mattyv06/thesis/paper/appendixb.tex

\chapter{Example Schematic}\label{appendixb}
%\begin{sidewaysfigure}[ht!]
%  \centering
%  \includegraphics[width=\textheight]{figs/schematic.png}
%  \caption{Large schematic on landscape page}
%  \label{fig:sche}
%\end{sidewaysfigure}
