mattyv06/thesis/figs/phoenix/concept/bat_sa_inh_pins.pdf

BATTERY
GND | A1 | GND | PWR | B1 | BAT_UNSF
GND | A2 | GND | PWR | B2 | BAT_UNSF
BAT_INHIBIT | A3 | INHIBIT | TMON | B3 | BAT_TMON
GND | A4 | GND | UNREG | B4 | SYS_UNREG
BAT_SDA | A5 | SDA | SCL | B5 | BAT_SDA

INHIBITS
PWR_UNSF | A1 | PWR | PWR | B1 | PWR_SAFE
PWR_UNSF | A2 | PWR | PWR | B2 | PWR_SAFE
FSWA_C | A3 | MON | MON | B3 | FSWB_C
BATT_SAFE | A4 | PWR | PWR | B4 | BATT_UNSF
BATT_SAFE | A5 | PWR | PWR | B5 | BATT_UNSF

SOLAR ARRAYS[1..3]
GND | A1 | GND | PWRA | B1 | SA_INA
GND | A2 | GND | PWRA | B2 | SA_INA
GND | A3 | GND | CSSA | B3 | CSSA_IN
GND | A4 | GND | DEP | B4 | DEP_UNREG
GND | A5 | GND | CSSB | B5 | CSSB_IN
GND | A6 | GND | PWRB | B6 | SA_INB
GND | A7 | GND | PWRB | B7 | SA_INB
