mattyv06/thesis/paper/main.pdf

AN EVOLUTION OF CUBESAT SUBSYSTEM DESIGN METHODS FOR...

by

Matthew Philip Voll

A thesis submitted in partial fulfillment of the requirements for the degree

of

Master of Science

in

Electrical Engineering

MONTANA STATE UNIVERSITY
Bozeman, Montana

April, 2017

c COPYRIGHT

by

Matthew Philip Voll

2017

All Rights Reserved

ii

ACKNOWLEDGEMENTS

I would like acknowledge . . . . Acknowledgments must be double spaced

and is limited to one page.

iii

TABLE OF CONTENTS

Subsection With a Very Very Very Very

4. DESIGN METHOD EXAMPLE: ELECTRICAL POWER SUB-
5. DESIGN STUDY - ELECTRICAL GROUND SUPPORT EQUIP-

iv

TABLE OF CONTENTS - CONTINUED

APPENDIX A: Example Code | 17
APPENDIX B: Example Schematic | 19

v

LIST OF FIGURES

Figure | Page
3.1 | This block diagram represents the components of the FISCE load circuit and their functions | 5
3.2 | The assembled FISCE load circuit on the backside of the solar panel substrate | 6
4.1 | A simplified representation of the design method used in this chapter.....8
4.2 | Basic configuration of a direct energy transfer (DET) power subsystem, with primary current paths shown by arrows | 8
4.3 | Components of the Phoenix EPS and the connections that form the PDN of the spacecraft | 9
4.4 | New connector pinouts | 9
4.5 | New connector pinouts | 10
4.6 | New connector pinouts | 10
4.7 | New connector pinouts | 10

vi

ABSTRACT

The abstract must be single spaced and no more than 350 words, indent first line five spaces. The abstract must contain the following elements: (1) statement of the problem, (2) procedure or methods, (3) results, and (4) conclusions. Mathematical formulas, abbreviations, diagrams, and other illustrative materials should not be included. It should be written to be understood by a person who does not have expertise in the field.

1

INTRODUCTION

Welcome to the Montana State University electronic Thesis/Dissertation (ETD)

LATEX template. In this chapter various sections, subsections, and subsubsections are

created and filled with random text). In Ch. ?? methods to write equations and how

to include figures and tables are explored. Conclusions are drawn in Ch. 7.

Section

Lorem ipsum dolor sit amet, consectetuer adipiscing elit. Ut purus elit,

vestibulum ut, placerat ac, adipiscing vitae, felis. Curabitur dictum gravida mauris.

Nam arcu libero, nonummy eget, consectetuer id, vulputate a, magna. Donec vehicula

augue eu neque. Pellentesque habitant morbi tristique senectus et netus et malesuada

fames ac turpis egestas. Mauris ut leo. Cras viverra metus rhoncus sem. Nulla et

lectus vestibulum urna fringilla ultrices. Phasellus eu tellus sit amet tortor gravida

placerat. Integer sapien est, iaculis in, pretium quis, viverra ac, nunc. Praesent eget

sem vel leo ultrices bibendum. Aenean faucibus. Morbi dolor nulla, malesuada eu,

pulvinar at, mollis ac, nulla. Curabitur auctor semper nulla. Donec varius orci eget

risus. Duis nibh mi, congue eu, accumsan eleifend, sagittis quis, diam. Duis eget orci

sit amet orci dignissim rutrum.

Subsection

Nam dui ligula, fringilla a, euismod sodales, sollicitudin vel, wisi. Morbi auctor

lorem non justo. Nam lacus libero, pretium at, lobortis vitae, ultricies et, tellus.

Donec aliquet, tortor sed accumsan bibendum, erat ligula aliquet magna, vitae

ornare odio metus a mi. Morbi ac orci et nisl hendrerit mollis. Suspendisse ut

2

massa. Cras nec ante. Pellentesque a nulla. Cum sociis natoque penatibus et

magnis dis parturient montes, nascetur ridiculus mus. Aliquam tincidunt urna. Nulla

ullamcorper vestibulum turpis. Pellentesque cursus luctus mauris.

Subsubsection Nulla malesuada porttitor diam. Donec felis erat, congue non,

volutpat at, tincidunt tristique, libero. Vivamus viverra fermentum felis. Donec

nonummy pellentesque ante. Phasellus adipiscing semper elit. Proin fermentum

massa ac quam. Sed diam turpis, molestie vitae, placerat a, molestie nec, leo.

Maecenas lacinia. Nam ipsum ligula, eleifend at, accumsan nec, suscipit a, ipsum.

Morbi blandit ligula feugiat magna. Nunc eleifend consequat lorem. Sed lacinia nulla

vitae enim. Pellentesque tincidunt purus vel magna. Integer non enim. Praesent

euismod nunc eu purus. Donec bibendum quam in tellus. Nullam cursus pulvinar

lectus. Donec et mi. Nam vulputate metus eu enim. Vestibulum pellentesque felis eu

massa.

Subsection With a Very Very Very Very
Very Very Very Very Very Very Long Title

For long subsection titles use the command \longsubsection{#1}{#2}, where

#1 is the first line of the long title, and #2 is the second line of the long title. You

can also pass an optional argument to this command that puts a shorter title in the

table of contents as shown by the subsection below.

Another Subsection With a Very Very Very
Very Very Very Very Very Very Long Title

The are not similar commands for sections and subsubsections as these are not

specified in the MSU style guide.

3

BACKGROUND

CubeSats are a growing industry and are becoming increasingly more capable

and affordable space mission options. Off-the-shelf components can be used to develop

complex missions....

4

DESIGN STUDY - SOLAR CELL EXPERIMENT

This subsystem design was part of the FIREBIRD-II mission, and was an

electronic load used to measure the performance of a spacecraft’s solar cells on orbit.

By working with an industry partner, the SSEL was able to utilize cutting edge solar

cell technology in exchange for providing the customer with low-cost flight heritage

and useful environmental data. This chapter will focus on the design method used

to fulfill the requirements as defined by the collaboration between the SSEL team

and the customer. After discussing the subsystem requirements, the concept design

can take shape, followed by the analyses and calculations performed to verify circuit

functionality.

At this time, the SSEL relied on the Mentor Graphics PADS Suite for electrical

computer aided design (ECAD), and integrated SPICE simulation was not a feature

that was readily available. Therefore, simulations of the critical circuits and

subcircuits was performed using LTSpice developed by Linear Technology. Then,

a full schematic was captured in PADS for creating the PCB layout files and bill-of-

materials needed for fabrication and assembly of the subsystem.

Requirements and Conceptual Design

Circuit Simulations and Calculations

PCB Layout and Mechanical Design

Calibration and Results

5

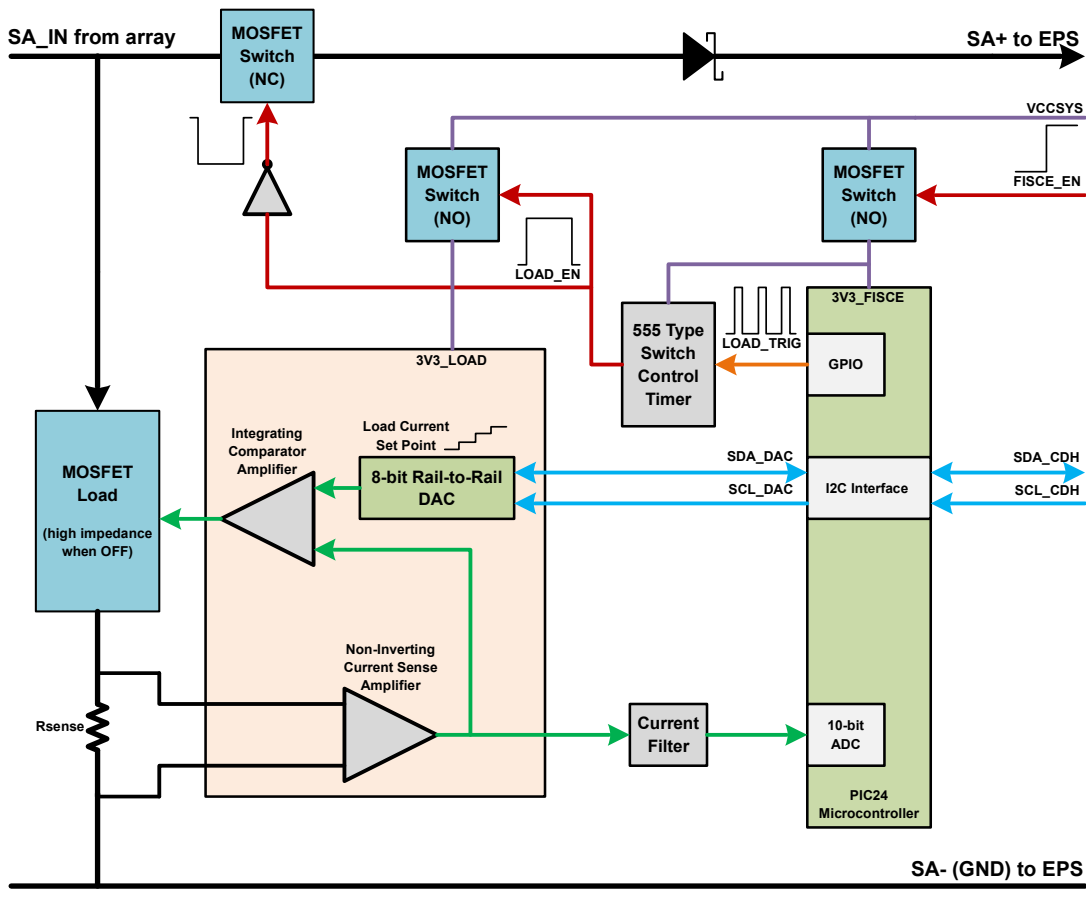
[picture p2: figure]
MOSFET Load; (high impedance when OFF); SA- (GND) to EPS; SA+ to EPS; FISCE_EN; VCCSYS; 10-bit ADC; I2C Interface; GPIO; Rsense; Current; Filter; 555 Type Switch Control Timer; MOSFET Switch (NO); SA_IN from array; MOSFET Switch (NC); 8-bit Rail-to-Rail DAC; LOAD_EN; LOAD_TRIG; 3V3_FISCE; 3V3_LOAD; Non-Inverting Current Sense Amplifier; Integrating Comparator Amplifier; SCL_CDH; SDA_CDH; SCL_DAC; SDA_DAC; PIC24 Microcontroller; Load Current Set Point

Figure 3.1: This block diagram represents the components of the FISCE load circuit and their functions.

6


Figure 3.2: The assembled FISCE load circuit on the backside of the solar panel substrate.

7

DESIGN METHOD EXAMPLE: ELECTRICAL POWER SUBSYSTEM

This subsystem was designed to facilitate expanded capabilities of the IT-SPINS

mission. Building on successes of the electrical power subsystem (EPS) used for the

FIREBIRD-II mission, the design of an updated version of the Phoenix EPS began

in the Spring of 2016. The original design came out of necessity, and began a trend of

using SSEL developed subsystems for CubeSat missions rather than purchasing and

integrating off-the-shelf solutions.

This chapter provides an investigation of how IT-SPINS mission requirements

made a significant overhaul of the Phoenix EPS mandatory. Then, a conceptual

design that incorporates those requirements is presented. With a block diagram

in place, several circuit simulations and calculations were performed to verify that

components of the design would operate as intended once built. The method used

in this example effectively used a hierarchical schematic structure to reuse several

“blocks” and make the schematic less cluttered. However, simulations were not well

integrated into the design flow and were difficult to track as the design matured; if a

simulation was modified or updated the corresponding schematic changes had to be

done manually. Similarly, support documents such as connector pin reference tables

were in a constant state of flux as the design progressed.

Figure 4.1 is an overview of the processes involved in designing the Phoenix EPS.

Ideally, these steps would be linked in only a linear progression, i.e. each step would

need to be completed and approved before moving onto the next. The arrows show

that during the simulation and schematic entry phases there was a need to revise the

subsystems requirements and conceptual design material. Also, there was essentially

only one formal approval step, made when the PCB was fully laid out and ready for

fabrication.

8

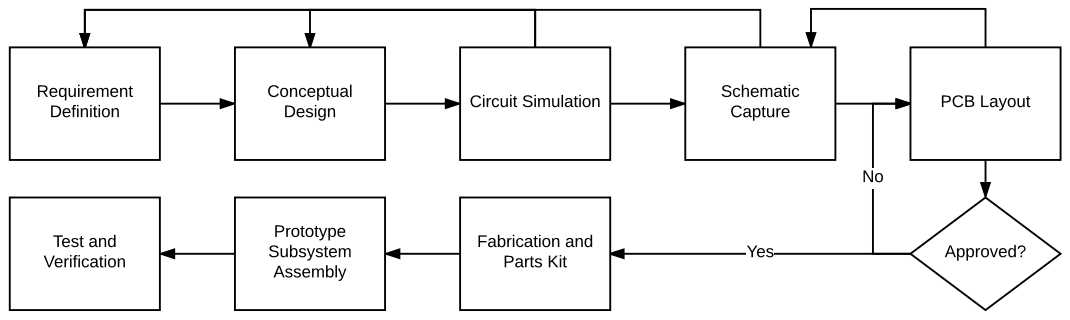
[picture p3: figure]
Requirement Definition; Schematic Capture Circuit Simulation Conceptual; Design; PCB Layout; Prototype Subsystem; Assembly; Test and; Verification; Yes; Approved?; Fabrication and Parts Kit

Figure 4.1: A simplified representation of the design method used in this chapter.

Requirements and Conceptual Design

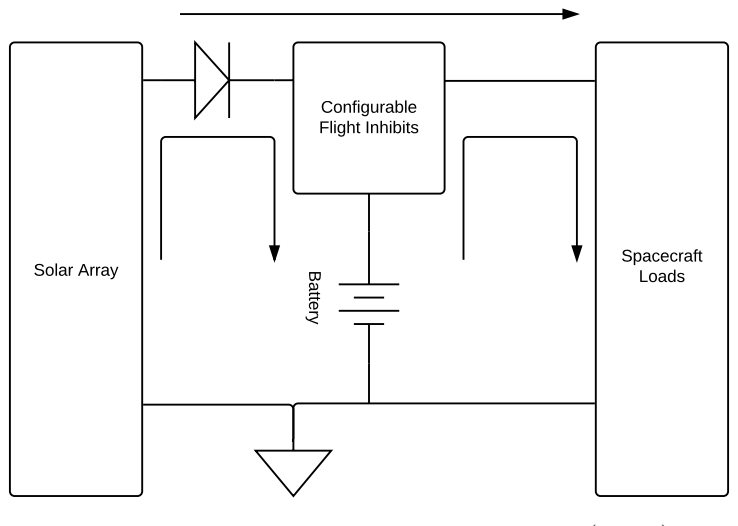
[picture p4: figure]
Solar Array; Battery Configurable Flight Inhibits; Spacecraft Loads

Figure 4.2: Basic configuration of a direct energy transfer (DET) power subsystem, with primary current paths shown by arrows.

Each resistor shown indicates a critical current sense location that is used to

monitor the subsystem’s status and performance. The inhibit switches shown indicate

the locations at which the power path is broken for “safing” the satellite during test

and launch; the physcial switches are not located on the

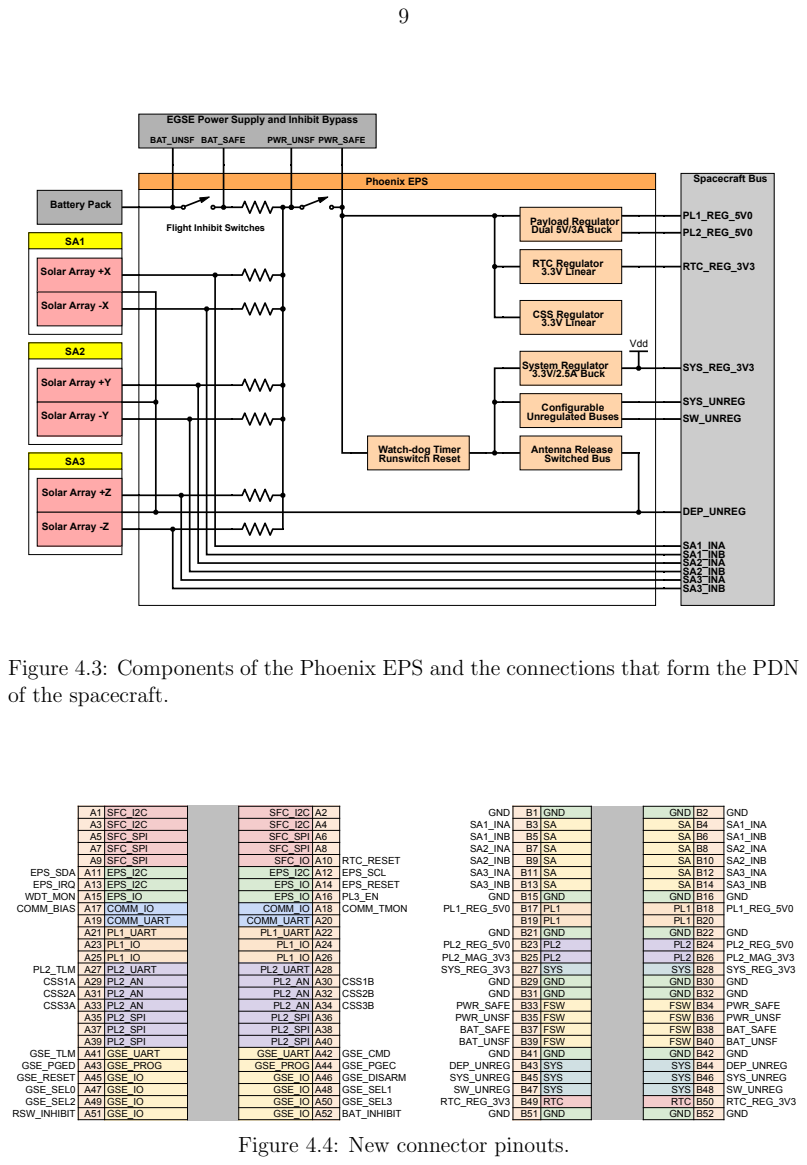
[picture p5: page 16]
Battery Pack; Dual 5V/3A Buck; Payload Regulator; RTC Regulator 3.3V Linear; CSS Regulator 3.3V Linear; 3.3V/2.5A Buck; System Regulator; Phoenix EPS; Unregulated Buses; Configurable; Antenna Release Switched Bus; Vdd; SYS_REG_3V3; SYS_UNREG; SW_UNREG; PL2_REG_5V0; PL1_REG_5V0; Spacecraft Bus; RTC_REG_3V3; SA1_INA SA1_INB SA2_INA SA2_INB SA3_INA SA3_INB; DEP_UNREG; BAT_UNSF BAT_SAFE; PWR_UNSF PWR_SAFE; Solar Array +X; Solar Array -X; Solar Array +Y; Solar Array -Y; Solar Array +Z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

EGSE Power Supply and Inhibit Bypass

Flight Inhibit Switches

Watchdog Timer
Runswitch Reset

Figure 4.3: Components of the Phoenix EPS and the connections that form the PDN
of the spacecraft.

Figure 4.4: New connector pinouts.

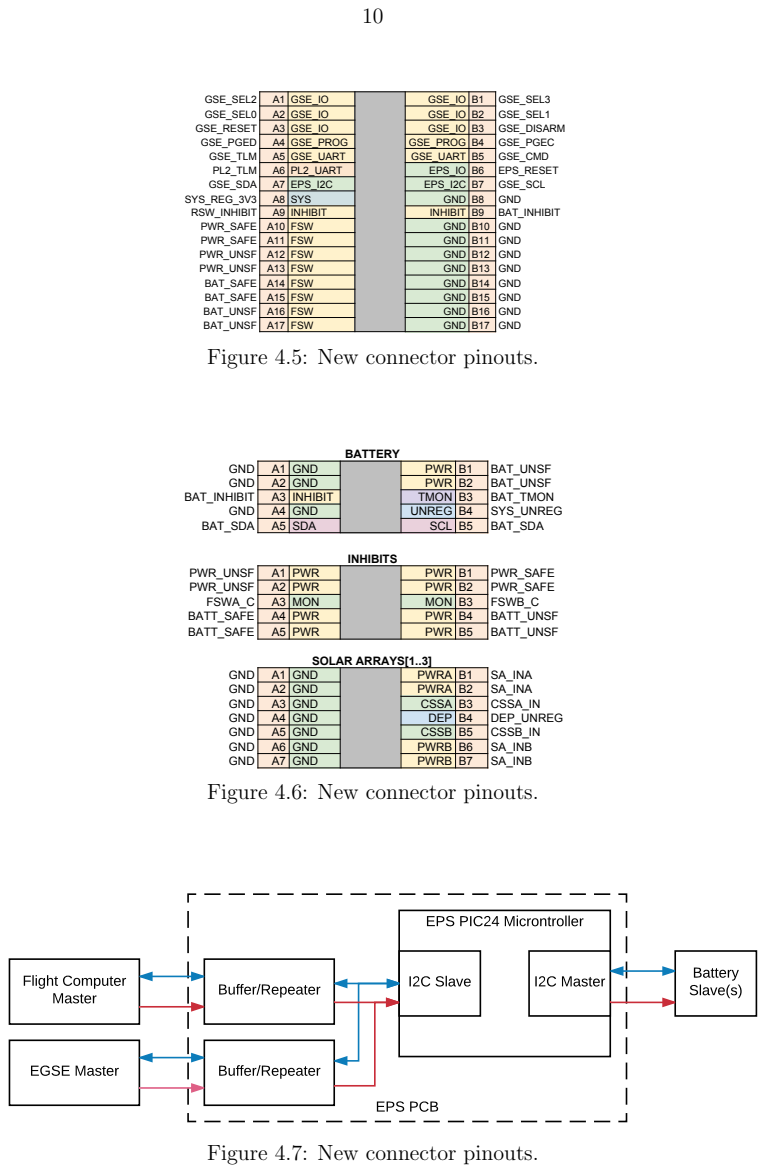
[picture p6: page 17]
GSE_SEL2; GSE_IO; GSE_SEL3; GSE_SEL0; GSE_SEL1; GSE_RESET; GSE_DISARM; GSE_PGED; GSE_PROG; GSE_PGEC; GSE_TLM; GSE_UART; GSE_CMD; PL2_TLM; PL2_UART; EPS_IO; EPS_RESET; GSE_SDA; EPS_I2C; GSE_SCL; SYS_REG_3V3; SYS; GND; RSW_INHIBIT; INHIBIT; BAT_INHIBIT; PWR_SAFE; FSW; PWR_UNSF; BAT_SAFE; BAT_UNSF; BATTERY; PWR; TMON; BAT_TMON; UNREG; SYS_UNREG; BAT_SDA; SDA; SCL; INHIBITS; FSWA_C; MON; FSWB_C; BATT_SAFE; BATT_UNSF; SOLAR ARRAYS[1..3]; PWRA; SA_INA; CSSA; CSSA_IN; DEP; DEP_UNREG; CSSB; CSSB_IN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

Figure 4.5: New connector pinouts.

Figure 4.6: New connector pinouts.

Flight Computer Master

Figure 4.7: New connector pinouts.

11

Circuit Simulations and Calculations

PCB Layout and Mechanical Design

Lessons Learned and Future Work

In this case, there were several times when the requirements, conceptual design,

schematic, and PCB layout were all being updated and altered in parallel. As the

IT-SPINS mission and the operation of its subsystems became more fully defined,

the critically important EPS design had to be altered to maintain compatibility. In

hindsight, these changes made the design method seem somewhat chaotic when

12

DESIGN STUDY - ELECTRICAL GROUND SUPPORT EQUIPMENT

This is the VOID EGSE design example.

Requirements and Conceptual Design

Circuit Simulations and Calculations

PCB Layout and Mechanical Design

Lessons Learned and Future Work

13

FUTURE METHODS

Investigating the possible methods for future use.

14

CONCLUSION

LATEX produces documents that look great, automatically handles references and

citations, and easily incorporates figures and tables. This is not a guide to LATEX but

rather an introduction to the MSU style. If you want more information about LATEX

many introductory guides can be found online.

15

REFERENCES CITED

16

APPENDICES

17

APPENDIX A

EXAMPLE CODE

18

% MATLAB code t o say ‘ h e l l o world ’

disp ( ‘ H ell o world ’ )

19

APPENDIX B

EXAMPLE SCHEMATIC
