mattyv06/thesis/template/main.pdf

THIS IS THE TITLE OF YOUR THESIS OR DISSERTATION

WHICH MAY SPAN MULTIPLE LINES

by

Chris Jordan Doe

A dissertation submitted in partial fulfillment of the requirements for the degree

of

Doctor of Philosophy

in

Engineering

MONTANA STATE UNIVERSITY
Bozeman, Montana

August, 2015

c COPYRIGHT

by

Chris Jordan Doe

2015

All Rights Reserved

ii

DEDICATION

I dedicate this to all MSU students who use LATEX. Dedication is optional and may be no longer than one page, single spaced, and should precede the acknowledgments page.

iii

ACKNOWLEDGEMENTS

I would like acknowledge . . . . Acknowledgments must be double spaced

and is limited to one page. Suspendisse vitae elit. Aliquam arcu neque, ornare

in, ullamcorper quis, commodo eu, libero. Fusce sagittis erat at erat tristique

mollis. Maecenas sapien libero, molestie et, lobortis in, sodales eget, dui. Morbi

ultrices rutrum lorem. Nam elementum ullamcorper leo. Morbi dui. Aliquam

sagittis. Nunc placerat. Pellentesque tristique sodales est. Maecenas imperdiet

lacinia velit. Cras non urna. Morbi eros pede, suscipit ac, varius vel, egestas

non, eros. Praesent malesuada, diam id pretium elementum, eros sem dictum

tortor, vel consectetuer odio sem sed wisi.

Funding Acknowledgment

This work was kindly supported by . . . . Nam dui ligula, fringilla a,

euismod sodales, sollicitudin vel, wisi. Morbi auctor lorem non justo. Nam

lacus libero, pretium at, lobortis vitae, ultricies et, tellus. Donec aliquet, tortor

sed accumsan bibendum, erat ligula aliquet magna, vitae ornare odio metus a

mi. Morbi ac orci et nisl hendrerit mollis. Suspendisse ut massa. Cras nec ante.

Pellentesque a nulla. Cum sociis natoque penatibus et magnis dis parturient

montes, nascetur ridiculus mus. Aliquam tincidunt urna. Nulla ullamcorper

vestibulum turpis. Pellentesque cursus luctus mauris.

iv

TABLE OF CONTENTS

Subsection With a Very Very Very Very

v

TABLE OF CONTENTS - CONTINUED

APPENDICES | 18
APPENDIX A: Example Code | 19
APPENDIX B: Example Schematic | 21

vi

LIST OF TABLES

Table | Page
3.1 | Area of ice sheet | 13

vii

LIST OF FIGURES

Figure | Page
3.1 | This is a figure of some data | 11
3.2 | Montana Hall on Montana State University’s campus | 12
3.3 | Figure created using the tikz package | 12
B.1 | Large schematic on landscape page | 22

viii

ABSTRACT

The abstract must be single spaced and no more than 350 words, indent first line five spaces. The abstract must contain the following elements: (1) statement of the problem, (2) procedure or methods, (3) results, and (4) conclusions. Mathematical formulas, abbreviations, diagrams, and other illustrative materials should not be included. It should be written to be understood by a person who does not have expertise in the field.

1

INTRODUCTION

Welcome to the Montana State University electronic Thesis/Dissertation (ETD)

LATEX template. In this chapter various sections, subsections, and subsubsections are

created and filled with random text). In Ch. 3 methods to write equations and how

to include figures and tables are explored. Conclusions are drawn in Ch. 4.

Section

Lorem ipsum dolor sit amet, consectetuer adipiscing elit. Ut purus elit,

vestibulum ut, placerat ac, adipiscing vitae, felis. Curabitur dictum gravida mauris.

Nam arcu libero, nonummy eget, consectetuer id, vulputate a, magna. Donec vehicula

augue eu neque. Pellentesque habitant morbi tristique senectus et netus et malesuada

fames ac turpis egestas. Mauris ut leo. Cras viverra metus rhoncus sem. Nulla et

lectus vestibulum urna fringilla ultrices. Phasellus eu tellus sit amet tortor gravida

placerat. Integer sapien est, iaculis in, pretium quis, viverra ac, nunc. Praesent eget

sem vel leo ultrices bibendum. Aenean faucibus. Morbi dolor nulla, malesuada eu,

pulvinar at, mollis ac, nulla. Curabitur auctor semper nulla. Donec varius orci eget

risus. Duis nibh mi, congue eu, accumsan eleifend, sagittis quis, diam. Duis eget orci

sit amet orci dignissim rutrum.

Subsection

Nam dui ligula, fringilla a, euismod sodales, sollicitudin vel, wisi. Morbi auctor

lorem non justo. Nam lacus libero, pretium at, lobortis vitae, ultricies et, tellus.

Donec aliquet, tortor sed accumsan bibendum, erat ligula aliquet magna, vitae

ornare odio metus a mi. Morbi ac orci et nisl hendrerit mollis. Suspendisse ut

2

massa. Cras nec ante. Pellentesque a nulla. Cum sociis natoque penatibus et

magnis dis parturient montes, nascetur ridiculus mus. Aliquam tincidunt urna. Nulla

ullamcorper vestibulum turpis. Pellentesque cursus luctus mauris.

Subsubsection Nulla malesuada porttitor diam. Donec felis erat, congue non,

volutpat at, tincidunt tristique, libero. Vivamus viverra fermentum felis. Donec

nonummy pellentesque ante. Phasellus adipiscing semper elit. Proin fermentum

massa ac quam. Sed diam turpis, molestie vitae, placerat a, molestie nec, leo.

Maecenas lacinia. Nam ipsum ligula, eleifend at, accumsan nec, suscipit a, ipsum.

Morbi blandit ligula feugiat magna. Nunc eleifend consequat lorem. Sed lacinia nulla

vitae enim. Pellentesque tincidunt purus vel magna. Integer non enim. Praesent

euismod nunc eu purus. Donec bibendum quam in tellus. Nullam cursus pulvinar

lectus. Donec et mi. Nam vulputate metus eu enim. Vestibulum pellentesque felis eu

massa.

Subsection With a Very Very Very Very
Very Very Very Very Very Very Long Title

For long subsection titles use the command \longsubsection{#1}{#2}, where

#1 is the first line of the long title, and #2 is the second line of the long title. You

can also pass an optional argument to this command that puts a shorter title in the

table of contents as shown by the subsection below.

Another Subsection With a Very Very Very
Very Very Very Very Very Very Long Title

The are not similar commands for sections and subsubsections as these are not

specified in the MSU style guide.

3

INTRODUCTION

Section

Lorem ipsum dolor sit amet, consectetuer adipiscing elit. Ut purus elit,

vestibulum ut, placerat ac, adipiscing vitae, felis. Curabitur dictum gravida mauris.

Nam arcu libero, nonummy eget, consectetuer id, vulputate a, magna. Donec vehicula

augue eu neque. Pellentesque habitant morbi tristique senectus et netus et malesuada

fames ac turpis egestas. Mauris ut leo. Cras viverra metus rhoncus sem. Nulla et

lectus vestibulum urna fringilla ultrices. Phasellus eu tellus sit amet tortor gravida

placerat. Integer sapien est, iaculis in, pretium quis, viverra ac, nunc. Praesent eget

sem vel leo ultrices bibendum. Aenean faucibus. Morbi dolor nulla, malesuada eu,

pulvinar at, mollis ac, nulla. Curabitur auctor semper nulla. Donec varius orci eget

risus. Duis nibh mi, congue eu, accumsan eleifend, sagittis quis, diam. Duis eget orci

sit amet orci dignissim rutrum.

Subsection

Nam dui ligula, fringilla a, euismod sodales, sollicitudin vel, wisi. Morbi auctor

lorem non justo. Nam lacus libero, pretium at, lobortis vitae, ultricies et, tellus.

Donec aliquet, tortor sed accumsan bibendum, erat ligula aliquet magna, vitae

ornare odio metus a mi. Morbi ac orci et nisl hendrerit mollis. Suspendisse ut

massa. Cras nec ante. Pellentesque a nulla. Cum sociis natoque penatibus et

magnis dis parturient montes, nascetur ridiculus mus. Aliquam tincidunt urna. Nulla

ullamcorper vestibulum turpis. Pellentesque cursus luctus mauris.

Subsubsection Nulla malesuada porttitor diam. Donec felis erat, congue non,

volutpat at, tincidunt tristique, libero. Vivamus viverra fermentum felis. Donec

4

nonummy pellentesque ante. Phasellus adipiscing semper elit. Proin fermentum

massa ac quam. Sed diam turpis, molestie vitae, placerat a, molestie nec, leo.

Maecenas lacinia. Nam ipsum ligula, eleifend at, accumsan nec, suscipit a, ipsum.

Morbi blandit ligula feugiat magna. Nunc eleifend consequat lorem. Sed lacinia nulla

vitae enim. Pellentesque tincidunt purus vel magna. Integer non enim. Praesent

euismod nunc eu purus. Donec bibendum quam in tellus. Nullam cursus pulvinar

lectus. Donec et mi. Nam vulputate metus eu enim. Vestibulum pellentesque felis eu

massa.

Section

Lorem ipsum dolor sit amet, consectetuer adipiscing elit. Ut purus elit,

vestibulum ut, placerat ac, adipiscing vitae, felis. Curabitur dictum gravida mauris.

Nam arcu libero, nonummy eget, consectetuer id, vulputate a, magna. Donec vehicula

augue eu neque. Pellentesque habitant morbi tristique senectus et netus et malesuada

fames ac turpis egestas. Mauris ut leo. Cras viverra metus rhoncus sem. Nulla et

lectus vestibulum urna fringilla ultrices. Phasellus eu tellus sit amet tortor gravida

placerat. Integer sapien est, iaculis in, pretium quis, viverra ac, nunc. Praesent eget

sem vel leo ultrices bibendum. Aenean faucibus. Morbi dolor nulla, malesuada eu,

pulvinar at, mollis ac, nulla. Curabitur auctor semper nulla. Donec varius orci eget

risus. Duis nibh mi, congue eu, accumsan eleifend, sagittis quis, diam. Duis eget orci

sit amet orci dignissim rutrum.

Subsection

Nam dui ligula, fringilla a, euismod sodales, sollicitudin vel, wisi. Morbi auctor

lorem non justo. Nam lacus libero, pretium at, lobortis vitae, ultricies et, tellus.

Donec aliquet, tortor sed accumsan bibendum, erat ligula aliquet magna, vitae

5

ornare odio metus a mi. Morbi ac orci et nisl hendrerit mollis. Suspendisse ut

massa. Cras nec ante. Pellentesque a nulla. Cum sociis natoque penatibus et

magnis dis parturient montes, nascetur ridiculus mus. Aliquam tincidunt urna. Nulla

ullamcorper vestibulum turpis. Pellentesque cursus luctus mauris.

Subsubsection Nulla malesuada porttitor diam. Donec felis erat, congue non,

volutpat at, tincidunt tristique, libero. Vivamus viverra fermentum felis. Donec

nonummy pellentesque ante. Phasellus adipiscing semper elit. Proin fermentum

massa ac quam. Sed diam turpis, molestie vitae, placerat a, molestie nec, leo.

Maecenas lacinia. Nam ipsum ligula, eleifend at, accumsan nec, suscipit a, ipsum.

Morbi blandit ligula feugiat magna. Nunc eleifend consequat lorem. Sed lacinia nulla

vitae enim. Pellentesque tincidunt purus vel magna. Integer non enim. Praesent

euismod nunc eu purus. Donec bibendum quam in tellus. Nullam cursus pulvinar

lectus. Donec et mi. Nam vulputate metus eu enim. Vestibulum pellentesque felis eu

massa.

Section

Lorem ipsum dolor sit amet, consectetuer adipiscing elit. Ut purus elit,

vestibulum ut, placerat ac, adipiscing vitae, felis. Curabitur dictum gravida mauris.

Nam arcu libero, nonummy eget, consectetuer id, vulputate a, magna. Donec vehicula

augue eu neque. Pellentesque habitant morbi tristique senectus et netus et malesuada

fames ac turpis egestas. Mauris ut leo. Cras viverra metus rhoncus sem. Nulla et

lectus vestibulum urna fringilla ultrices. Phasellus eu tellus sit amet tortor gravida

placerat. Integer sapien est, iaculis in, pretium quis, viverra ac, nunc. Praesent eget

sem vel leo ultrices bibendum. Aenean faucibus. Morbi dolor nulla, malesuada eu,

pulvinar at, mollis ac, nulla. Curabitur auctor semper nulla. Donec varius orci eget

6

risus. Duis nibh mi, congue eu, accumsan eleifend, sagittis quis, diam. Duis eget orci

sit amet orci dignissim rutrum.

Subsection

Nam dui ligula, fringilla a, euismod sodales, sollicitudin vel, wisi. Morbi auctor

lorem non justo. Nam lacus libero, pretium at, lobortis vitae, ultricies et, tellus.

Donec aliquet, tortor sed accumsan bibendum, erat ligula aliquet magna, vitae

ornare odio metus a mi. Morbi ac orci et nisl hendrerit mollis. Suspendisse ut

massa. Cras nec ante. Pellentesque a nulla. Cum sociis natoque penatibus et

magnis dis parturient montes, nascetur ridiculus mus. Aliquam tincidunt urna. Nulla

ullamcorper vestibulum turpis. Pellentesque cursus luctus mauris.

Subsubsection Nulla malesuada porttitor diam. Donec felis erat, congue non,

volutpat at, tincidunt tristique, libero. Vivamus viverra fermentum felis. Donec

nonummy pellentesque ante. Phasellus adipiscing semper elit. Proin fermentum

massa ac quam. Sed diam turpis, molestie vitae, placerat a, molestie nec, leo.

Maecenas lacinia. Nam ipsum ligula, eleifend at, accumsan nec, suscipit a, ipsum.

Morbi blandit ligula feugiat magna. Nunc eleifend consequat lorem. Sed lacinia nulla

vitae enim. Pellentesque tincidunt purus vel magna. Integer non enim. Praesent

euismod nunc eu purus. Donec bibendum quam in tellus. Nullam cursus pulvinar

lectus. Donec et mi. Nam vulputate metus eu enim. Vestibulum pellentesque felis eu

massa.

Section

Lorem ipsum dolor sit amet, consectetuer adipiscing elit. Ut purus elit,

vestibulum ut, placerat ac, adipiscing vitae, felis. Curabitur dictum gravida mauris.

7

Nam arcu libero, nonummy eget, consectetuer id, vulputate a, magna. Donec vehicula

augue eu neque. Pellentesque habitant morbi tristique senectus et netus et malesuada

fames ac turpis egestas. Mauris ut leo. Cras viverra metus rhoncus sem. Nulla et

lectus vestibulum urna fringilla ultrices. Phasellus eu tellus sit amet tortor gravida

placerat. Integer sapien est, iaculis in, pretium quis, viverra ac, nunc. Praesent eget

sem vel leo ultrices bibendum. Aenean faucibus. Morbi dolor nulla, malesuada eu,

pulvinar at, mollis ac, nulla. Curabitur auctor semper nulla. Donec varius orci eget

risus. Duis nibh mi, congue eu, accumsan eleifend, sagittis quis, diam. Duis eget orci

sit amet orci dignissim rutrum.

Subsection

Nam dui ligula, fringilla a, euismod sodales, sollicitudin vel, wisi. Morbi auctor

lorem non justo. Nam lacus libero, pretium at, lobortis vitae, ultricies et, tellus.

Donec aliquet, tortor sed accumsan bibendum, erat ligula aliquet magna, vitae

ornare odio metus a mi. Morbi ac orci et nisl hendrerit mollis. Suspendisse ut

massa. Cras nec ante. Pellentesque a nulla. Cum sociis natoque penatibus et

magnis dis parturient montes, nascetur ridiculus mus. Aliquam tincidunt urna. Nulla

ullamcorper vestibulum turpis. Pellentesque cursus luctus mauris.

Subsubsection Nulla malesuada porttitor diam. Donec felis erat, congue non,

volutpat at, tincidunt tristique, libero. Vivamus viverra fermentum felis. Donec

nonummy pellentesque ante. Phasellus adipiscing semper elit. Proin fermentum

massa ac quam. Sed diam turpis, molestie vitae, placerat a, molestie nec, leo.

Maecenas lacinia. Nam ipsum ligula, eleifend at, accumsan nec, suscipit a, ipsum.

Morbi blandit ligula feugiat magna. Nunc eleifend consequat lorem. Sed lacinia nulla

vitae enim. Pellentesque tincidunt purus vel magna. Integer non enim. Praesent

euismod nunc eu purus. Donec bibendum quam in tellus. Nullam cursus pulvinar

8

lectus. Donec et mi. Nam vulputate metus eu enim. Vestibulum pellentesque felis eu

massa.

Section

Lorem ipsum dolor sit amet, consectetuer adipiscing elit. Ut purus elit,

vestibulum ut, placerat ac, adipiscing vitae, felis. Curabitur dictum gravida mauris.

Nam arcu libero, nonummy eget, consectetuer id, vulputate a, magna. Donec vehicula

augue eu neque. Pellentesque habitant morbi tristique senectus et netus et malesuada

fames ac turpis egestas. Mauris ut leo. Cras viverra metus rhoncus sem. Nulla et

lectus vestibulum urna fringilla ultrices. Phasellus eu tellus sit amet tortor gravida

placerat. Integer sapien est, iaculis in, pretium quis, viverra ac, nunc. Praesent eget

sem vel leo ultrices bibendum. Aenean faucibus. Morbi dolor nulla, malesuada eu,

pulvinar at, mollis ac, nulla. Curabitur auctor semper nulla. Donec varius orci eget

risus. Duis nibh mi, congue eu, accumsan eleifend, sagittis quis, diam. Duis eget orci

sit amet orci dignissim rutrum.

Subsection

Nam dui ligula, fringilla a, euismod sodales, sollicitudin vel, wisi. Morbi auctor

lorem non justo. Nam lacus libero, pretium at, lobortis vitae, ultricies et, tellus.

Donec aliquet, tortor sed accumsan bibendum, erat ligula aliquet magna, vitae

ornare odio metus a mi. Morbi ac orci et nisl hendrerit mollis. Suspendisse ut

massa. Cras nec ante. Pellentesque a nulla. Cum sociis natoque penatibus et

magnis dis parturient montes, nascetur ridiculus mus. Aliquam tincidunt urna. Nulla

ullamcorper vestibulum turpis. Pellentesque cursus luctus mauris.

9

Subsubsection Nulla malesuada porttitor diam. Donec felis erat, congue non,

volutpat at, tincidunt tristique, libero. Vivamus viverra fermentum felis. Donec

nonummy pellentesque ante. Phasellus adipiscing semper elit. Proin fermentum

massa ac quam. Sed diam turpis, molestie vitae, placerat a, molestie nec, leo.

Maecenas lacinia. Nam ipsum ligula, eleifend at, accumsan nec, suscipit a, ipsum.

Morbi blandit ligula feugiat magna. Nunc eleifend consequat lorem. Sed lacinia nulla

vitae enim. Pellentesque tincidunt purus vel magna. Integer non enim. Praesent

euismod nunc eu purus. Donec bibendum quam in tellus. Nullam cursus pulvinar

lectus. Donec et mi. Nam vulputate metus eu enim. Vestibulum pellentesque felis eu

massa.

10

THEORY

Equations

Here is an example of an equation

a

2 + b

2 = c

2
, | (3.1)

which states the square of the hypotenuse c of a triangle is equal to the sum of the

square of the other two sides (a and b).

A collection of similar equations can be written using the \align environment,

e.g.,

sin(θ) = 1 csc(θ)
(3.2)

cos(θ) = 1 sec(θ)
(3.3)

tan(θ) = 1 cot(θ)
(3.4)

Cases can be added using

x =

y, if t = 1;

z, otherwise.

(3.5)

Symbols

Symbols, like greek letters, can be used in equations, e.g., θ, γ, and ζ. When

variables are referenced in the text they should be written in mathmode and enclosed

in dollar signs. For example, a and a, which are written in math and text modes,

respectively.

11

Figures

Figures can easily be added to your latex document. Graphs and figures

should be designed to be printed in black and white and clearly display information.

Considering using vectorized graphics that will remain sharp even if viewed zoomed

(try zooming on Fig 3.1). The text in your figure should be legible and preferably

the same size as the text in the rest of your document.

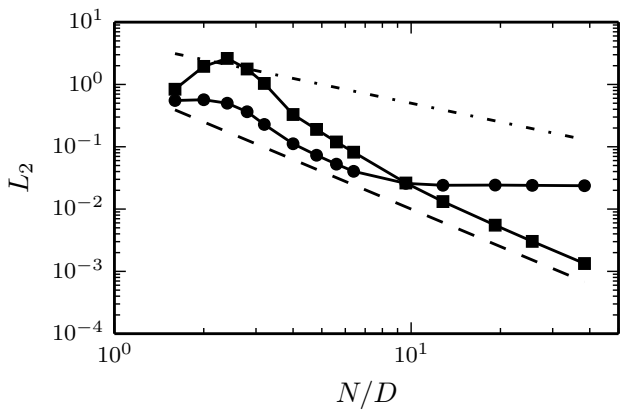
[picture p7: figure]

Figure 3.1: This is a figure of some data.

In LATEX figures may float and move around to a location that is optimized

using mathematics. The htbp in the definition of the figure environment means

here,top,bottom,page and is the order of preference for where the figure goes.

Figure 3.2 shows you can also put pictures into LATEX documents. The size of

the figure is controlled by adjusting width. If you find your figures are often floating

to a page of their own consider changing their size and/or adding more text.

Figure 3.3 shows that you can create figures directly within your LATEX document

using, for example, the tikz package.

12

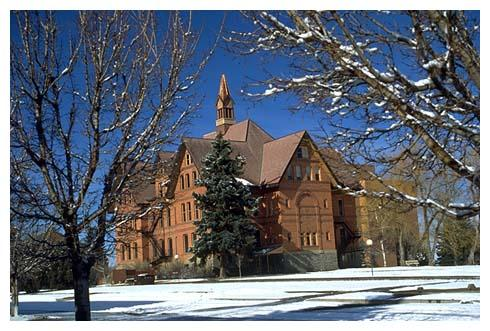
[picture p8: figure]

Figure 3.2: Montana Hall on Montana State University’s campus.

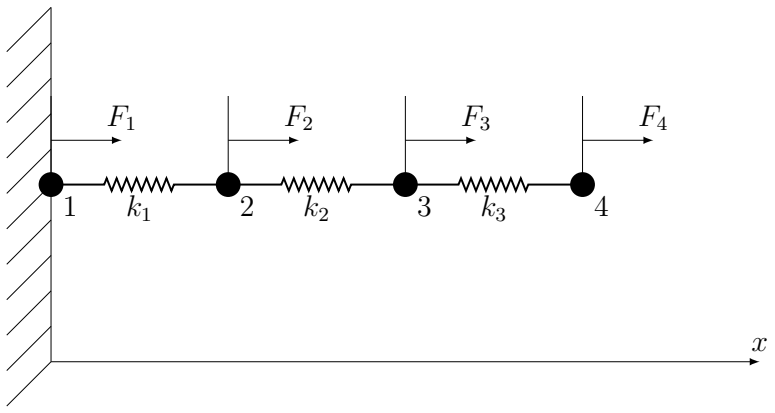
[picture p9: figure]

Figure 3.3: Figure created using the tikz package.

13

Tables

Tables can be created directly in your LATEX document. Table 3.1 shows how a

short caption can be used in the table of contents and a long caption in the figure. In

the table of contents “Area of ice sheet” is listed above the table “Area of ice sheet in

millions of square miles with time.” is listed. This is done by adding an optional argu-

ment to the \caption command, i.e., \caption[Short Caption]{Long Caption}.

Table 3.1: Area of ice sheet in millions of square miles with time.

Year | 1985 1990 1995 2000 2005 2010 2015
Area | 16.2 | 15.5 | 15.2 | 15.5 | 14.6 | 15.4 | 14.5

References and Citations

Referencing other parts of the document

Equations, figures, tables, sections, and chapters can be references using the

\ref{label} command. For example, \ref{fig:plot} references Fig. 3.1.

You can also use the \vref command to also get the page number. For example,

\vref{fig:plot} references Fig. 3.1 on page 11.

The label used in the \ref command can be anything you want to use. It is

helpful to use a convention. For example, all figures could have a label that starts

with fig: and all table labels could start with tab:.

Citing others work

Citing others work is an important aspect of all scientific writing. All citations

should be placed in the .bib file(s) listed in your main.tex document. Cite others

14

work using the \cite command, e.g., [4]. Multiple citations should be done within

one cite command, e.g., [1–3].

15

CONCLUSION

LATEX produces documents that look great, automatically handles references and

citations, and easily incorporates figures and tables. This is not a guide to LATEX but

rather an introduction to the MSU style. If you want more information about LATEX

many introductory guides can be found online.

16

REFERENCES CITED

17

[1] O. Desjardins, J. McCaslin, M. Owkes, and P. Brady. Direct numerical and large-eddy simulation of primary atomization in complex geometries. Atomization and Sprays, 23(11):1001–1048, 2013.
[2] M. Owkes and O. Desjardins. A discontinuous Galerkin conservative level set scheme for interface capturing in multiphase flows. Journal of Computational Physics, 249(15):275–302, Sept. 2013.
[3] M. Owkes and O. Desjardins. A computational framework for conservative, three-dimensional, unsplit, geometric transport with application to the volume-of-fluid (VOF) method. Journal of Computational Physics, 270(1):587–612, Aug. 2014.
[4] M. Owkes and O. Desjardins. A mesh-decoupled height function method for computing interface curvature. Journal of Computational Physics, 281:285–300, Jan. 2015.

18

APPENDICES

19

APPENDIX A

EXAMPLE CODE

20

% MATLAB code t o say ‘ h e l l o world ’

disp ( ‘ H ell o world ’ )

21

APPENDIX B

EXAMPLE SCHEMATIC

22

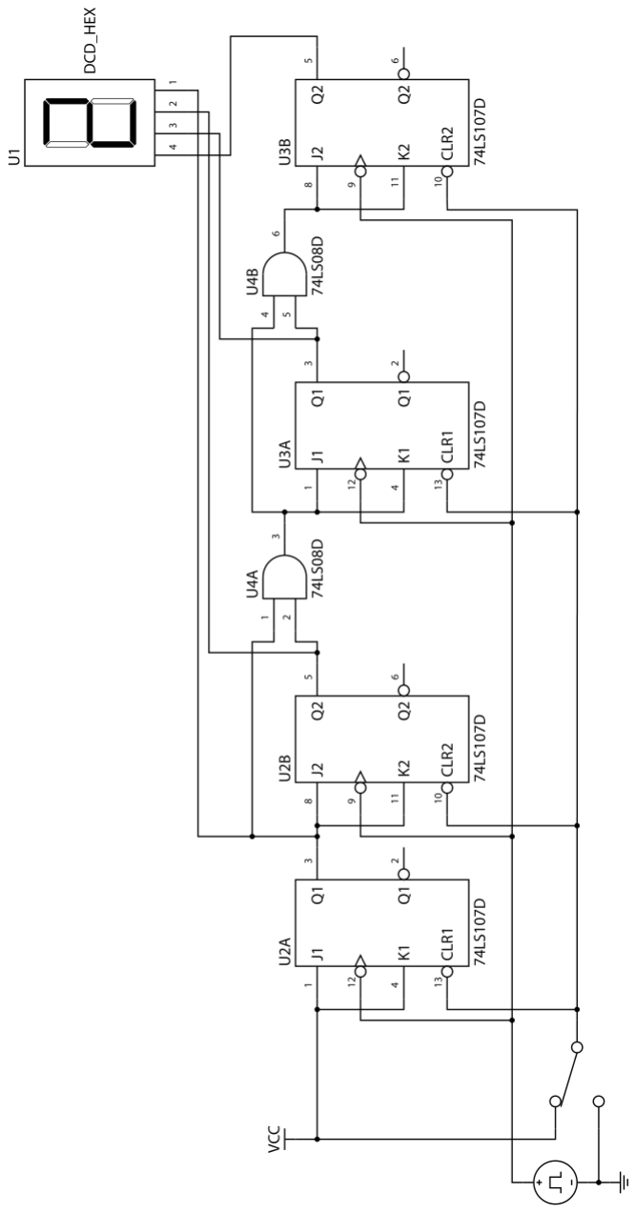
[picture p10: figure]

Figure B.1: Large schematic on landscape page
