mattyv06/thesis/figs/fisce/manufacturing/fisce_parts_order_03252014.xlsx

Sheet: Order03-25-2014
Digikey# | QTY
AD590KF-ND | 4
399-1092-1-ND | 28
399-7376-1-ND | 8
399-5504-1-ND | 8
399-7879-1-ND | 4
399-7883-1-ND | 4
399-7883-1-ND | 8
SSA24-E3/61TGICT-ND | 4
LTC6240HVIS5#TRMPBFCT-ND | 4
LTC6242IGN#PBF-ND | 2
568-10984-1-ND | 4
FMB2222ACT-ND | 8
FMB2227ACT-ND | 4
FDS6875CT-ND | 4
SI4425DDY-T1-GE3CT-ND | 4
541-0.0GCT-ND | 10
541-10.0KHCT-ND | 40
541-249KHCT-ND | 10
541-10.0KHCT-ND | 10
541-7.15KHCT-ND | 10
WSLC-.10CT-ND | 2
296-17199-1-ND | 2
LMC555CMM/NOPBCT-ND | 4

Sheet: Worksheet
Item | Ref | Description | Manufacturer | Part# | Digikey# | Price | QTY | x4 Boards | InStock? | Order
1 | U35 | Temperature Sensor | Analog Devices | AD590KF | AD590KF-ND | $20.27 | 1 | 4 |  | 4
2 | C203-204 C302 C305 C309-311 | CAP CER 10000PF 50V 5% X7R 0603 | Kemet | C0603C103J5RACTU | 399-1092-1-ND | $0.10 | 7 | 28 |  | 28
3 | C205 C307-308 C312-314 C401-405 C408 | CAP CER 0.1UF 50V 5% X7R 0603 | Kemet | C0603C104J5RACTU | 399-7844-1-ND | $0.40 | 12 | 48 | 100 | 0
4 | C206 C301 | CAP CER 1UF 25V 10% X7R 0603 | Kemet | C0603C105K3RACTU | 399-7376-1-ND | $0.36 | 2 | 8 |  | 8
5 | C406-407 | CAP CER 10UF 6.3V 20% X5R 0603 | Kemet | C0603C106M9PACTU | 399-5504-1-ND | $0.38 | 2 | 8 |  | 8
6 | C306 | CAP CER 2200PF 50V 5% X7R 0603 | Kemet | C0603C222J5RACTU | 399-7879-1-ND | $0.10 | 1 | 4 |  | 4
7 | C201 | CAP CER 0.022UF 50V 5% X7R 0603 | Kemet | C0603C223J5RACTU | 399-7883-1-ND | $0.28 | 1 | 4 |  | 4
8 | C202 C303 | CAP CER 0.022UF 50V 5% X7R 0603 | Kemet | C0603C223J5RACTU | 399-7883-1-ND | $0.28 | 2 | 8 |  | 8
9 | D21 | DIODE SCHOTTKY 40V 2A DO214AC | Vishay Semiconductor | SSA24-E3/61T | SSA24-E3/61TGICT-ND | $0.50 | 1 | 4 |  | 4
10 | H12 | CONN HEADER 3POS 1.25MM R/A SMD | Hirose | DF13A-3P-1.25H(50) | H3381-ND | $0.78 | 1 | 4 | 4 | 0
11 | H11 | CONN HEADER 7POS 1.25MM R/A SMD | Hirose | DF13A-7P-1.25H(50) | H3385-ND | $1.22 | 1 | 4 | 4 | 0
12 | H13 | CONN FPC/FFC 6POS 1MM R/A SMD | FCI | SFW6R-2STE1LF | 609-1890-1-ND | $0.91 | 1 | 4 | 4 | 0
13 | U32 | IC OPAMP GP 18MHZ RRO TSOT23-5 | Linear Technology | LTC6240HVIS5#TRMPBF | LTC6240HVIS5#TRMPBFCT-ND | $3.57 | 1 | 4 |  | 4
14 | U31 | IC OPAMP GP 18MHZ RRO 16SSOP | Linear Technology | LTC6242IGN#PBF | LTC6242IGN#PBF-ND | $5.03 | 1 | 4 | 4 | 2
15 | U40 | PIC24 Microcontroller | Microchip | PIC24FJ256GB210-I/PT | PIC24FJ256GB210-I/PT-ND | $8.48 | 1 | 4 | 4 | 0
16 | M31 | MOSFET N-CH 60V LFPAK | NXP Semiconductors | BUK9Y6R0-60E,115 | 568-10984-1-ND | $1.66 | 1 | 4 |  | 4
17 | Q21-22 | TRANS DUAL NPN 40V 500MA 6SSOT | Fairchild Semiconductor | FMB2222A | FMB2222ACT-ND | $0.49 | 2 | 8 |  | 8
18 | Q23 | TRANS NPN/PNP 30V 500MA 6SSOT | Fairchild Semiconductor | FMB2227A | FMB2227ACT-ND | $0.53 | 1 | 4 |  | 4
19 | M21 | MOSFET P-CH DUAL 20V 6A 8SOIC | Fairchild Semiconductor | FDS6875 | FDS6875CT-ND | $1.21 | 1 | 4 |  | 4
20 | M22 | MOSFET P-CH D-S 30V 8-SOIC | Vishay Siliconix | SI4425DDY-T1-GE3 | SI4425DDY-T1-GE3CT-ND | $0.95 | 1 | 4 |  | 4
21 | R307 | RES 100 OHM 1/10W 1% 0603 SMD | Vishay Dale | CRCW0603100RFKEA | 541-100HCT-ND | $0.81 | 1 | 4 | 30 | 0
22 | R304 | RES 470 OHM 1/10W 1% 0603 SMD | Vishay Dale | CRCW0603470RFKEA | 541-470HCT-ND | $0.81 | 1 | 4 | 20 | 0
23 | J31-33 R408 | RES 0.0 OHM 1/10W JUMP 0603 SMD | Vishay Dale | CRCW06030000Z0EA | 541-0.0GCT-ND | $0.81 | 4 | 16 | 10 | 10
24 | R1-2 R201 R204-205 R208-209 R218 R302 | RES 100K OHM 1/10W 1% 0603 SMD | Vishay Dale | CRCW0603100KFKEA | 541-100KHCT-ND | $0.81 | 9 | 36 | 40 | 0
25 | R202-203 R206-207 R211-212 R217 R219-220 R303 R305 R313-314 R318 R320 R403 | RES 10.0K OHM 1/10W 1% 0603 SMD | Vishay Dale | CRCW060310K0FKEA | 541-10.0KHCT-ND | $0.81 | 16 | 64 | 30 | 40
26 | R407 | RES 10.0 OHM 1/10W 1% 0603 SMD | Vishay Dale | CRCW060310R0FKEA | 541-10.0HCT-ND | $0.81 | 1 | 4 | 10 | 0
27 | R213 | RES 150K OHM 1/10W 1% 0603 SMD | Vishay Dale | CRCW0603150KFKEA | 541-150KHCT-ND | $0.81 | 1 | 4 | 10 | 0
28 | R308 R310 | RES 1.00K OHM 1/10W 1% 0603 SMD | Vishay Dale | CRCW06031K00FKEA | 541-1.00KHCT-ND | $0.81 | 2 | 8 | 30 | 0
29 | R306 | RES 1.00M OHM 1/10W 1% 0603 SMD | Vishay Dale | CRCW06031M00FKEA | 541-1.00MHCT-ND | $0.81 | 1 | 4 | 10 | 0
30 | R301 | RES 215K OHM 1/10W 1% 0603 SMD | Vishay Dale | CRCW0603215KFKEA | 541-215KHCT-ND | $0.81 | 1 | 4 | 10 | 0
31 | R210 R216 | RES 249K OHM 1/10W 1% 0603 SMD | Vishay Dale | CRCW0603249KFKEA | 541-249KHCT-ND | $0.81 | 2 | 8 |  | 10
32 | R214 | RES 10.0K OHM 1/10W 1% 0603 SMD | Vishay Dale | CRCW060310K0FKEA | 541-10.0KHCT-ND | $0.81 | 1 | 4 |  | 10
33 | R401-402 R405-406 | Resistor thick film | Vishay Dale | CRCW06034K70FKEA | 541-4.70KHCT-ND | $0.81 | 4 | 16 | 20 | 0
34 | R311 | RES 64.9K OHM 1/10W 1% 0603 SMD | Vishay Dale | CRCW060364K9FKEA | 541-64.9KHCT-ND | $0.81 | 1 | 4 | 10 | 0
35 | R319 | RES 7.15K OHM 1/10W 1% 0603 SMD | Vishay Dale | CRCW06037K15FKEA | 541-7.15KHCT-ND | $0.81 | 1 | 4 |  | 10
36 | R309 | RES .10 OHM 1/4W 1% 1206 SMD | Vishay Dale | WSL1206R1000FEA | WSLC-.10CT-ND | $1.35 | 1 | 4 | 4 | 2
37 | U33 | 8 BIT 12C SINGLE CHANNEL D/A CON | Texas Instruments | DAC5571IDBVT | 296-17199-1-ND | $3.01 | 1 | 4 | 4 | 2
38 | U22 | IC OSC MONO TIMING 3MHZ 8VSSOP | Texas Instruments | LMC555CMM/NOPB | LMC555CMM/NOPBCT-ND | $1.24 | 1 | 4 |  | 4
