mattyv06/thesis/figs/phoenix/manufacturing/phoenix_assembly_part_list.xlsx

PartType | RefDes | PartDecal | Pins | Layer | Orient. | X | Y | SMD | Load | Comments
CAP_C_0603_220N_25V | C1 | CAP_C_0603 | 2 | Top | 180 | 184 | 3241 | Yes | Yes
CAP_C_0603_100N_50V | C2 | CAP_C_0603 | 2 | Top | 0 | 321 | 390 | Yes | Yes
CAP_C_0603_100N_50V | C3 | CAP_C_0603 | 2 | Top | 0 | 681 | 390 | Yes | Yes
CAP_C_0805_10U_25V | C4 | CAP_C_0805 | 2 | Top | 270 | 759 | 1360 | Yes | Yes
CAP_C_0603_100N_50V | C5 | CAP_C_0603 | 2 | Top | 180 | 665 | 1540 | Yes | Yes
CAP_C_0603_100N_50V | C6 | CAP_C_0603 | 2 | Top | 180 | 665 | 2425 | Yes | Yes
CAP_C_0603_100N_50V | C7 | CAP_C_0603 | 2 | Top | 270 | 832 | 2594 | Yes | Yes
CAP_C_0603_100N_50V | C8 | CAP_C_0603 | 2 | Top | 270 | 832 | 2756 | Yes | Yes
CAP_C_0603_10U_6V3 | C9 | CAP_C_0603 | 2 | Top | 270 | 832 | 2864 | Yes | Yes
CAP_C_0603_2200P_50V | C12 | CAP_C_0603 | 2 | Top | 90 | 886 | 1479 | Yes | Yes
CAP_C_0603_22P_50V | C13 | CAP_C_0603 | 2 | Top | 270 | 940 | 1695 | Yes | Yes
CAP_C_0603_22P_50V | C14 | CAP_C_0603 | 2 | Top | 270 | 940 | 1803 | Yes | Yes
CAP_C_0603_2200P_50V | C15 | CAP_C_0603 | 2 | Top | 90 | 886 | 2019 | Yes | Yes
CAP_C_0603_220P_50V | C16 | CAP_C_0603 | 2 | Top | 180 | 967 | 1506 | Yes | Yes
CAP_C_0603_10N_50V | C17 | CAP_C_0603 | 2 | Top | 90 | 886 | 1587 | Yes | Yes
CAP_C_0603_10N_50V | C18 | CAP_C_0603 | 2 | Top | 270 | 886 | 1911 | Yes | Yes
CAP_C_0603_220P_50V | C19 | CAP_C_0603 | 2 | Top | 0 | 967 | 1992 | Yes | Yes
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
CAP_C_0603_10N_50V | C75 | CAP_C_0603 | 2 | Top | 0 | 2690 | 2478 | Yes | Yes
CAP_C_0603_10U_6V3 | C76 | CAP_C_0603 | 2 | Top | 180 | 2746 | 1963 | Yes | Yes
CAP_C_0603_10U_6V3 | C77 | CAP_C_0603 | 2 | Top | 90 | 2795 | 2615 | Yes | Yes
CAP_C_0603_100N_50V | C78 | CAP_C_0603 | 2 | Top | 270 | 2735 | 2896 | Yes | Yes
CAP_C_0603_10N_50V | C79 | CAP_C_0603 | 2 | Top | 180 | 2690 | 2424 | Yes | Yes
CAP_C_0603_100N_50V | C80 | CAP_C_0603 | 2 | Top | 270 | 3082 | 2626 | Yes | Yes
CAP_C_0603_100N_50V | C81 | CAP_C_0603 | 2 | Top | 90 | 3043 | 3106 | Yes | Yes
DIODE_DUAL_SCHOTTKY_BAT54 | D1 | SC70-3 | 3 | Top | 0 | 1431 | 1730 | Yes | Yes
DIODE_BAS521 | D2 | SOD523 | 2 | Top | 90 | 2673 | 1010 | Yes | Yes
DIODE_TVS_ESD5Z_12V | D3 | SOD523 | 2 | Top | 90 | 2664 | 1918 | Yes | Yes
DIODE_TVS_ESD5Z_12V | D4 | SOD523 | 2 | Top | 90 | 2775 | 1510 | Yes | Yes
DIODE_TVS_ESD5Z_12V | D5 | SOD523 | 2 | Top | 90 | 2775 | 1599 | Yes | Yes
DIODE_TVS_ESD5Z_12V | D6 | SOD523 | 2 | Top | 90 | 2775 | 1740 | Yes | Yes
DIODE_TVS_ESD5Z_12V | D7 | SOD523 | 2 | Top | 270 | 2775 | 1872 | Yes | Yes
DIODE_TVS_ESD5Z_3V3 | D8 | SOD523 | 2 | Top | 180 | 2777 | 2015 | Yes | Yes
DIODE_DUAL_TVS_ESD7C_3V3 | D9 | SOT723FL | 3 | Top | 180 | 2765 | 2070 | Yes | Yes
DIODE_DUAL_TVS_ESD7C_3V3 | D10 | SOT723FL | 3 | Top | 180 | 2765 | 2132 | Yes | Yes
DIODE_DUAL_TVS_ESD7C_3V3 | D11 | SOT723FL | 3 | Top | 180 | 2765 | 2250 | Yes | Yes
DIODE_DUAL_TVS_ESD7C_3V3 | D12 | SOT723FL | 3 | Top | 180 | 2765 | 2312 | Yes | Yes
DIODE_DUAL_TVS_ESD7C_3V3 | D13 | SOT723FL | 3 | Top | 90 | 2912 | 2468 | Yes | Yes
DIODE_DUAL_TVS_ESD7C_3V3 | D14 | SOT723FL | 3 | Top | 90 | 2974 | 2468 | Yes | Yes
DIODE_SCHOTTKY_BAT54 | D15 | SOD523 | 2 | Top | 270 | 1963 | 2365 | Yes | Yes
IND_EMIFIL_30 | FB1 | RES_0603 | 2 | Top | 0 | 1606 | 2573 | Yes | Yes
IND_EMIFIL_30 | FB2 | RES_0603 | 2 | Top | 0 | 1606 | 2627 | Yes | Yes
HEADER_ESQ_104SV | H1 | HEADER_ESQ_104SV | 104 | Top | 180 | 550 | 3275 | No | Yes | Through-hole. Not from Digi-Key, unique packaging
HEADER_PCIE_36SH | H2 | HEADER_PCIE_36_EM_BG | 36 | Top | 90 | 3115 | 1888 | Yes | Yes | Top/Bottom SMT. Not from Digi-Key, unique packaging
HEADER_M80_10PH | J1 | HEADER_M80_10PH | 12 | Top | 270 | 3350 | 830 | No | Yes | Through-hole, right-angle
HEADER_DF13_10PH | J1A | HEADER_DF13_10PH | 12 | Top | 90 | 660 | 2556 | Yes | Yes
HEADER_DF13_10PH | J1B | HEADER_DF13_10PH | 12 | Bottom | 270 | 660 | 2999 | Yes | Yes | Bottom mounted
HEADER_DF13_10PH | J2A | HEADER_DF13_10PH | 12 | Top | 90 | 660 | 1663 | Yes | Yes
HEADER_DF13_10PH | J2B | HEADER_DF13_10PH | 12 | Bottom | 270 | 660 | 2106 | Yes | Yes | Bottom mounted
HEADER_DF13_10PH | J3A | HEADER_DF13_10PH | 12 | Top | 90 | 660 | 770 | Yes | Yes
HEADER_DF13_10PH | J3B | HEADER_DF13_10PH | 12 | Bottom | 270 | 660 | 1213 | Yes | Yes | Bottom mounted
HEADER_M80_10PH | J5 | HEADER_M80_10PH | 12 | Top | 90 | 875 | 830 | No | Yes | Through-hole, right-angle
IND_HCC_2200N | L1 | IND_HCC | 2 | Top | 270 | 1982 | 1500 | Yes | Yes
IND_HCC_2200N | L2 | IND_HCC | 2 | Top | 90 | 1982 | 1915 | Yes | Yes
IND_HCC_3300N | L3 | IND_HCC | 2 | Top | 90 | 1982 | 2655 | Yes | Yes
MOSFET_NMOS_DUAL_BUK9K8R7 | M1 | LFPAK56D | 10 | Top | 0 | 2295 | 1490 | Yes | Yes
MOSFET_NMOS_DUAL_BUK9K8R7 | M2 | LFPAK56D | 10 | Top | 0 | 2295 | 2010 | Yes | Yes
SSEL_CUBESAT_MOUNT | MT1 | SSEL_CUBESAT_MOUNT | 4 | Top | 0 | 0 | 0 | No | No | Mounting holes, no part to install
MOSFET_PMOS_SI4427 | Q1 | SOIC8 | 8 | Top | 90 | 1632 | 1095 | Yes | Yes
BJT_NPN_MMBT2222A | Q2 | SOT723FL | 3 | Top | 90 | 2222 | 2942 | Yes | Yes
MOSFET_PMOS_SI4427 | Q3 | SOIC8 | 8 | Top | 0 | 2323 | 3082 | Yes | Yes
BJT_NPN_MMBT2222A | Q4 | SOT723FL | 3 | Top | 0 | 2707 | 2721 | Yes | Yes
RES_CRCW_0603_10K0 | R1 | RES_0603 | 2 | Top | 270 | 397 | 3188 | Yes | Yes
RES_CRCW_0603_10K0 | R2 | RES_0603 | 2 | Top | 90 | 397 | 3296 | Yes | Yes
RES_CRCW_0603_10K0 | R3 | RES_0603 | 2 | Top | 270 | 451 | 3188 | Yes | Yes
RES_CRCW_0603_10K0 | R4 | RES_0603 | 2 | Top | 90 | 451 | 3296 | Yes | Yes
RES_CRCW_0603_2R00 | R5 | RES_0603 | 2 | Top | 270 | 673 | 3136 | Yes | Yes
RES_CRCW_0603_100K | R6 | RES_0603 | 2 | Top | 270 | 886 | 1695 | Yes | Yes
RES_CRCW_0603_100K | R7 | RES_0603 | 2 | Top | 270 | 886 | 1803 | Yes | Yes
RES_CRCW_0603_100K | R8 | RES_0603 | 2 | Top | 90 | 2762 | 3145 | Yes | Yes
RES_CRCW_0603_100K | R9 | RES_0603 | 2 | Top | 90 | 2004 | 3045 | Yes | Yes
RES_CRCW_0603_1K00 | R10 | RES_0603 | 2 | Top | 0 | 805 | 2513 | Yes | Yes
RES_CRCW_0603_10K0 | R11 | RES_0603 | 2 | Top | 90 | 778 | 2594 | Yes | Yes
RES_CRCW_0603_10K0 | R12 | RES_0603 | 2 | Top | 90 | 778 | 2756 | Yes | Yes
RES_CRCW_0603_20K0 | R13 | RES_0603 | 2 | Top | 270 | 2816 | 3145 | Yes | Yes
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
RC_QUAD_47_10P | RC1 | RC_QUAD_0612 | 10 | Top | 180 | 2645 | 2101 | Yes | Yes
RC_QUAD_47_10P | RC2 | RC_QUAD_0612 | 10 | Top | 180 | 2645 | 2281 | Yes | Yes
RC_QUAD_47_10P | RC3 | RC_QUAD_0612 | 10 | Top | 90 | 2943 | 2586 | Yes | Yes
RES_WSLP_1206_50M | RS1 | RES_WSL_1206 | 2 | Top | 90 | 338 | 547 | Yes | Yes
RES_WSLP_1206_50M | RS2 | RES_WSL_1206 | 2 | Top | 90 | 339 | 1442 | Yes | Yes
RES_WSLP_1206_50M | RS3 | RES_WSL_1206 | 2 | Top | 90 | 338 | 2332 | Yes | Yes
RES_WSLP_1206_50M | RS4 | RES_WSL_1206 | 2 | Top | 270 | 426 | 547 | Yes | Yes
RES_WSLP_1206_50M | RS5 | RES_WSL_1206 | 2 | Top | 270 | 427 | 1442 | Yes | Yes
RES_WSLP_1206_50M | RS6 | RES_WSL_1206 | 2 | Top | 270 | 426 | 2332 | Yes | Yes
RES_WSLP_1206_50M | RS7 | RES_WSL_1206 | 2 | Top | 90 | 725 | 545 | Yes | Yes
RES_WSLP_1206_50M | RS8 | RES_WSL_1206 | 2 | Top | 0 | 2385 | 2760 | Yes | Yes
RES_WSLP_1206_50M | RS9 | RES_WSL_1206 | 2 | Top | 0 | 2556 | 3135 | Yes | Yes
SSEL_TESTPOINT | TP1 | SSEL_TESTPOINT | 1 | Top | 0 | 800 | 3700 | No | Yes | Not from Digi-Key, install standard .100" headers
SSEL_TESTPOINT | TP2 | SSEL_TESTPOINT | 1 | Top | 0 | 900 | 3700 | No | Yes | Not from Digi-Key, install standard .100" headers
SSEL_TESTPOINT | TP3 | SSEL_TESTPOINT | 1 | Top | 0 | 1000 | 3700 | No | Yes | Not from Digi-Key, install standard .100" headers
SSEL_TESTPOINT | TP4 | SSEL_TESTPOINT | 1 | Top | 0 | 1100 | 3700 | No | Yes | Not from Digi-Key, install standard .100" headers
SSEL_TESTPOINT | TP5 | SSEL_TESTPOINT | 1 | Top | 0 | 1200 | 3700 | No | Yes | Not from Digi-Key, install standard .100" headers
SSEL_TESTPOINT | TP6 | SSEL_TESTPOINT | 1 | Top | 0 | 1300 | 3700 | No | Yes | Not from Digi-Key, install standard .100" headers
SSEL_TESTPOINT | TP7 | SSEL_TESTPOINT | 1 | Top | 0 | 2300 | 3700 | No | Yes | Not from Digi-Key, install standard .100" headers
SSEL_TESTPOINT | TP8 | SSEL_TESTPOINT | 1 | Top | 0 | 2400 | 3700 | No | Yes | Not from Digi-Key, install standard .100" headers
ANALOG_MAX44285H | U1 | VSSOP8 | 8 | Top | 270 | 200 | 485 | Yes | Yes
I2C_BUFFER_TCA9517 | U2 | VSSOP8 | 8 | Top | 180 | 250 | 3335 | Yes | Yes
ANALOG_MAX44285H | U3 | VSSOP8 | 8 | Top | 270 | 560 | 485 | Yes | Yes
ANALOG_MAX44285H | U4 | VSSOP8 | 8 | Top | 0 | 600 | 1440 | Yes | Yes
ANALOG_MAX44285H | U5 | VSSOP8 | 8 | Top | 0 | 600 | 2330 | Yes | Yes
REG_BUCK_DUAL_LTC3850 | U6 | SSOP28 | 28 | Top | 0 | 1164 | 1735 | Yes | Yes
MCU_PIC24FJ256GB210 | U7 | TQFP100 | 100 | Top | 90 | 1155 | 2850 | Yes | Yes
ANALOG_MCP9700T | U8 | SC70-5 | 5 | Top | 180 | 1248 | 2154 | Yes | Yes
ANALOG_MAX44285H | U9 | VSSOP8 | 8 | Top | 0 | 1465 | 2080 | Yes | Yes
I2C_BUFFER_TCA9517 | U10 | VSSOP8 | 8 | Top | 0 | 1655 | 415 | Yes | Yes
ANALOG_MCP9700T | U11 | SC70-5 | 5 | Top | 90 | 2348 | 2633 | Yes | Yes
LOGIC_TIMER_TLC555QD | U12 | SOIC8 | 8 | Top | 90 | 1950 | 955 | Yes | Yes
REG_BUCK_LTC3646 | U13 | MSOP16E | 17 | Top | 180 | 2180 | 2365 | Yes | Yes
LOGIC_TIMER_CD4060BPWR | U14 | TSSOP16 | 16 | Top | 90 | 2235 | 945 | Yes | Yes
LOGIC_GATE_CD4572UBPWR | U15 | TSSOP16 | 16 | Top | 90 | 2489 | 945 | Yes | Yes
ANALOG_MAX44285H | U16 | VSSOP8 | 8 | Top | 0 | 2588 | 2896 | Yes | Yes
REG_LDO_LT3060_3V3 | U17 | SOT23-8 | 8 | Top | 270 | 2690 | 2585 | Yes | Yes
LOGIC_DEMUX_74HC154PW | U18 | TSSOP24 | 24 | Top | 180 | 3165 | 2840 | Yes | Yes
I2C_EEPROM_24AA025T | U19 | SOT23-6 | 6 | Top | 180 | 3150 | 3105 | Yes | No | Still selecting appropriate IC, do not install
