mattyv06/thesis/figs/fisce/manufacturing/gerber/readme.txt

Space Science & Engineering Lab - Matt Voll
Part No.: FB-E-4008-D rev 1.0

Board Size: 3.268" x 6.132"
Board Origin: Center of left mounting hole
Silkscreen: Yellow, top and bottom
Soldermask: Black, matte, top and bottom
Plated through-holes: Yes
Partial vias: Yes
Filled vias: Yes
Surface Mount: Yes
Finish: HASL

Layers: 6 (see fab drawing)
Controlled Impedance: No
Controlled Dielectric: No
Controlled Stackup: No 
Finished Material: 1oz Cu (all layers)

Board Files:

1)	Board Drawing			fbe4008d_board_drawing.pdf
2)	Drill Drawing			fdb4008d_drill_drawing.pdf
3)	Component Layer			l1.pho
4)	Ground 1			l2.pho
5)	Power 				l3.pho
6)	Signal				l4.pho
7)	Ground 2			l5.pho
8)	Component/Routing Layer		l6.pho
9)	Soldermask Top			smt.pho
10)	Soldermask Bottom		smb.pho
11)	Pastemask Bottom		pmb.pho
12)	Silkscreen Top			sst.pho
13)	Silkscreen Bottom		ssb.pho
14)	Board Outline			board.pho
15)	NC Drill Through		drl_through.drl
16)	Drill List Through		drl_through.lst
17)	NC Drill L2/L6			drl_l2l6.drl
18)	Drill List L2/L6		drl_l2l6.lst
19)	NC Drill L3/L6			drl_l3l6.drl
20)	Drill List L3/L6		drl_l3l6.lst
