mattyv06/thesis/figs/egse/manufacturing/egse_bottom.png

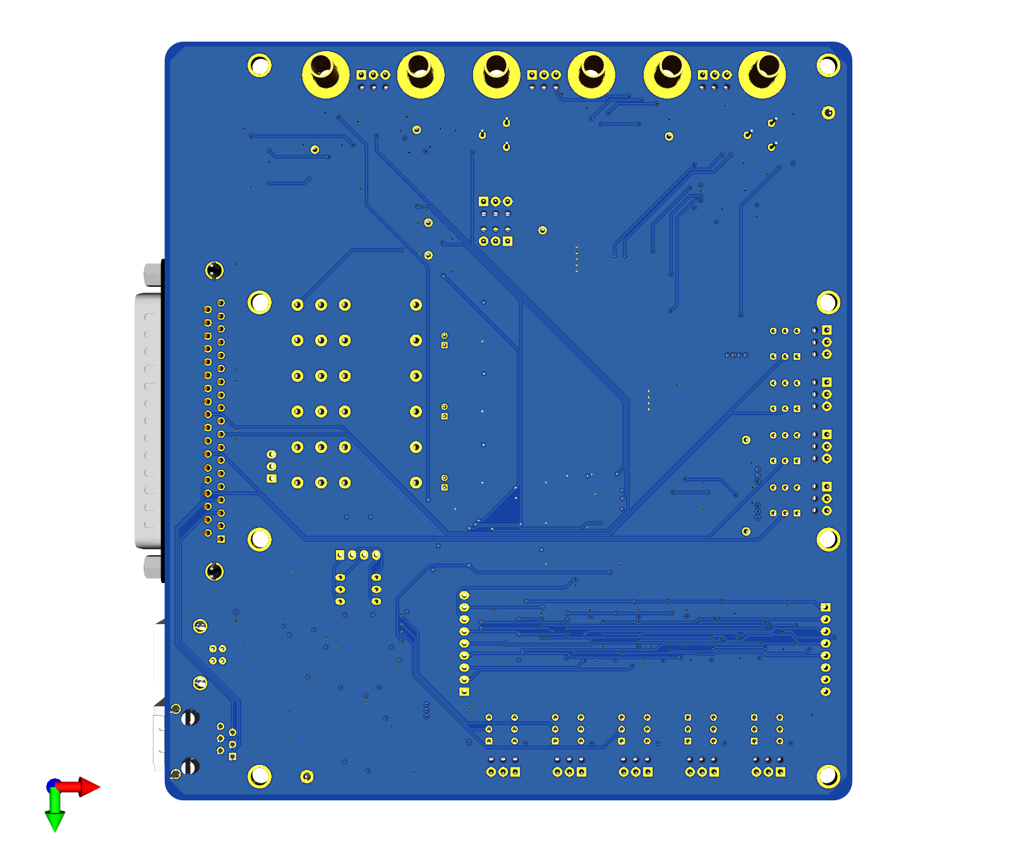
figs/egse/manufacturing/egse_bottom.png
