mattyv06/thesis/figs/egse/manufacturing/egse_top.png

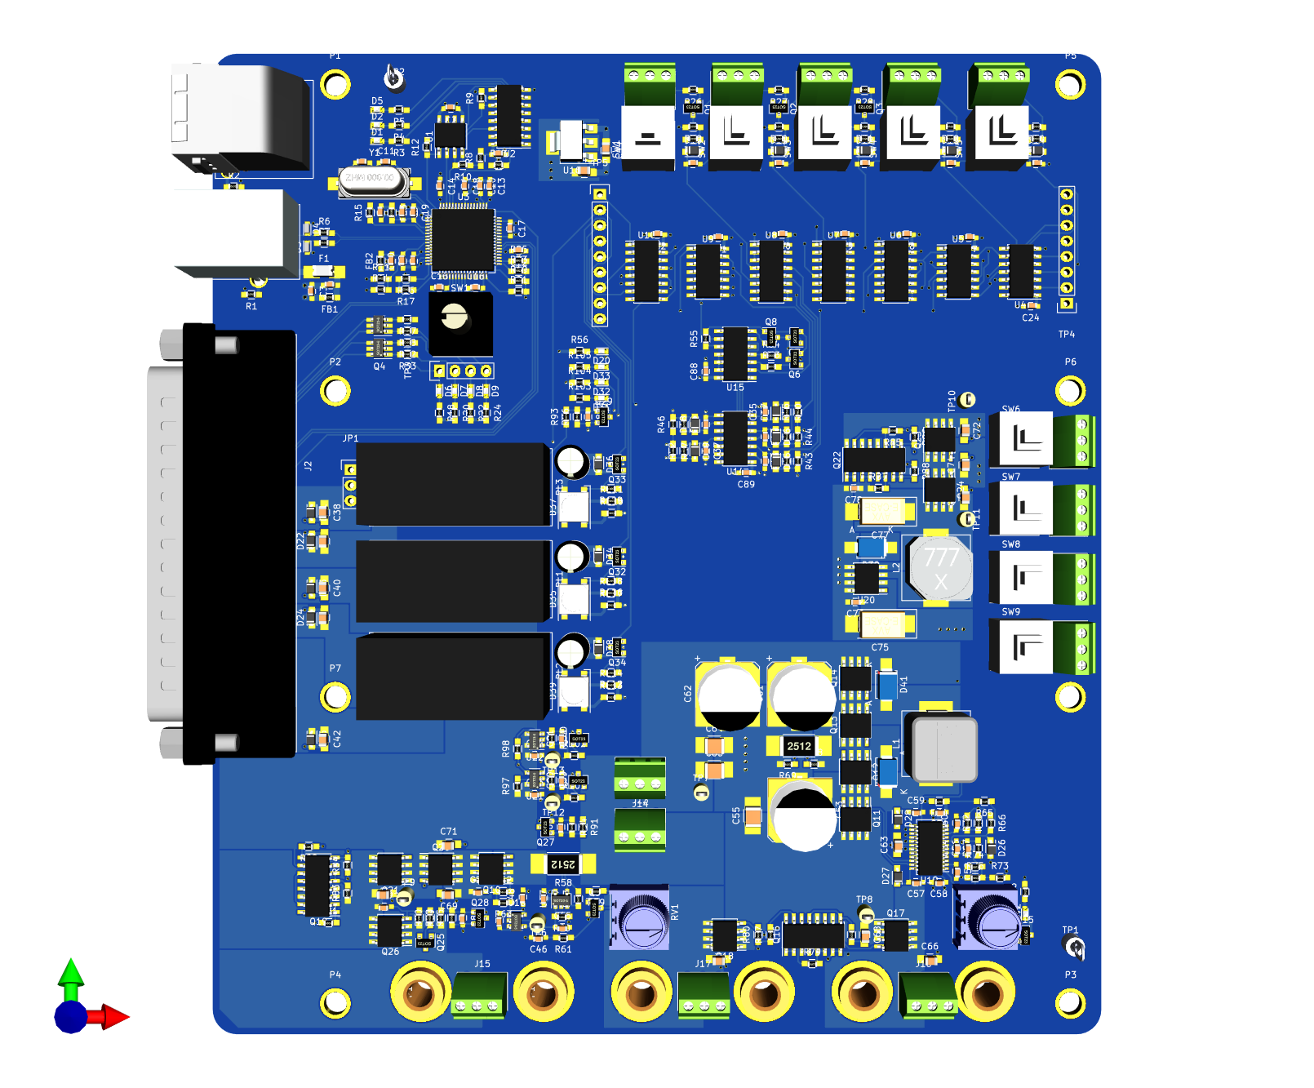
figs/egse/manufacturing/egse_top.png
