mattyv06/thesis/figs/fisce/manufacturing/fisce_bottom.png

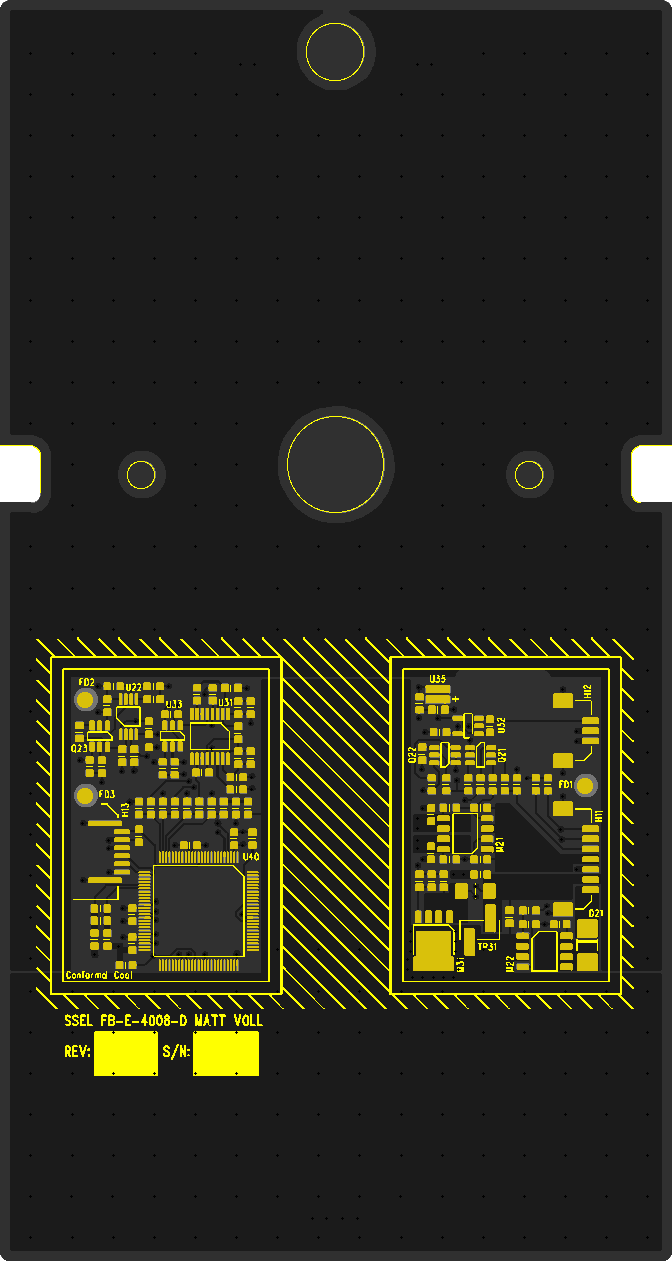
figs/fisce/manufacturing/fisce_bottom.png
