mattyv06/thesis/figs/fisce/manufacturing/fisce_top.png

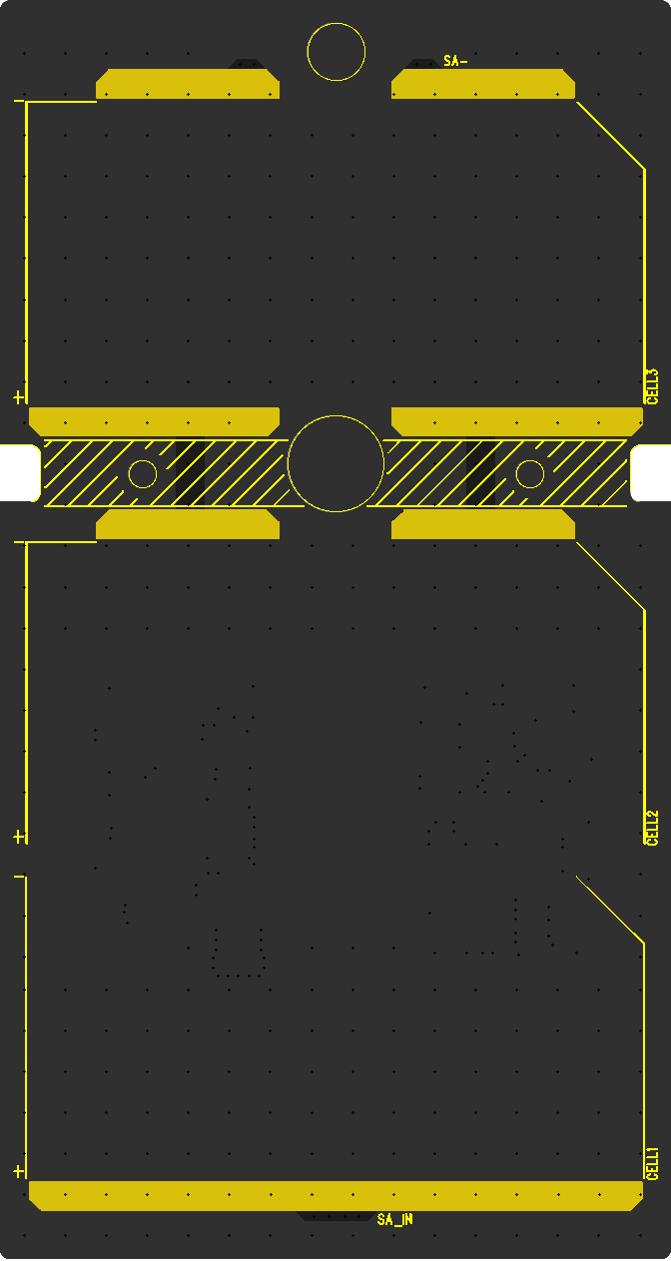
figs/fisce/manufacturing/fisce_top.png
