mattyv06/thesis/figs/phoenix/manufacturing/phoenix_bottom.png

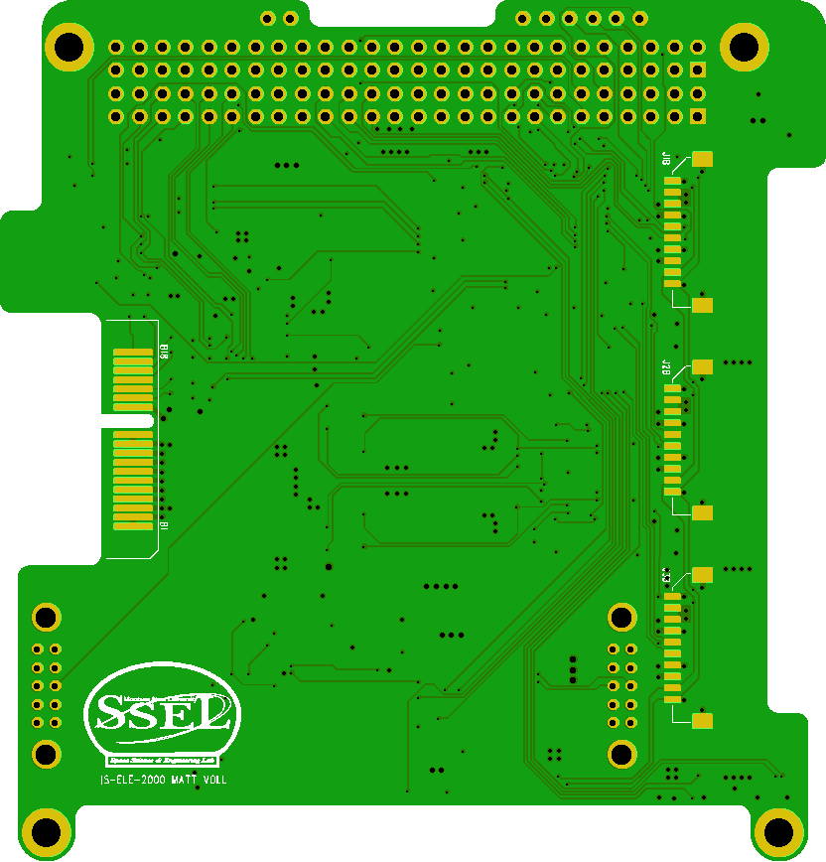
figs/phoenix/manufacturing/phoenix_bottom.png
