mattyv06/thesis/figs/phoenix/manufacturing/phoenix_top.png

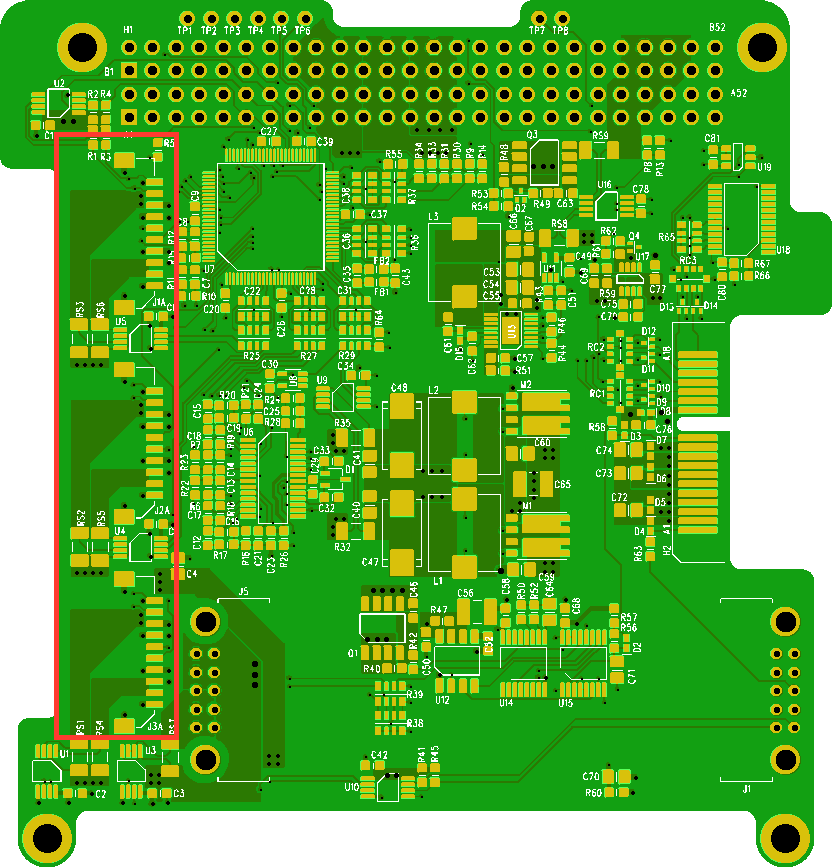
figs/phoenix/manufacturing/phoenix_top.png
