mattyv06/thesis/figs/fisce/manufacturing/fisce_edu_testing_ncr.pdf

Incident Date: | 04/22/2014

NCR Number

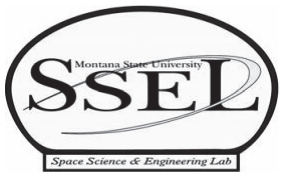
[picture p17: figure]

Subsystem | Part/Document Name | No. of NCR Sheets
EPS | FISCE Solar Panel Schematic and Layout
Brief Description
MPS Number | MPS OP Number | Hardware Type
! | ! | !!"#$%&'!!!!!!!!!!!!!!!!!!!! !!"#$%&'!,-.#$/$0.'$)*!!! !!()*+"#$%&'! !!123! !
Quantity | Procedure Number | Found During
| | FISCE Test Plan
Reference Documents

Analysis (Attach additional pages if necessary)

# Nonconformance Report

During initial EDU testing on the FISCE solar panel, odd behavior was observed on the Q23 transistor. This transistor is a dual NPN/PNP type FMB2227A BJT. The NPN gate of Q23 is used to pull the TRIG pin of the 555 timer LOW with a series of pulses from the MCU. It was observed that the TRIG remained in its default HIGH state even though the correct pulse signal from the MCU was driving the gate. Because of this, the load never turned on.

FB-E-4007-D, FB-E-4008-D (see FISCE_Documentation.zip on Knowledge Tree pending releases)

The NPN gate of Q23 is used to pull the TRIG pin of the 555 timer LOW with a series of pulses from the MCU. It was observed that the TRIG remained in its default HIGH state even though the correct pulse signal from the MCU was driving the gate. When working correctly, the 555 timer output should go HIGH and stay there until the series of pulses from the MCU stops, at which point the 555 timer expires and the output goes LOW. The 555 output signal controls the 3V3_LOAD and SA+ power switches.
First, the orientation of the 6-pin SOT package of Q23 was checked and found to be correct. Then, the pin sequence of the schematic was compared to the FMB2227A datasheet. It was found that pins 1 and 5, the base and emitter of the NPN gate (Q23-A) respectively, had been reversed. The same issue was also found on the other two dual transistors, both of which are dual NPN type FMB2222A BJT's.
After looking at the part type and schematic decals in the PADS design file, it was found that the naming
scheme for the part gates had caused PADS to automatically change the pin numbering sequence of the part when saved. This meant that even though the pin numbers were entered correctly at first, the final schematic netlist used for the FISCE layout had incorrect pin numbers (pins 1 and 5 switched) for all 3 of the board's dual BJT parts: Q21, Q22, and Q23.

Proposed Corrective Action

""""""""""""""""""""""""!

#$!!!!!!!!!!!!!!!!!!!!!!!!!!!!!!!!!!!%&'(&)*&+,!!!!!!!!!!!!!!!!!!!!!!!!!!!!!!!!%-.,!

""""""""""""""""""""""""!

/0!!!!!!!!!!!!!!!!!!!!!!!!!!!!!!!!!!!!!!!!!!!!!!!!!!!!!!!!!!!!!!!!!!!!!!!!!!!!!!!%-., Corrective Action Taken

""""""""""""""""""""""""!

12!!!!!!!!!!!!!!!!!!!!!!!!!!!!!!!!!!!!!!!!!!!!!!!!!!!!!!!!!!!!!!!!!!!!!!!!!!!%-.,!

""""""""""""""""""""""""!

/0!!!!!!!!!!!!!!!!!!!!!!!!!!!!!!!!!!!!!!!!!!!!!!!!!!!!!!!!!!!!!!!!!!!!!!!!!!%-.,

233&.&4+-*!(455,+.'!.4!6,!-..-(7,3!4+!-!',)-8-.,!'7,,.!

There is a total of 6 pins on the FISCE board that are connected incorrectly in the layout of the circuit. These are all low-current control signals located on SOT23-6 packages. The proposed action is to attempt to cut the 6 traces in the PCB and solder small gauge fly-wires between each of the pins and their correct connection point. Conveniently, each pin has a resistor nearby that may act as viable solder point for the fly-wires. See the attached schematic sheet and FMB2222A/2227A datasheets for details on the pin discrepancies.
The alternative action would be to make the changes in the layout and spin a new set of 4 FISCE PCB's. This may delay our shipment to Vanguard of the completed/tested boards by at least a week.

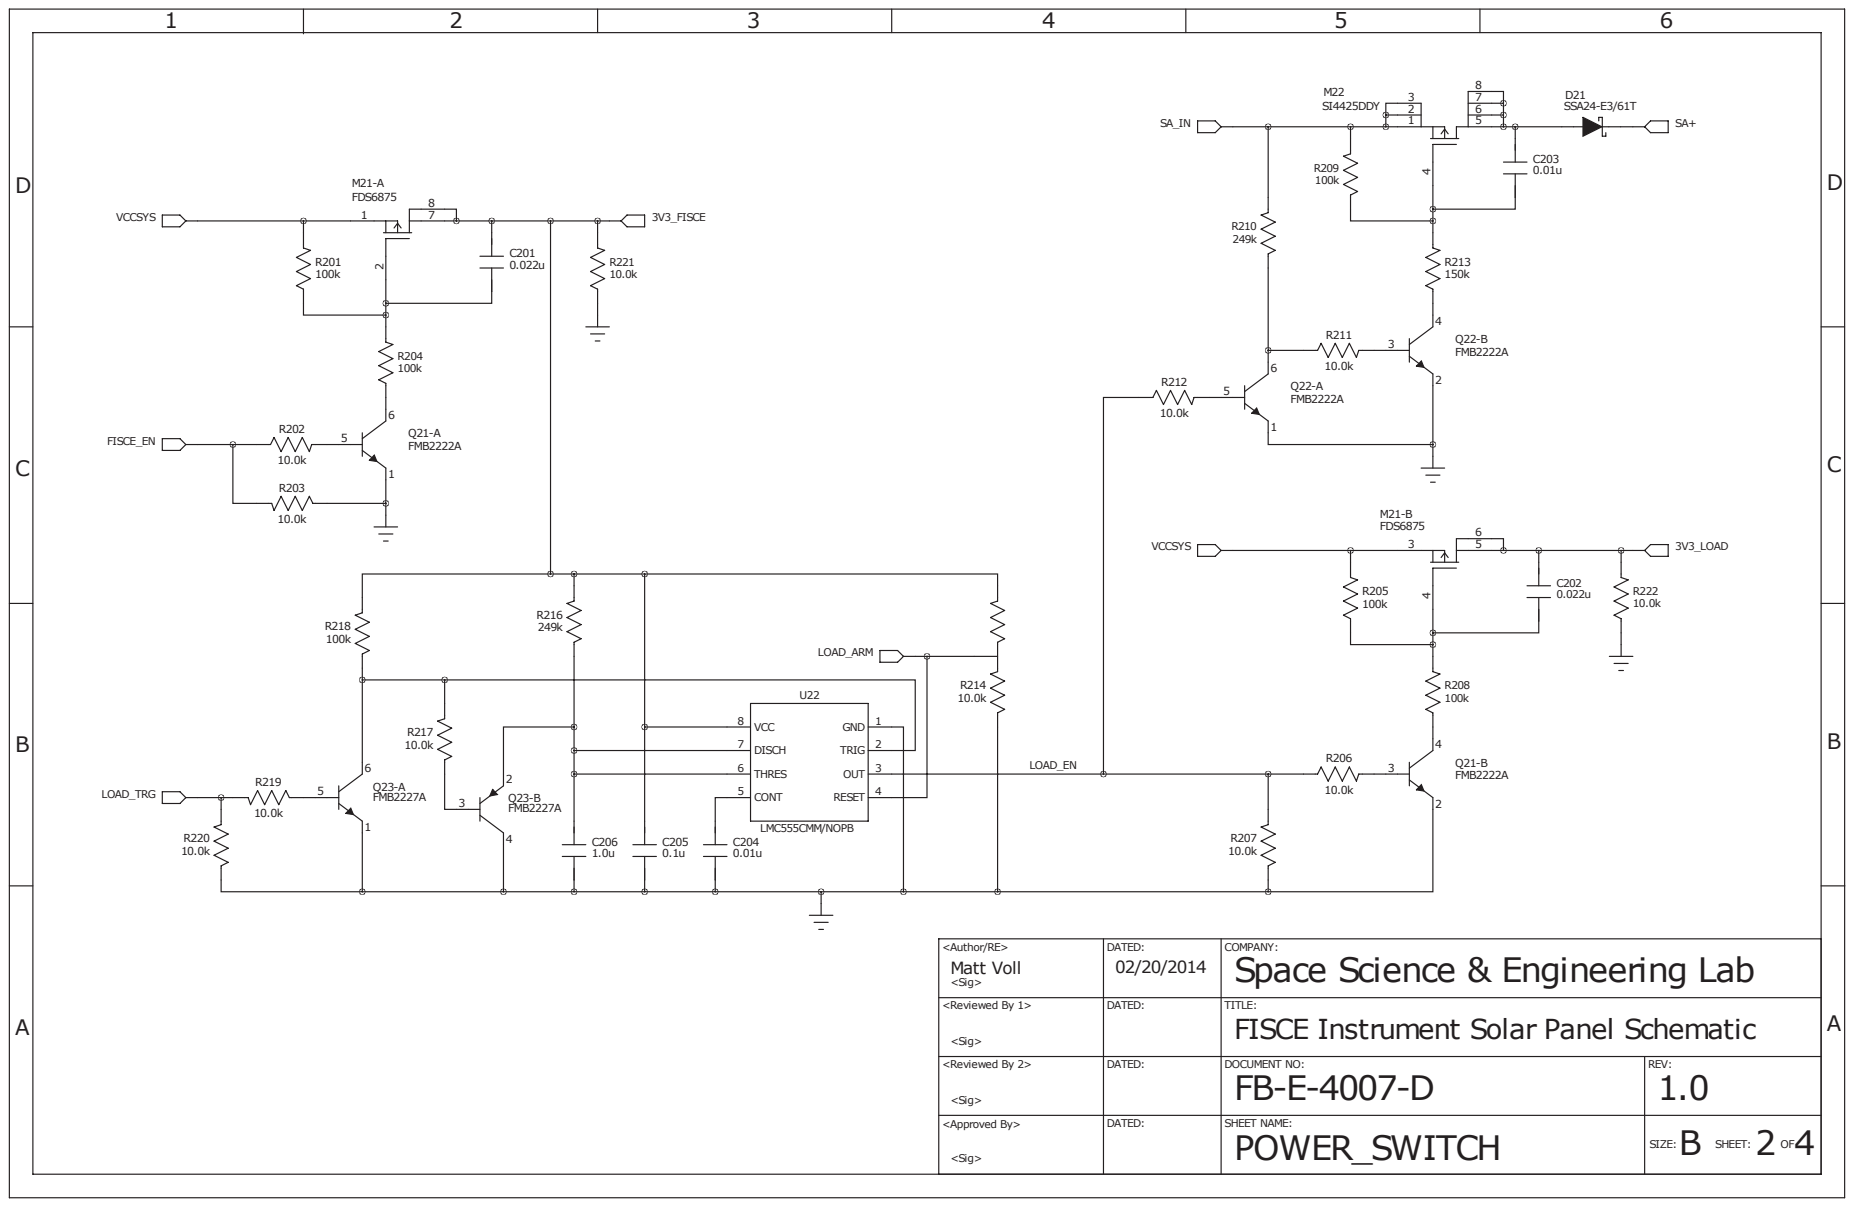
[picture p18: page 3]

<Author/RE> Matt Voll <Sig> | DATED: 02/20/2014 | COMPANY: Space Science & Engineering Lab

<Reviewed By 1> <Sig> | DATED: | TITLE: FISCE Instrument Solar Panel Schematic

<Reviewed By 2> <Sig> | DATED: | DOCUMENT NO: FB-E-4007-D | REV: 1.0

<Approved By> <Sig> | DATED: | SHEET NAME: POWER_SWITCH | B 2 4 SIZE: SHEET: OF

# FFB2227A / FMB2227A NPN & PNP General-Purpose Amplifier

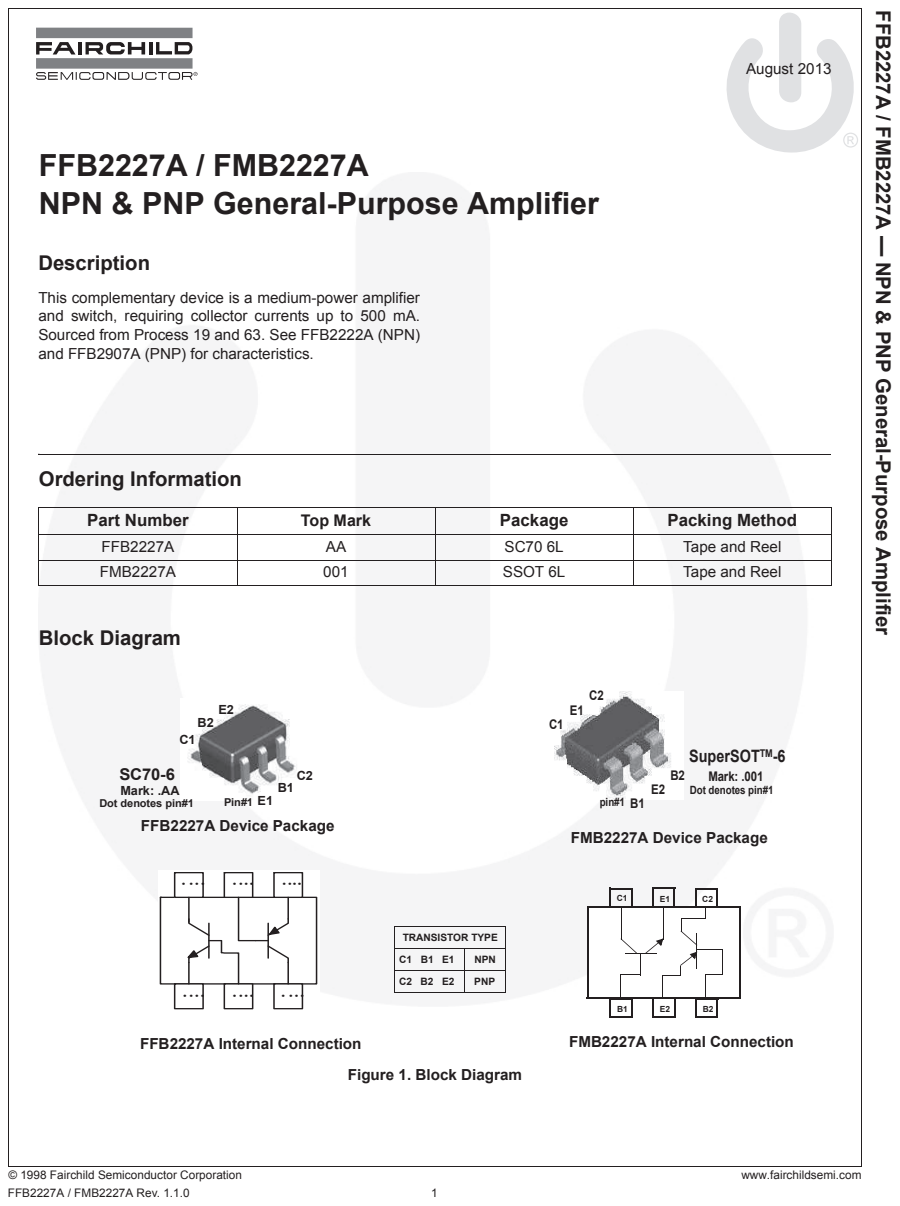
[picture p19: page 4]
© 1998 Fairchild Semiconductor Corporation; www.fairchildsemi.com; FFB2227A / FMB2227A Rev. 1.1.0; August 2013; Ordering Information; Block Diagram; Pin#1; TRANSISTOR TYPE; pin#1; SuperSOTTM-6; Mark: .001 Dot denotes pin#1; FMB2227A Device Package; FFB2227A Internal Connection; FMB2227A Internal Connection; Description

FFB2227A / FMB2227A ó NPN & PNP General-Purpose Amplifier

This complementary device is a medium-power amplifier
and switch, requiring collector currents up to 500 mA.
Sourced from Process 19 and 63. See FFB2222A (NPN)
and FFB2907A (PNP) for characteristics.

Part Number | Top Mark | Package | Packing Method
FFB2227A | AA | SC70 6L | Tape and Reel
FMB2227A | 001 | SSOT 6L | Tape and Reel

Mark: .AA
Dot denotes pin#1
FFB2227A Device Package

C1 B1 E1 | NPN

C2 B2 E2 | PNP

Figure 1. Block Diagram

# FFB2222A FMB2222A MMPQ2222A

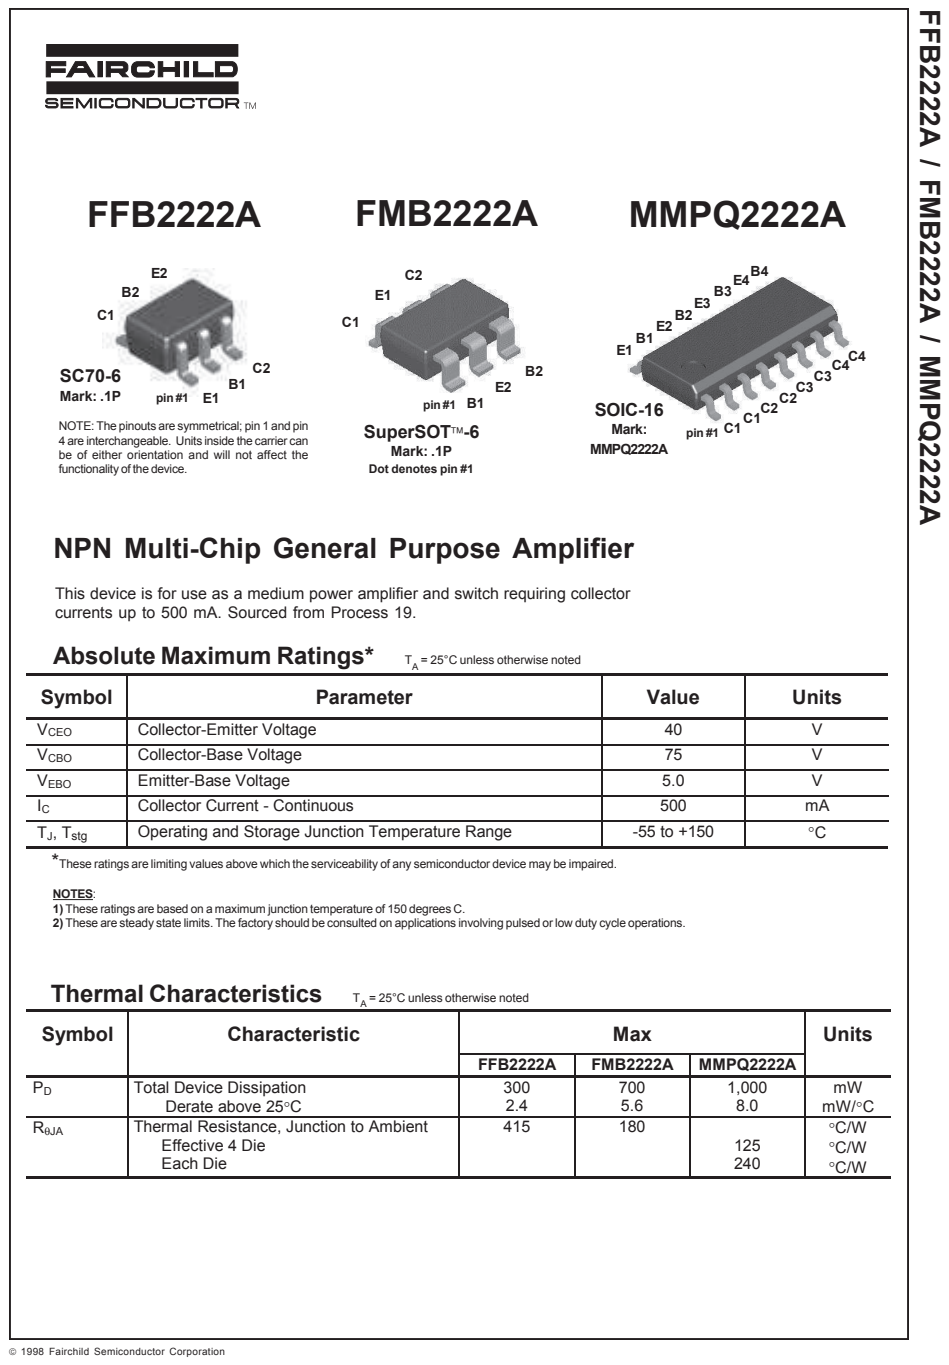
[picture p20: page 5]
Absolute Maximum Ratings*; Symbol; Parameter; Value; Units; VCEO; Collector-Emitter Voltage; VCBO; Collector-Base Voltage; VEBO; Emitter-Base Voltage; Collector Current - Continuous; TJ, Tstg; Operating and Storage Junction Temperature Range; Thermal Characteristics; Characteristic; Max; FFB2222A; FMB2222A; MMPQ2222A; Total Device Dissipation; Derate above 25°C; RθJA; Thermal Resistance, Junction to Ambient; Effective 4 Die Each Die; pin #1; SOIC-16; Mark:; Mark: .1P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

pin #1 NOTE: The pinouts are symmetrical; pin 1 and pin
4 are interchangeable. Units inside the carrier can
be of either orientation and will not affect the
functionality of the device.

SuperSOT⁻6
Mark: .1P
Dot denotes pin #1

NPN Multi-Chip General Purpose Amplifier

This device is for use as a medium power amplifier and switch requiring collector
currents up to 500 mA. Sourced from Process 19.

= 25°C unless otherwise noted

*These ratings are limiting values above which the serviceability of any semiconductor device may be impaired.

NOTES:
1) These ratings are based on a maximum junction temperature of 150 degrees C.
2) These are steady state limits. The factory should be consulted on applications involving pulsed or low duty cycle operations.

1998 Fairchild Semiconductor Corporation

Proposed FISCE board modifications. RED lines indicate cut traces, GREEN lines indicate suggested fly-wire attachments.

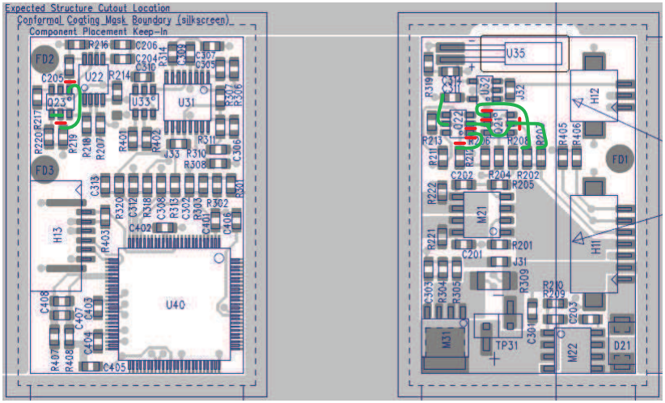
[picture p21: figure]
