mattyv06/thesis/figs/fisce/results/fisce_flight_data.xlsx

Sheet: FU3_2015-09-17_818
Time | Threshold | I_01 | I_02 | I_03 | I_04 | I_05 | I_06 | I_07 | I_08 | I_09 | I_10 | I_11 | I_12 | I_13 | I_14 | I_15 | I_16 | I_17 | I_18 | I_19 | I_20 | I_21 | I_22 | I_23 | I_24 | I_25 | I_26 | I_27 | I_28 | I_29 | I_30 | V_01 | V_02 | V_03 | V_04 | V_05 | V_06 | V_07 | V_08 | V_09 | V_10 | V_11 | V_12 | V_13 | V_14 | V_15 | V_16 | V_17 | V_18 | V_19 | V_20 | V_21 | V_22 | V_23 | V_24 | V_25 | V_26 | V_27 | V_28
2015-09-17T03:23:24.599000 | 818 | 0.69424 | 65.47881 | 132.21178 | 271.03585 | 331.9236 | 342.15274 | 350.43348 | 362.12393 | 372.35307 | 384.04352 | 410.83413 | 412.29543 | 412.78253 | 412.78253 | 412.78253 | 412.78253 | 412.78253 | 413.26964 | 412.78253 | 412.78253 | 384.04352 | 372.84017 | 362.12393 | 351.89478 | 342.15274 | 331.9236 | 270.54875 | 134.16019 | 65.96591 | 0.69424 | 10.09541 | 10.07569 | 9.98697 | 9.7208 | 9.46449 | 9.42506 | 9.35606 | 9.30676 | 9.20818 | 9.03074 | 0.08954 | 0.0501 | 0.0501 | 0.0501 | 0.0501 | 0.0501 | 0.0501 | 0.0501 | 0.0501 | 0.26698 | 9.05046 | 9.20818 | 9.27719 | 9.37577 | 9.43492 | 9.47435 | 9.71094 | 9.98697
Time Downlinked | 2015-09-17T03:23:24.599000
TEMP_END | -20.52422
TEMP_START | -22.32762
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
