mattyv06/thesis/figs/fisce/results/fisce_test_panel_verification.xlsx

Potentiometer Load Circuit Time of Day: 13:26 |  |  |  |  |  | FISCE Electronic Load Circuit Time of Day: 16:07
2012-11-15 Curve 1 |  | 2012-11-15 Curve 2 |  | 2012-11-15 Curve 3 |  | 2014-1-21 Curve 1 |  | 2014-1-21 Curve 2
V | I | V | I | V | I | V | I | V | I
0.19898928 | 0.31213089 | 0.20235349 | 0.31175673 | 0.1960411 | 0.31210491 | 7.509 | 0.001 | 0.041 | 0.3
0.19874565 | 0.31235045 | 0.20097464 | 0.31176843 | 0.1957223 | 0.31191653 | 7.519 | 0.002 | 0.041 | 0.3
0.19921348 | 0.31210621 | 0.20097594 | 0.31224912 | 0.19541129 | 0.31179831 | 7.509 | 0.004 | 0.051 | 0.3
0.19914998 | 0.31269603 | 0.20040574 | 0.31216727 | 0.19723981 | 0.31168658 | 7.499 | 0.006 | 0.03 | 0.3
0.19952323 | 0.31269732 | 0.20089689 | 0.31213089 | 0.19621993 | 0.31170087 | 7.499 | 0.008 | 0.03 | 0.3
0.20016341 | 0.31287921 | 0.20146061 | 0.31218805 | 0.19659704 | 0.31171126 | 7.489 | 0.01 | 0.02 | 0.301
0.19832708 | 0.31271811 | 0.38852895 | 0.31178532 | 0.30572036 | 0.31167619 | 7.479 | 0.012 | 0.03 | 0.301
0.21316654 | 0.31268173 | 0.38839677 | 0.31181 | 0.301716 | 0.31177622 | 7.479 | 0.014 | 0.02 | 0.301
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
