mattyv06/thesis/figs/phoenix/concept/i2c_tree.pdf

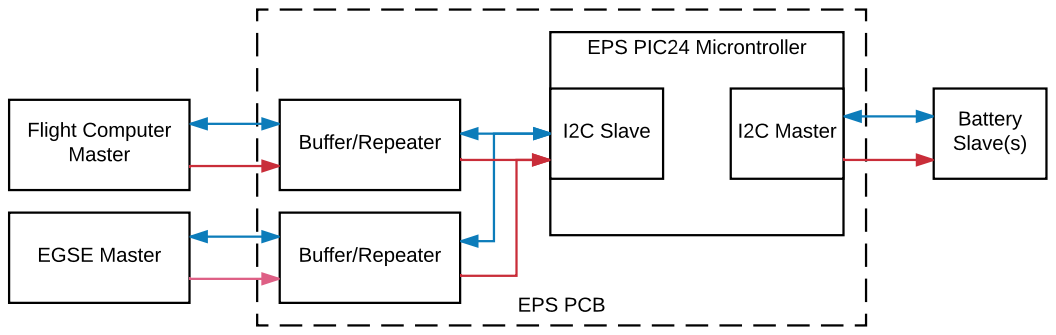
[picture p32: page 1]
EPS PCB; EGSE Master; EPS PIC24 Microntroller; Buffer/Repeater; I2C Slave; I2C Master; Battery; Slave(s)

Flight Computer Master
