mattyv06/thesis/figs/phoenix/schematic/phoenix_eps_rev3_1.pdf

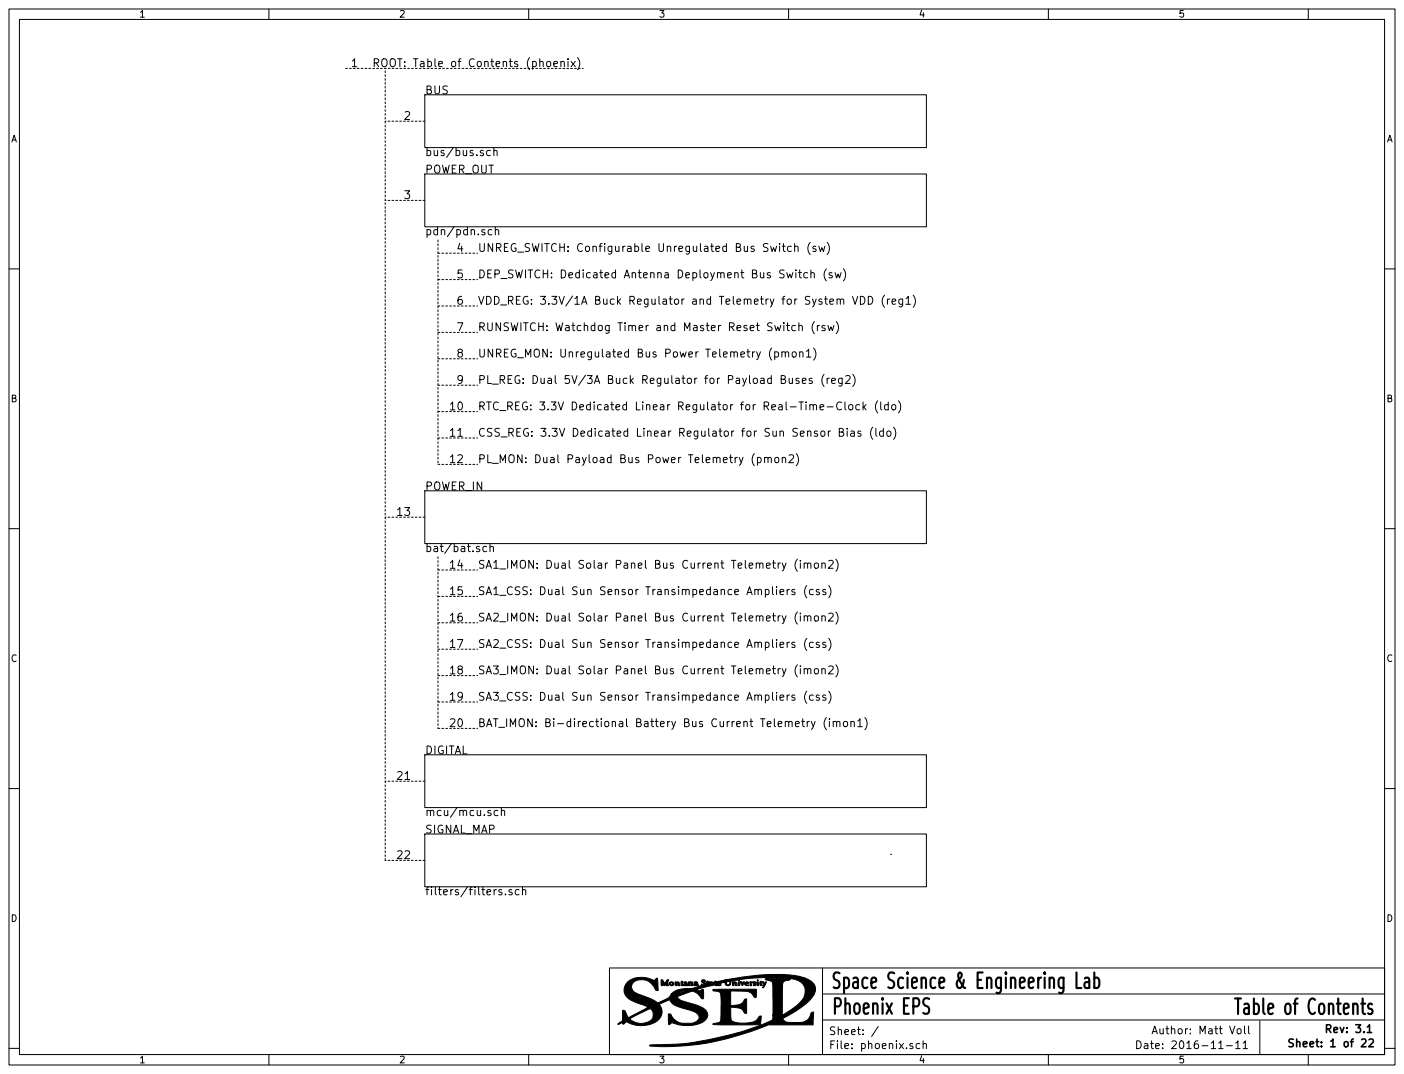
[picture p33: page 1]

ROOT: Table of Contents (phoenix)

UNREG_SWITCH: Configurable Unregulated Bus Switch (sw)

DEP_SWITCH: Dedicated Antenna Deployment Bus Switch (sw)

VDD_REG: 3.3V/1A Buck Regulator and Telemetry for System VDD (reg1)

RUNSWITCH: Watchdog Timer and Master Reset Switch (rsw)

UNREG_MON: Unregulated Bus Power Telemetry (pmon1)

PL_REG: Dual 5V/3A Buck Regulator for Payload Buses (reg2)

RTC_REG: 3.3V Dedicated Linear Regulator for Real-Time-Clock (ldo)

CSS_REG: 3.3V Dedicated Linear Regulator for Sun Sensor Bias (ldo)

PL_MON: Dual Payload Bus Power Telemetry (pmon2)

SA1_IMON: Dual Solar Panel Bus Current Telemetry (imon2)

SA1_CSS: Dual Sun Sensor Transimpedance Ampliers (css)

SA2_IMON: Dual Solar Panel Bus Current Telemetry (imon2)

SA2_CSS: Dual Sun Sensor Transimpedance Ampliers (css)

SA3_IMON: Dual Solar Panel Bus Current Telemetry (imon2)

SA3_CSS: Dual Sun Sensor Transimpedance Ampliers (css)

BAT_IMON: Bi-directional Battery Bus Current Telemetry (imon1)

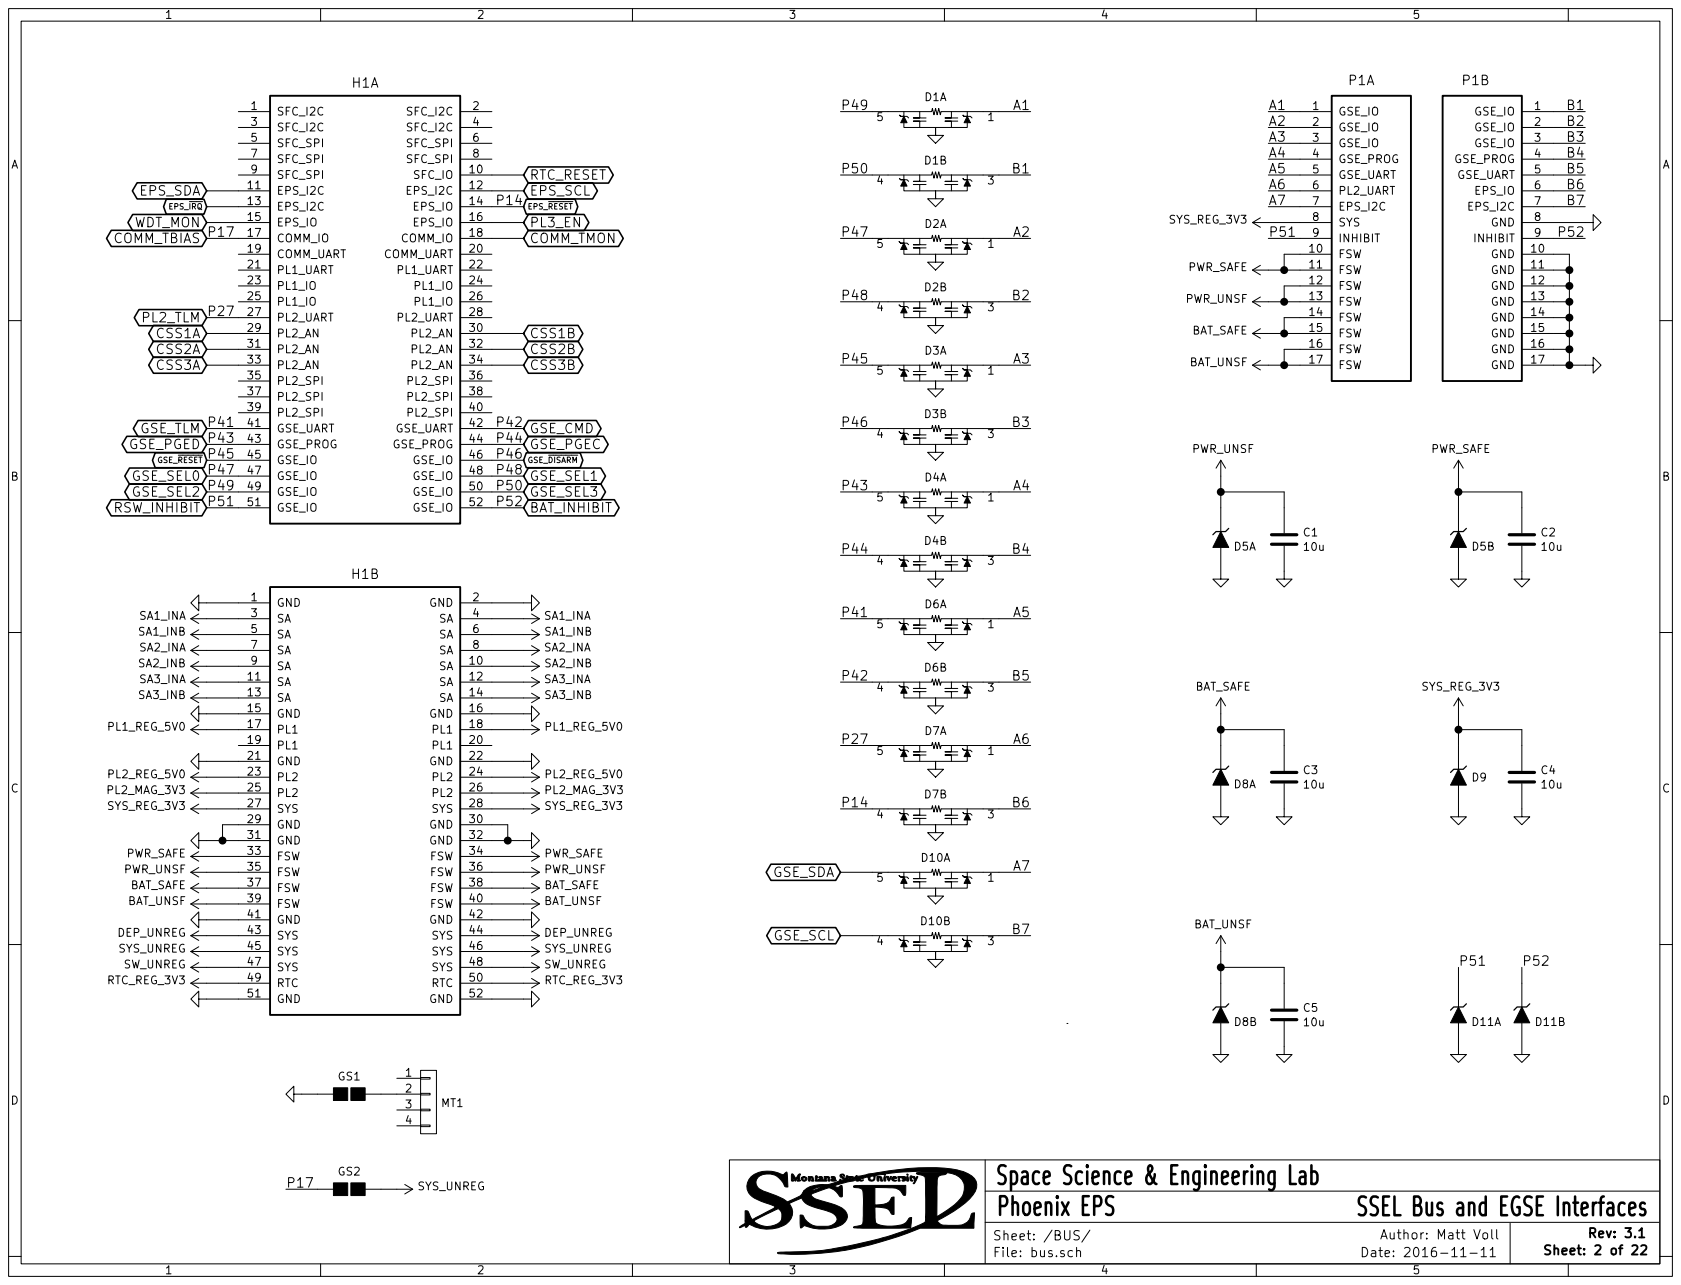
[picture p34: page 2]

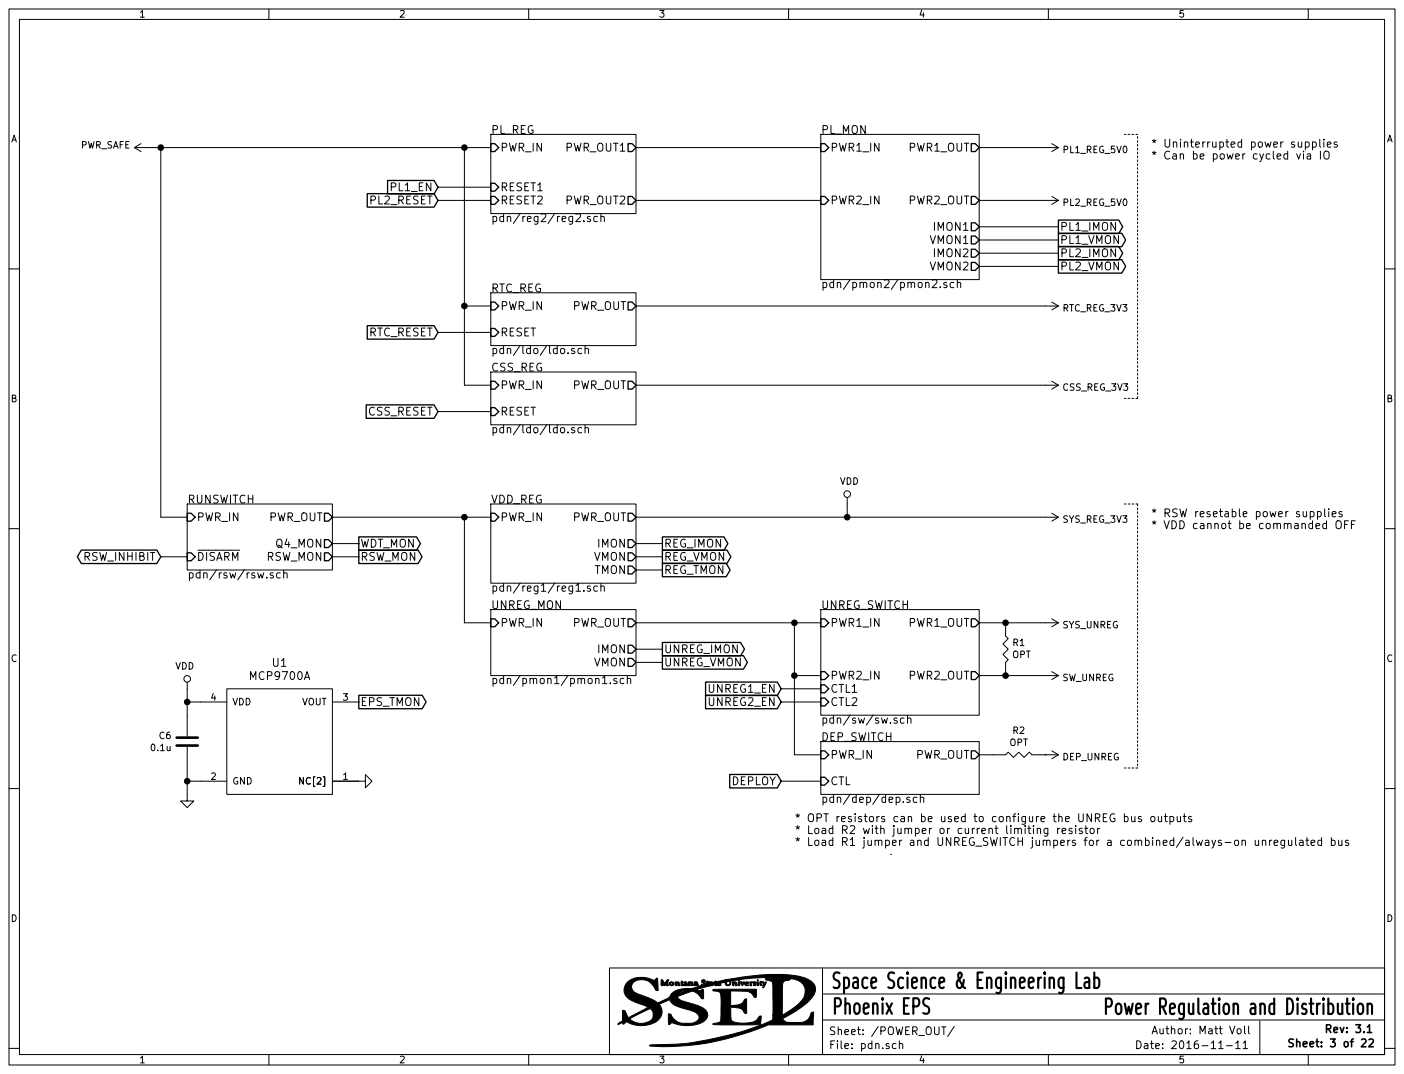
[picture p35: page 3]

* Uninterrupted power supplies
* Can be power cycled via IO

RESET
pdn/ldo/ldo.sch

* RSW resetable power supplies
* VDD cannot be commanded OFF

pdn/rsw/rsw.sch

CTL
pdn/dep/dep.sch
* OPT resistors can be used to configure the UNREG bus outputs
* Load R2 with jumper or current limiting resistor
* Load R1 jumper and UNREG_SWITCH jumpers for a combined/always-on unregulated bus

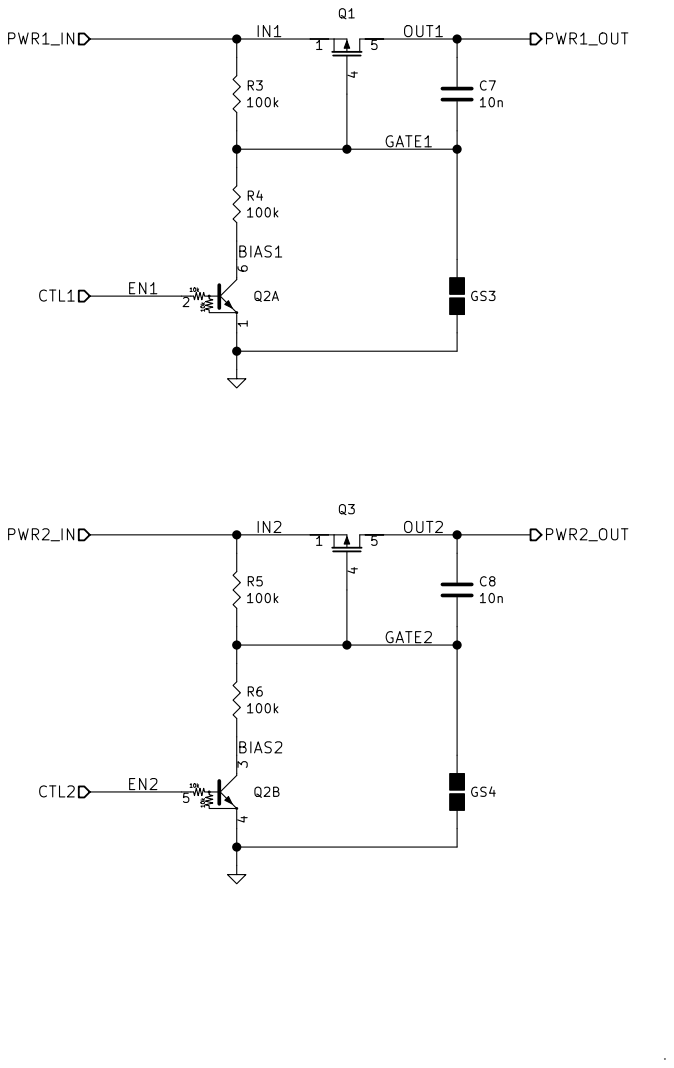
[picture p36: page 4]

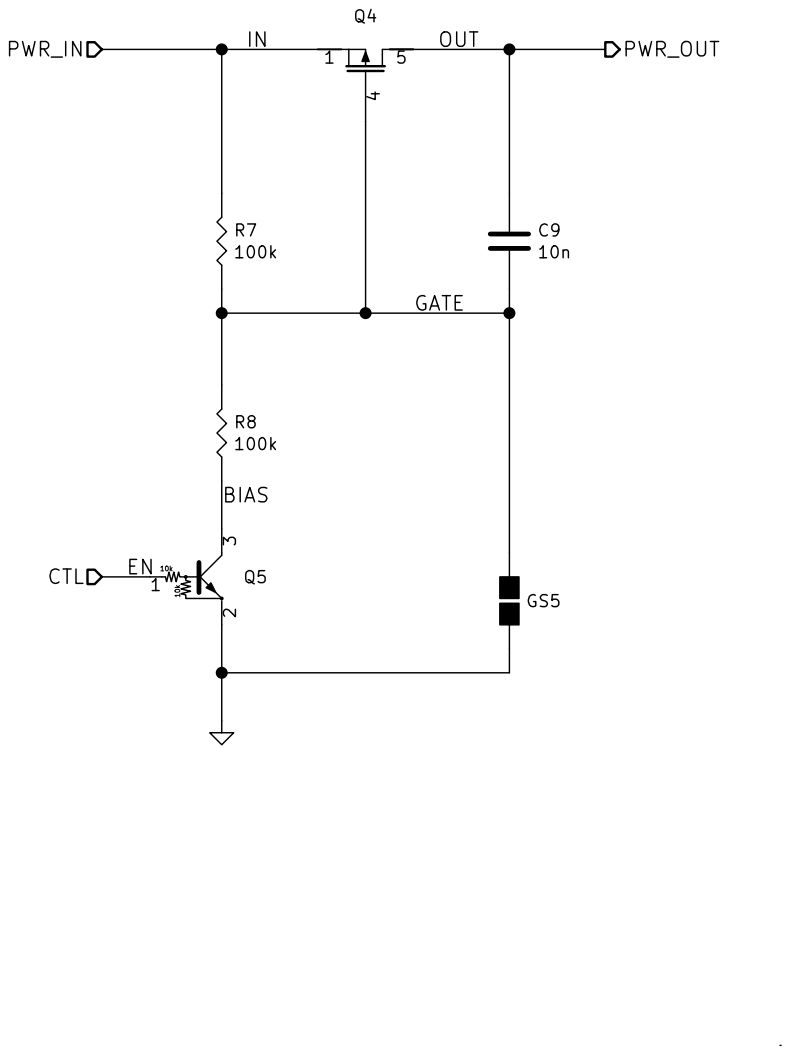
[picture p37: page 5]

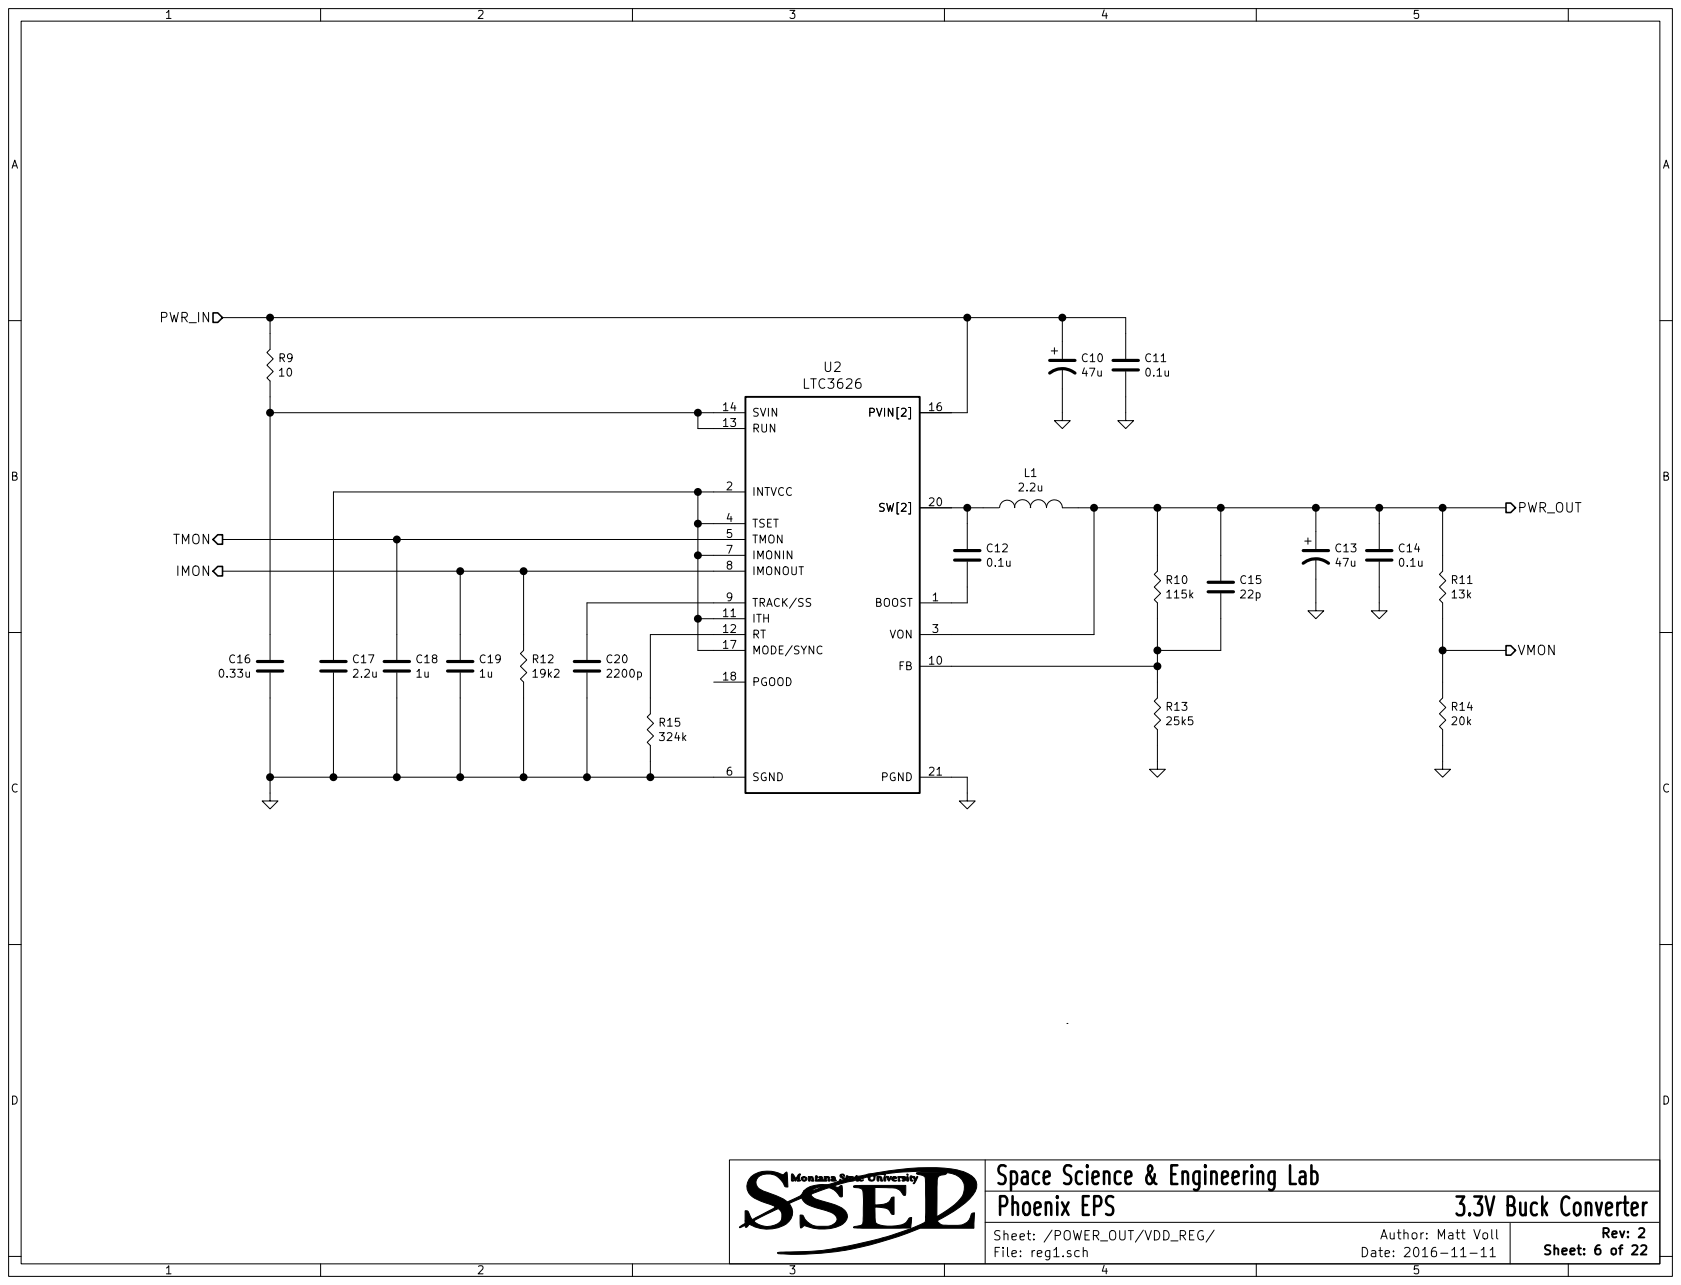
[picture p38: page 6]

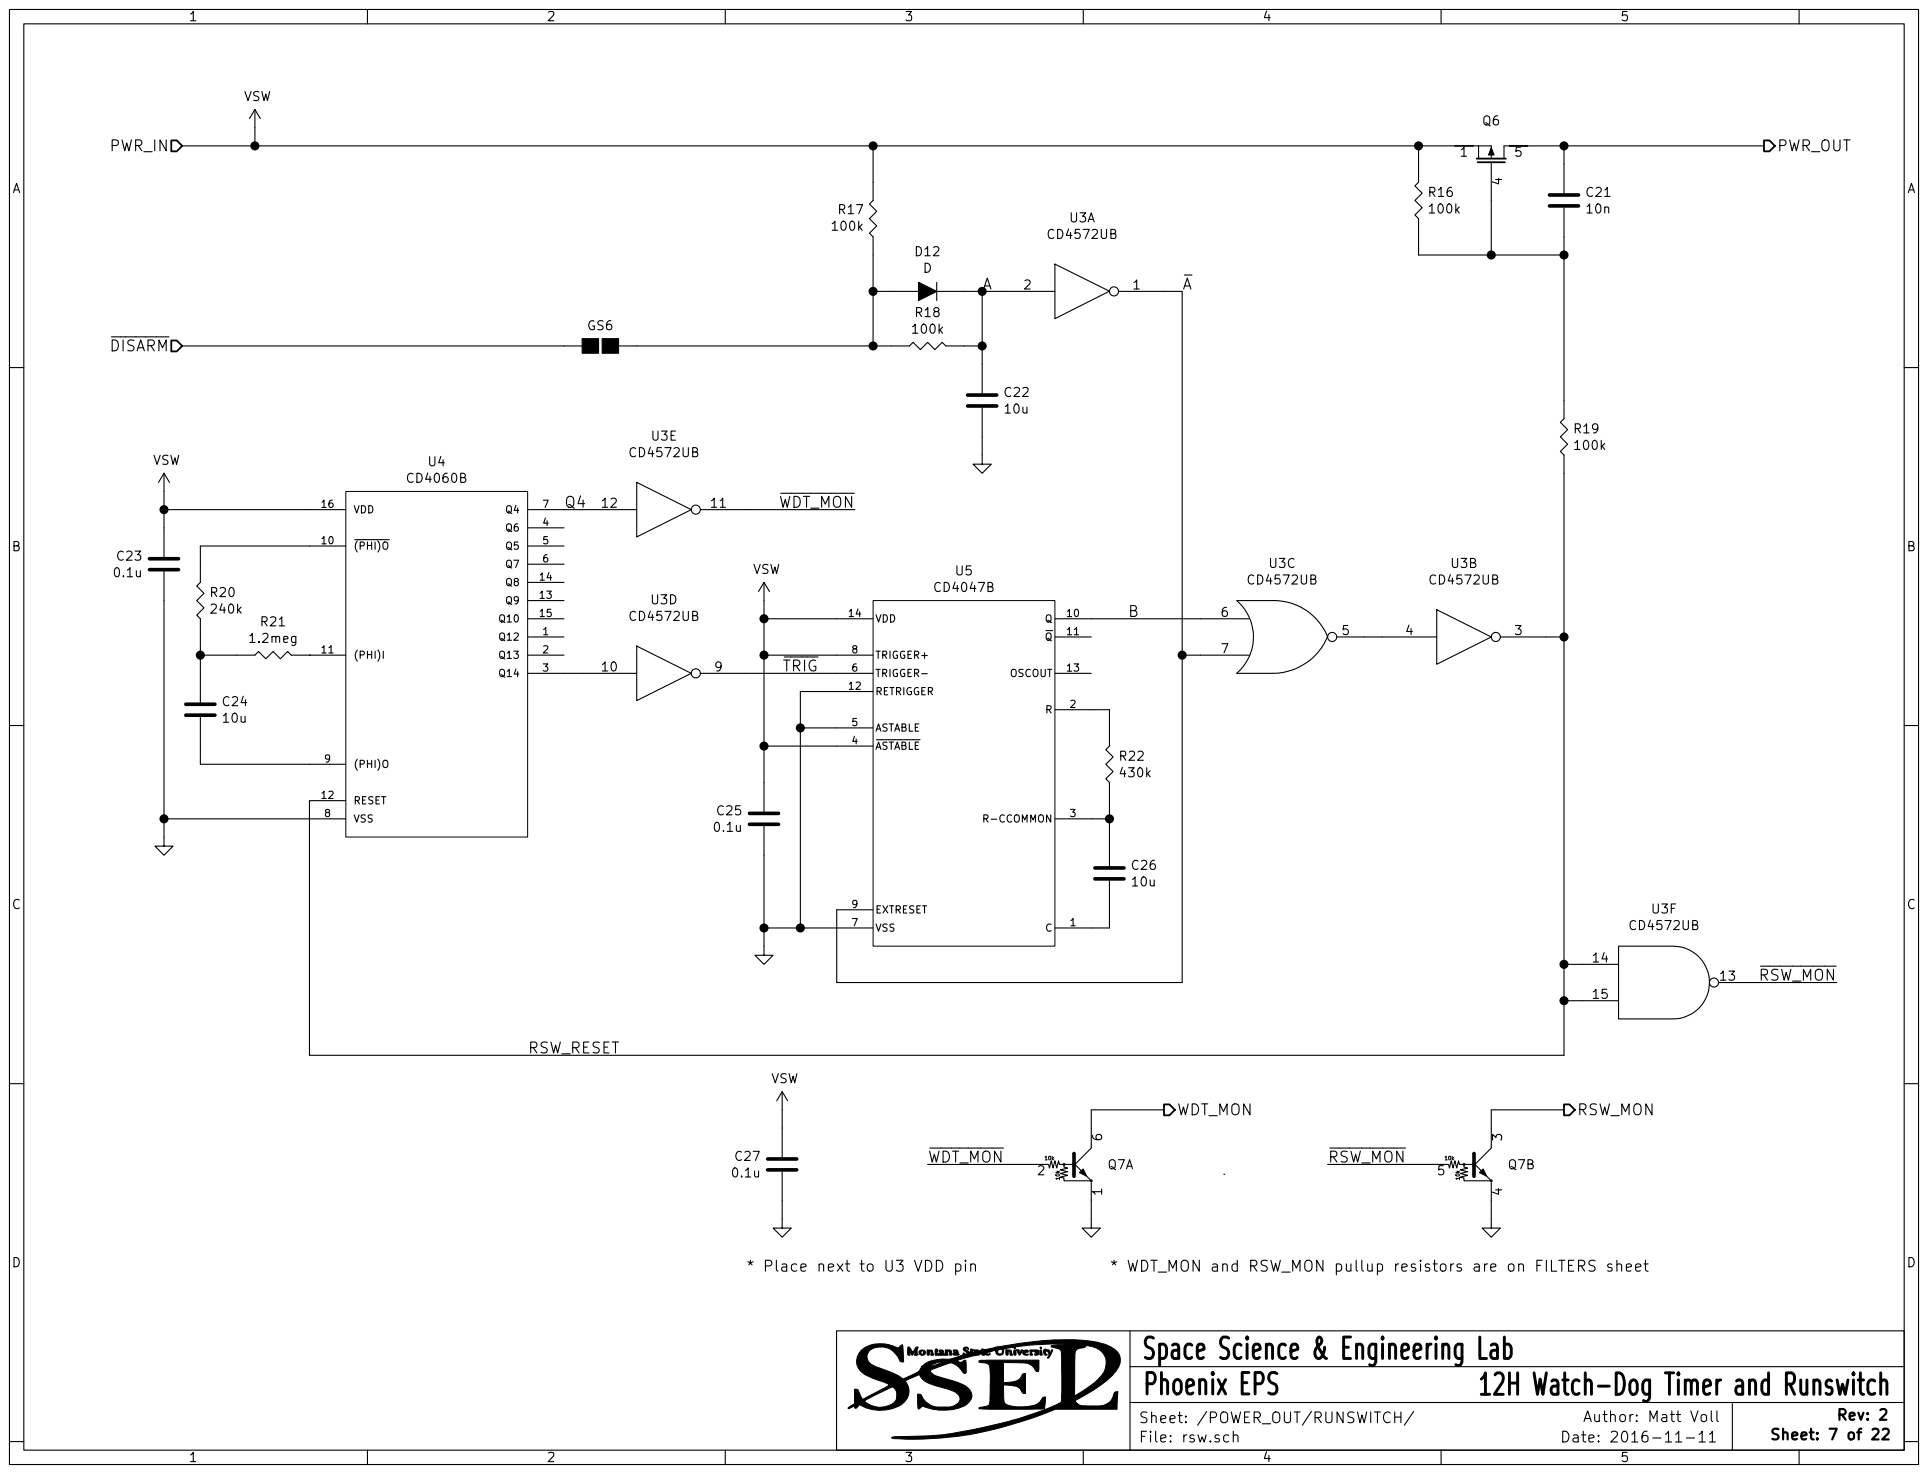
[picture p39: page 7]

* Place next to U3 VDD pin

* WDT_MON and RSW_MON pullup resistors are on FILTERS sheet

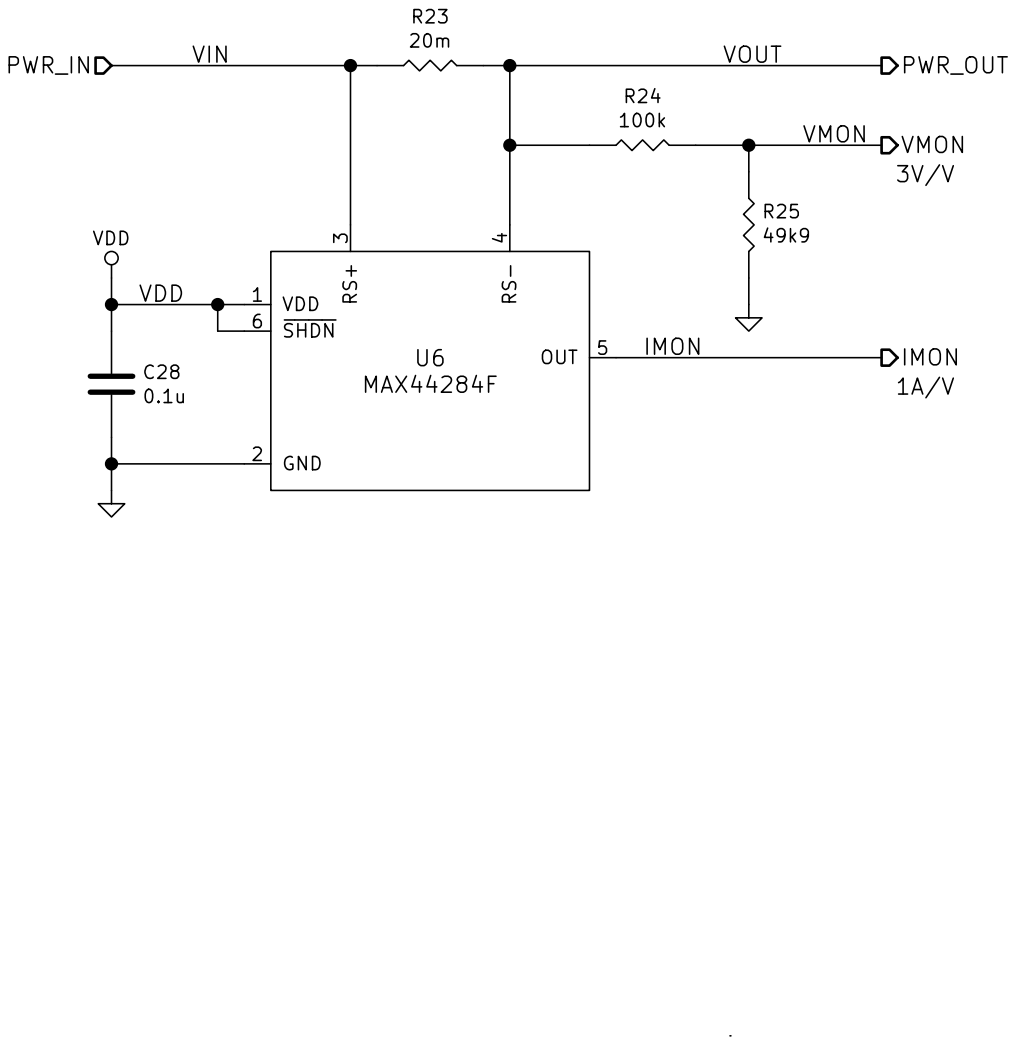
[picture p40: page 8]

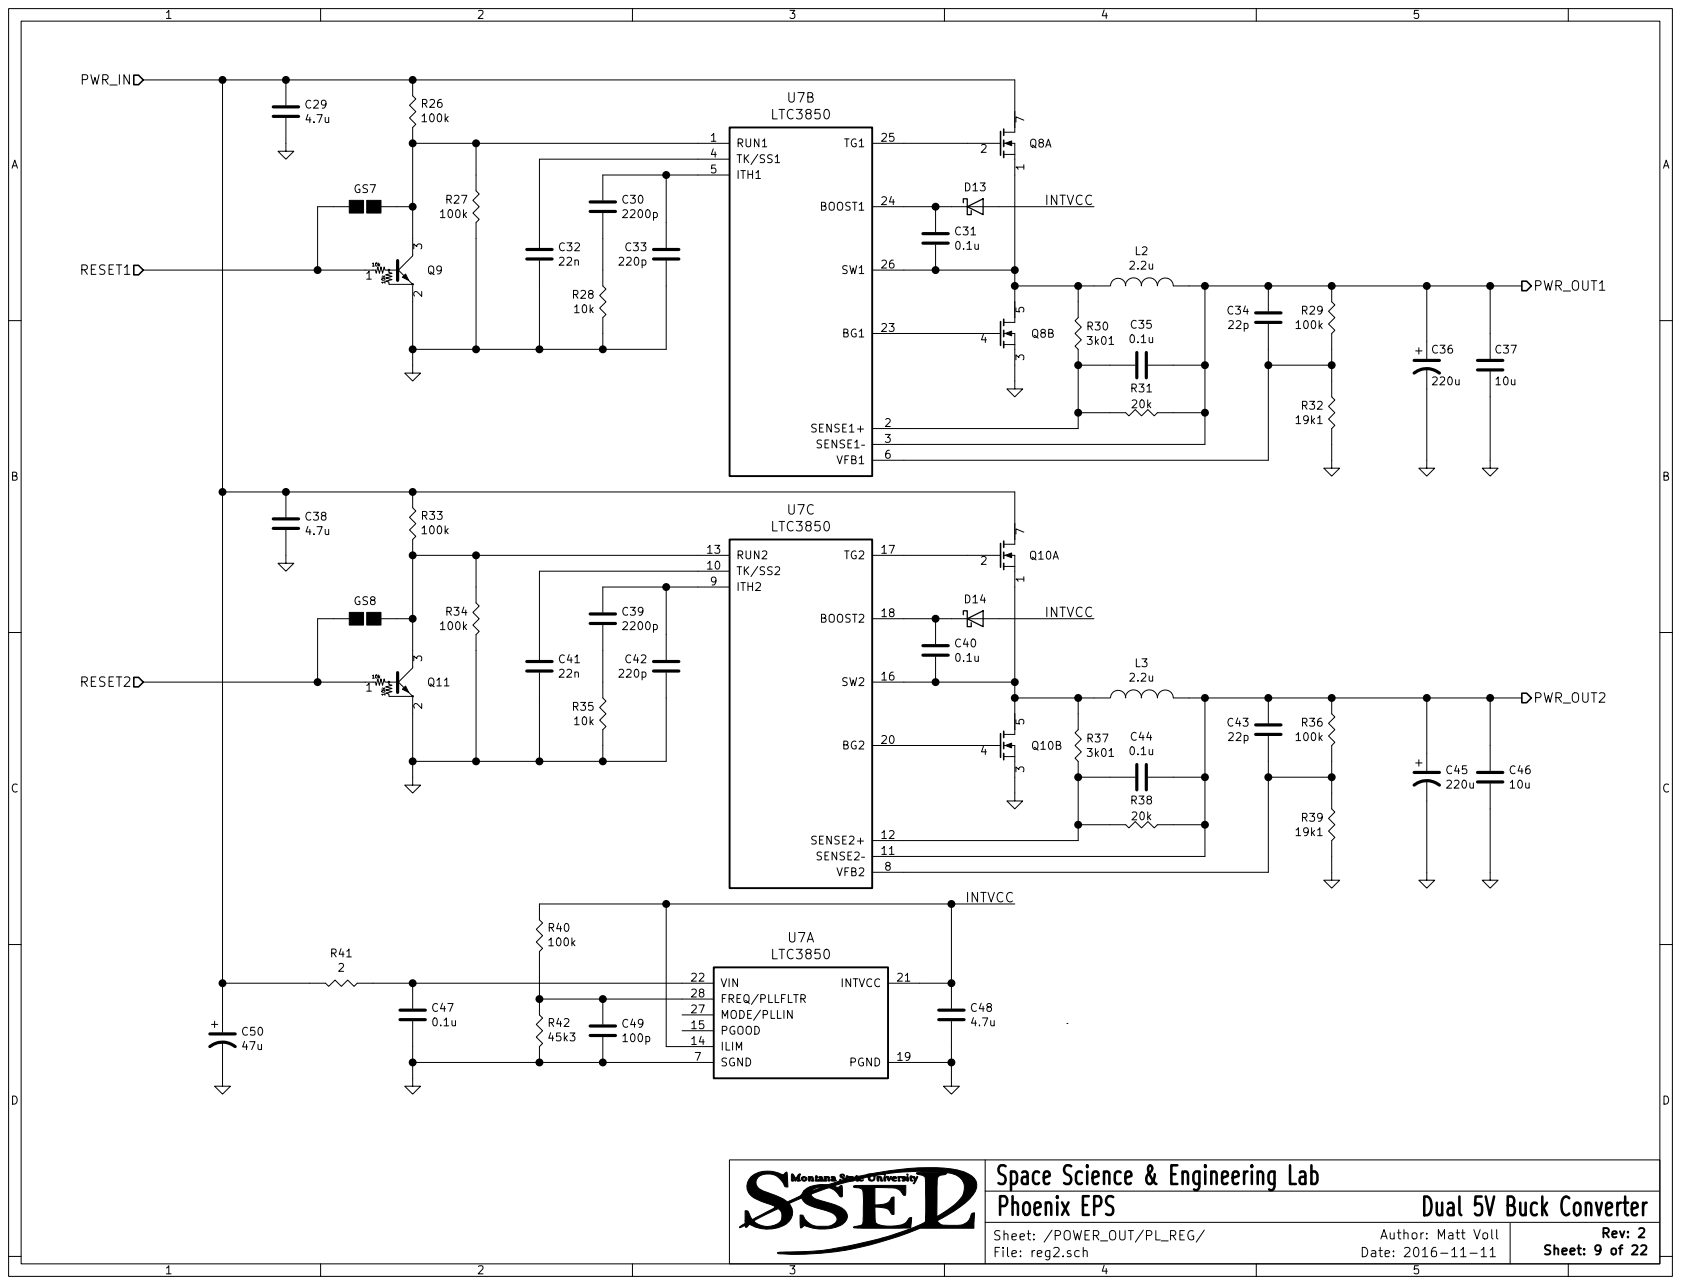
[picture p41: page 9]

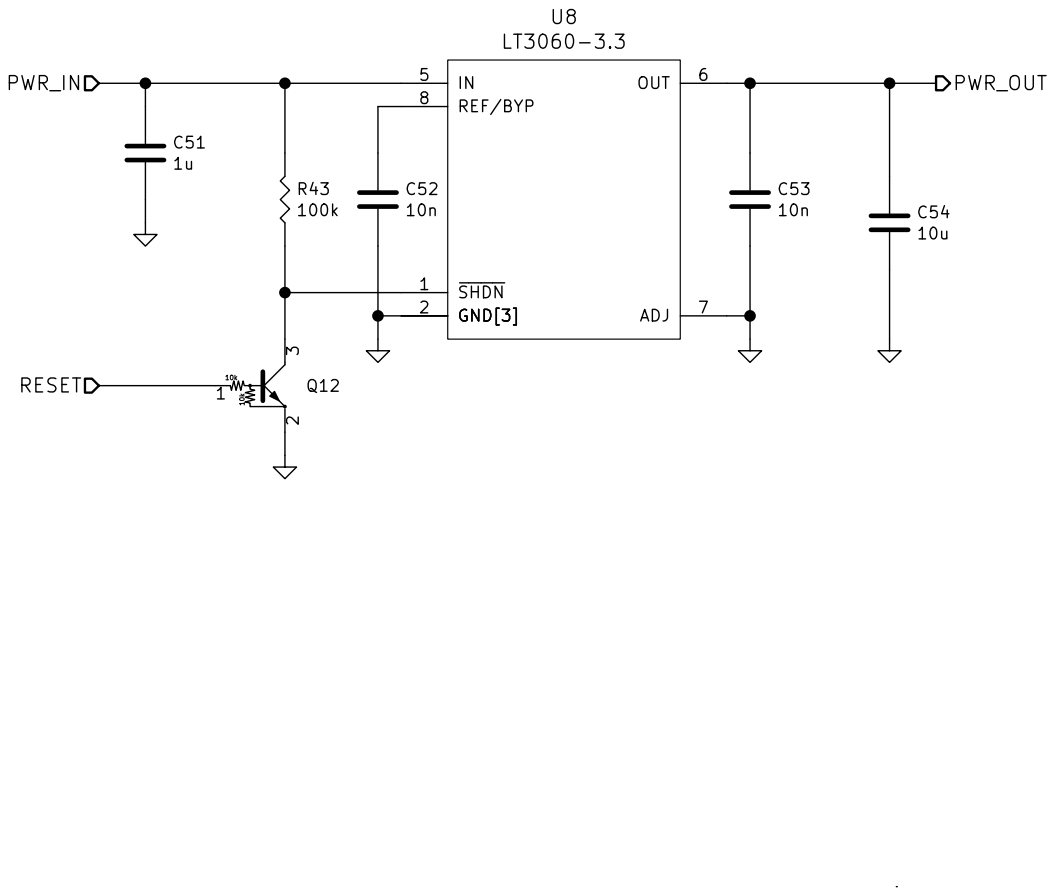
[picture p42: page 10]

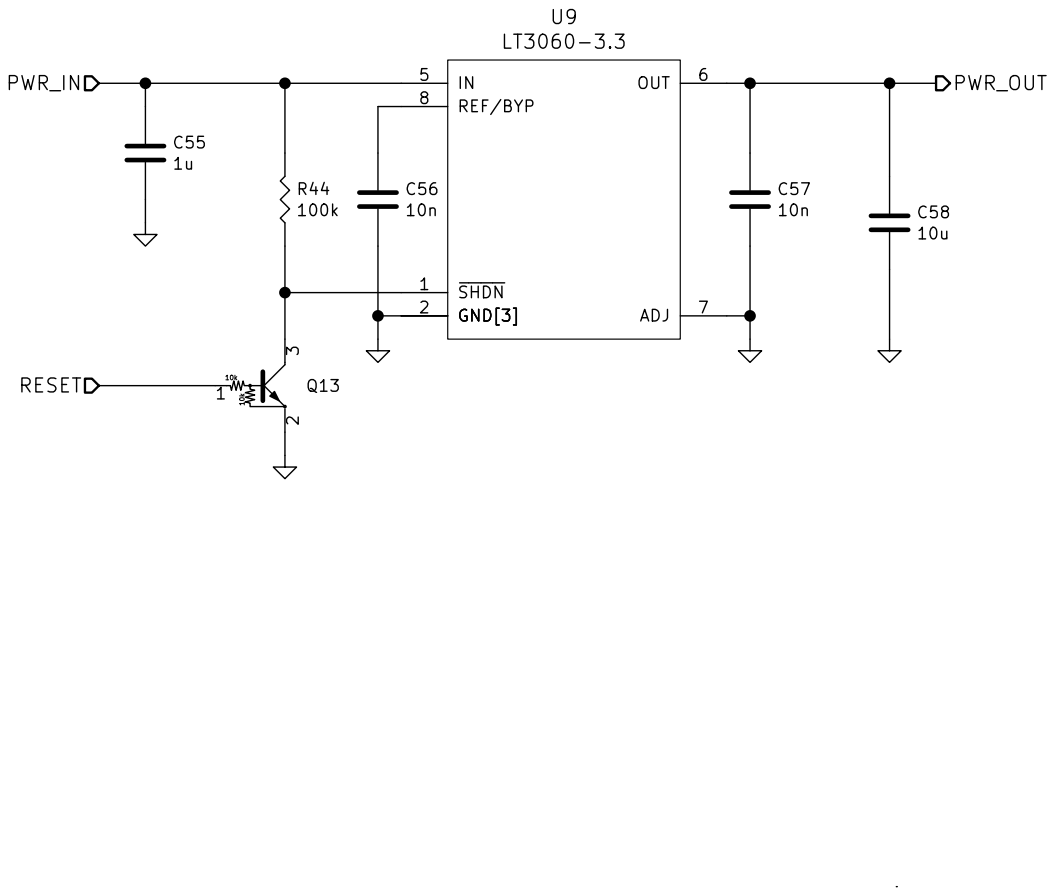
[picture p43: page 11]

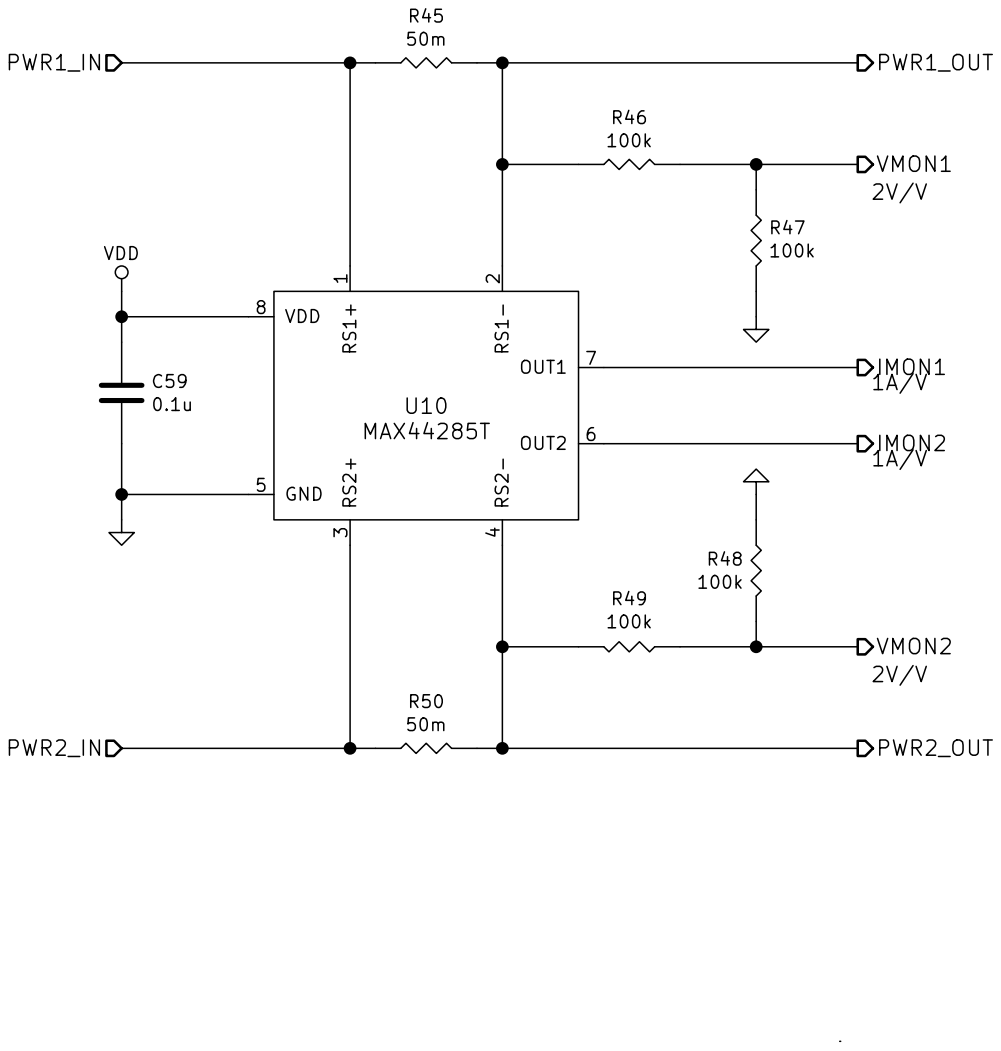
[picture p44: page 12]

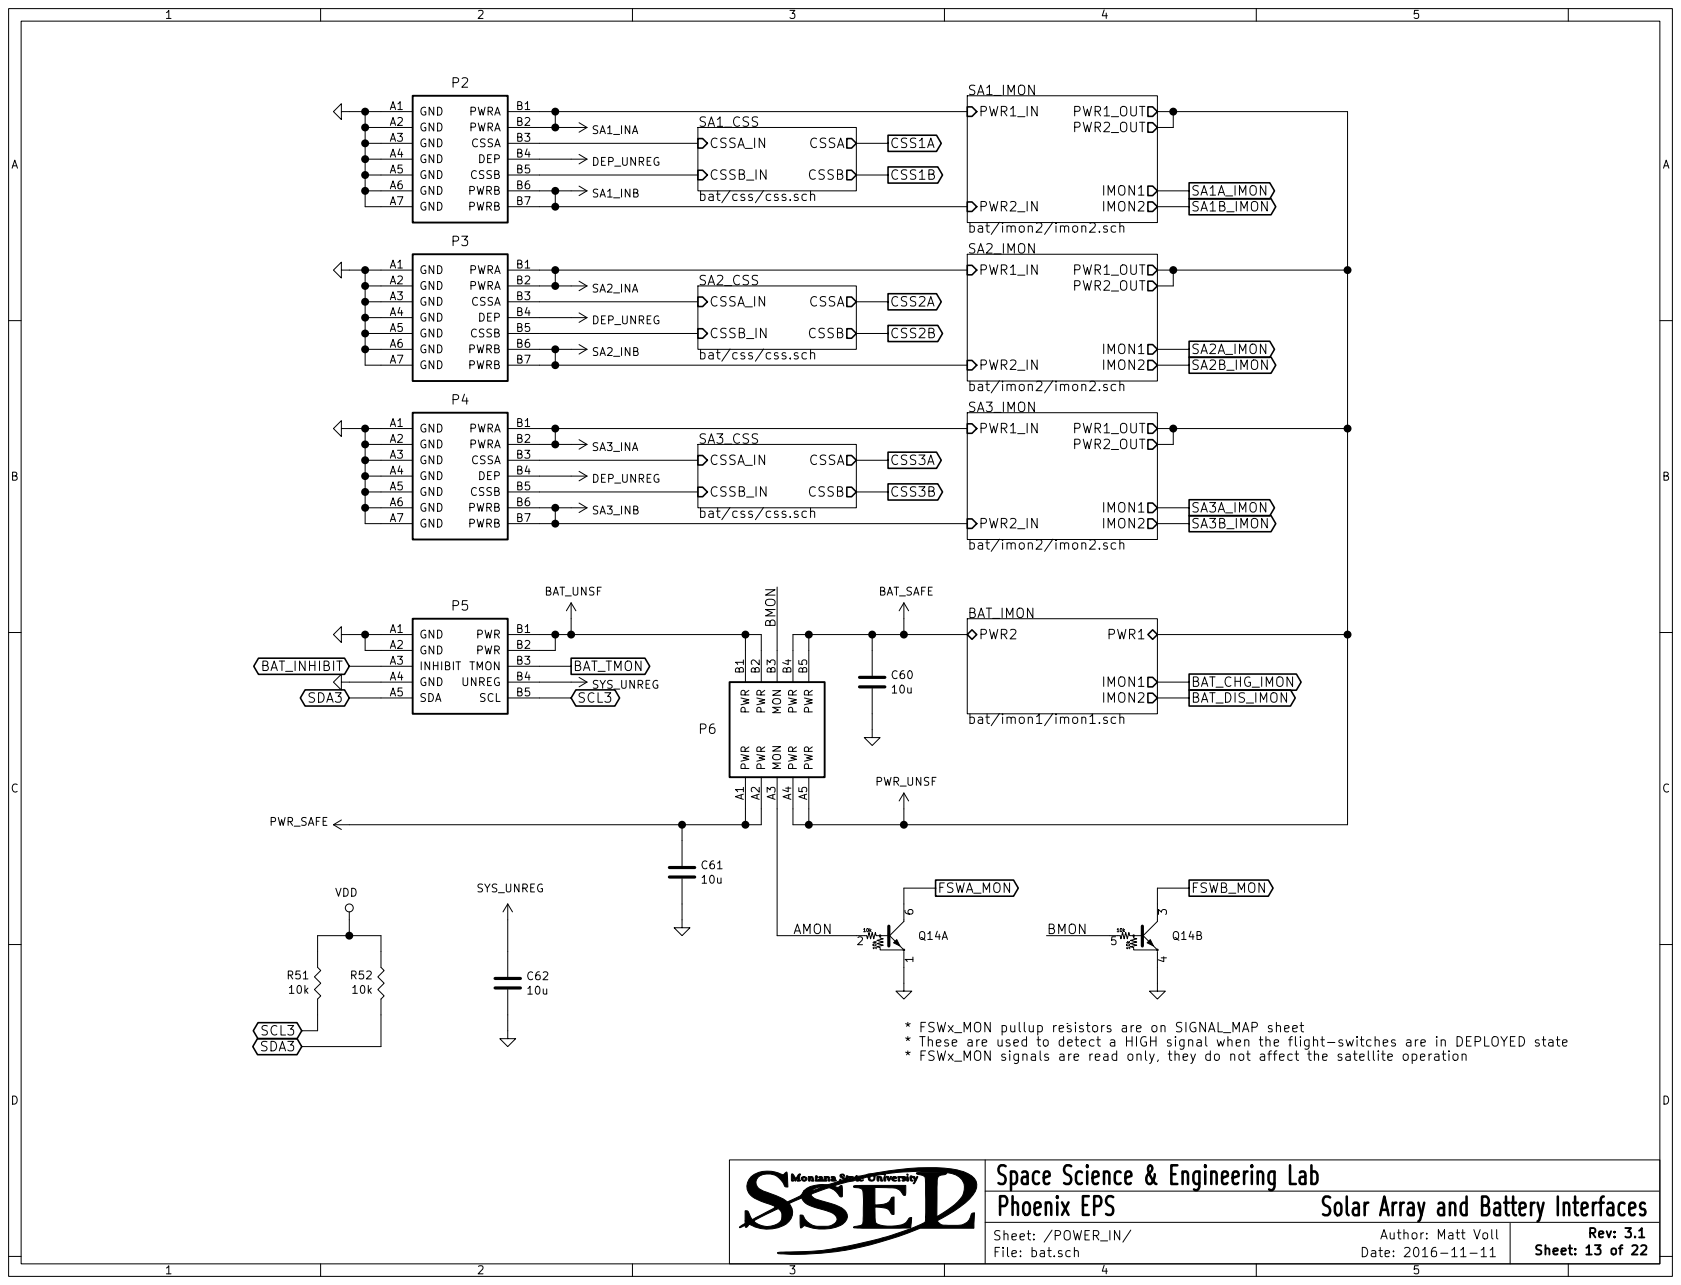
[picture p45: page 13]

CSSB_IN
bat/css/css.sch

* FSWx_MON pullup resistors are on SIGNAL_MAP sheet
* These are used to detect a HIGH signal when the flight-switches are in DEPLOYED state
* FSWx_MON signals are read only, they do not affect the satellite operation

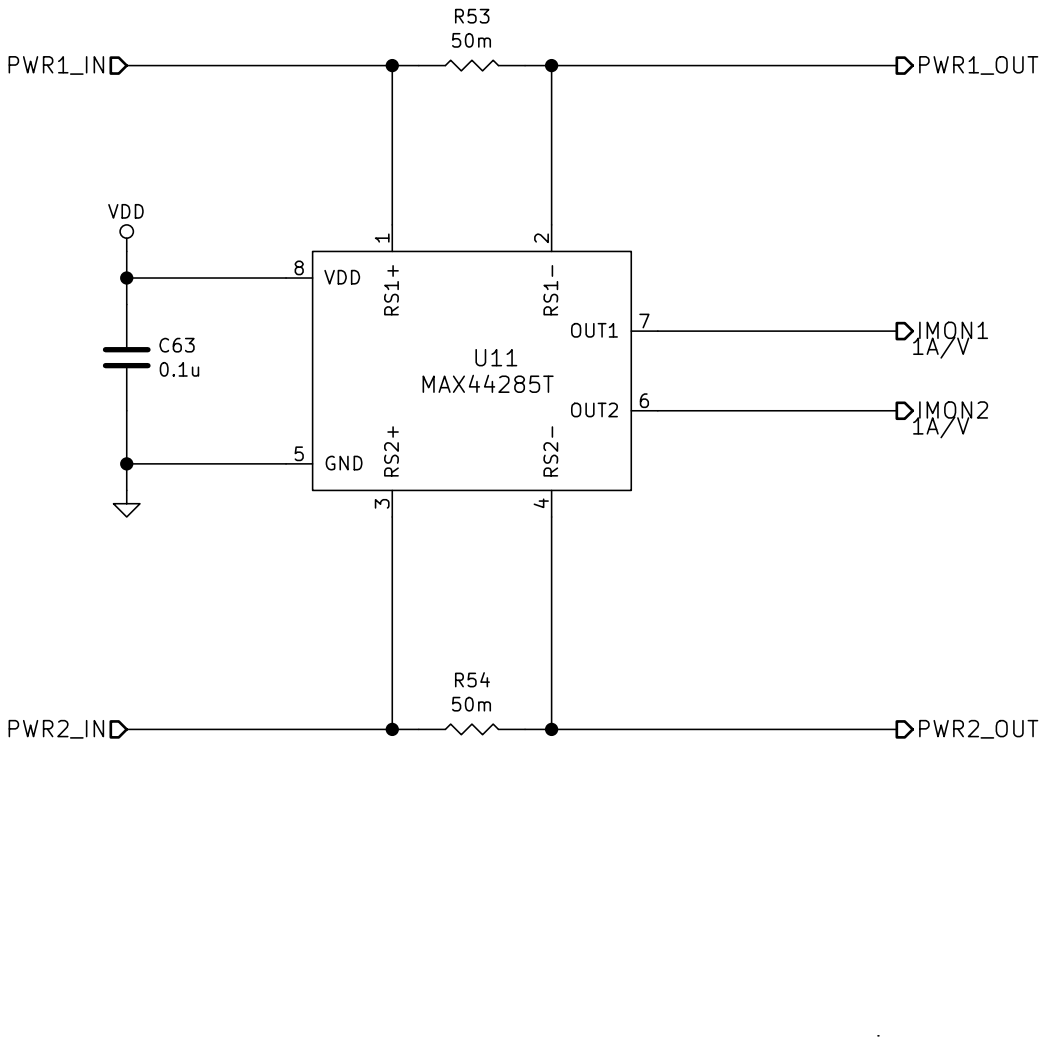
[picture p46: page 14]

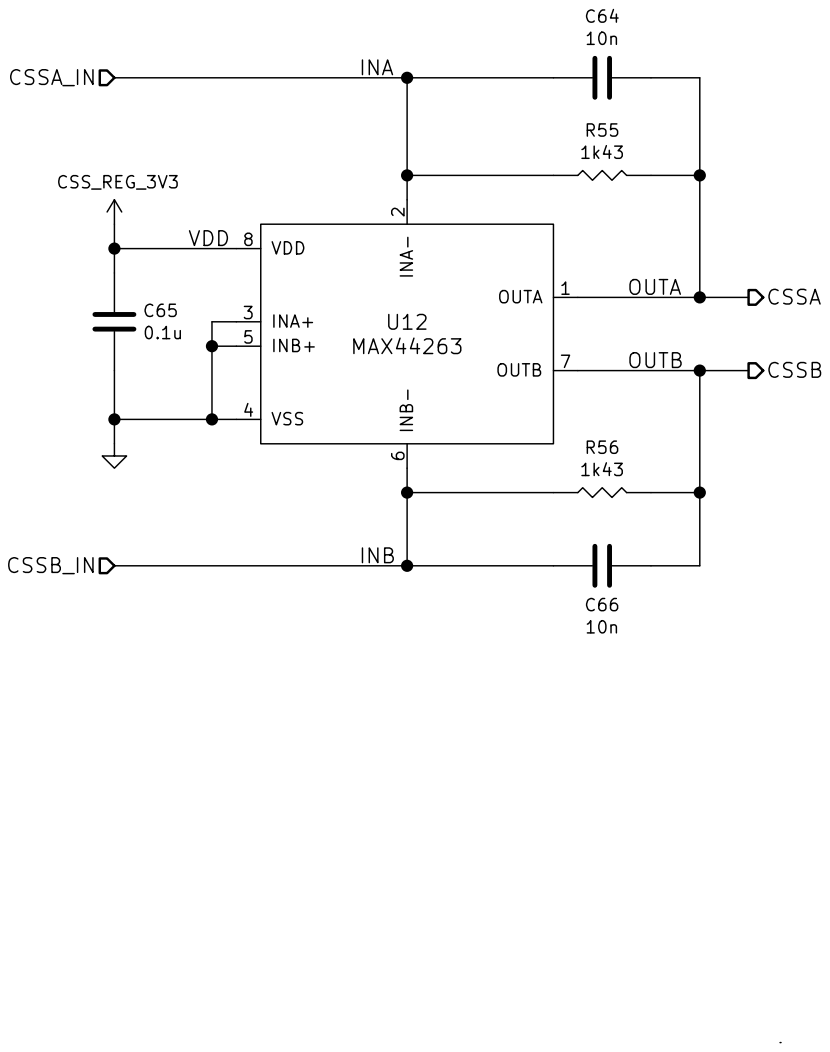
[picture p47: page 15]

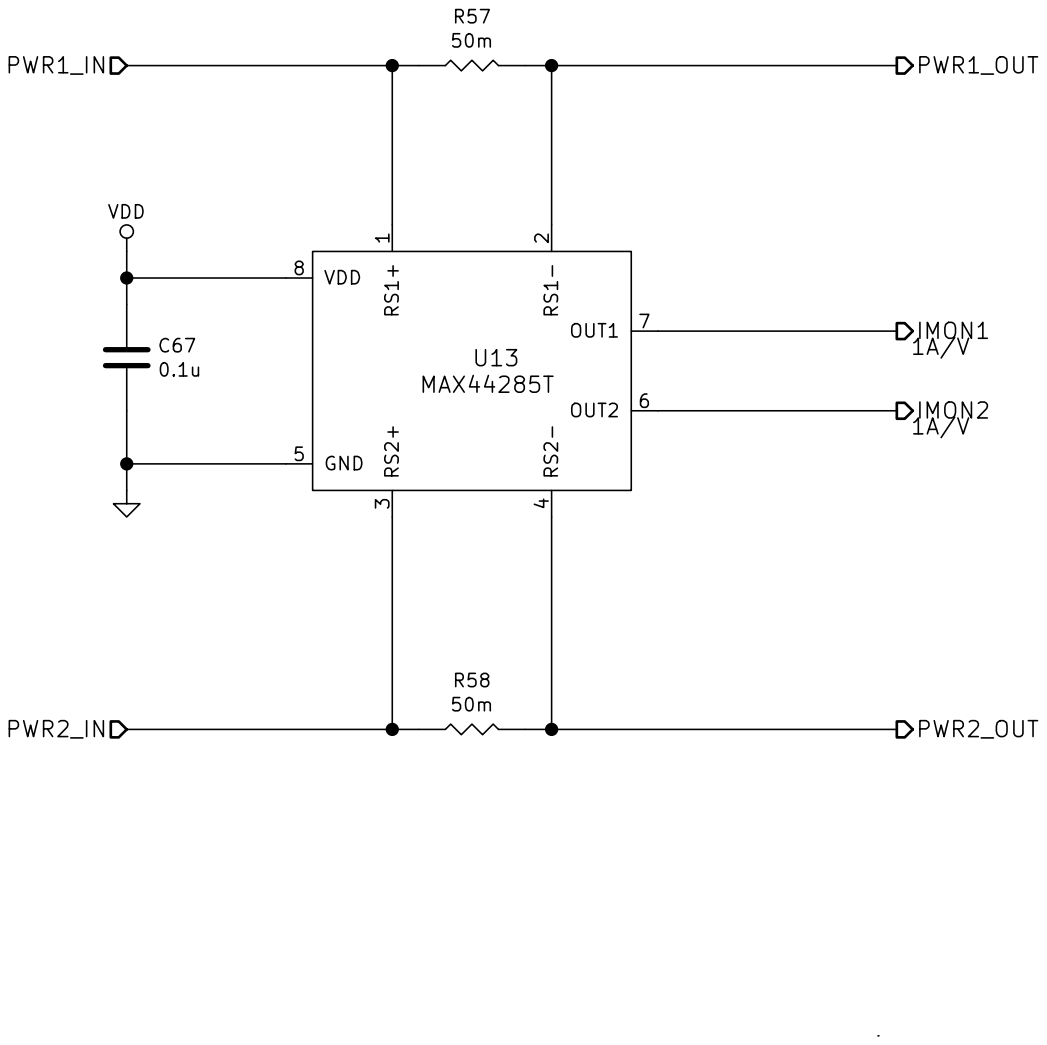
[picture p48: page 16]

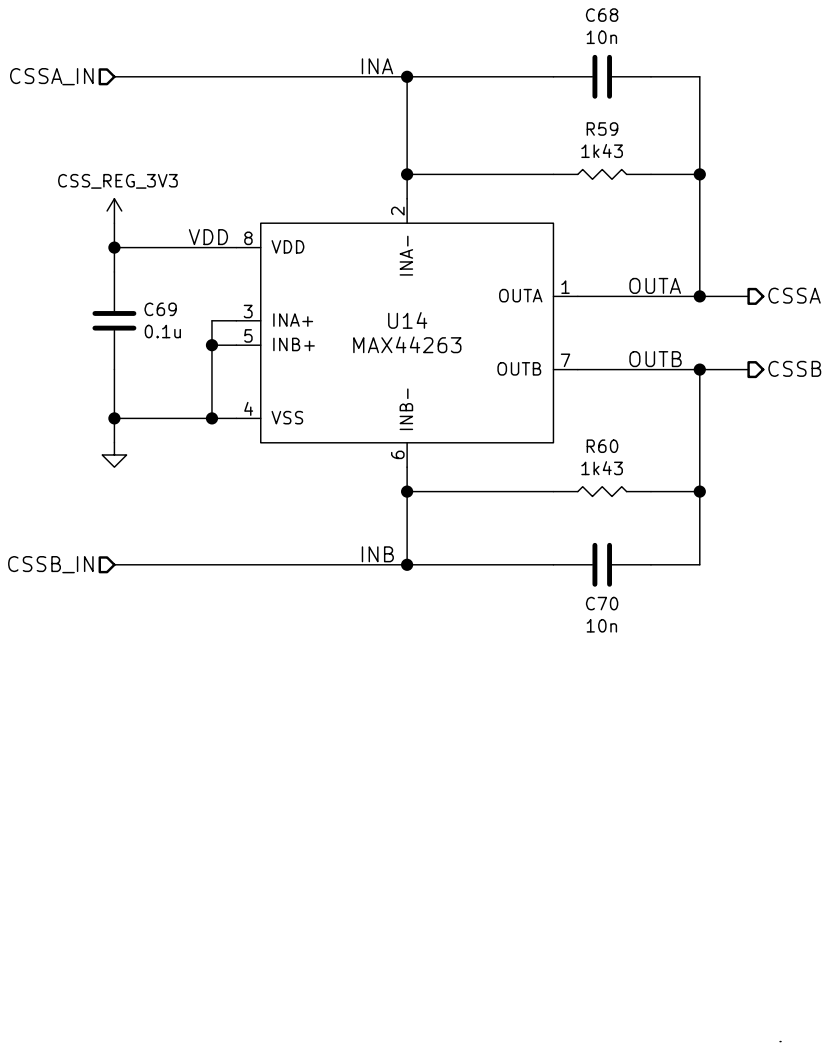
[picture p49: page 17]

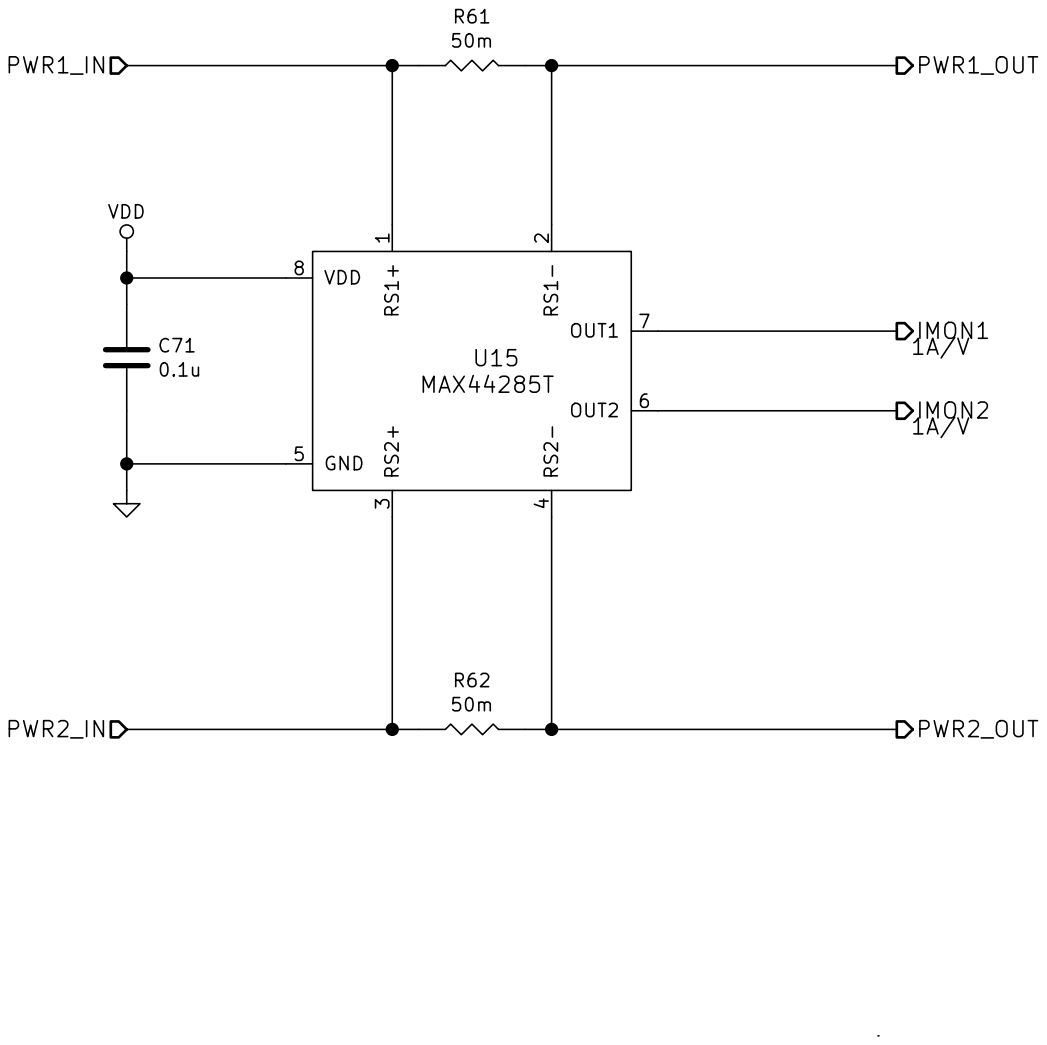
[picture p50: page 18]

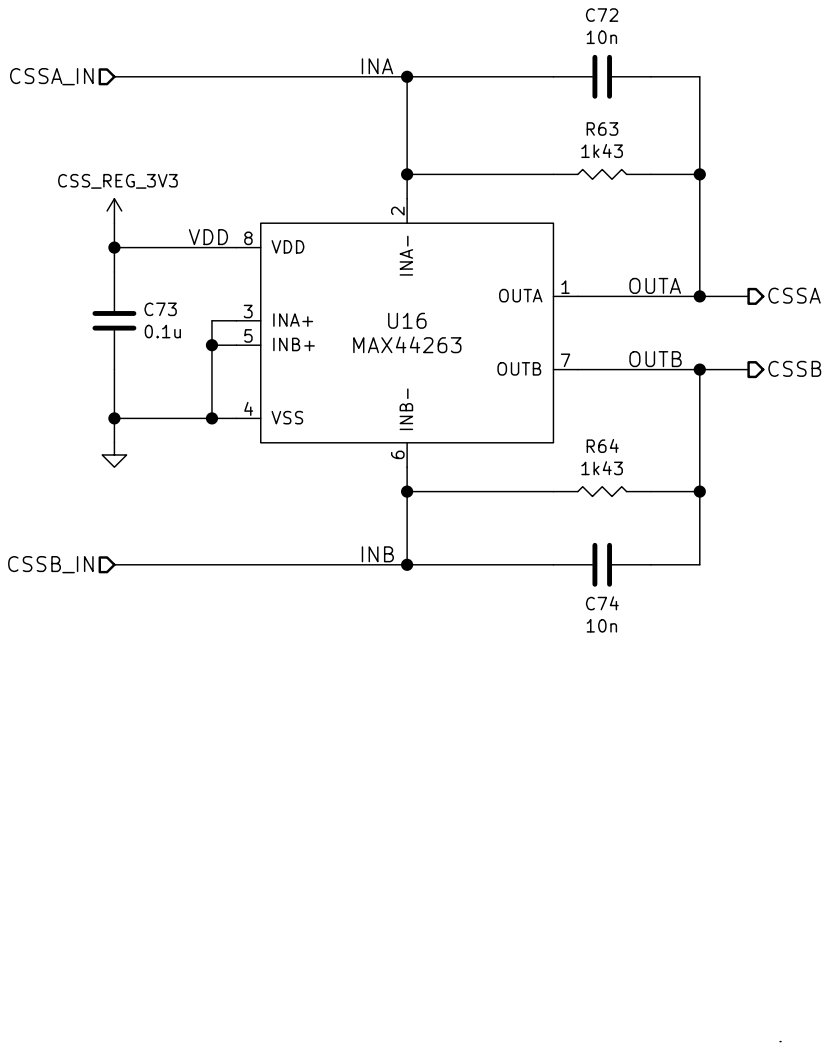
[picture p51: page 19]

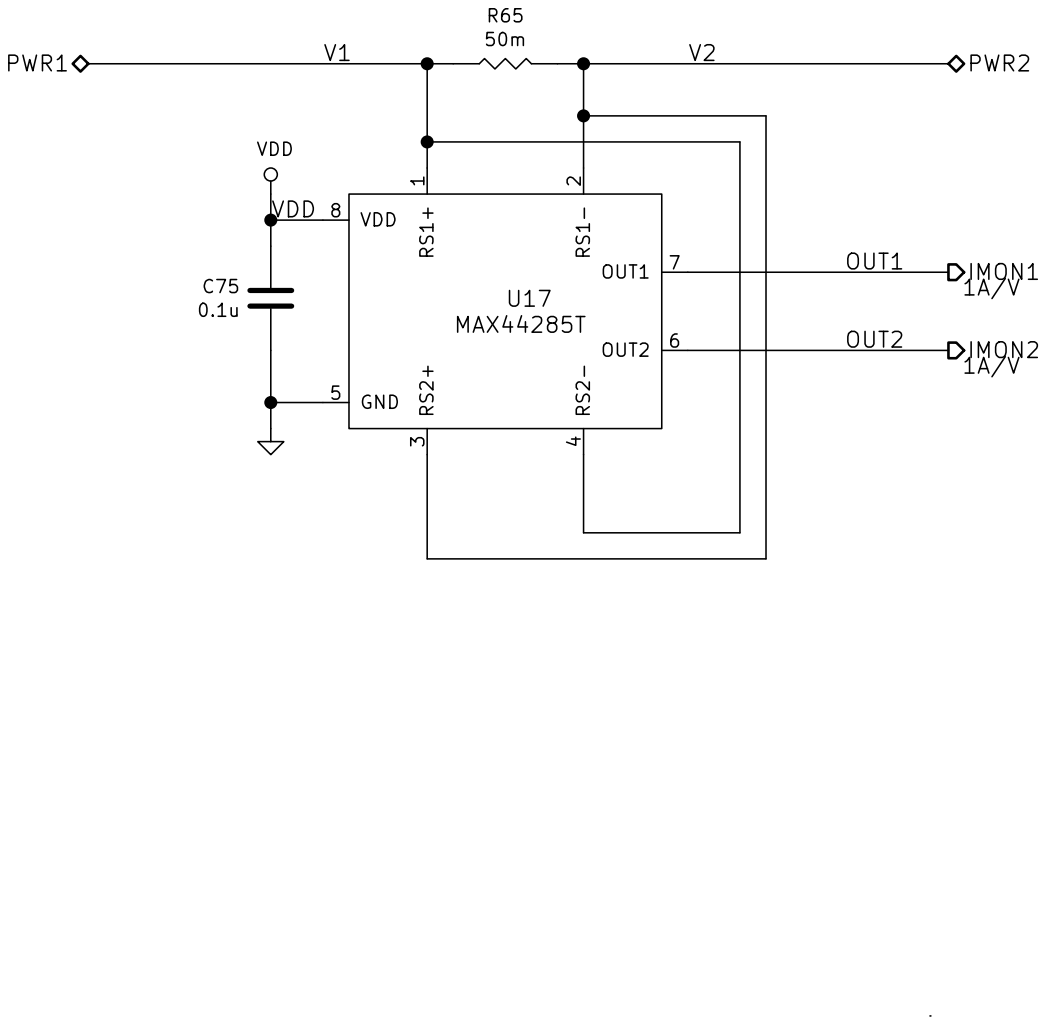
[picture p52: page 20]

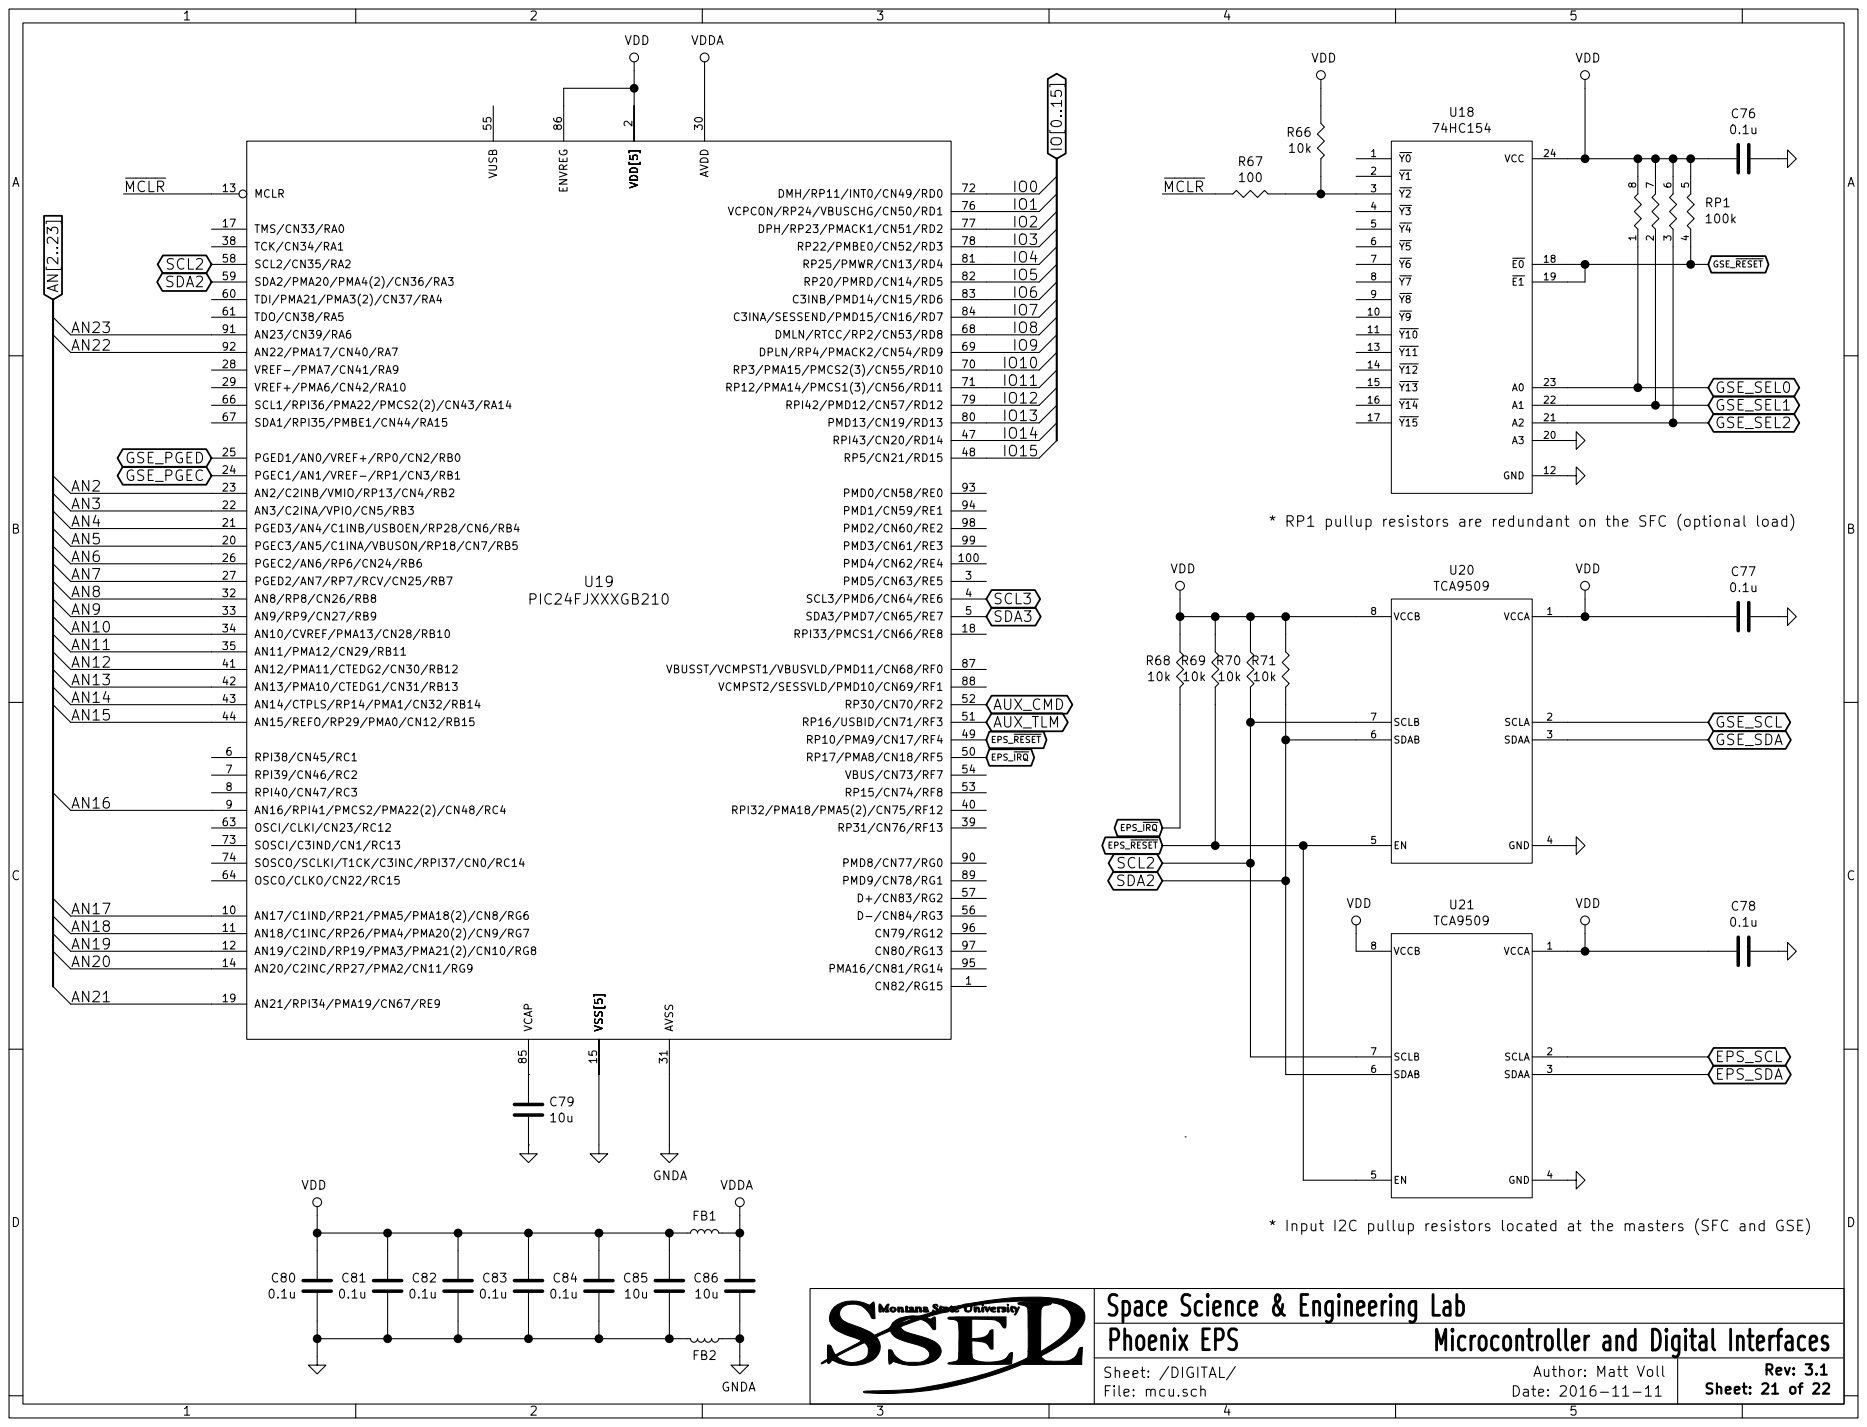
[picture p53: page 21]

* RP1 pullup resistors are redundant on the SFC (optional load)

* Input I2C pullup resistors located at the masters (SFC and GSE)

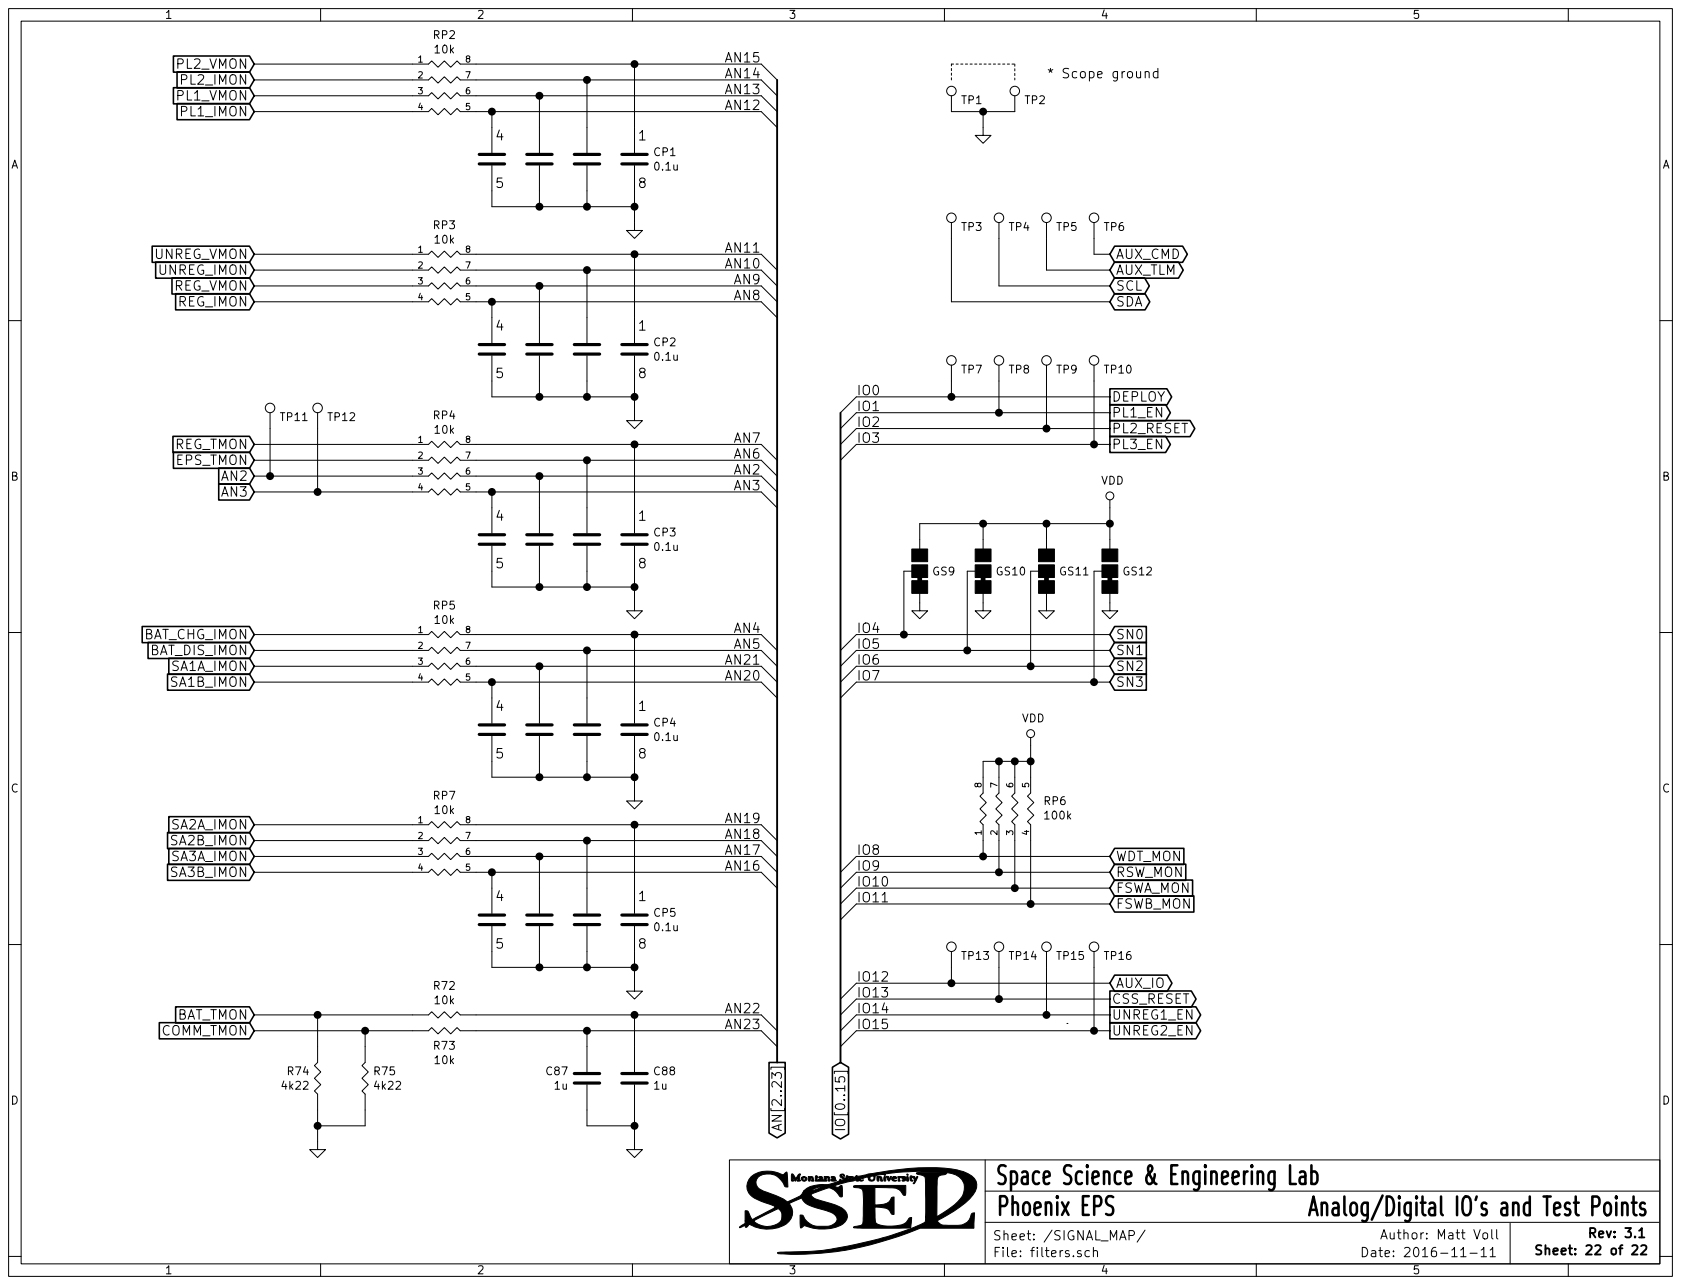
[picture p54: page 22]

IO1
IO2

IO5
IO6

IO9
IO10

IO13
IO14
