mattyv06/thesis/figs/phoenix/concept/eps_basic.pdf

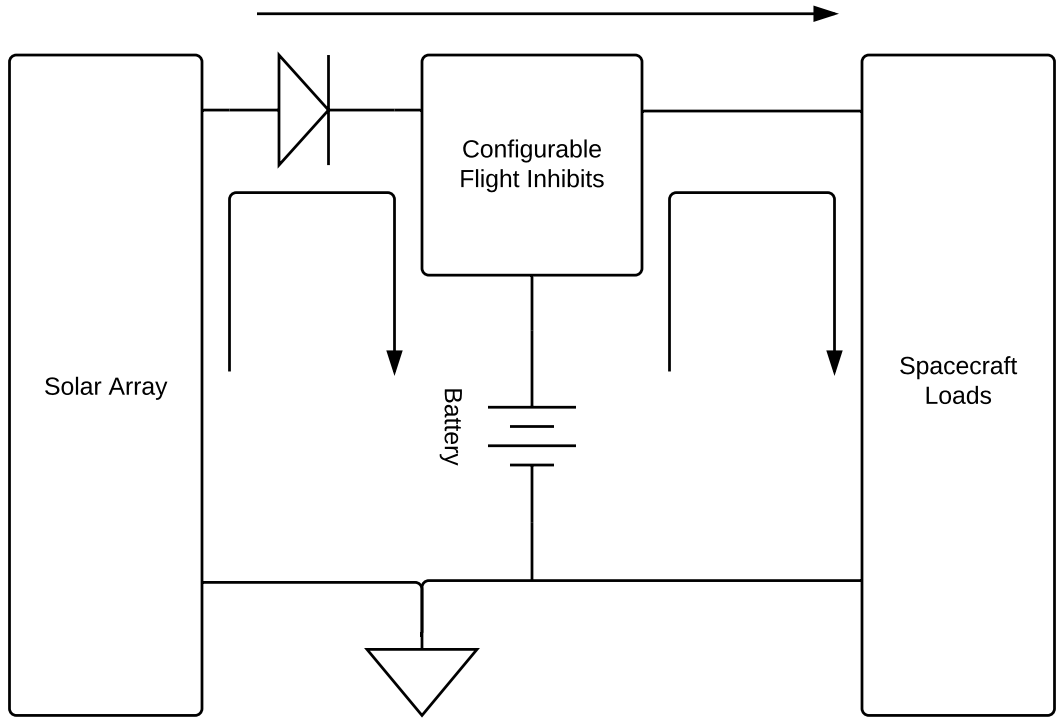
[picture p55: page 1]
ola; Battery; fig; ble; Flig; hibit
