mattyv06/thesis/figs/egse/manufacturing/egse_layout.pdf

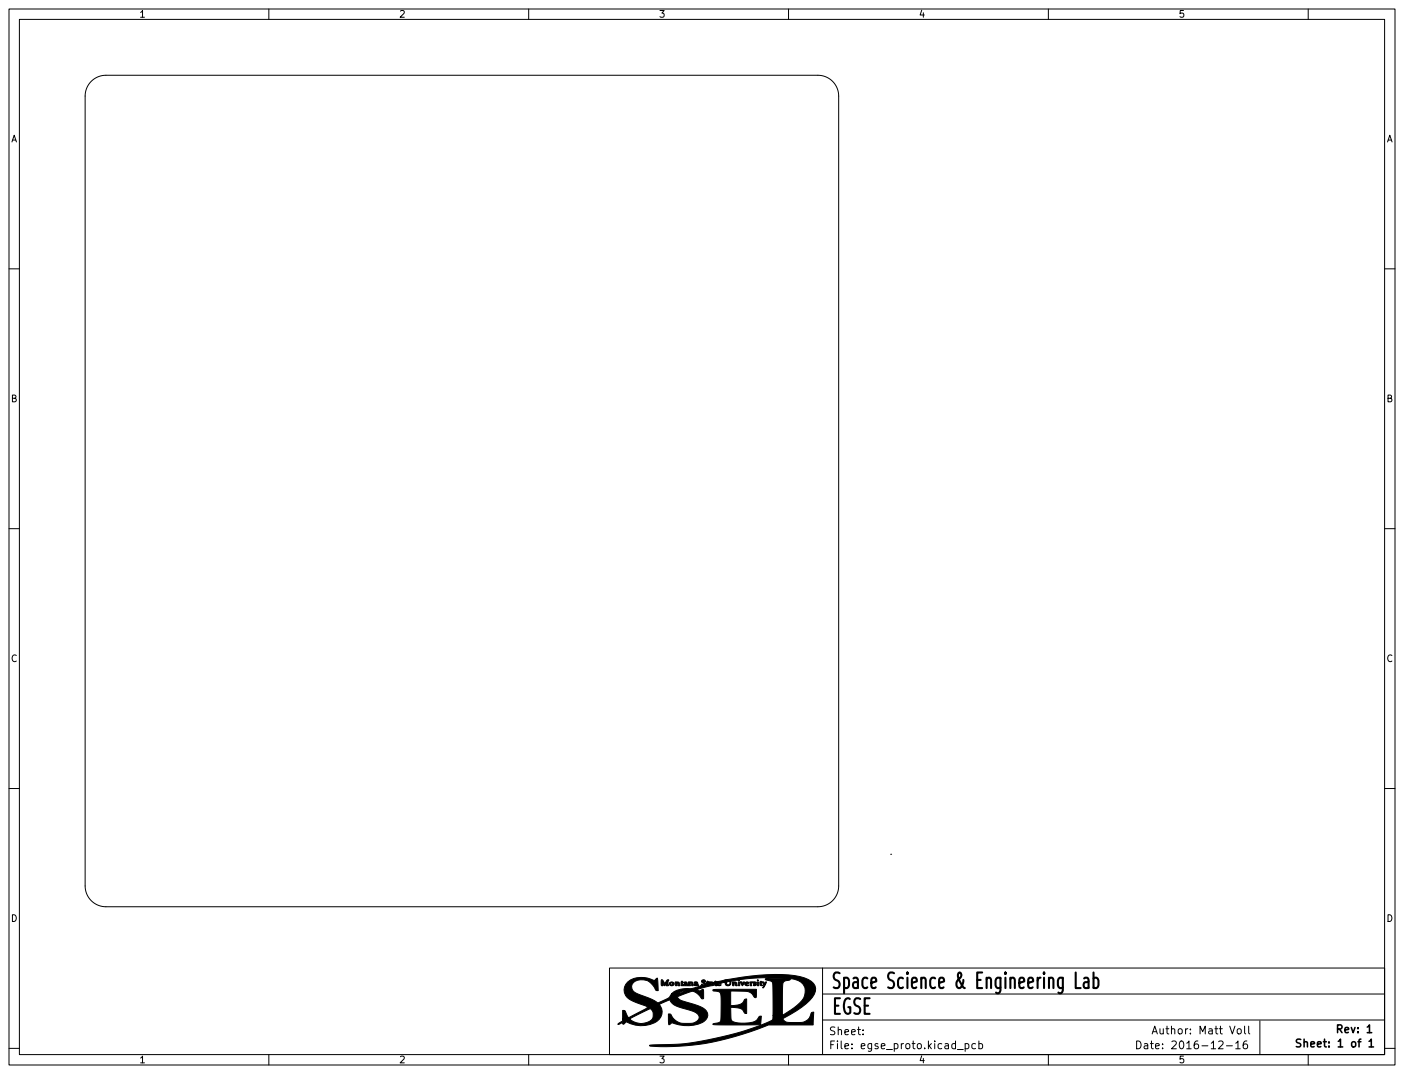
[picture p56: page 1]
Date: 2016-12-16; Sheet: 1 of 1; Rev: 1; Space Science &; Engineering Lab; EGSE; File: egse_proto.kicad_pcb; Sheet:

Author: Matt Voll

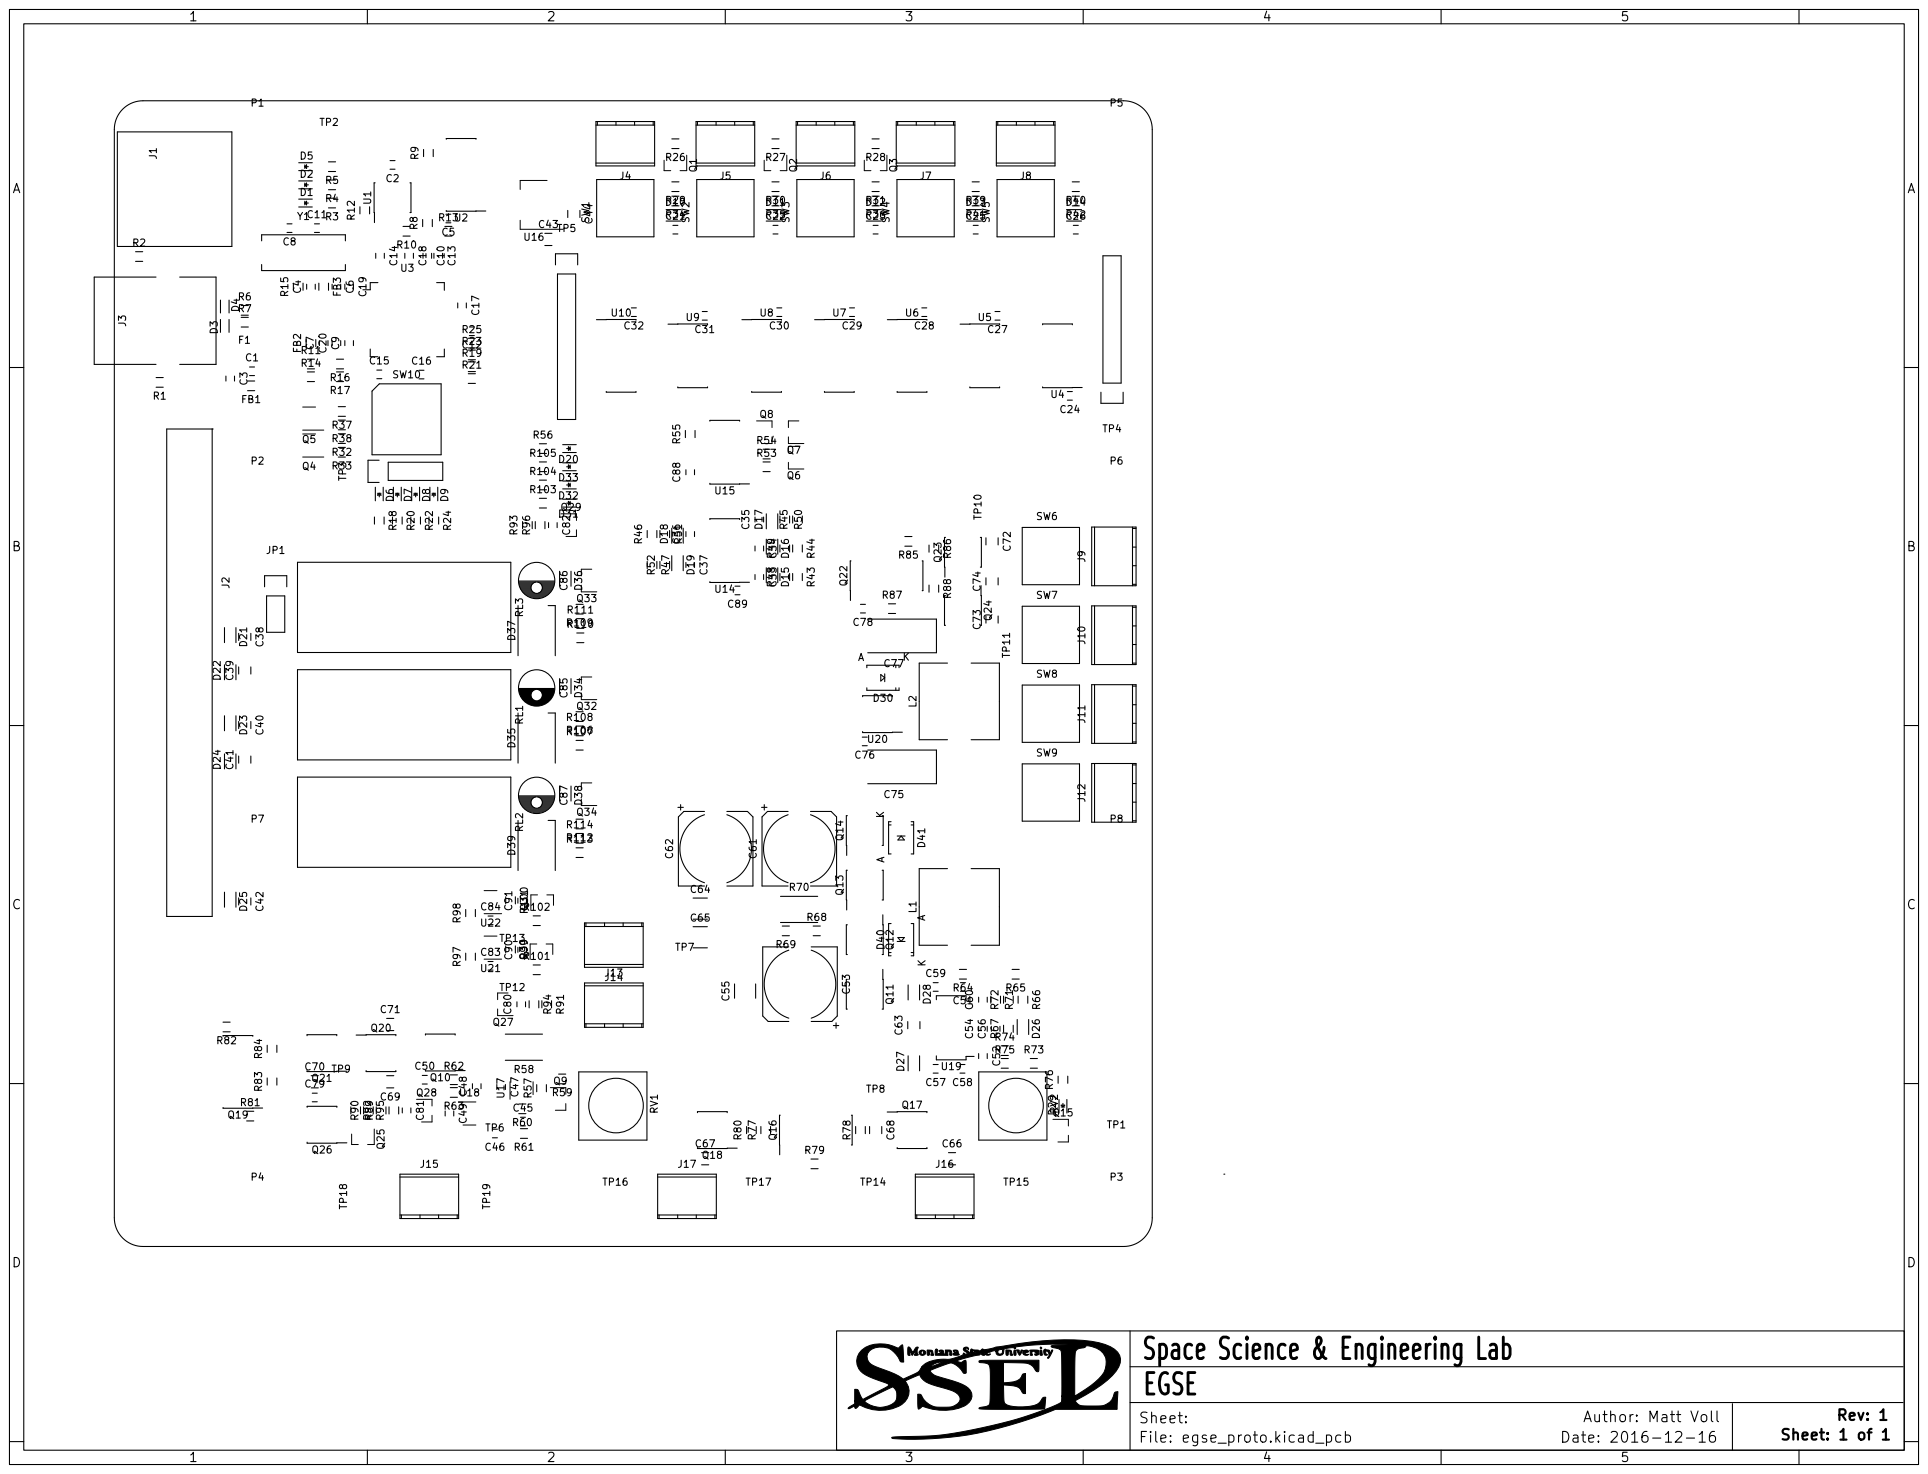
[picture p57: page 2]

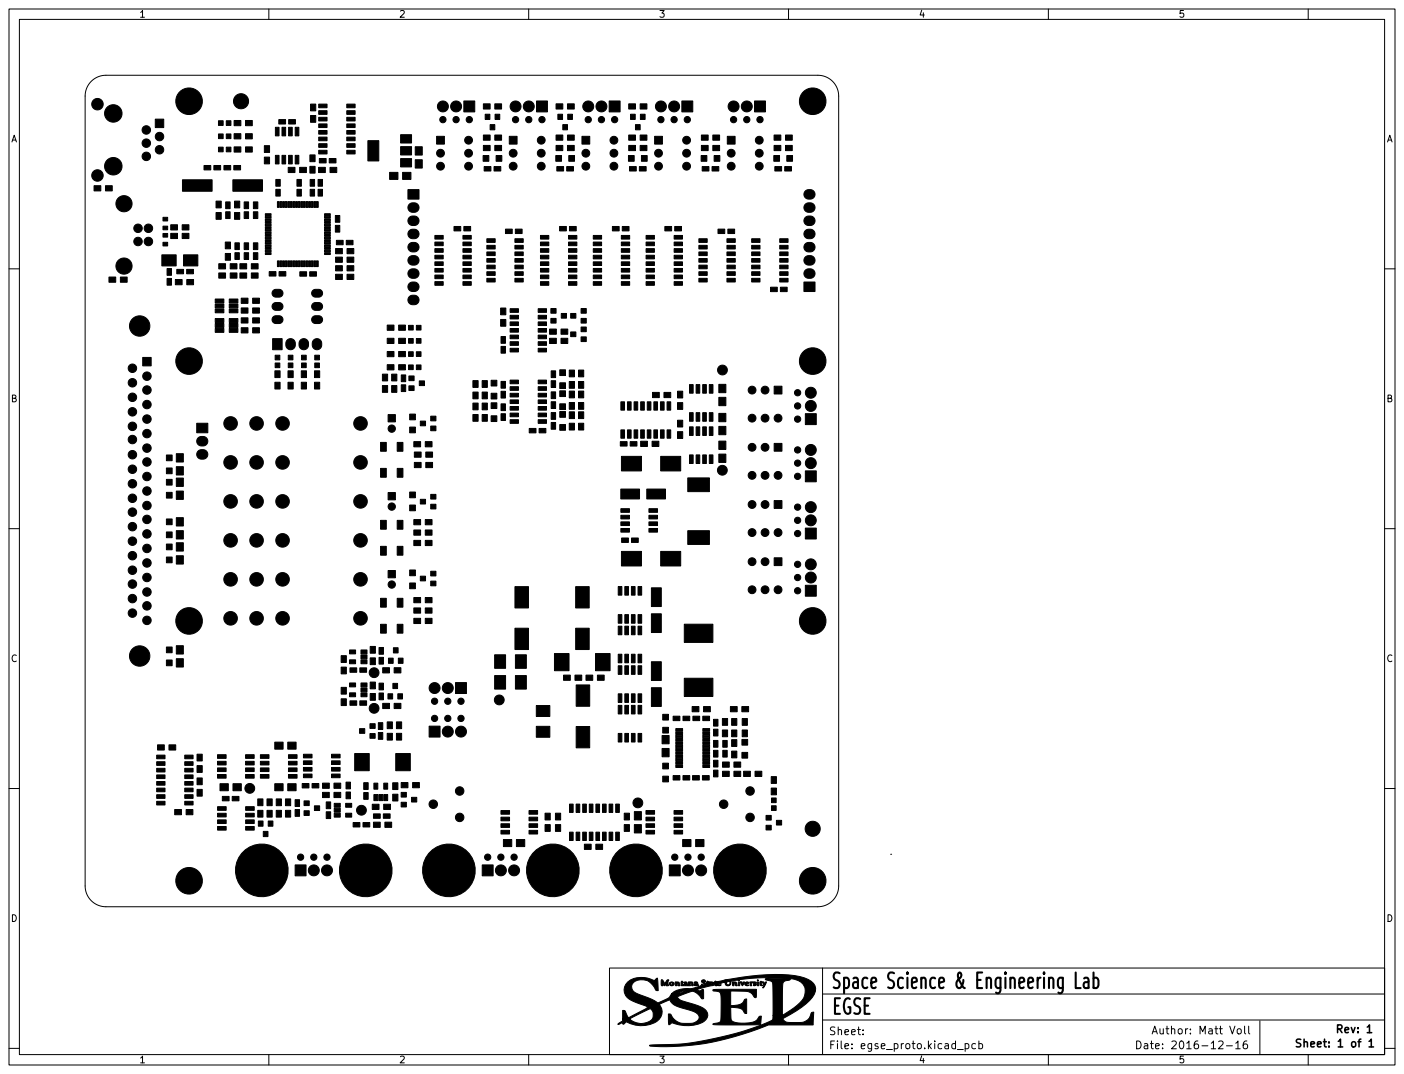
[picture p58: page 3]
Space Science &; Engineering Lab

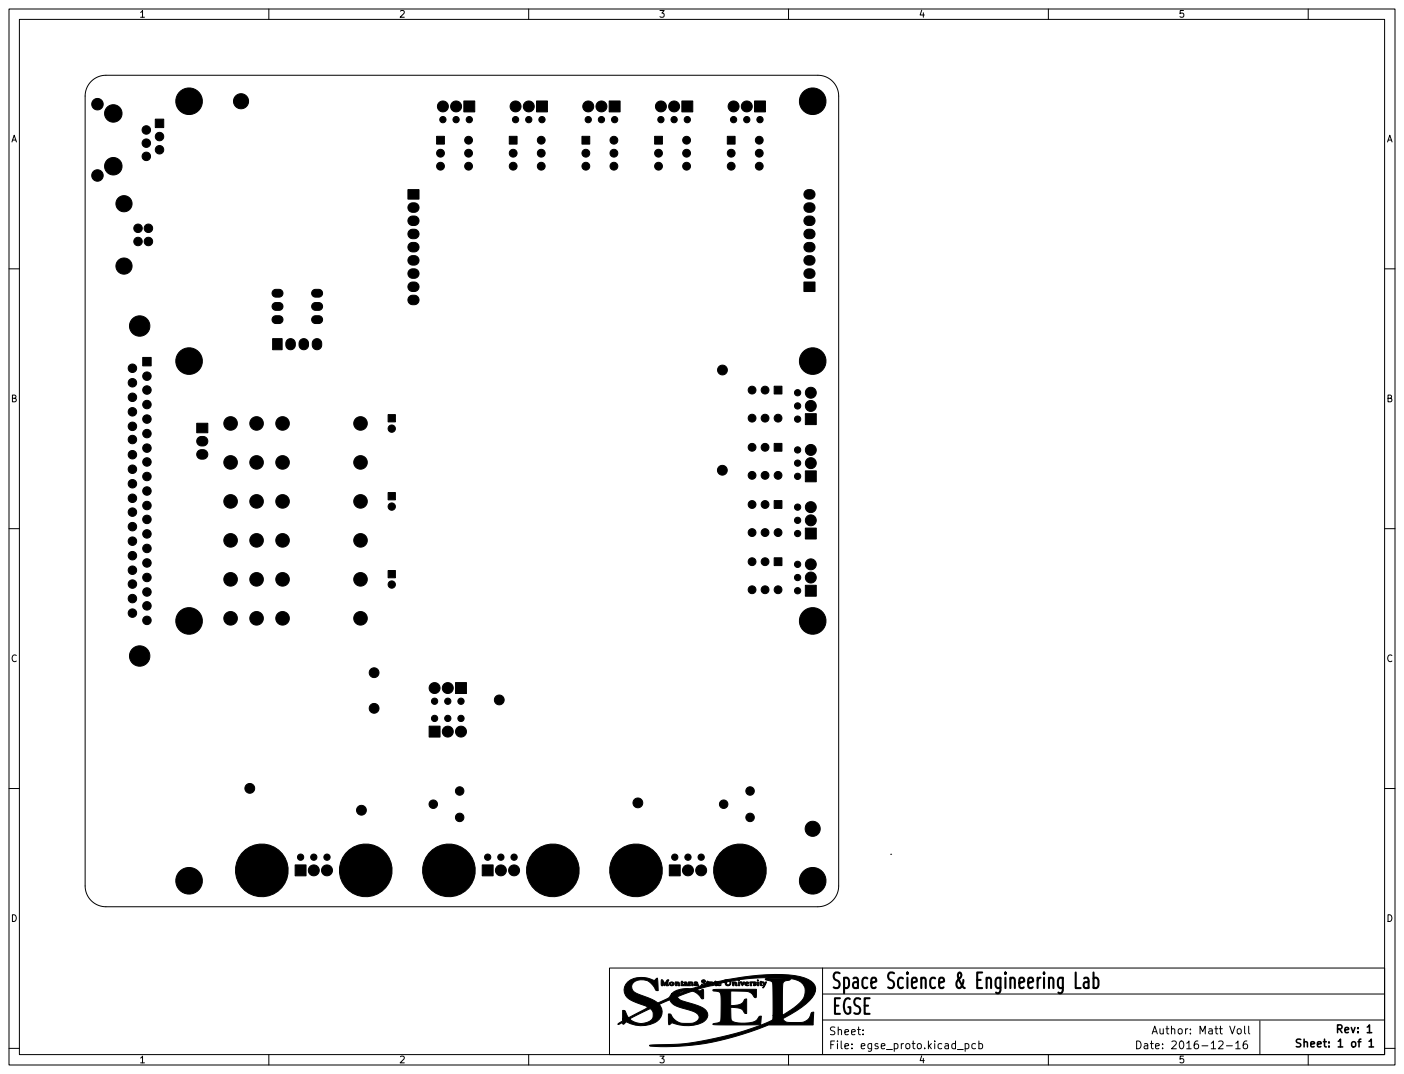
[picture p59: page 4]
Space Science &; Engineering Lab

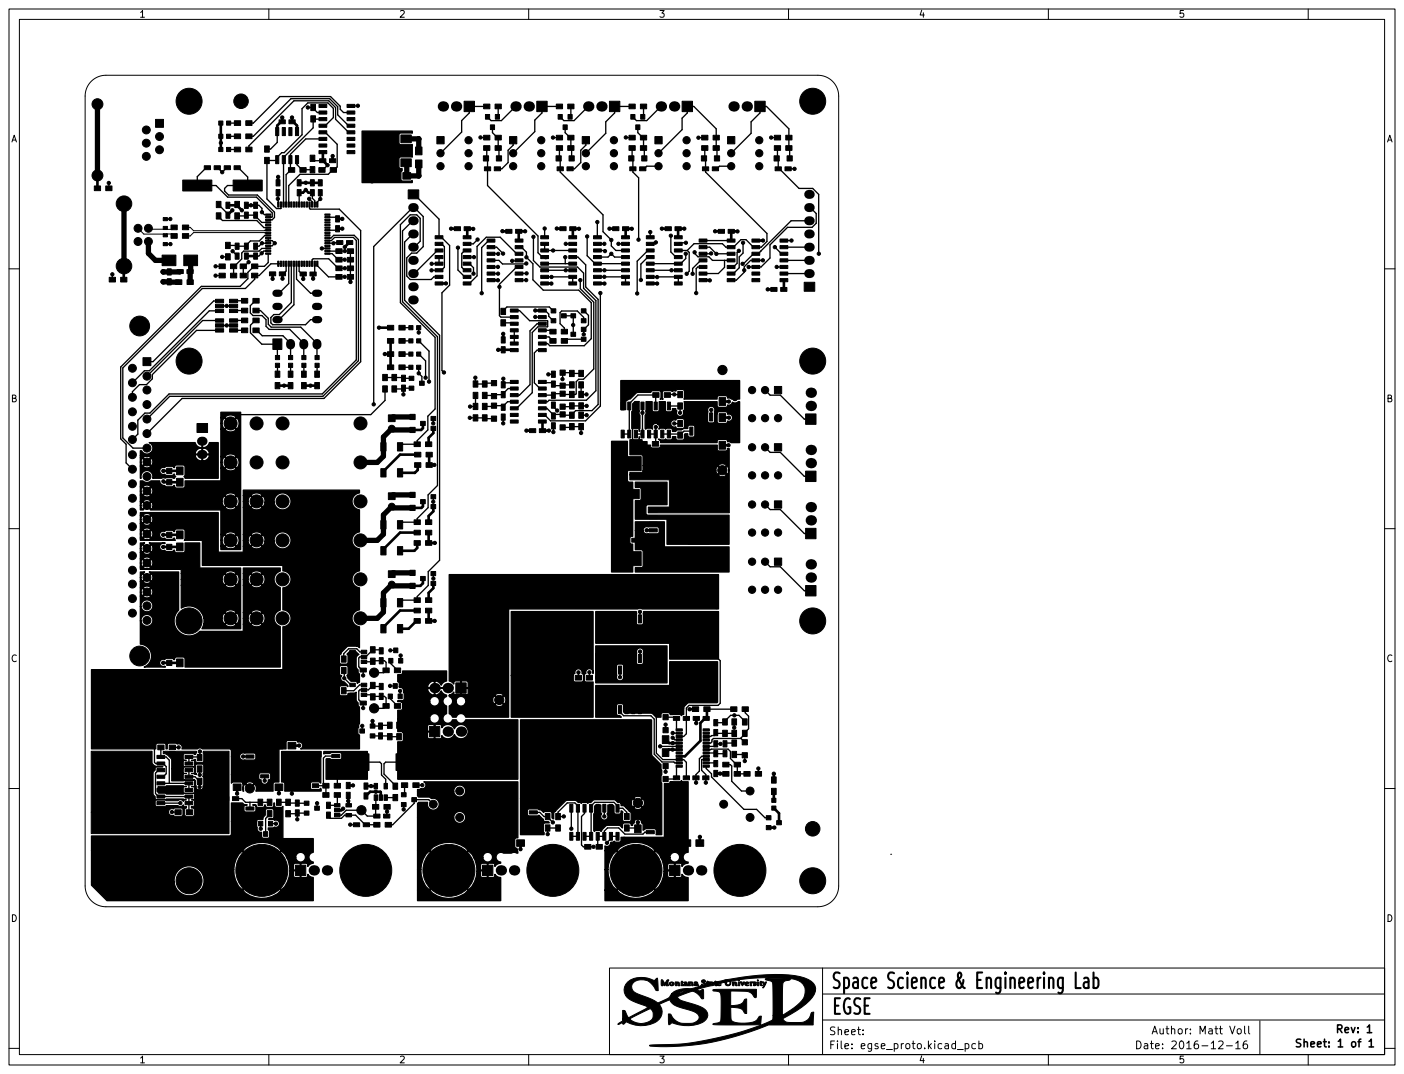
[picture p60: page 5]
Space Science &; Engineering Lab

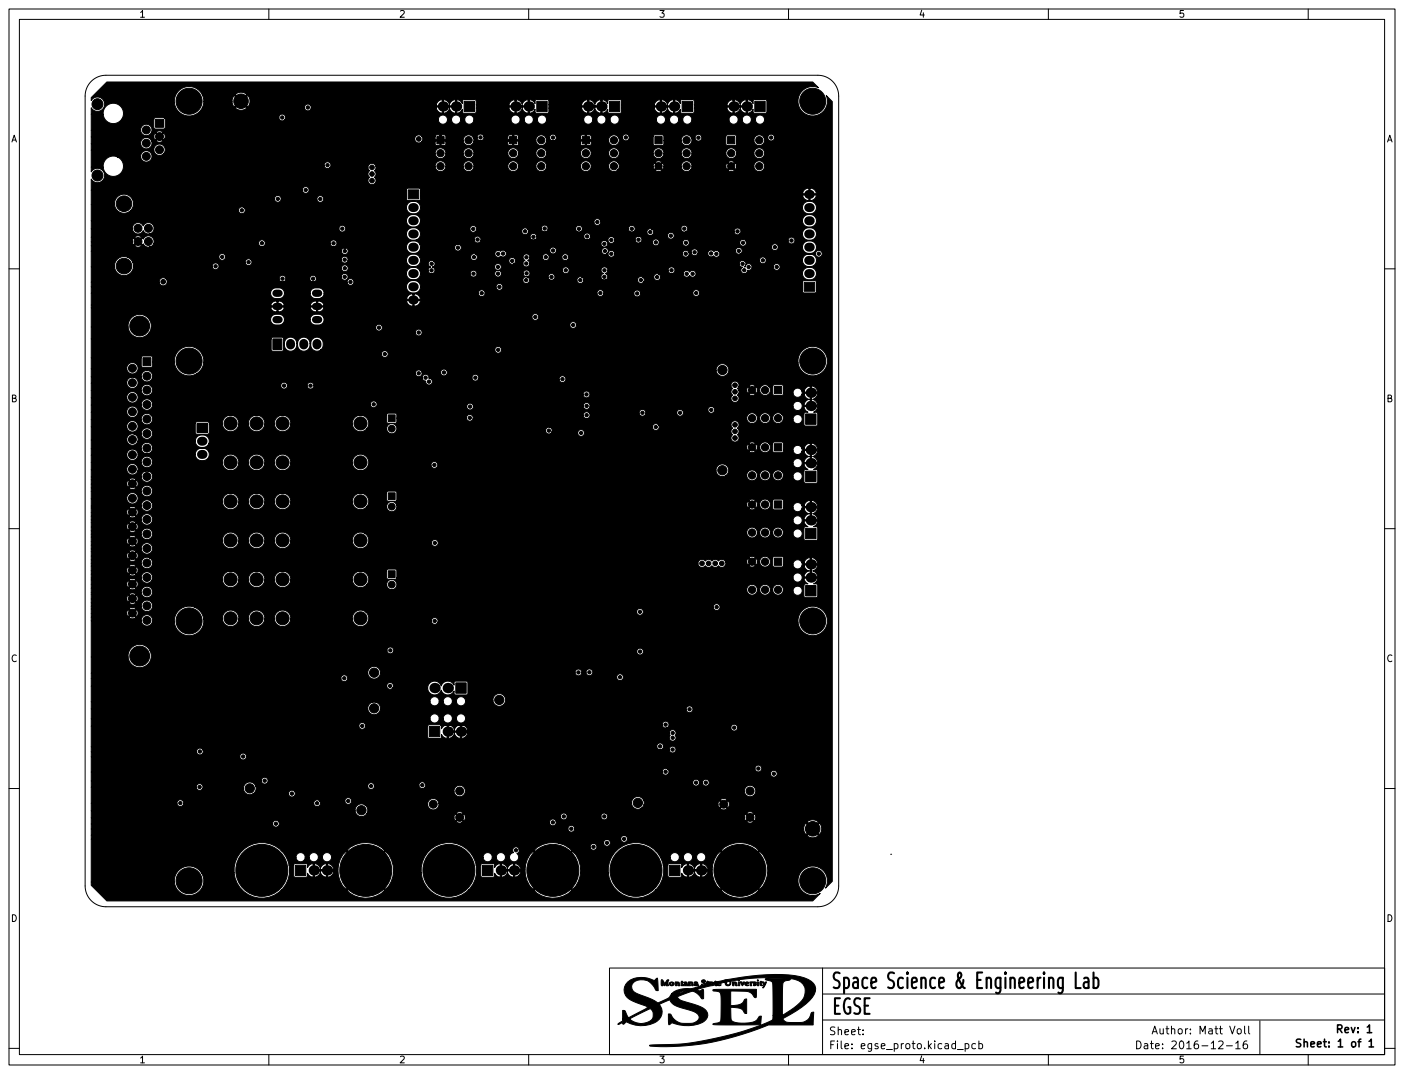
[picture p61: page 6]
Space Science &; Engineering Lab

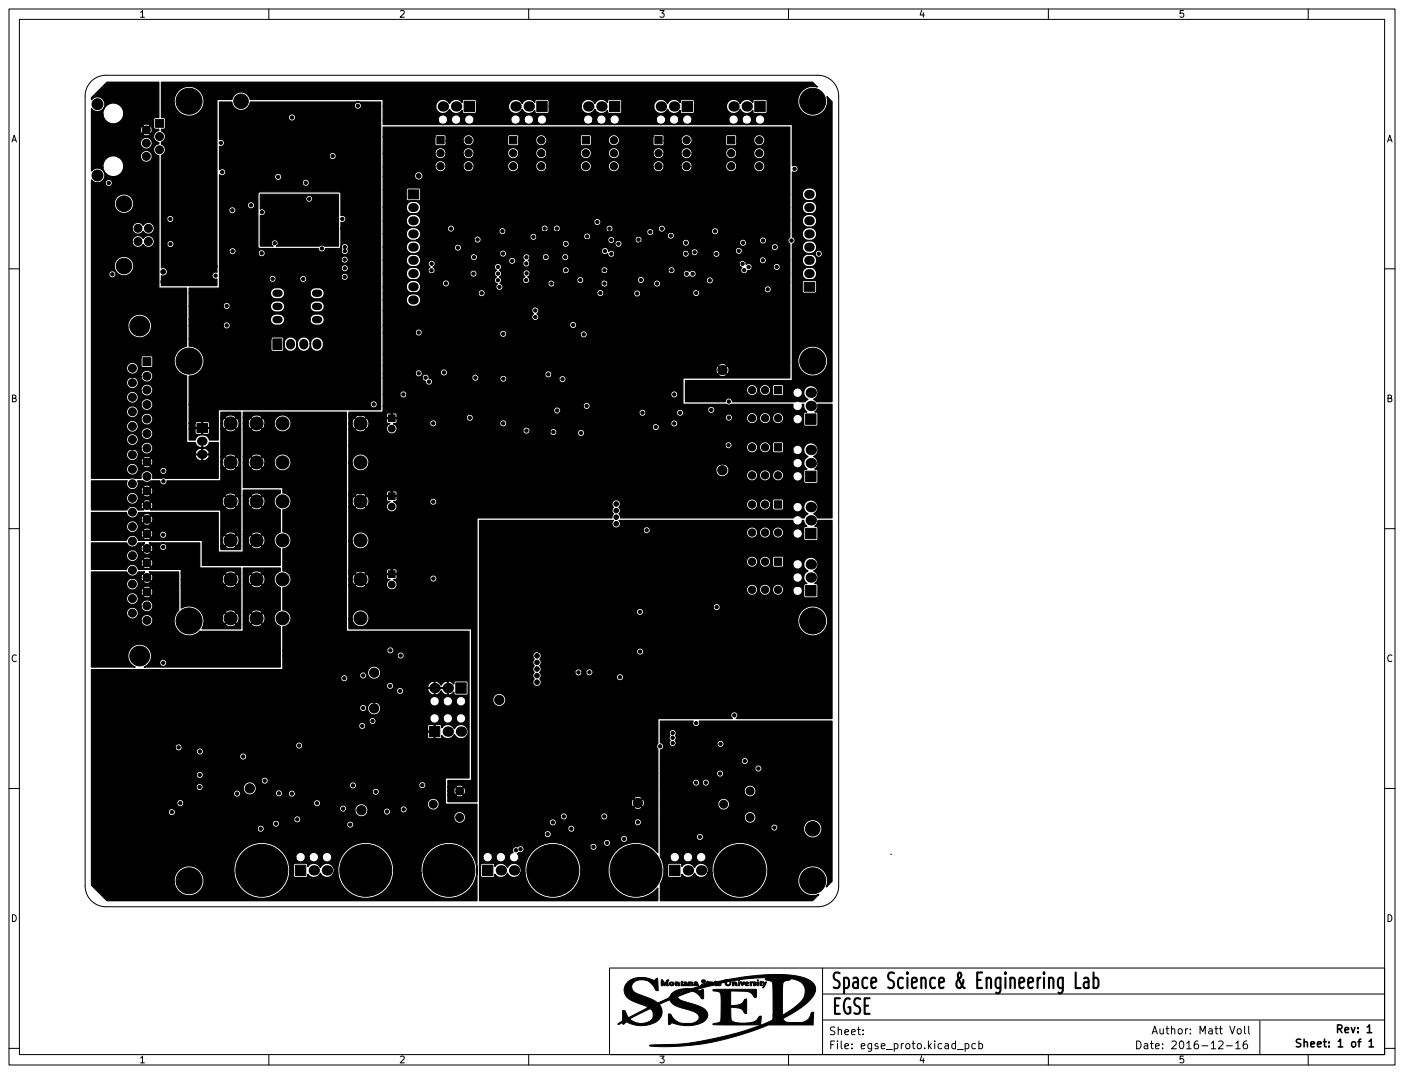
[picture p62: page 7]
Space Science &; Engineering Lab

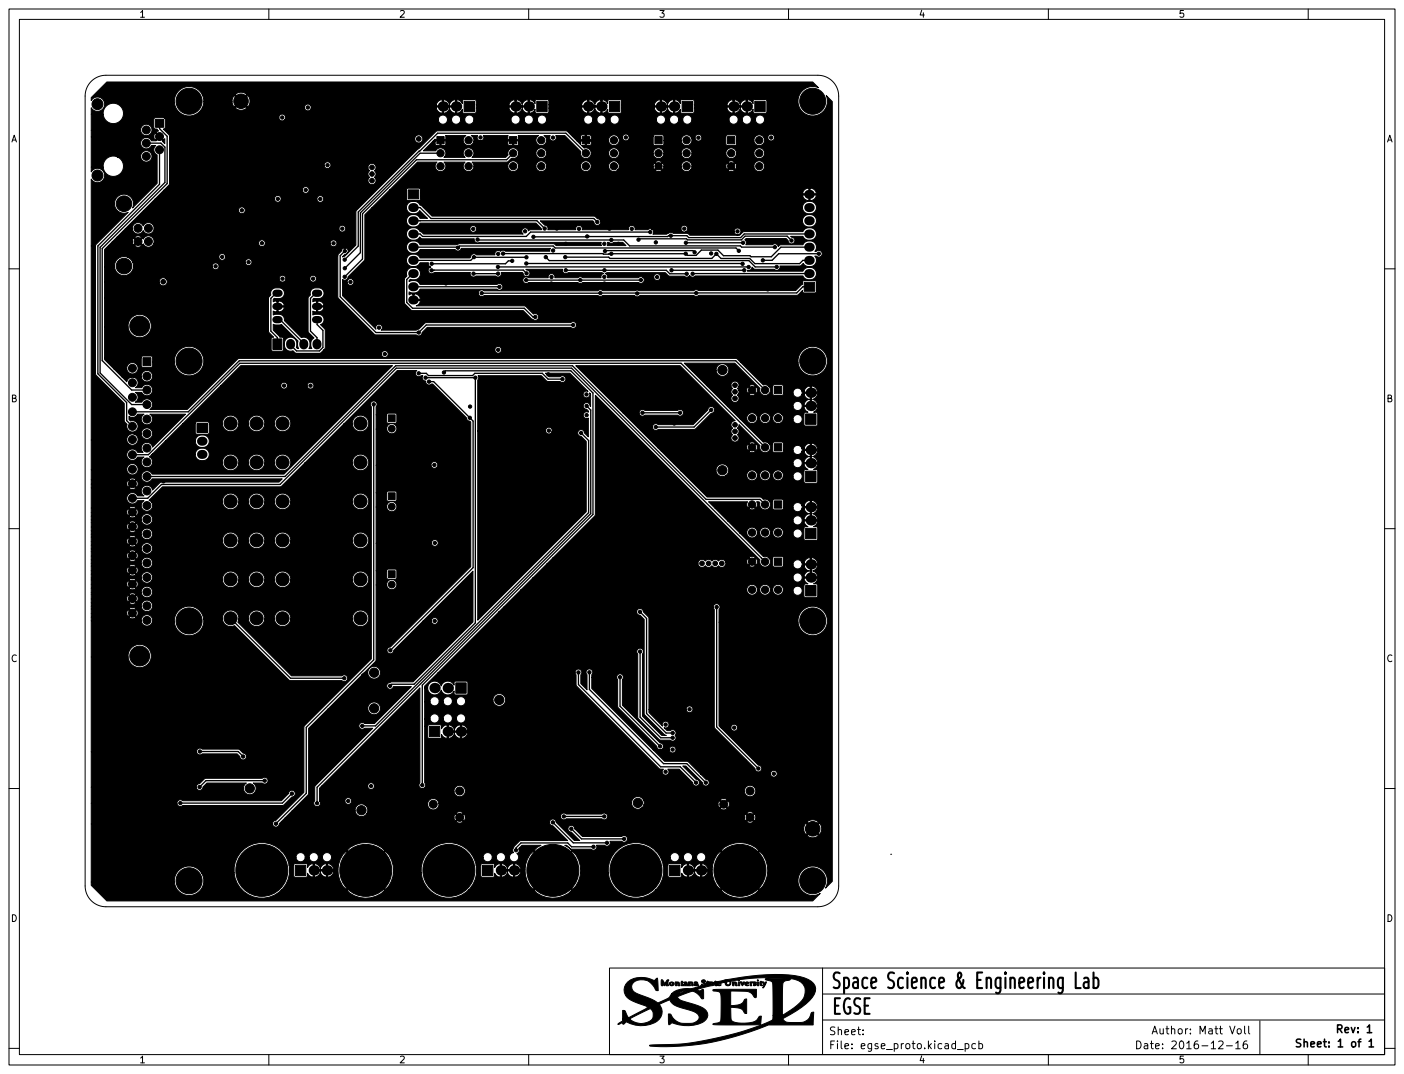
[picture p63: page 8]
Space Science &; Engineering Lab

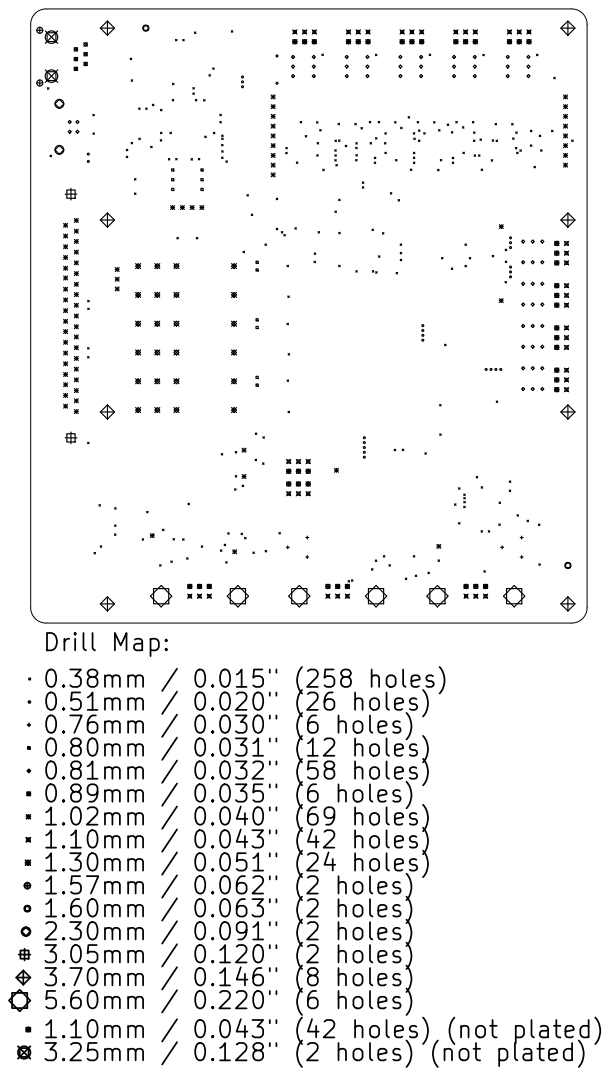
[picture p64: page 9]
Drill Map:; 0.38mm / 0.015" (258 holes) 0.51mm / 0.020" (26 holes) 0.76mm / 0.030" (6 holes) 0.80mm / 0.031" (12 holes) 0.81mm / 0.032" (58 holes) 0.89mm / 0.035" (6 holes) 1.02mm / 0.040" (69 holes) 1.10mm / 0.043" (42 holes) 1.30mm / 0.051" (24 holes) 1.57mm / 0.062" (2 holes) 1.60mm / 0.063" (2 holes) 2.30mm / 0.091" (2 holes) 3.05mm / 0.120" (2 holes) 3.70mm / 0.146" (8 holes) 5.60mm / 0.220" (6 holes) 1.10mm / 0.043" (42 holes) (not plated) 3.25mm / 0.128" (2 holes) (not plated)
