mattyv06/thesis/figs/egse/schematic/egse_rev1.pdf

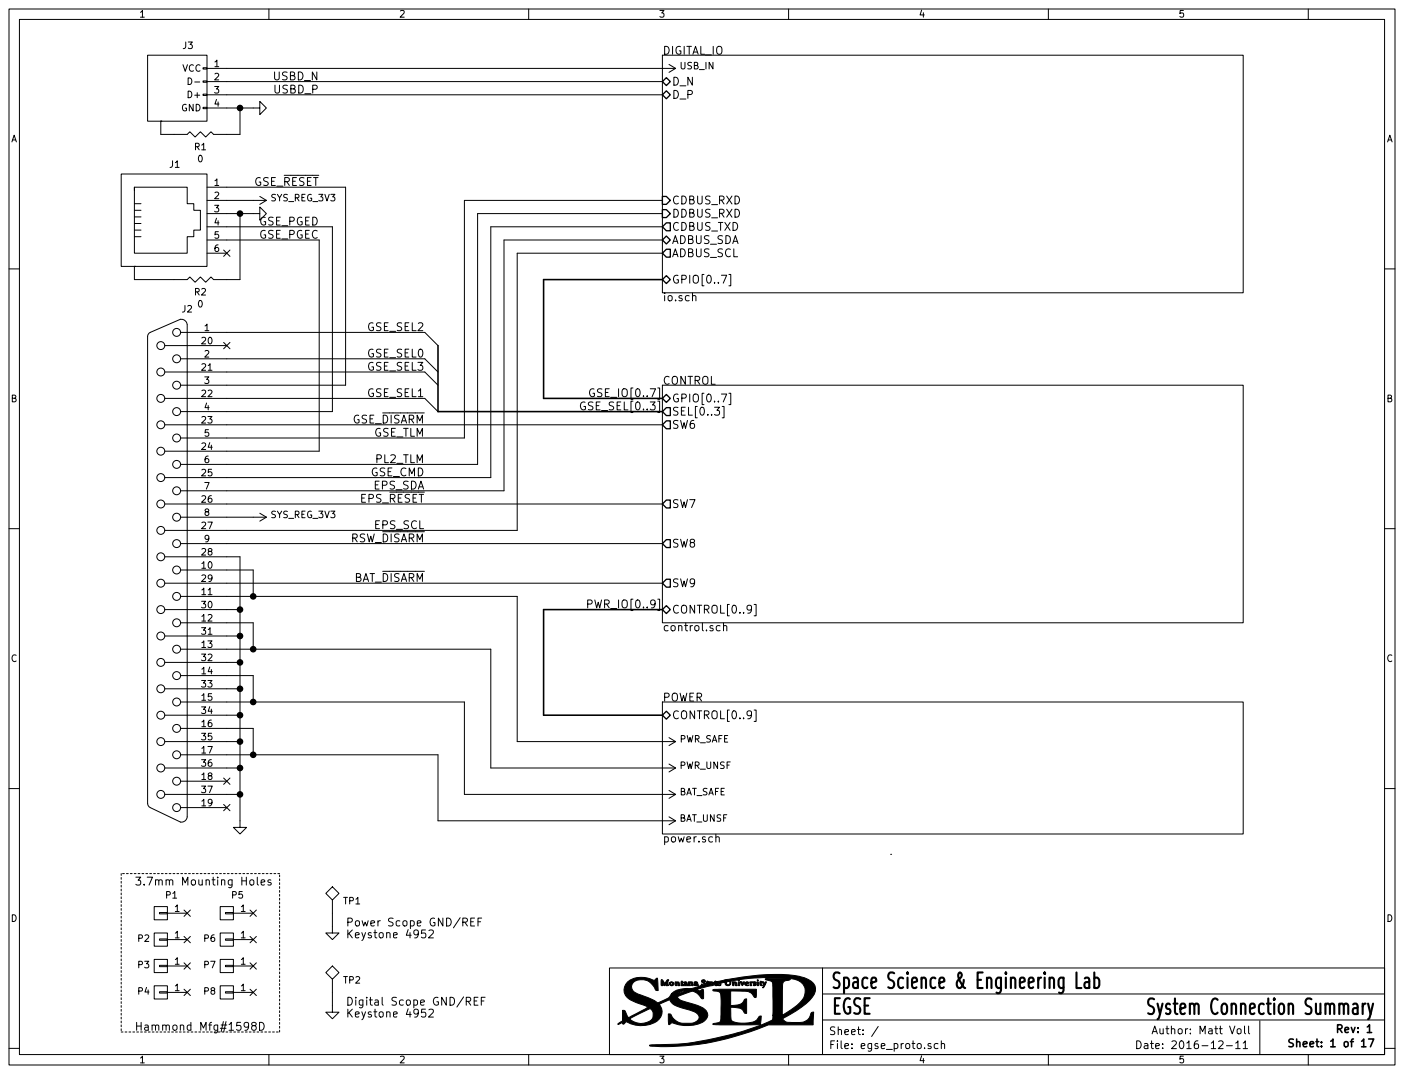
[picture p65: page 1]

21 | GSE_SEL3
3 | GSE_SEL1

26 | EPS_RESET

29
11
30

Digital Scope GND/REF
Keystone 4952

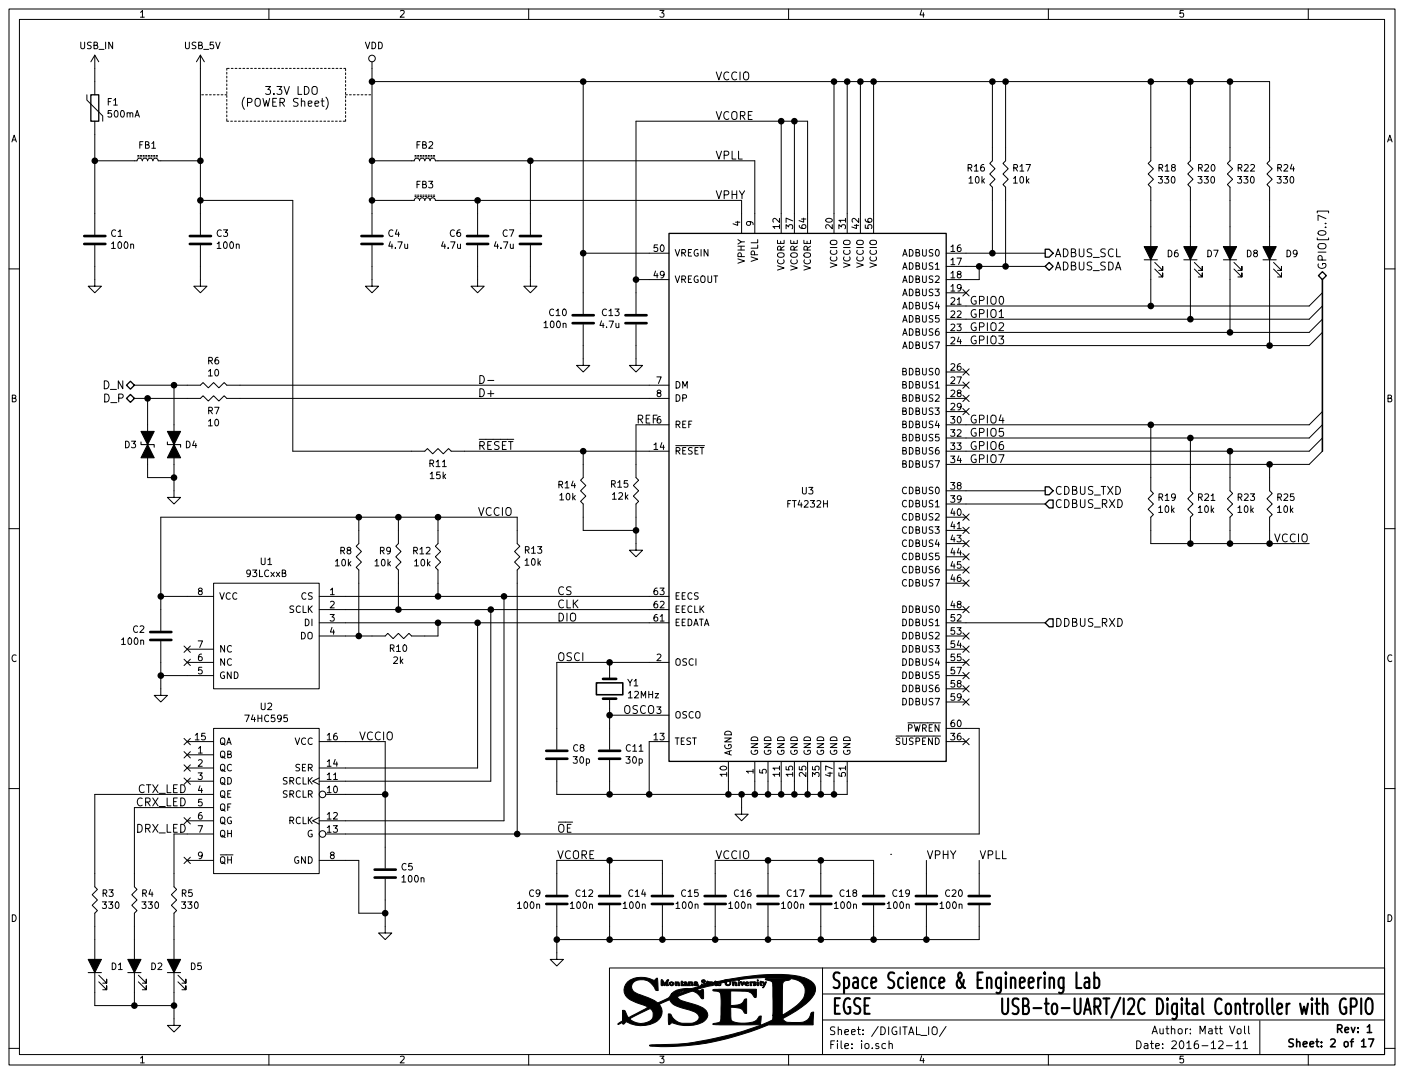
[picture p66: page 2]

9 AGND 10 VCCIO 20 BDBUS4 30 CDBUS2 40 VREGIN 50 PWREN 60 GND 11 ADBUS4 21 VCCIO 31 CDBUS3 41 GND 51 EEDATA 61 VCORE 12 ADBUS5 22 BDBUS5 32 VCCIO 42 DDBUS1 52 EECLK 62 TEST 13 ADBUS6 23 BDBUS6 33 CDBUS4 43 DDBUS2 53 EECS 63 RESET 14 ADBUS7 24 BDBUS7 34 CDBUS5 44 DDBUS3 54 VCORE 64 GND 15 GND 25 GND 35 CDBUS6 45 DDBUS4 55 ADBUS0 16 BDBUS0 26 SUSPEND 36 CDBUS7 46 VCCIO 56 ADBUS1 17 BDBUS1 27 VCORE 37 GND 47 DDBUS5 57 ADBUS2 18 BDBUS2 28 CDBUS0 38 DDBUS0 48 DDBUS6 58 ADBUS3 19 BDBUS3 29 CDBUS1 39 VREGOUT 49 DDBUS7 59 U3 FT4232H ADBUS_SDA

5 REF 6 DM 7 DP 8 VPLL

GPIO2
GPIO3

GPIO6
GPIO7

CLK
DIO

File: io.sch Sheet: /DIGITAL_IO/ GND

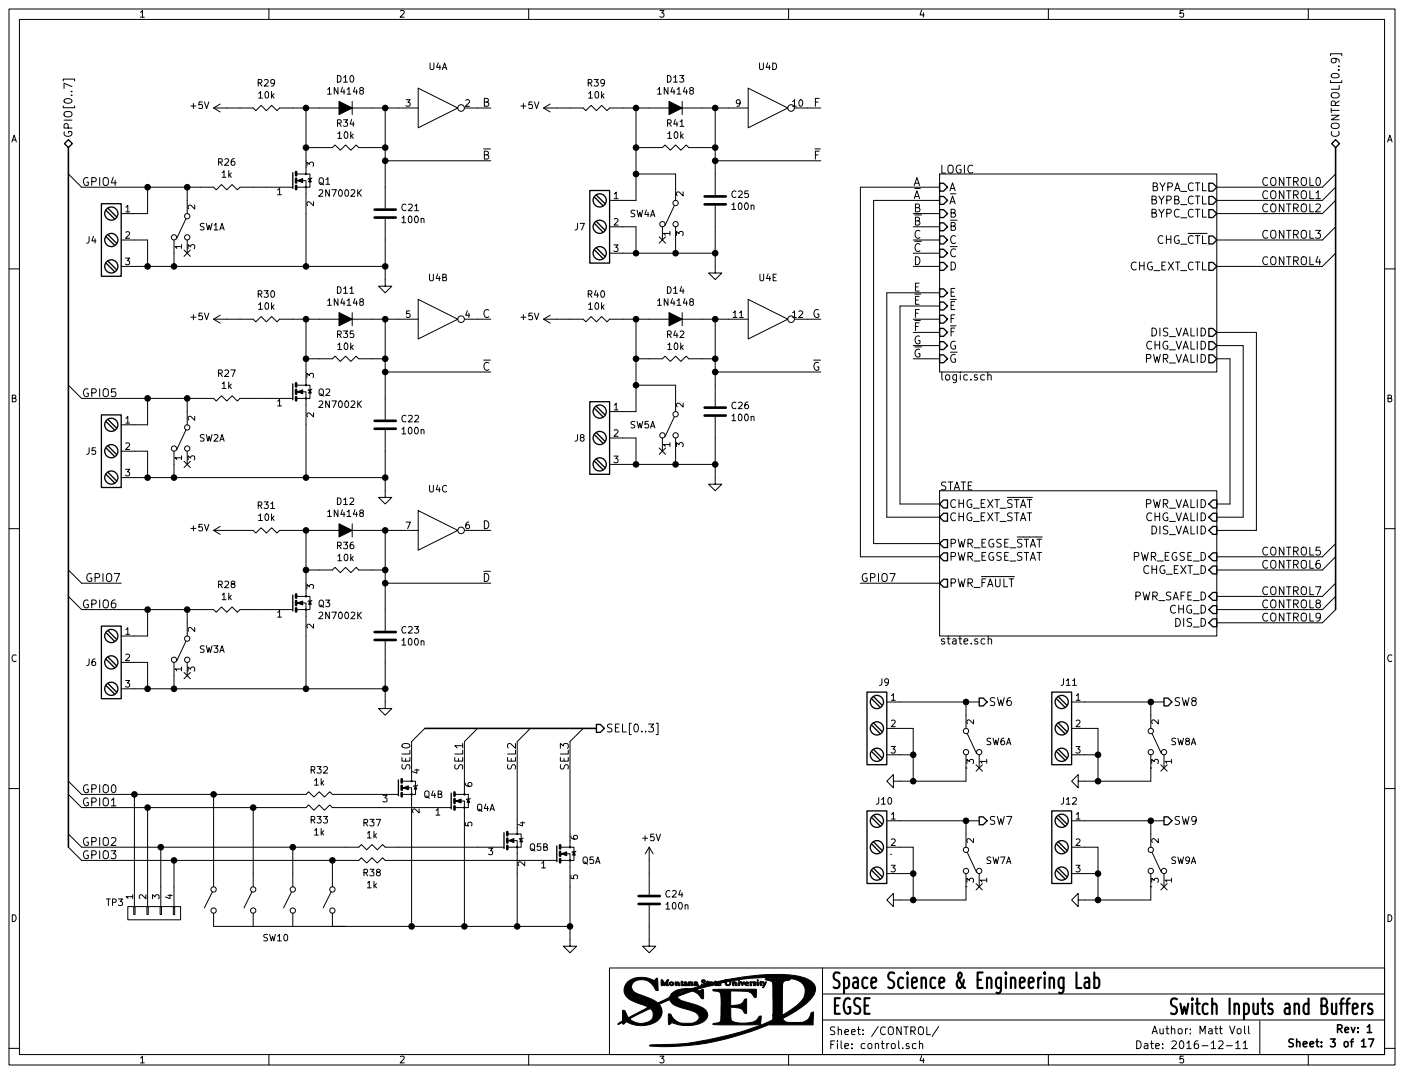
[picture p67: page 3]

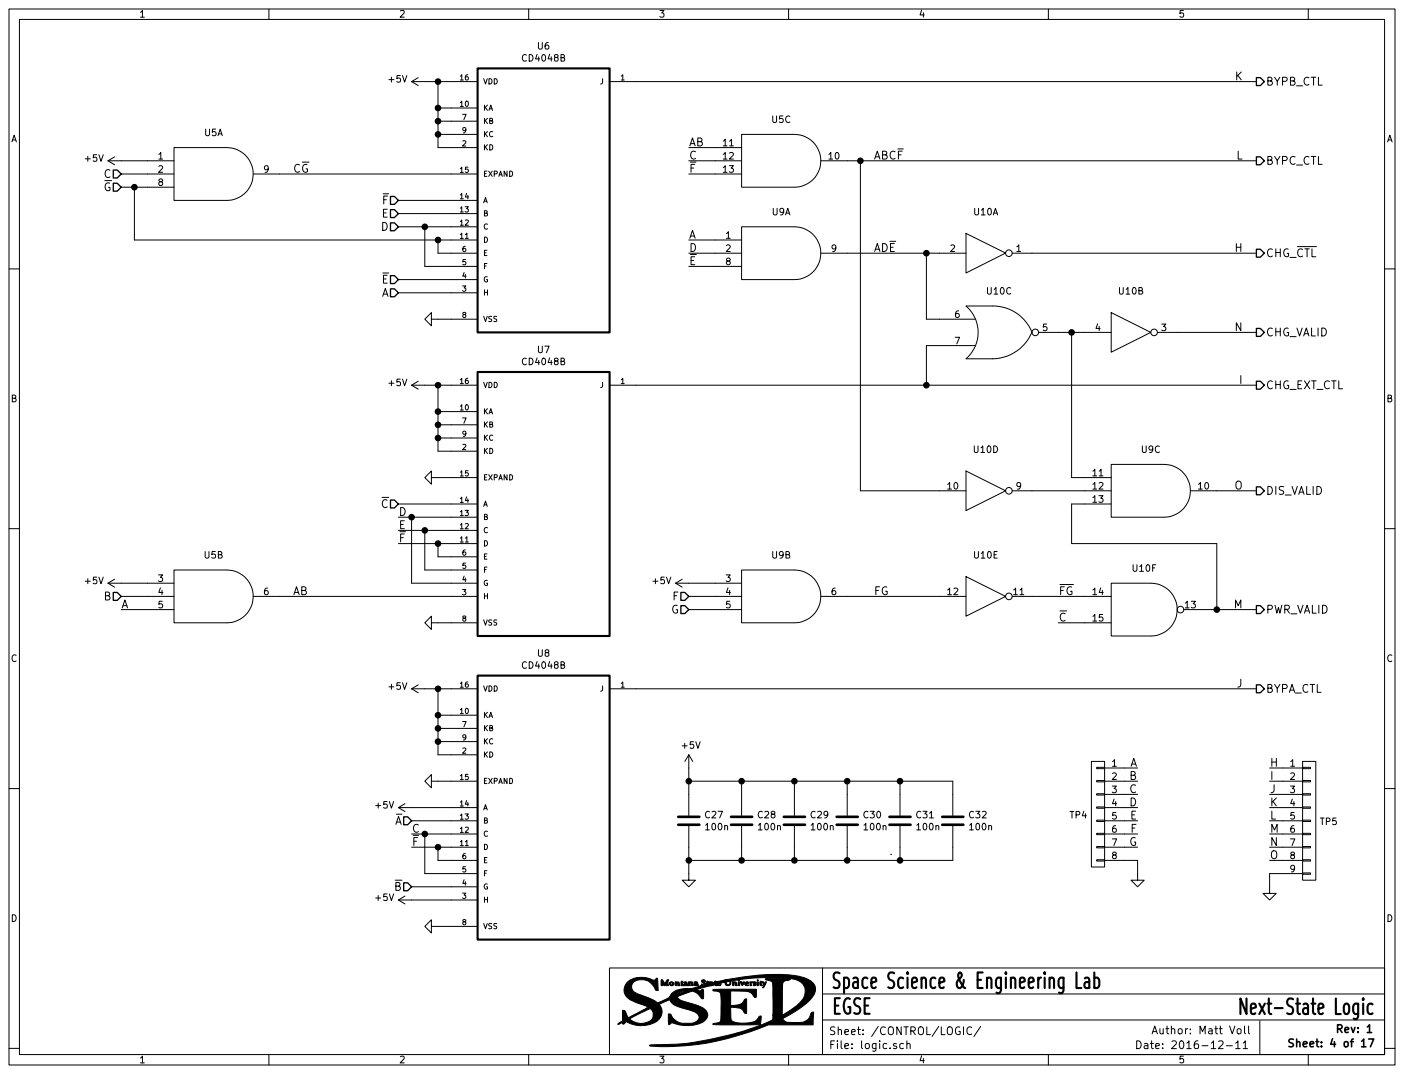
[picture p68: page 4]

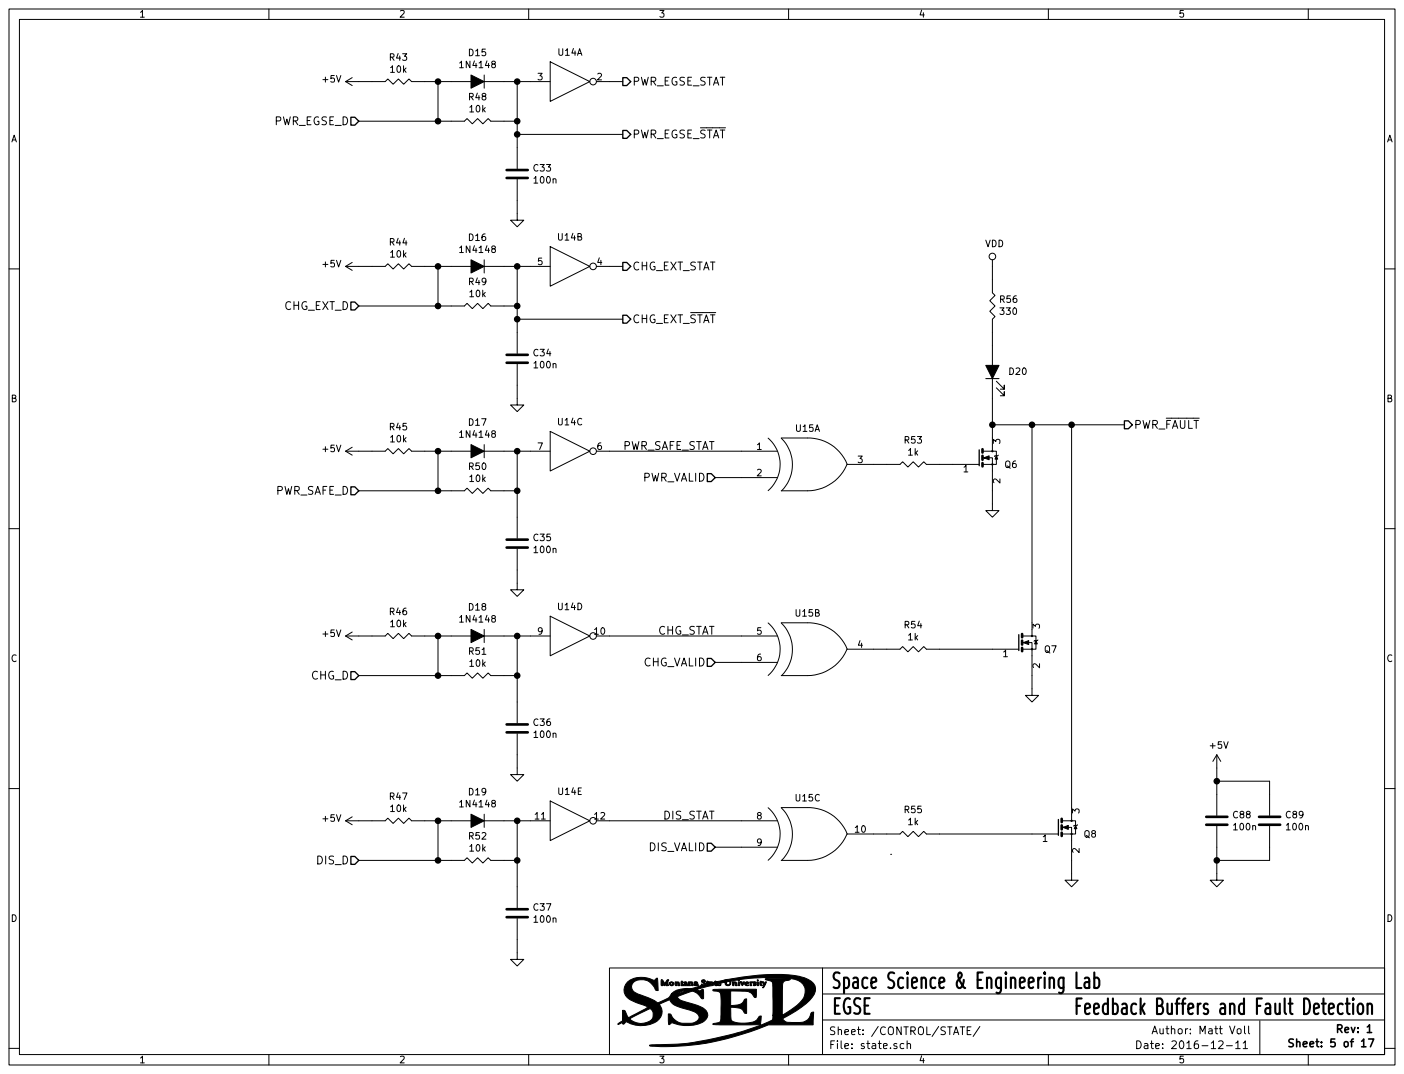
[picture p69: page 5]

File: state.sch Sheet: /CONTROL/STATE/ CHG_D

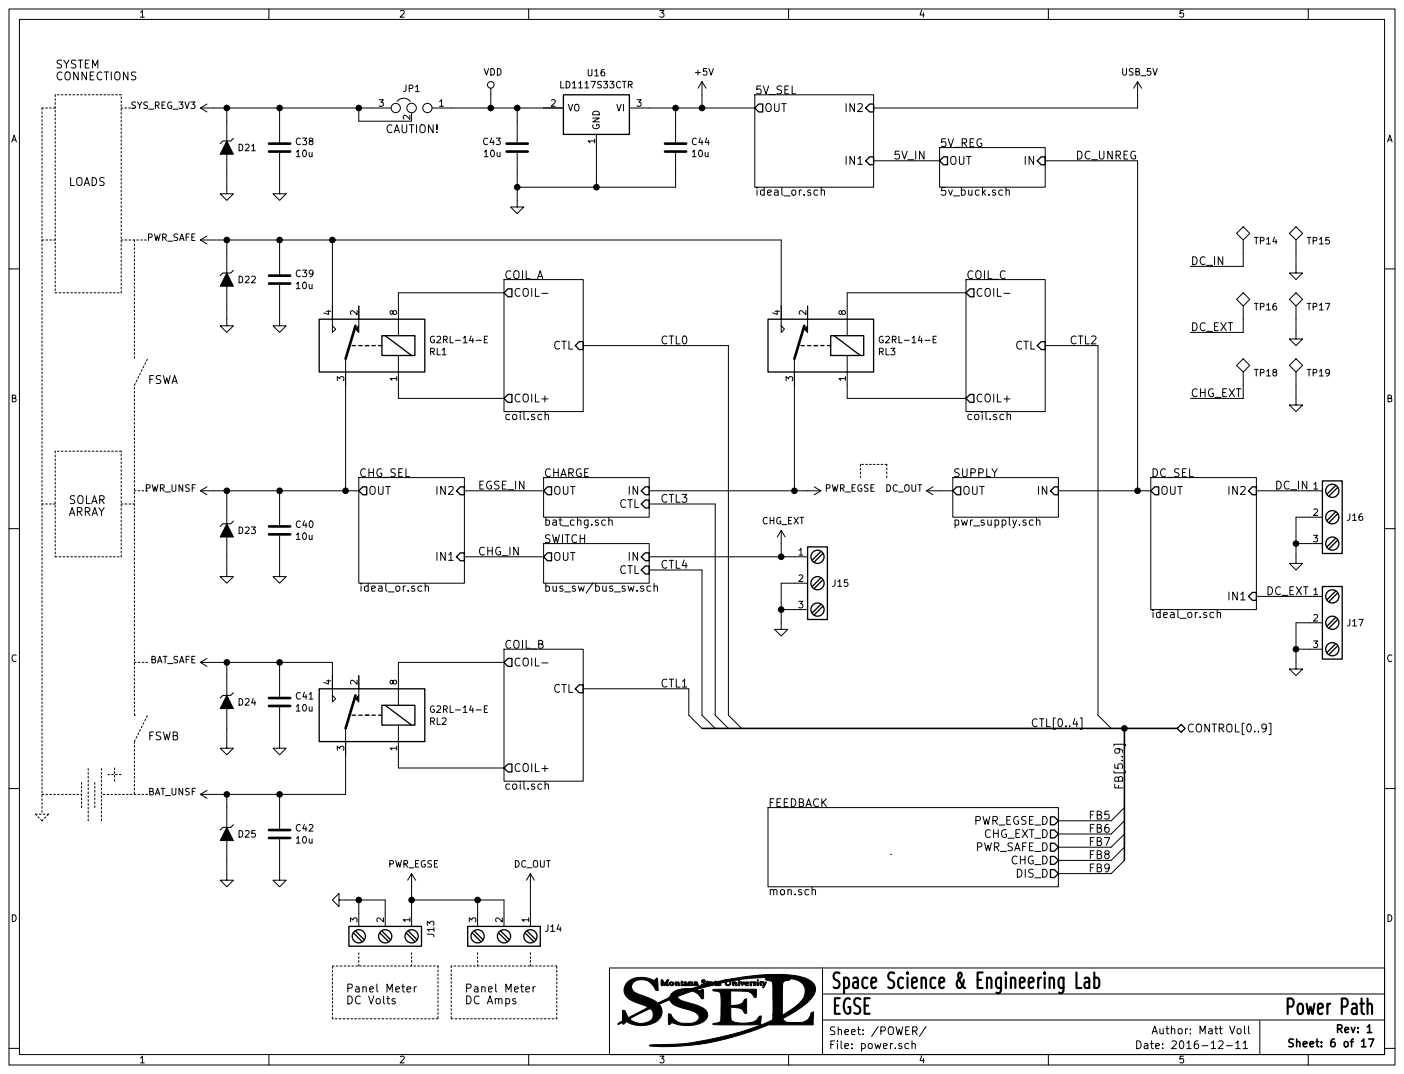
[picture p70: page 6]

File: power.sch Sheet: /POWER/ C42

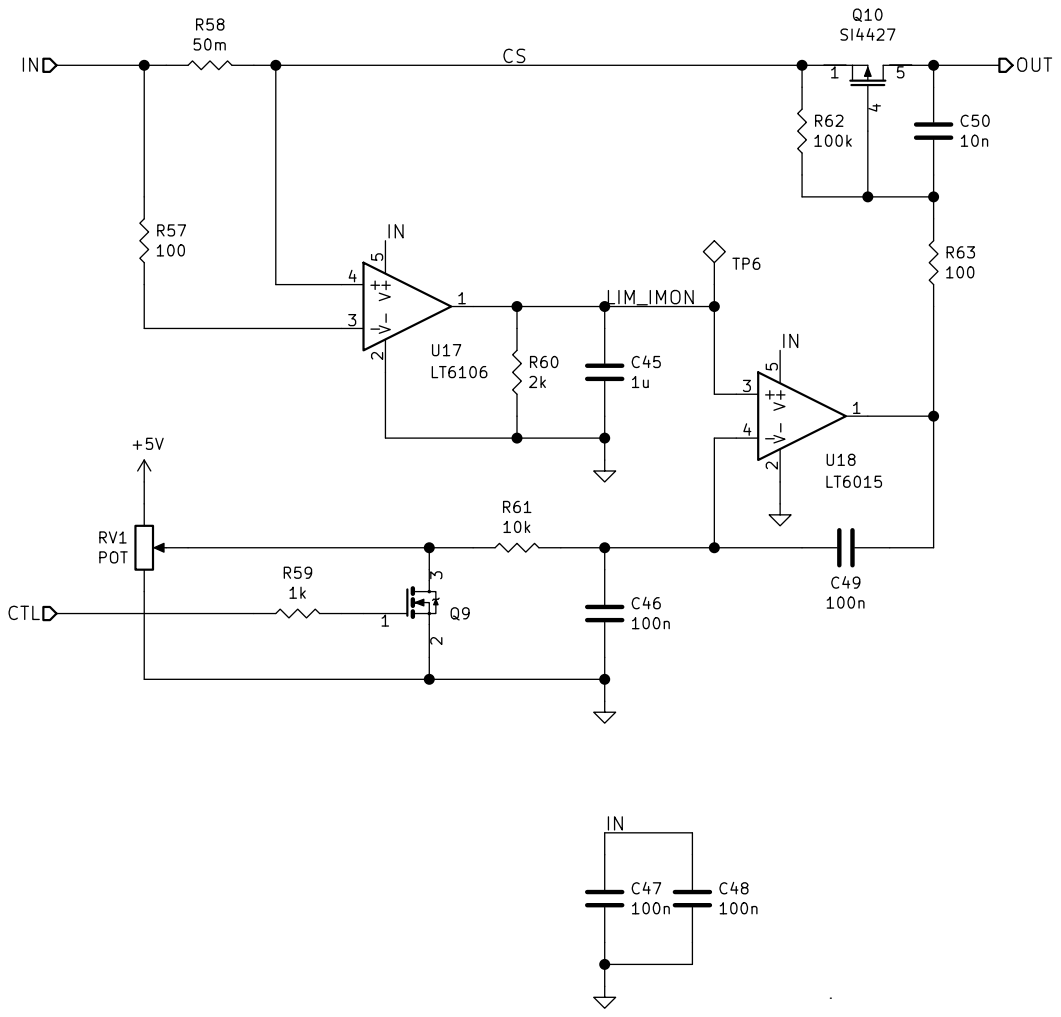
[picture p71: page 7]

File: bat_chg.sch Sheet: /POWER/CHARGE/

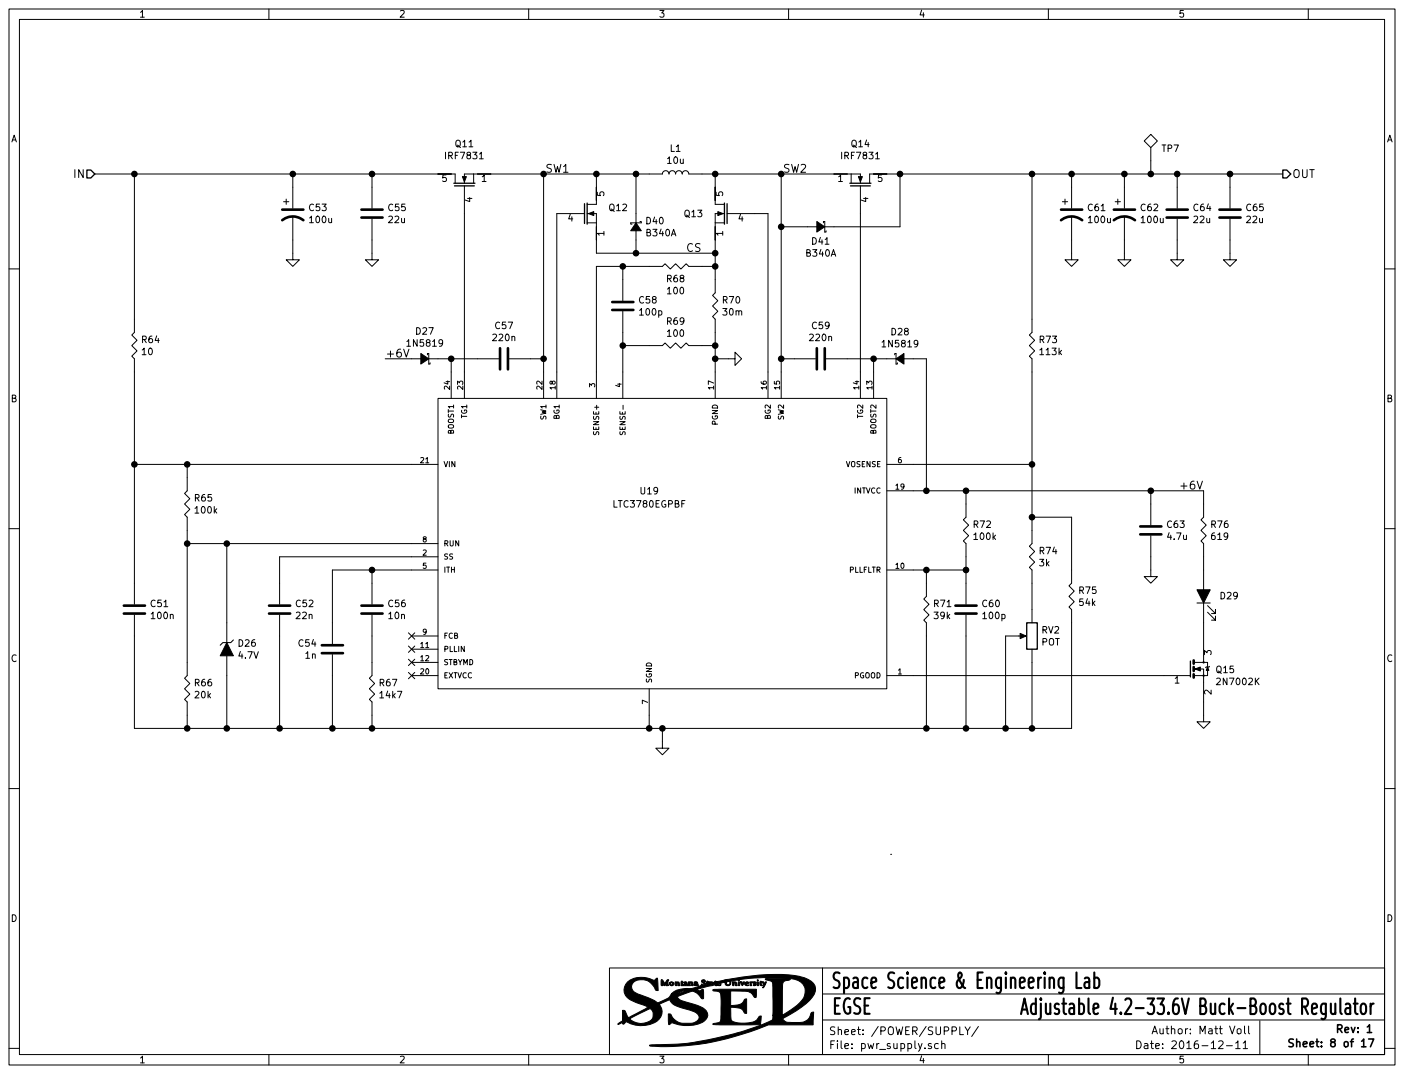
[picture p72: page 8]

7 RUN 8 FCB 9 EXTVCC 20 PLLIN 11 VIN 21 STBYMD 12 BOOST2 13 TG1 23 TG2 14 BOOST1 24 BG2 16 PGND 17 BG1 18

File: pwr_supply.sch Sheet: /POWER/SUPPLY/

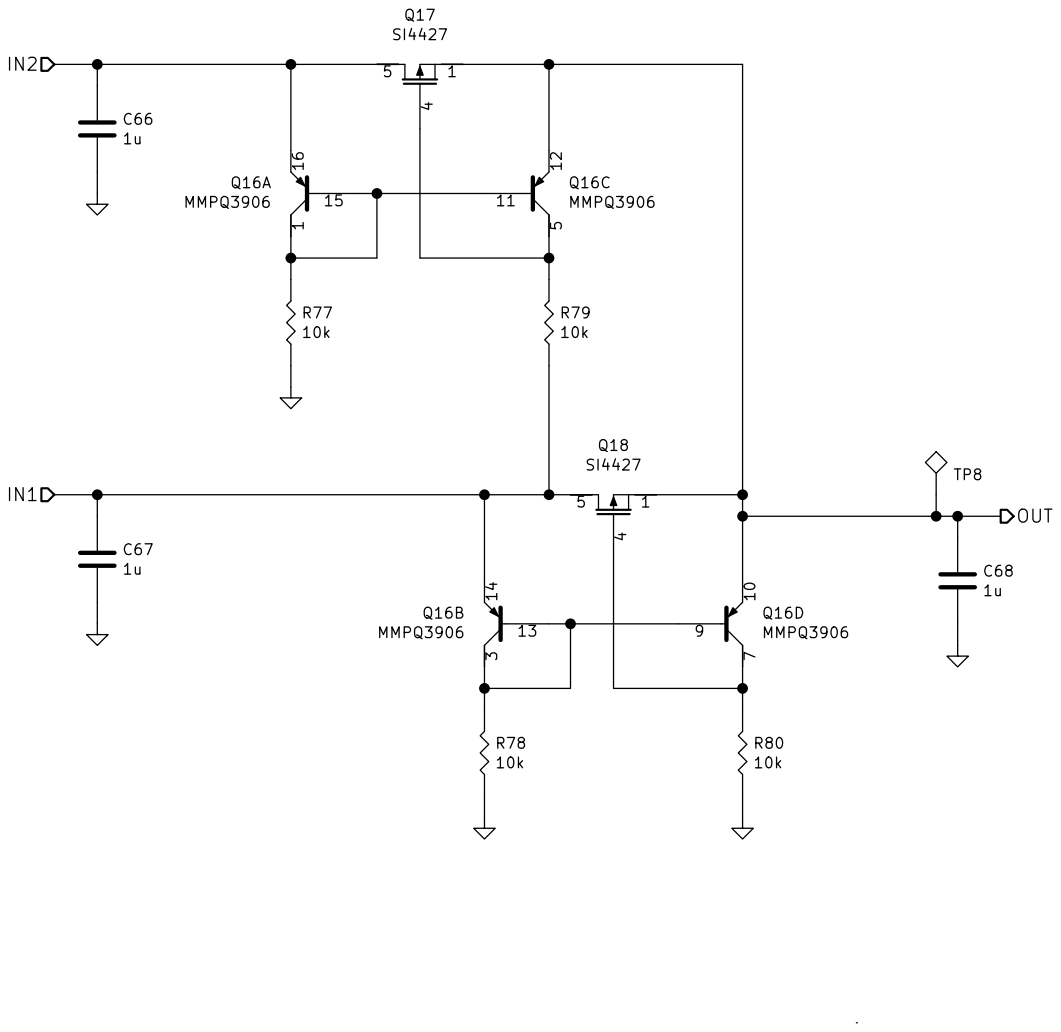
[picture p73: page 9]

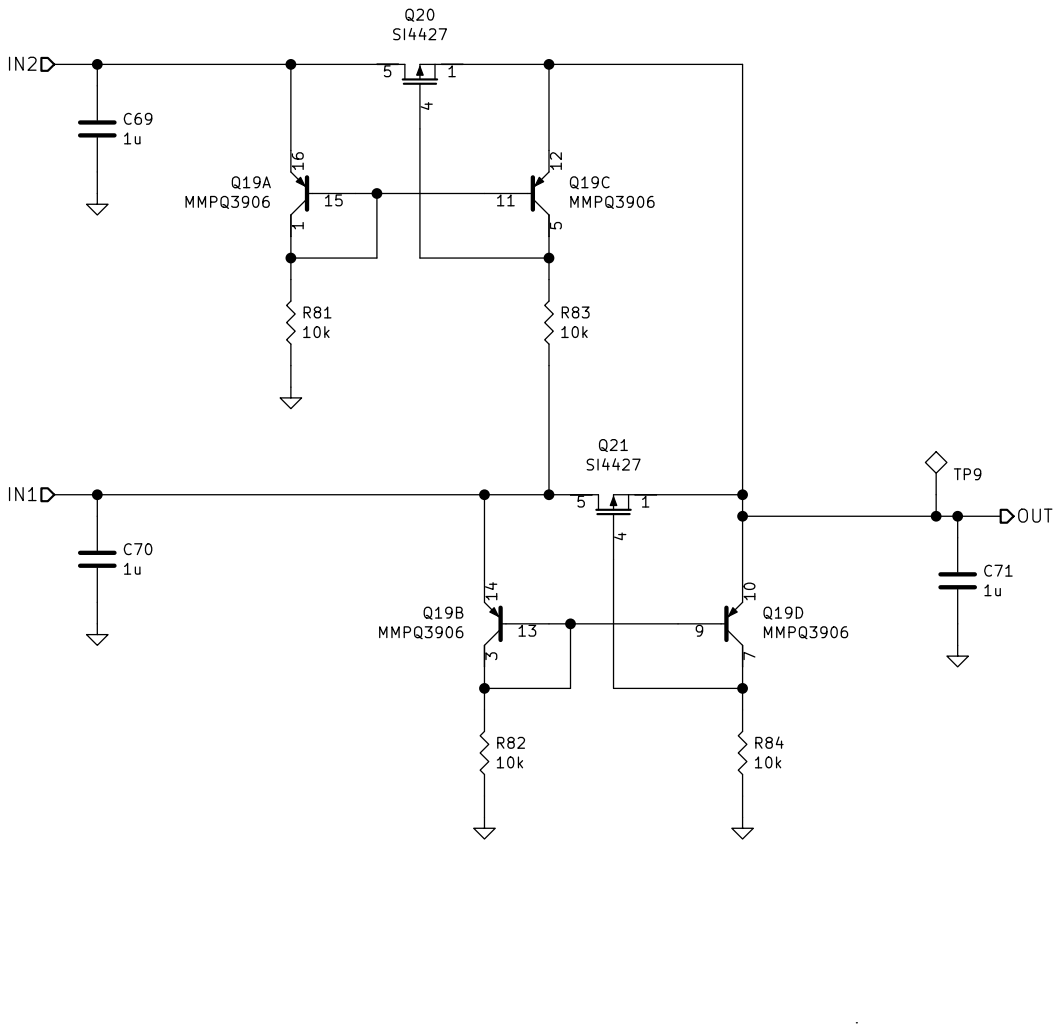
[picture p74: page 10]

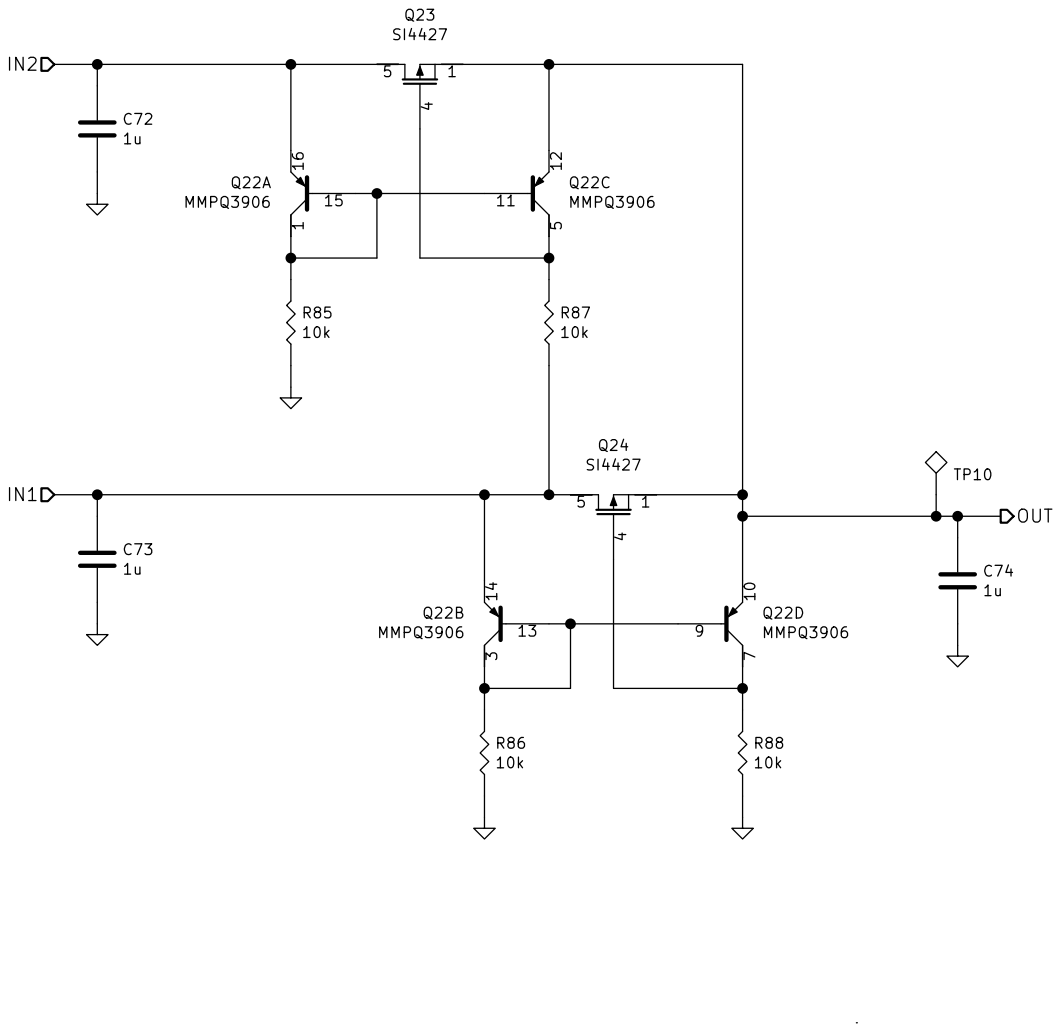
[picture p75: page 11]

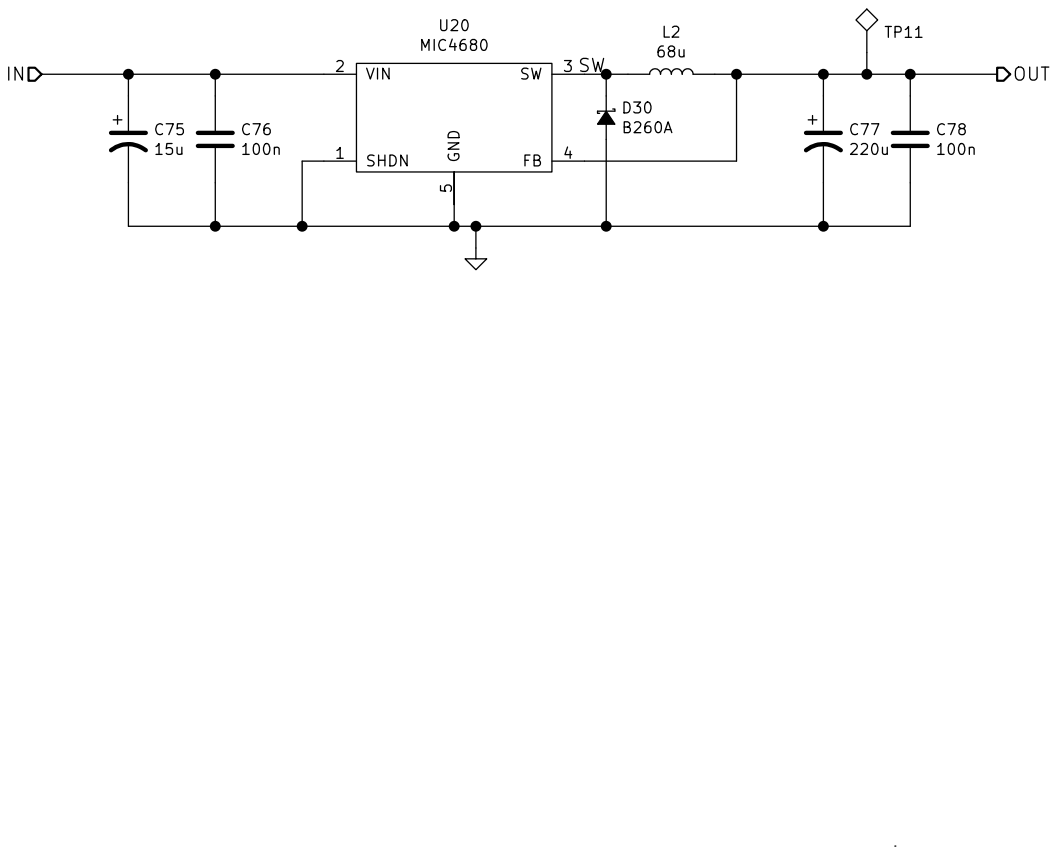
[picture p76: page 12]

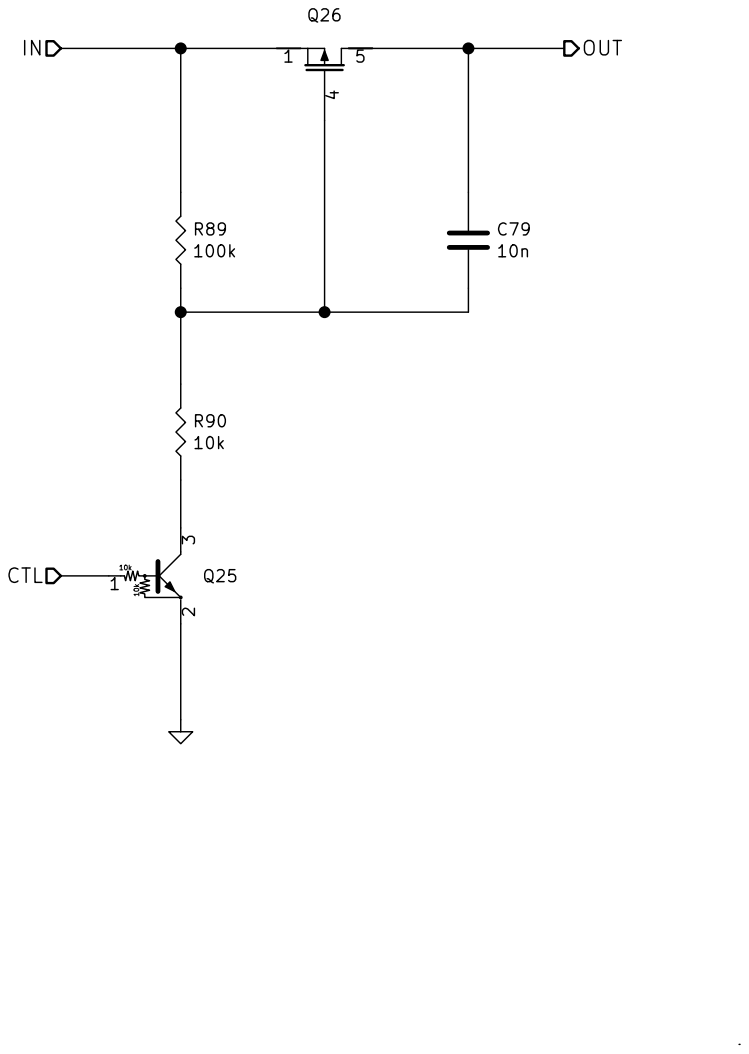
[picture p77: page 13]

File: bus_sw.sch Sheet: /POWER/SWITCH/

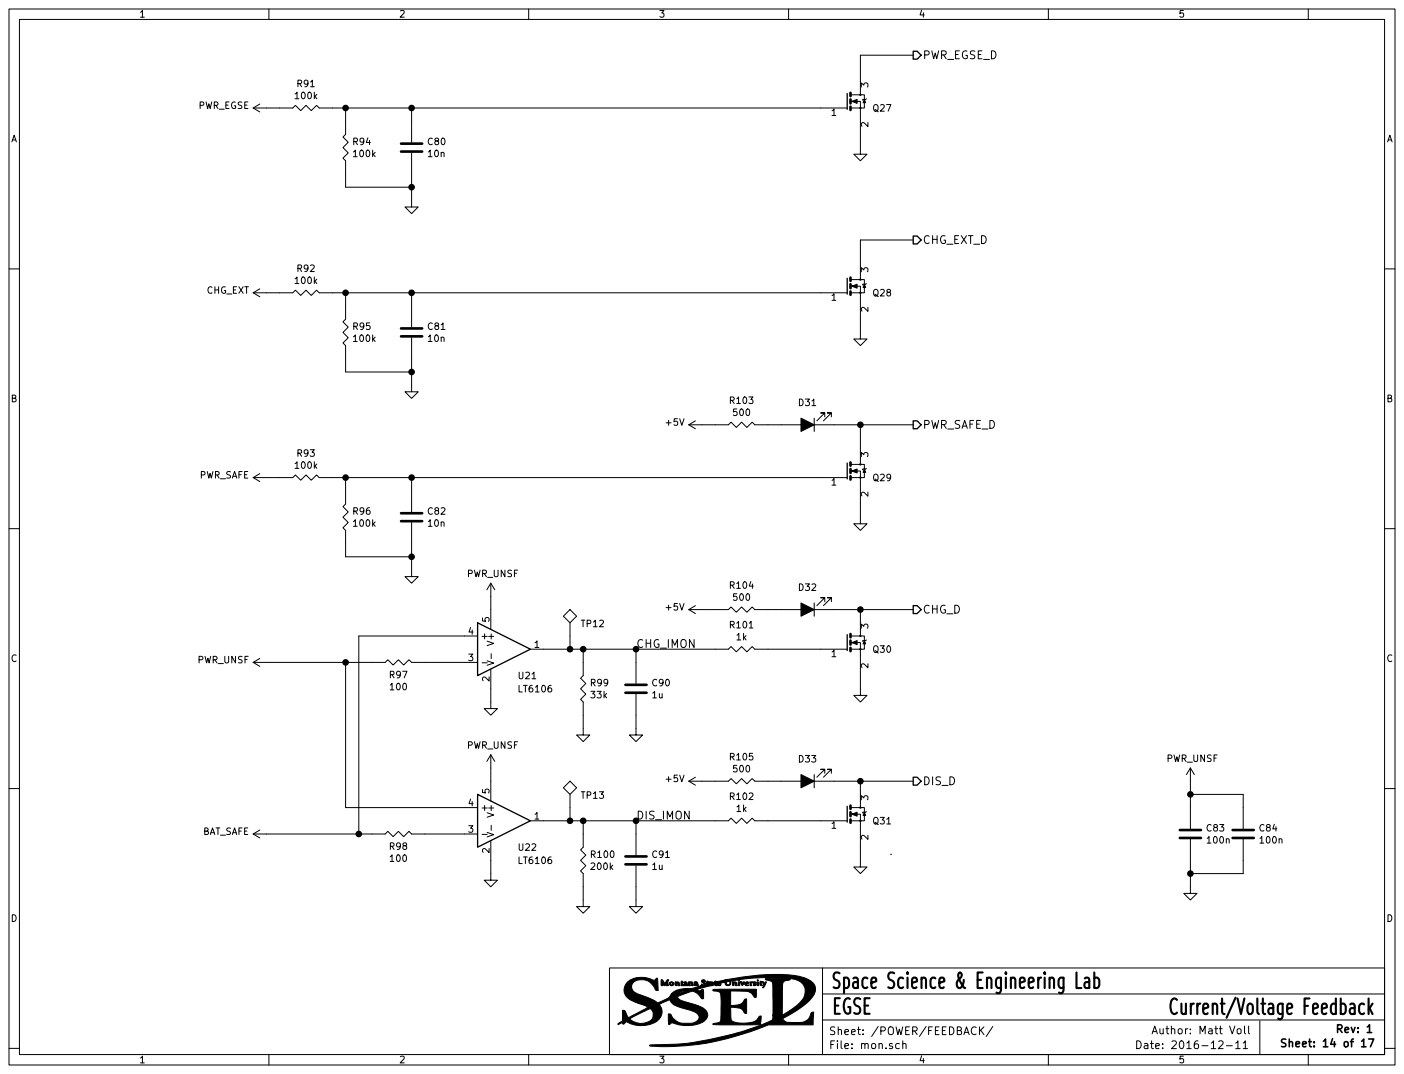
[picture p78: page 14]

File: mon.sch Sheet: /POWER/FEEDBACK/

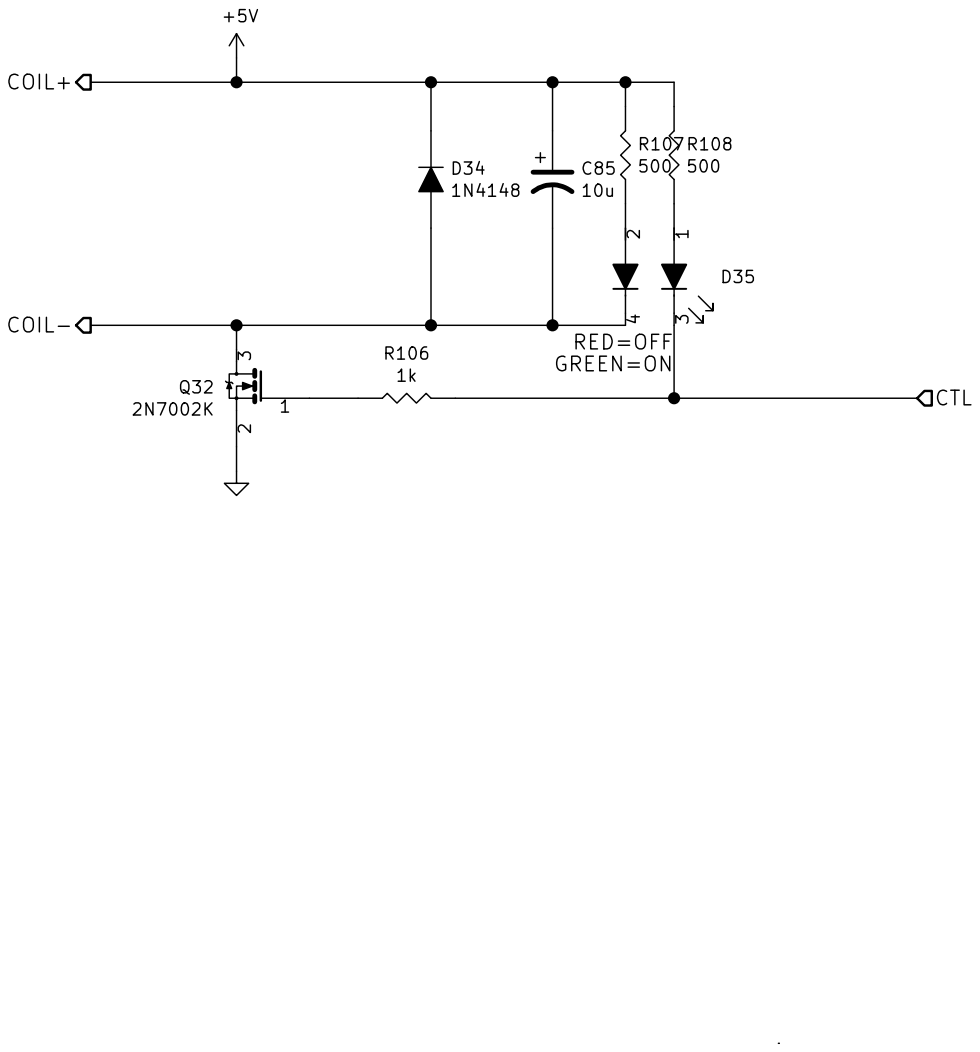
[picture p79: page 15]

File: coil.sch Sheet: /POWER/COIL_A/

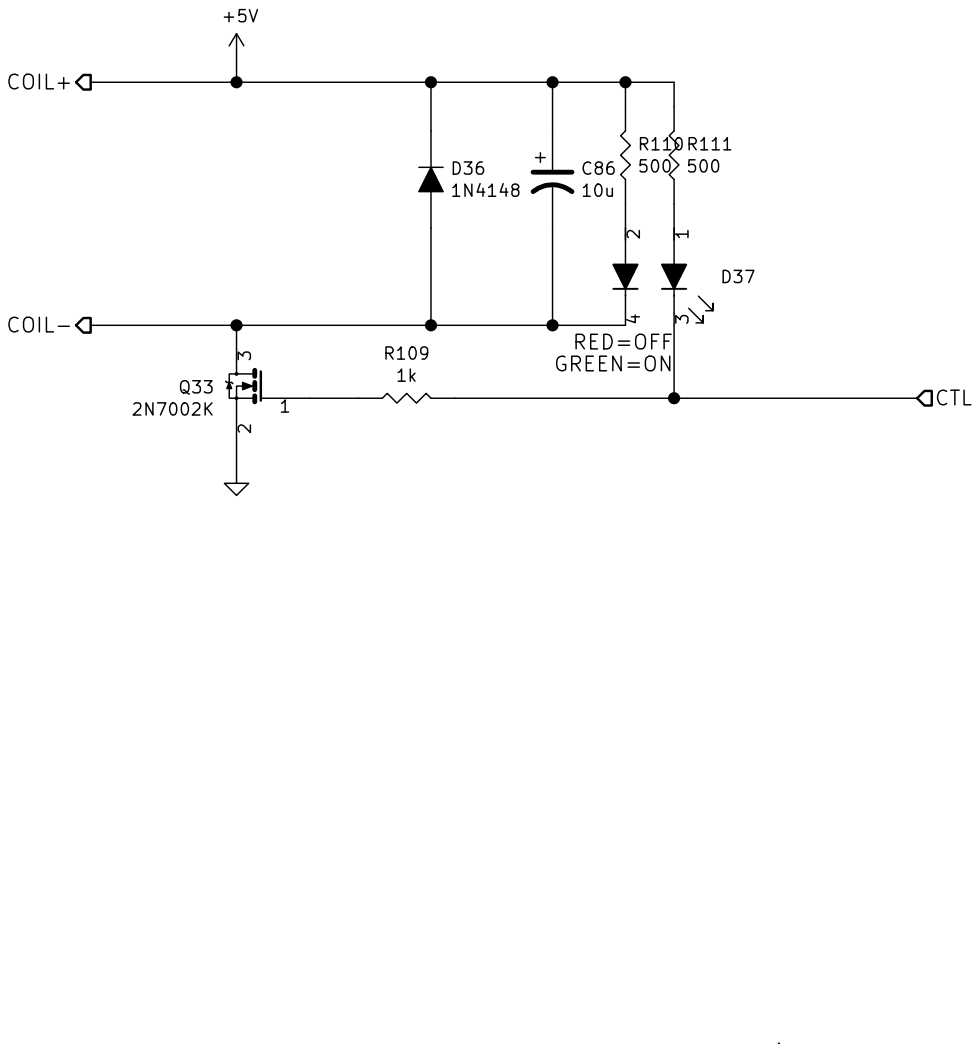
[picture p80: page 16]

File: coil.sch Sheet: /POWER/COIL_C/

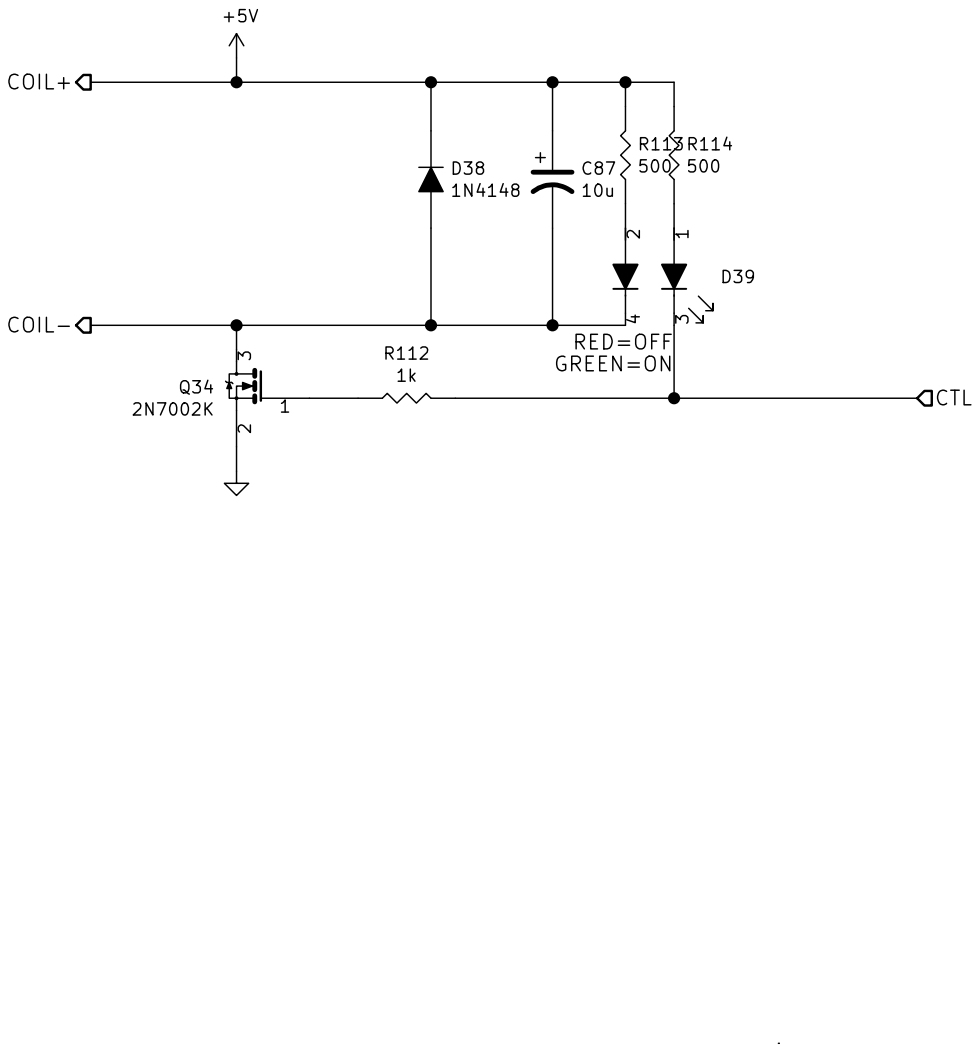
[picture p81: page 17]

File: coil.sch Sheet: /POWER/COIL_B/
