mattyv06/thesis/figs/fisce/concept/fisce_panel_diagram_load_control.pdf

## SA+ to EPS

## SA_IN from array

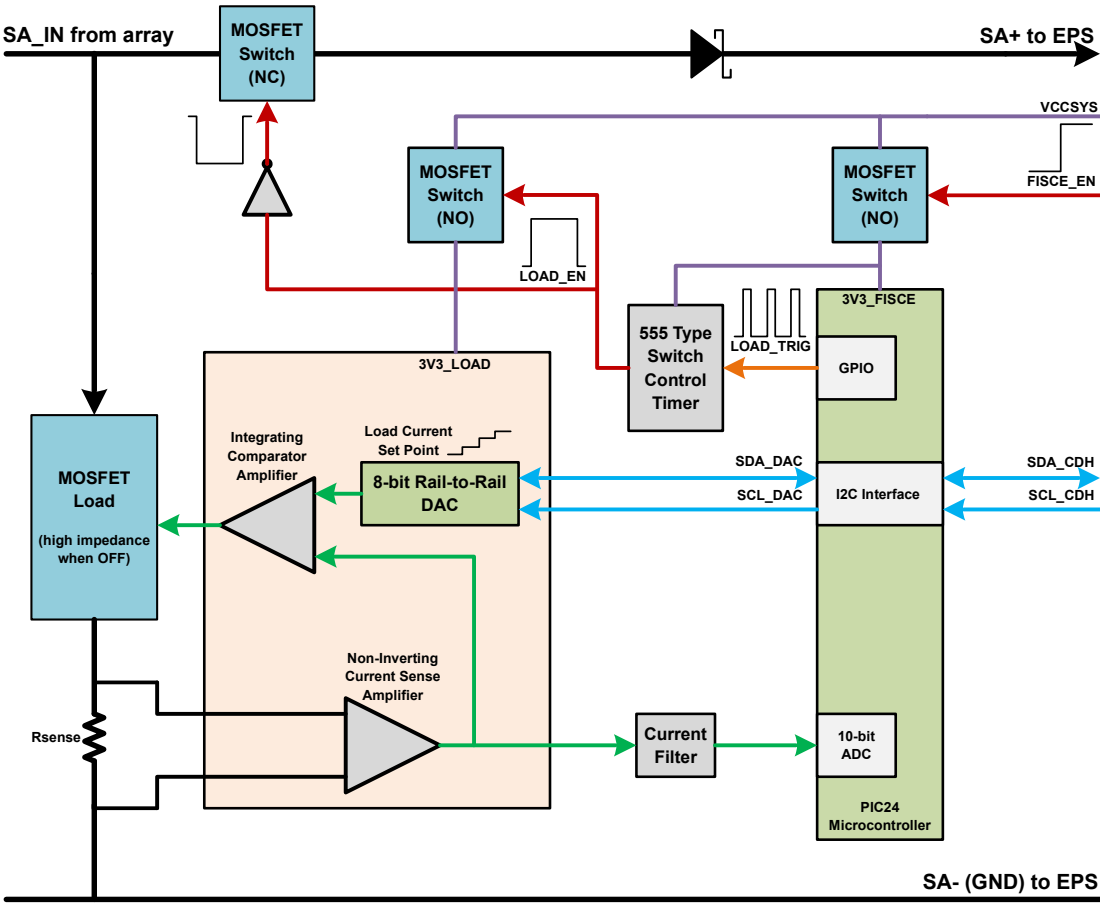
[picture p82: page 1]
MOSFET Load; (high impedance when OFF); FISCE_EN; VCCSYS; 10-bit ADC; I2C Interface; GPIO; Rsense; Current; Filter; 555 Type Switch Control Timer; MOSFET Switch (NO); MOSFET Switch (NC); LOAD_EN; LOAD_TRIG; 3V3_FISCE; 3V3_LOAD; Non-Inverting Current Sense Amplifier; Integrating Comparator Amplifier; SCL_CDH; SDA_CDH; SCL_DAC; SDA_DAC; PIC24 Microcontroller

Load Current
Set Point
8-bit Rail-to-Rail
DAC

SA- (GND) to EPS
