mattyv06/thesis/figs/fisce/schematic/fisce_schematic_fbe4007d.pdf

D

1 | 2 | 3 | 4 | 5 | 6

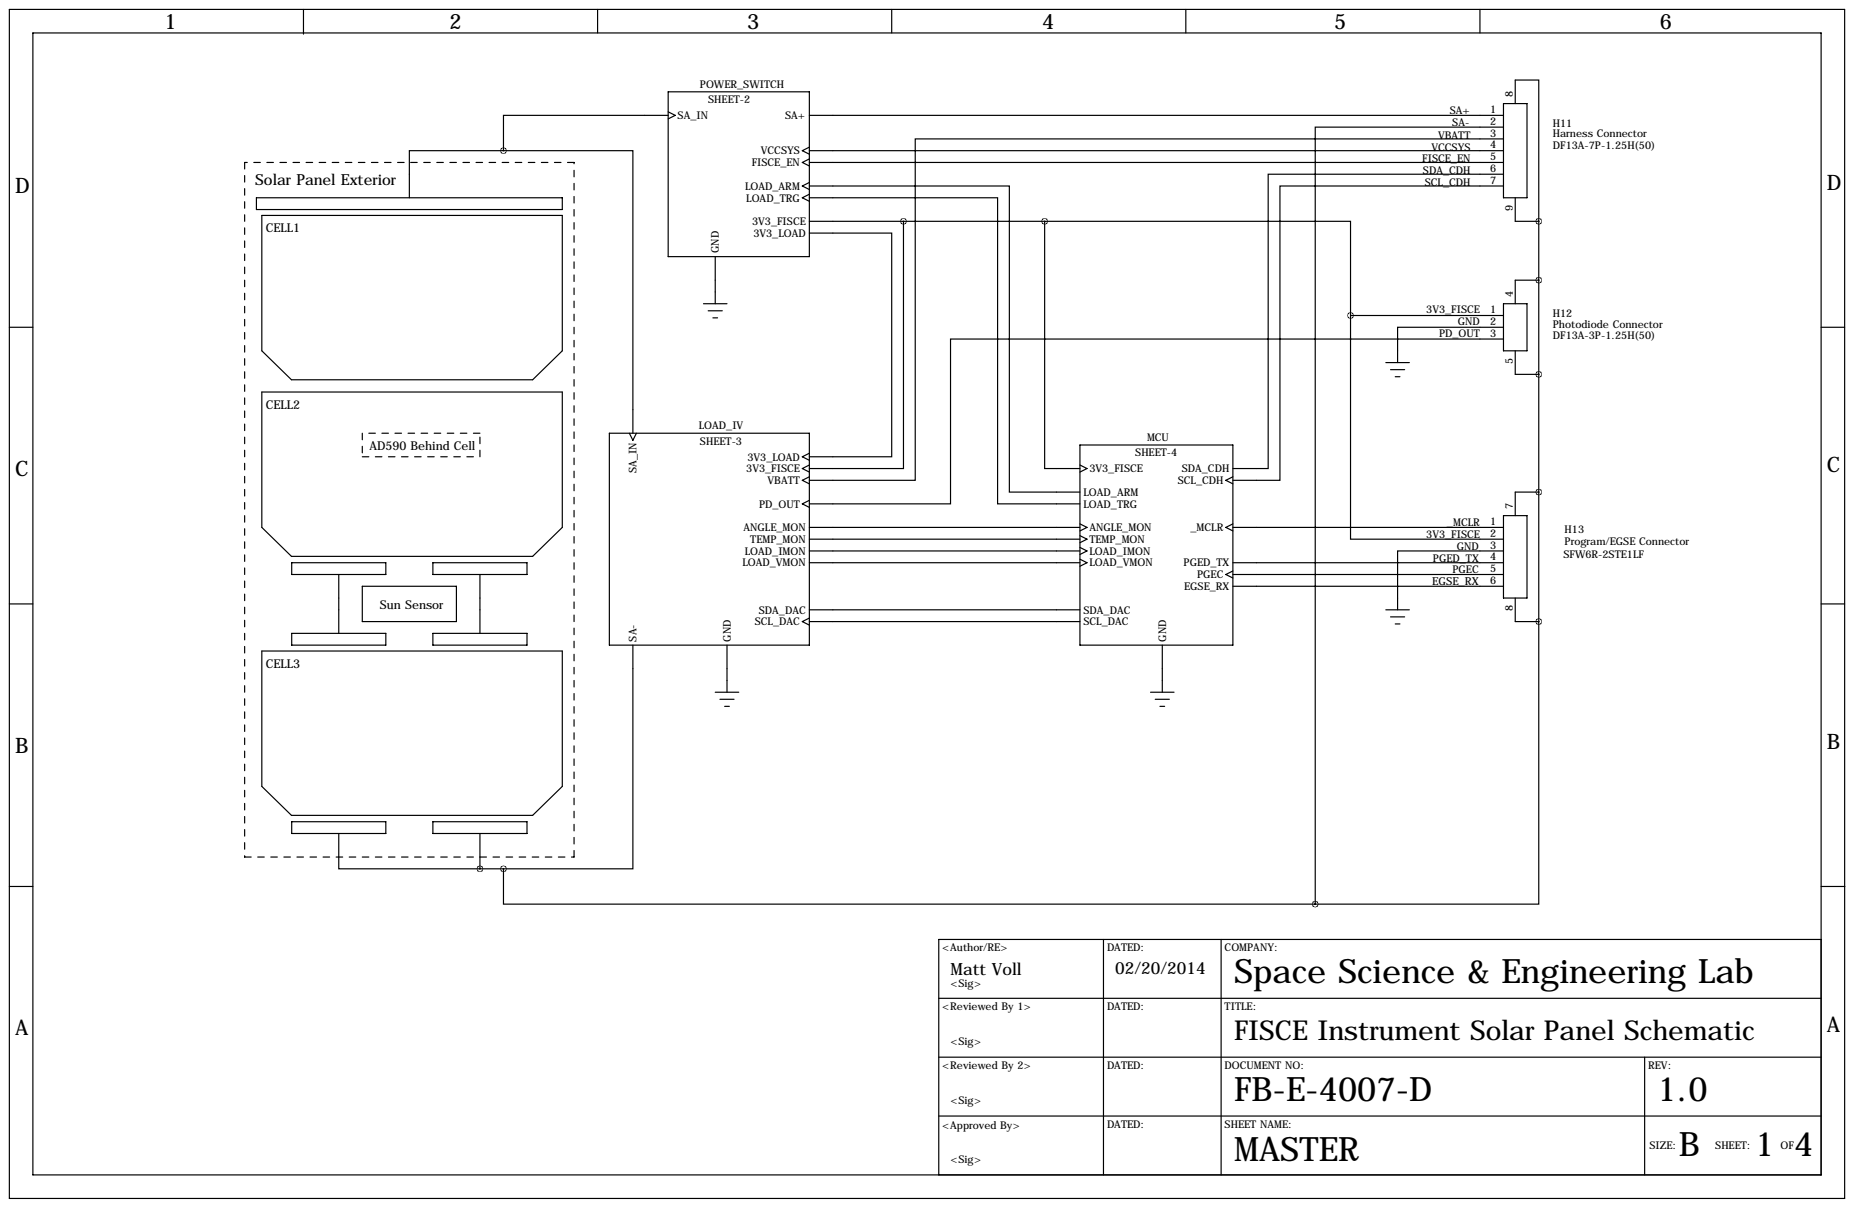
[picture p83: page 1]
Sun Sensor; CELL1; CELL2; CELL3; AD590 Behind Cell; Photodiode Connector; LOAD_ARM; VCCSYS; 3V3_FISCE; FISCE_EN; GND; LOAD_TRG; 3V3_LOAD; POWER_SWITCH SHEET-2; LOAD_IMON LOAD_VMON; SDA_DAC SCL_DAC; TEMP_MON; VBATT; ANGLE_MON; PD_OUT; LOAD_IV; SHEET-3; ANGLE_MON TEMP_MON LOAD_IMON LOAD_VMON; SDA_CDH SCL_CDH; _MCLR; PGED_TX PGEC; EGSE_RX; MCU SHEET-4; SFW6R-2STE1LF; Program/EGSE Connector; Harness Connector; GND PGED_TX; SCL_CDH; SDA_CDH

VCCSYS 4
FISCE_EN 5

Solar Panel Exterior

PGEC 5
6 EGSE_RX

<Author/RE> Matt Voll <Sig> | DATED: 02/20/2014 | COMPANY: Space Science & Engineering Lab

<Reviewed By 1> <Sig> | DATED: | TITLE: FISCE Instrument Solar Panel Schematic

<Reviewed By 2> <Sig> | DATED: | DOCUMENT NO: FB-E-4007-D | REV: 1.0

<Approved By> <Sig> | DATED: | SHEET NAME: MASTER | B 1 4 SIZE: SHEET: OF

D
D

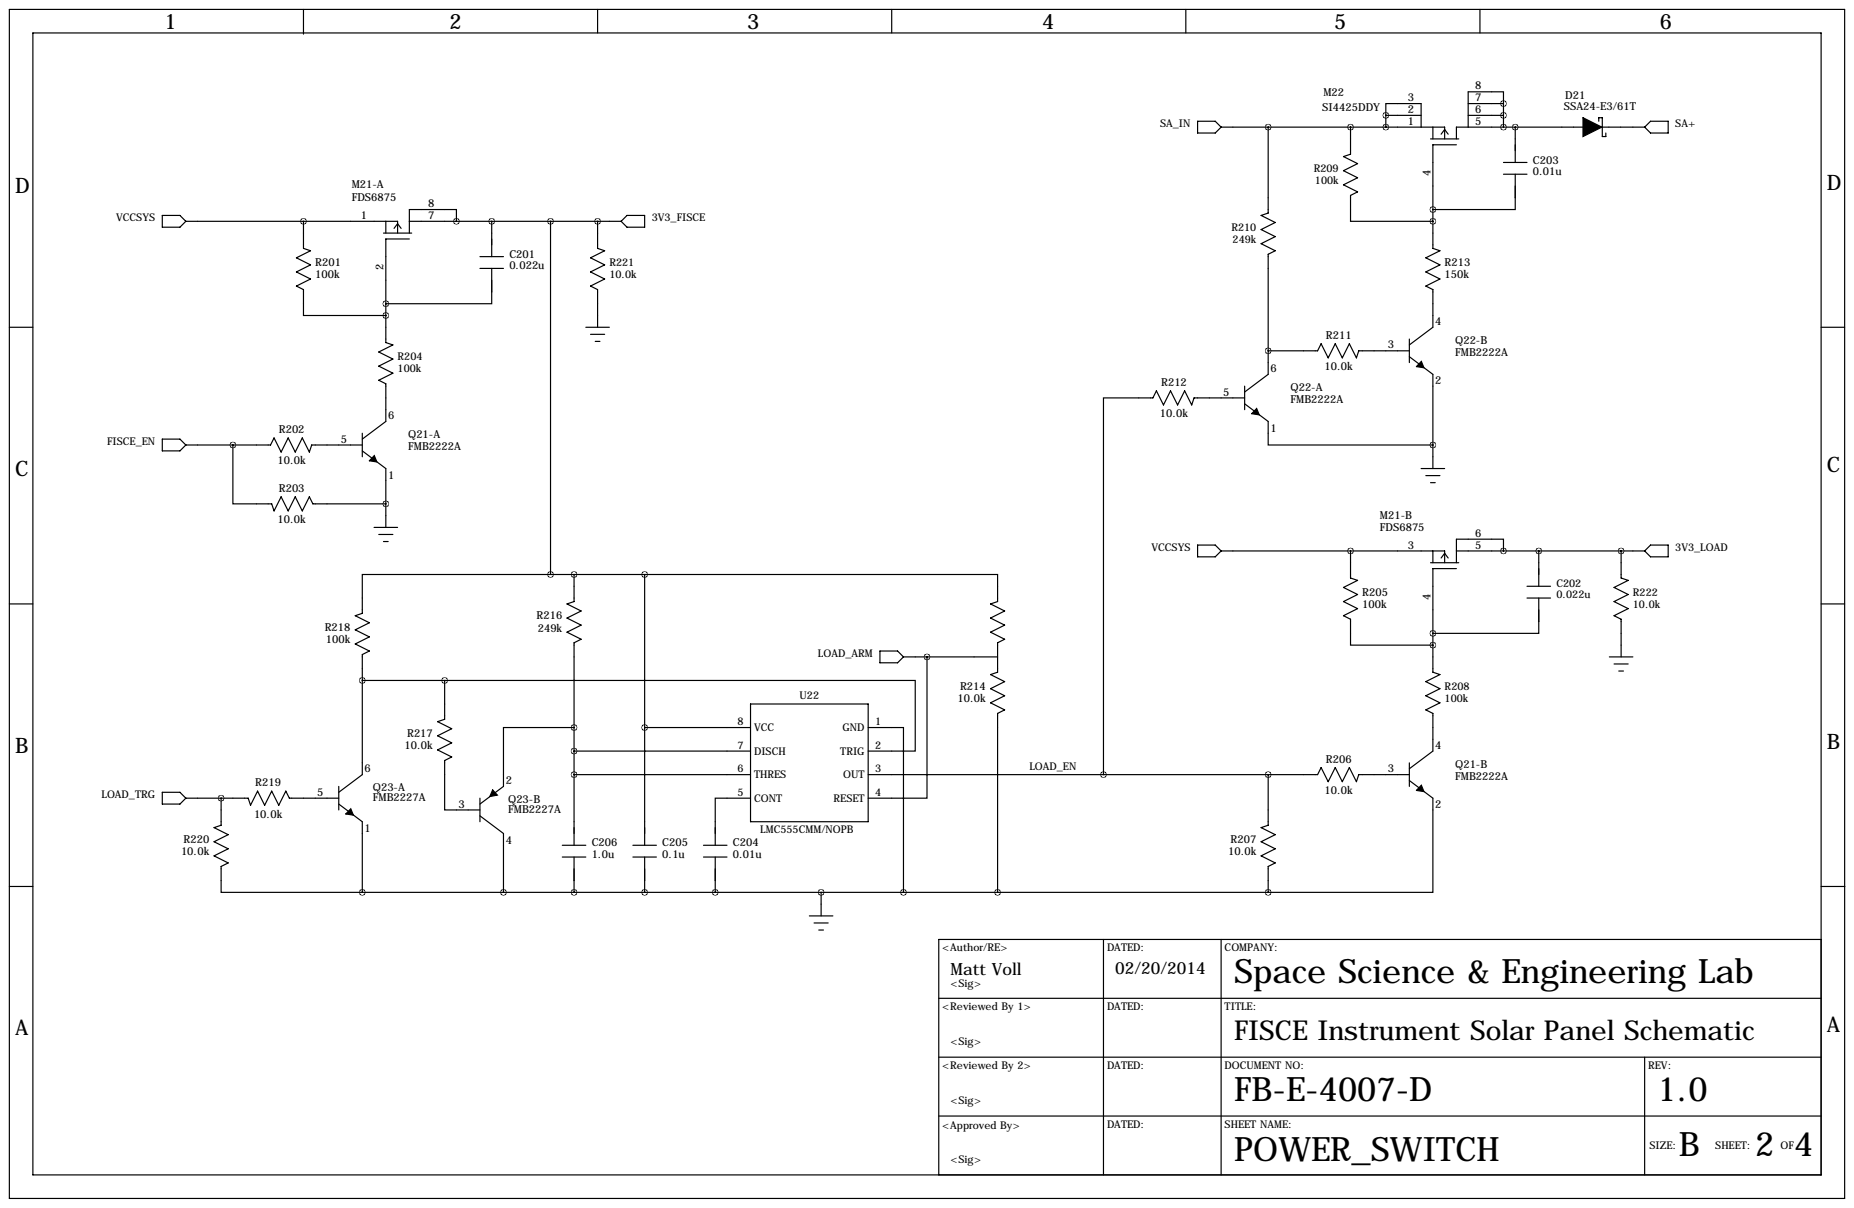
[picture p84: page 2]

<Author/RE> Matt Voll <Sig> | DATED: 02/20/2014 | COMPANY: Space Science & Engineering Lab

<Reviewed By 1> <Sig> | DATED: | TITLE: FISCE Instrument Solar Panel Schematic

<Reviewed By 2> <Sig> | DATED: | DOCUMENT NO: FB-E-4007-D | REV: 1.0

POWER_SWITCH | B 2 4

D
D

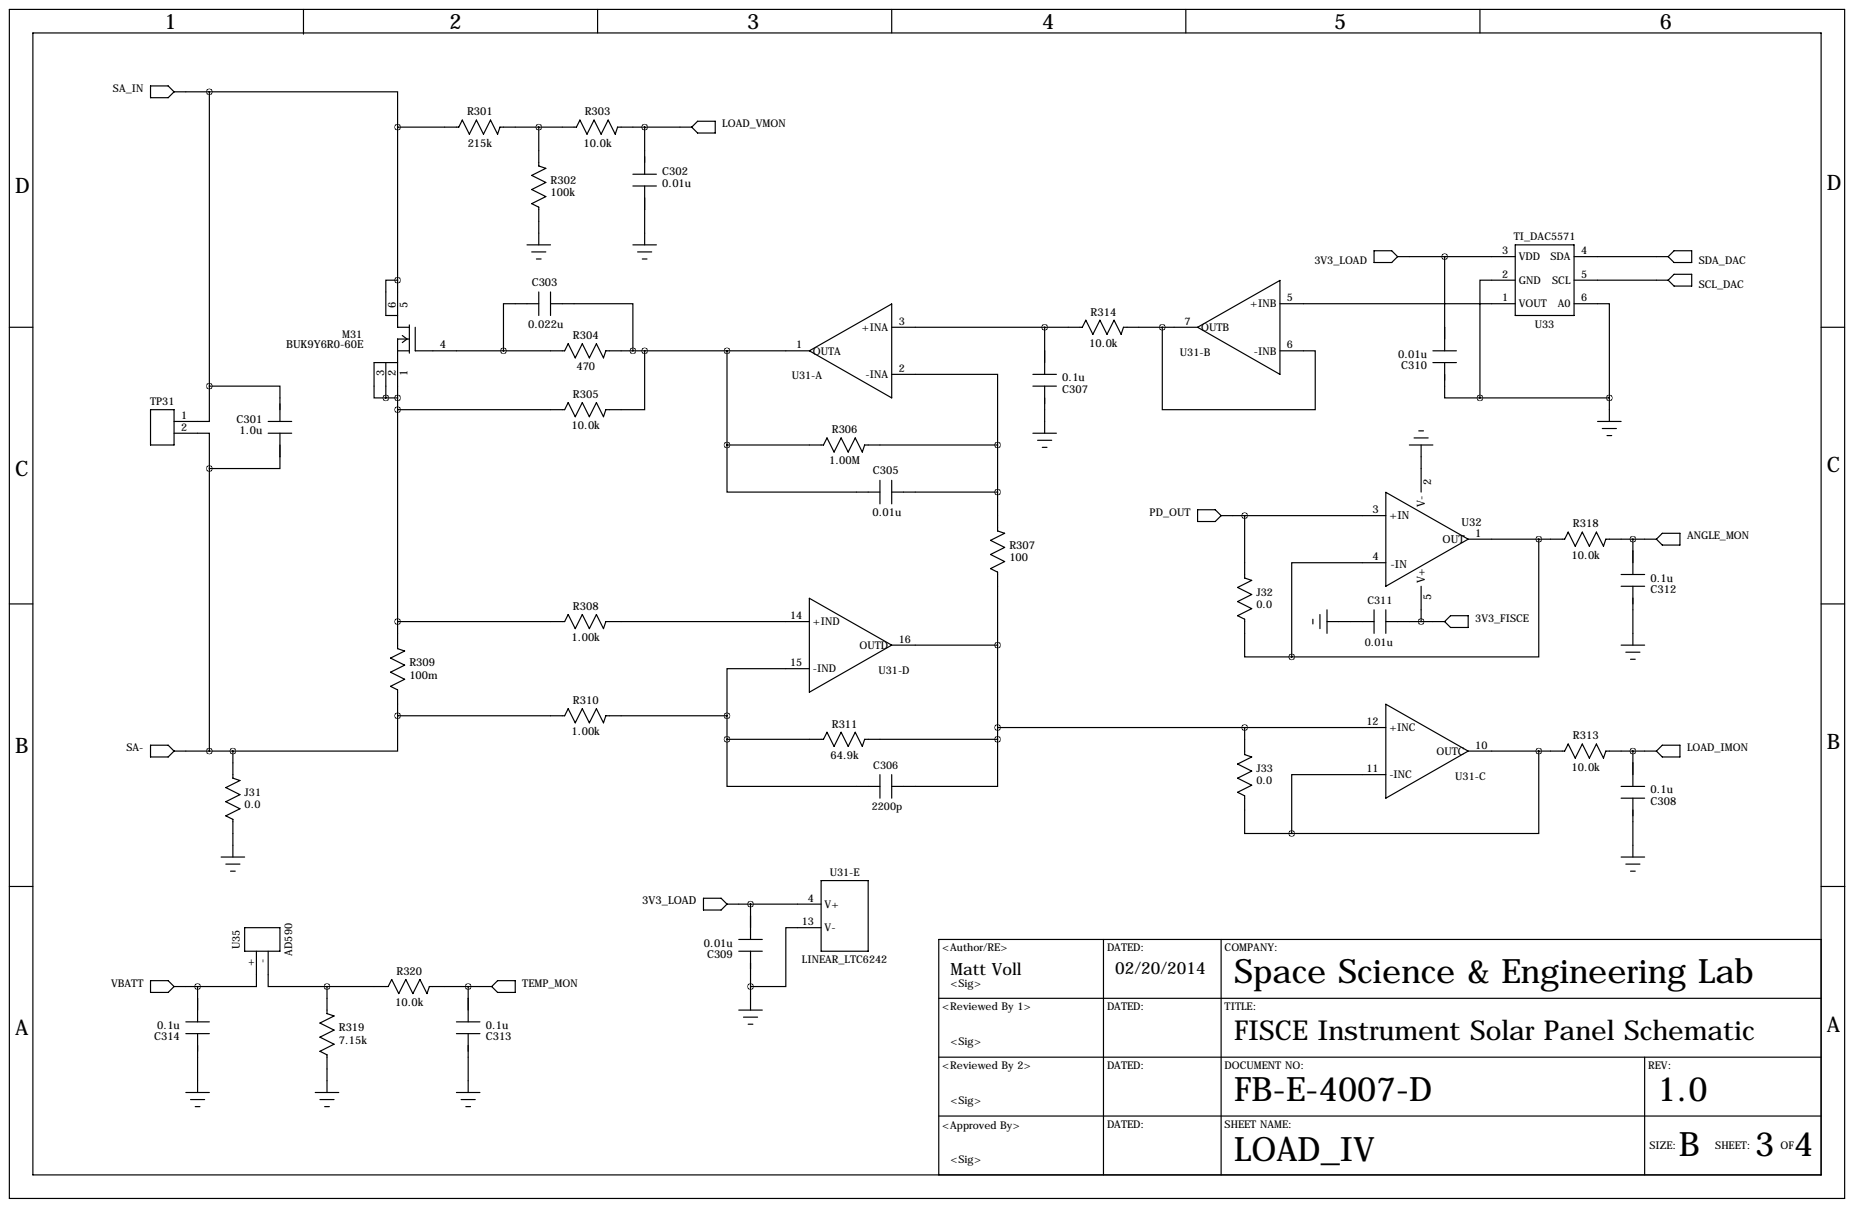
[picture p85: page 3]

<Author/RE> Matt Voll <Sig> | DATED: 02/20/2014 | COMPANY: Space Science & Engineering Lab

<Reviewed By 1> <Sig> | DATED: | TITLE: FISCE Instrument Solar Panel Schematic

<Reviewed By 2> <Sig> | DATED: | DOCUMENT NO: FB-E-4007-D | REV: 1.0

LOAD_IV | B 3 4

# CDB

1

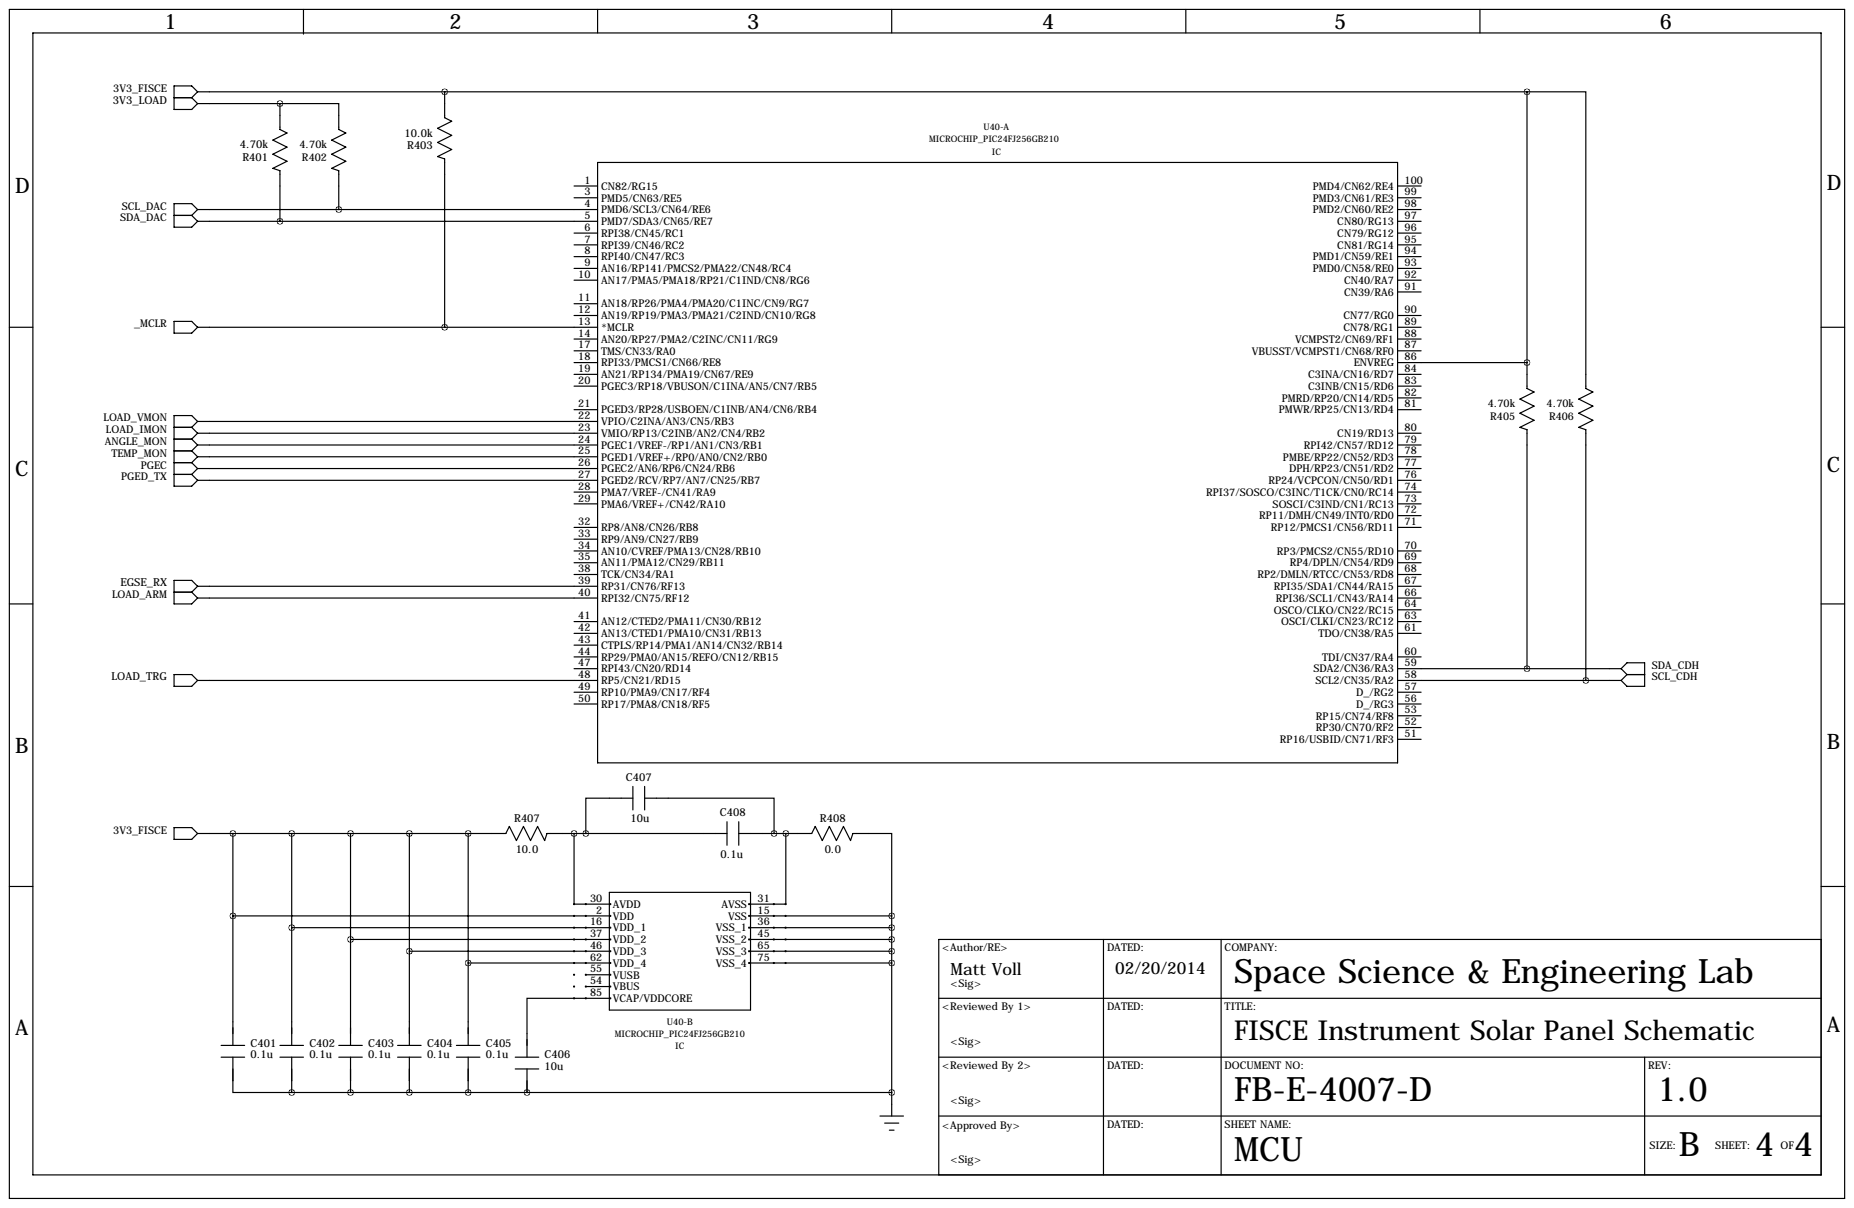
[picture p86: page 4]

<Reviewed By 1> <Sig> | DATED: | Space Science & Engineering Lab B TITLE: FISCE Instrument Solar Panel Schematic

<Reviewed By 2> <Sig> | DATED: | DOCUMENT NO: FB-E-4007-D | REV: 1.0

MCU | 4 4
