mattyv06/thesis/figs/phoenix/schematic/phoenix_eps_rev3_working.pdf

D

1 | 2 | 3 | 4 | 5 | 6

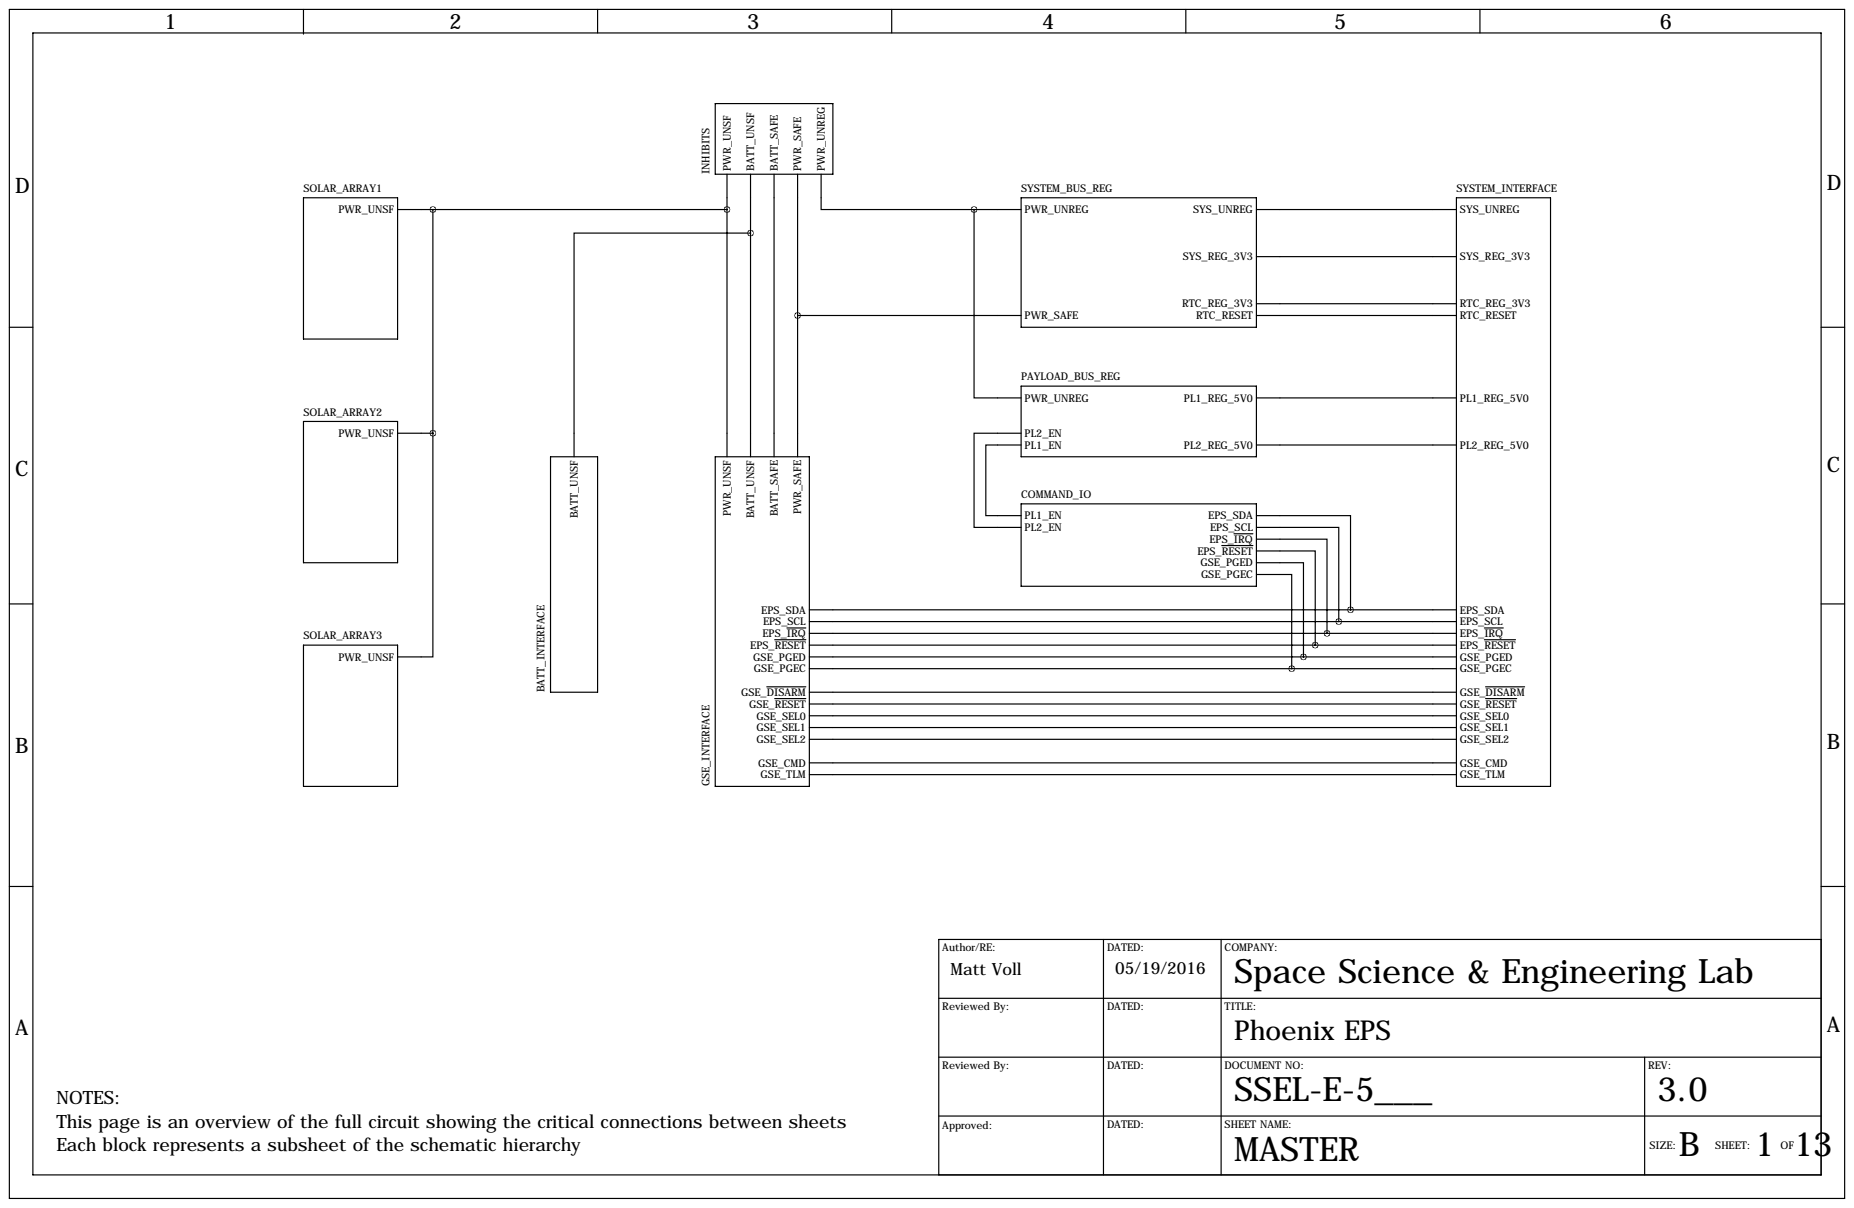
[picture p87: page 1]
INHIBITS; PWR_UNSF; BATT_UNSF; BATT_SAFE; PWR_SAFE; PWR_UNREG; BATT_INTERFACE; SOLAR_ARRAY1; GSE_DISARM GSE_RESET; EPS_SCL; EPS_SDA; GSE_PGEC; GSE_PGED; GSE_SEL0 GSE_SEL1 GSE_SEL2; EPS_IRQ EPS_RESET; GSE_CMD; GSE_TLM BATT_SAFE; GSE_INTERFACE; SYS_UNREG; SYS_REG_3V3; RTC_REG_3V3; PL1_REG_5V0; PL2_REG_5V0; RTC_RESET; EPS_SDA EPS_SCL EPS_IRQ EPS_RESET; GSE_CMD GSE_TLM; GSE_RESET; GSE_DISARM; GSE_PGED GSE_PGEC; SYSTEM_INTERFACE; SYSTEM_BUS_REG; PAYLOAD_BUS_REG; EPS_RESET; EPS_IRQ; COMMAND_IO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

Author/RE: Matt Voll | DATED: 05/19/2016 | COMPANY: Space Science & Engineering Lab

Reviewed By: | DATED: | TITLE: Phoenix EPS

Reviewed By: | DATED: | DOCUMENT NO: SSEL-E-5___ | REV: 3.0

NOTES:
This page is an overview of the full circuit showing the critical connections between sheets
Each block represents a subsheet of the schematic hierarchy

Approved: | DATED: | SHEET NAME: MASTER | B SIZE: SHEET: OF

D

D

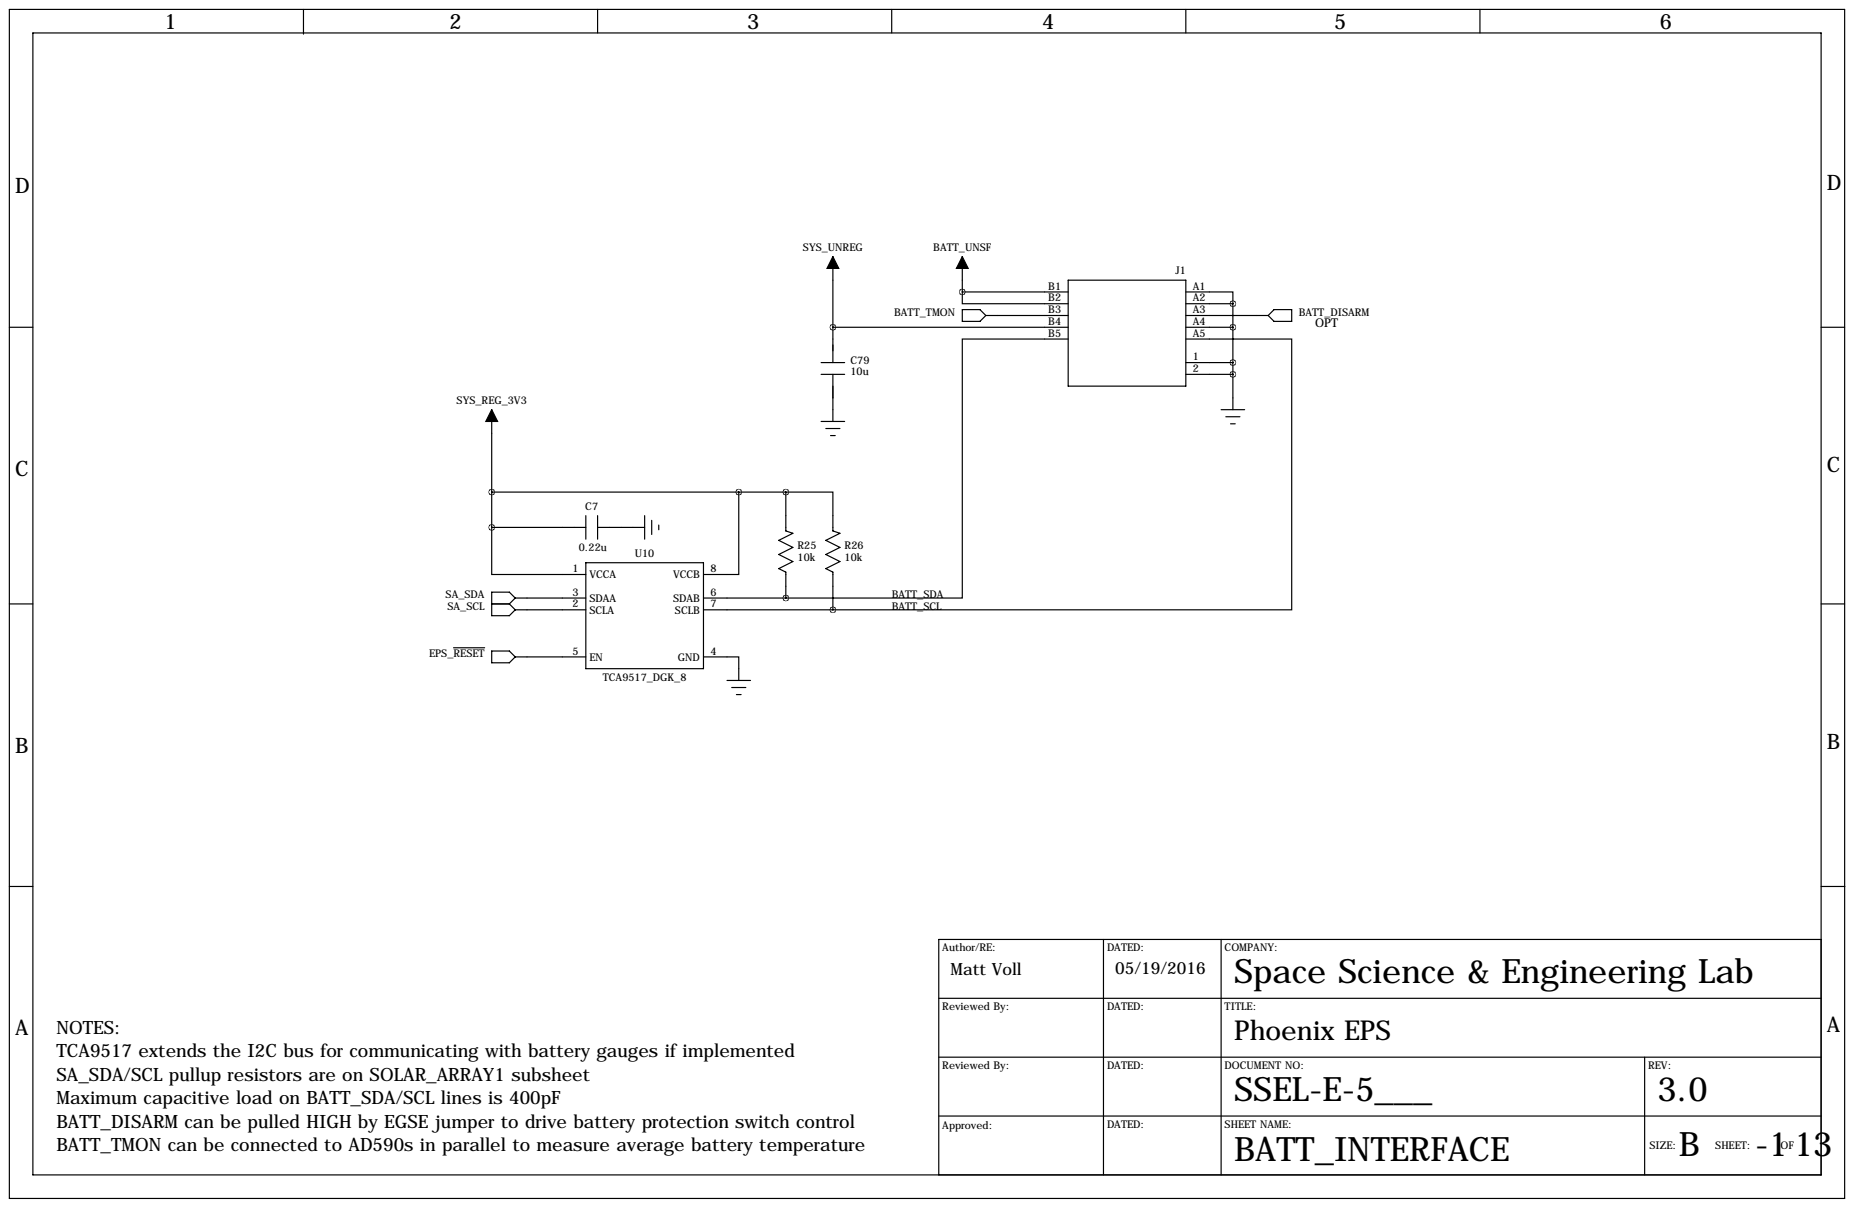
[picture p88: page 2]
OPT; VCCA; SCLA; SDAA; GND 5 EN; SDAB; SCLB; VCCB; TCA9517_DGK_8; BATT_UNSF; BATT_TMON; BATT_DISARM; SYS_UNREG; EPS_RESET; SYS_REG_3V3; SA_SCL; SA_SDA; BATT_SCL; BATT_SDA

Author/RE: Matt Voll | DATED: 05/19/2016 | COMPANY: Space Science & Engineering Lab

Reviewed By: | DATED: | TITLE: Phoenix EPS

NOTES:
TCA9517 extends the I2C bus for communicating with battery gauges if implemented
SA_SDA/SCL pullup resistors are on SOLAR_ARRAY1 subsheet
Maximum capacitive load on BATT_SDA/SCL lines is 400pF
BATT_DISARM can be pulled HIGH by EGSE jumper to drive battery protection switch control
BATT_TMON can be connected to AD590s in parallel to measure average battery temperature

Reviewed By: | DATED: | DOCUMENT NO: SSEL-E-5___ | REV: 3.0

BATT_INTERFACE

## DCAB

1

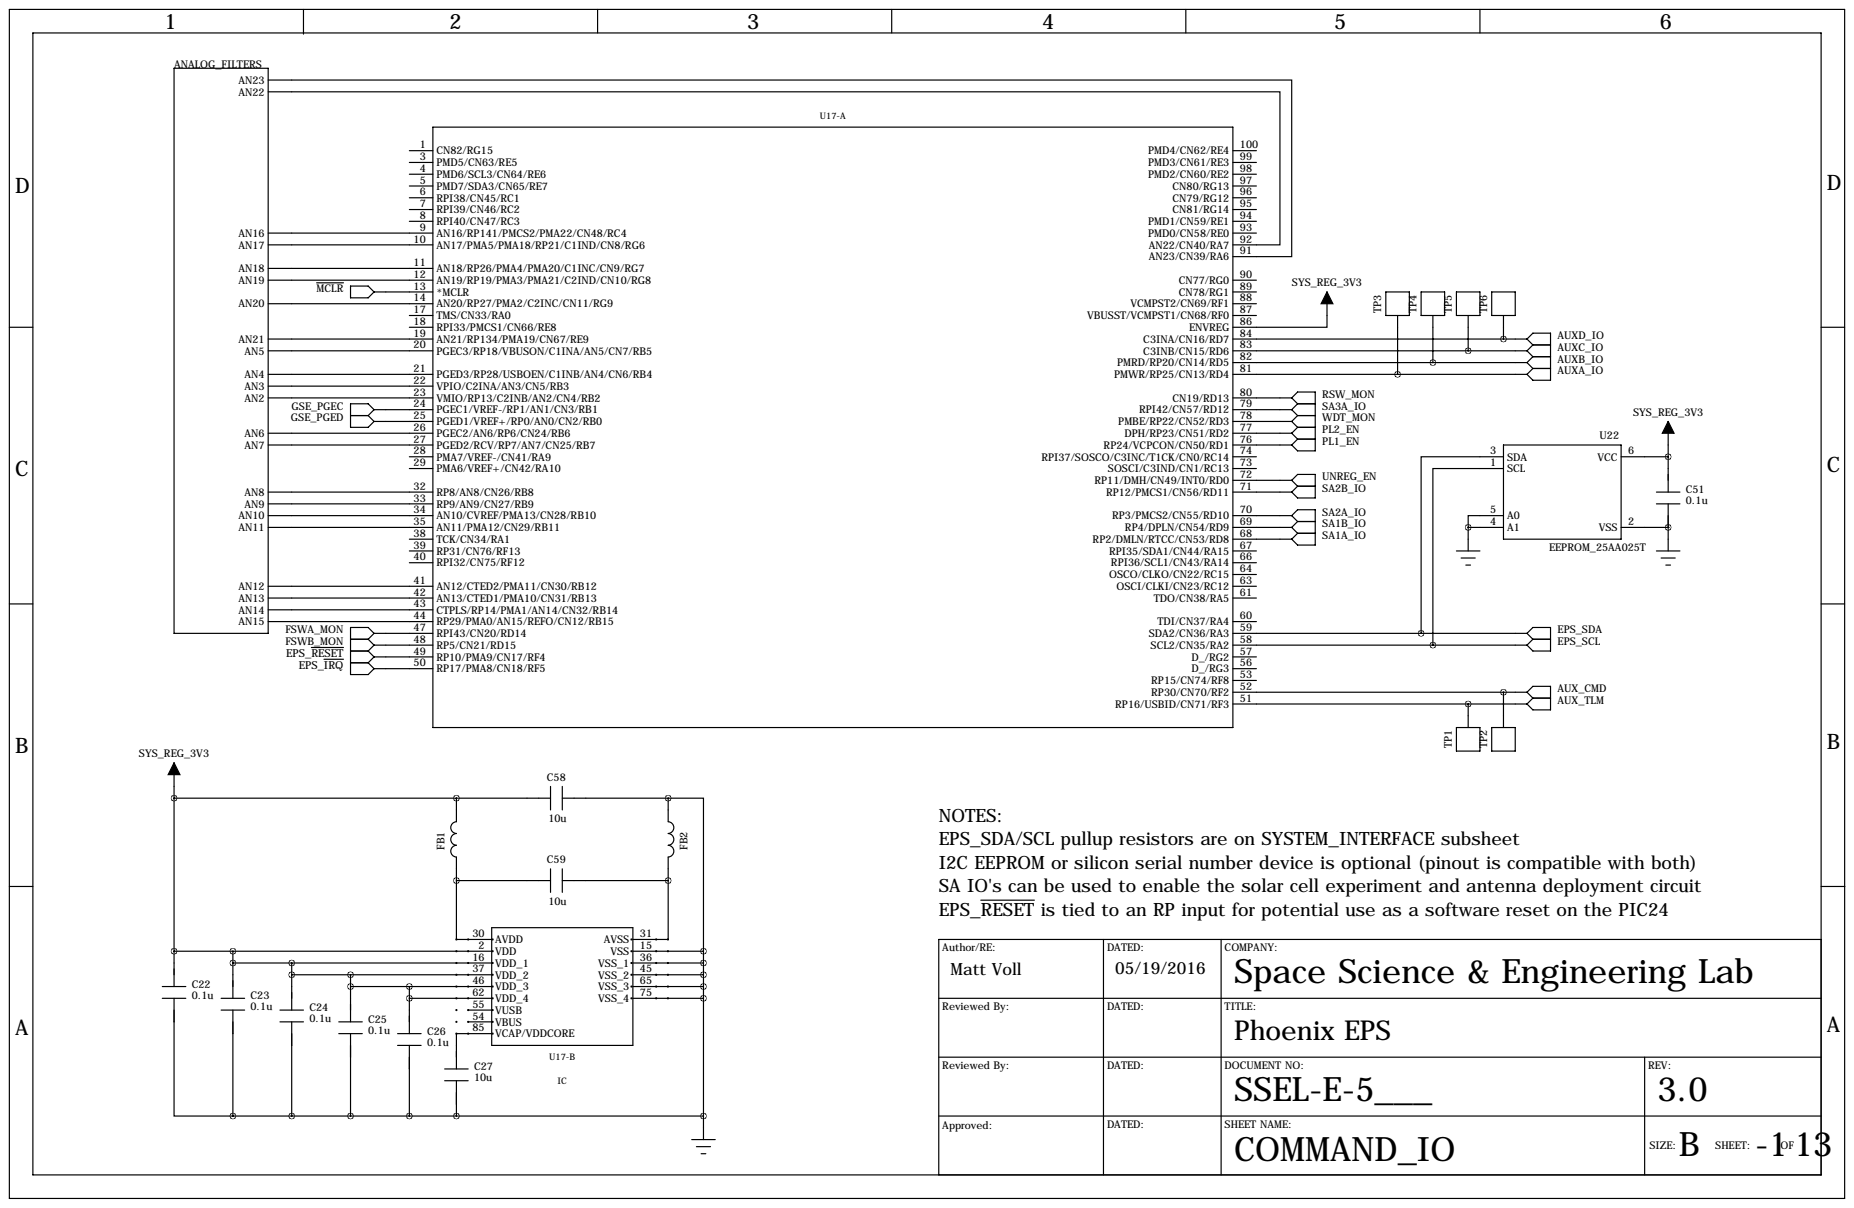
[picture p89: page 3]

NOTES:
EPS_SDA/SCL pullup resistors are on SYSTEM_INTERFACE subsheet
I2C EEPROM or silicon serial number device is optional (pinout is compatible with both)
SA IO's can be used to enable the solar cell experiment and antenna deployment circuit
EPS_RESET is tied to an RP input for potential use as a software reset on the PIC24

Author/RE: Matt Voll | DATED: 05/19/2016 | COMPANY: Space Science & Engineering Lab

Reviewed By: | DATED: | TITLE: Phoenix EPS

Reviewed By: | DATED: | DOCUMENT NO: SSEL-E-5___ | REV: 3.0

COMMAND_IO

D

D

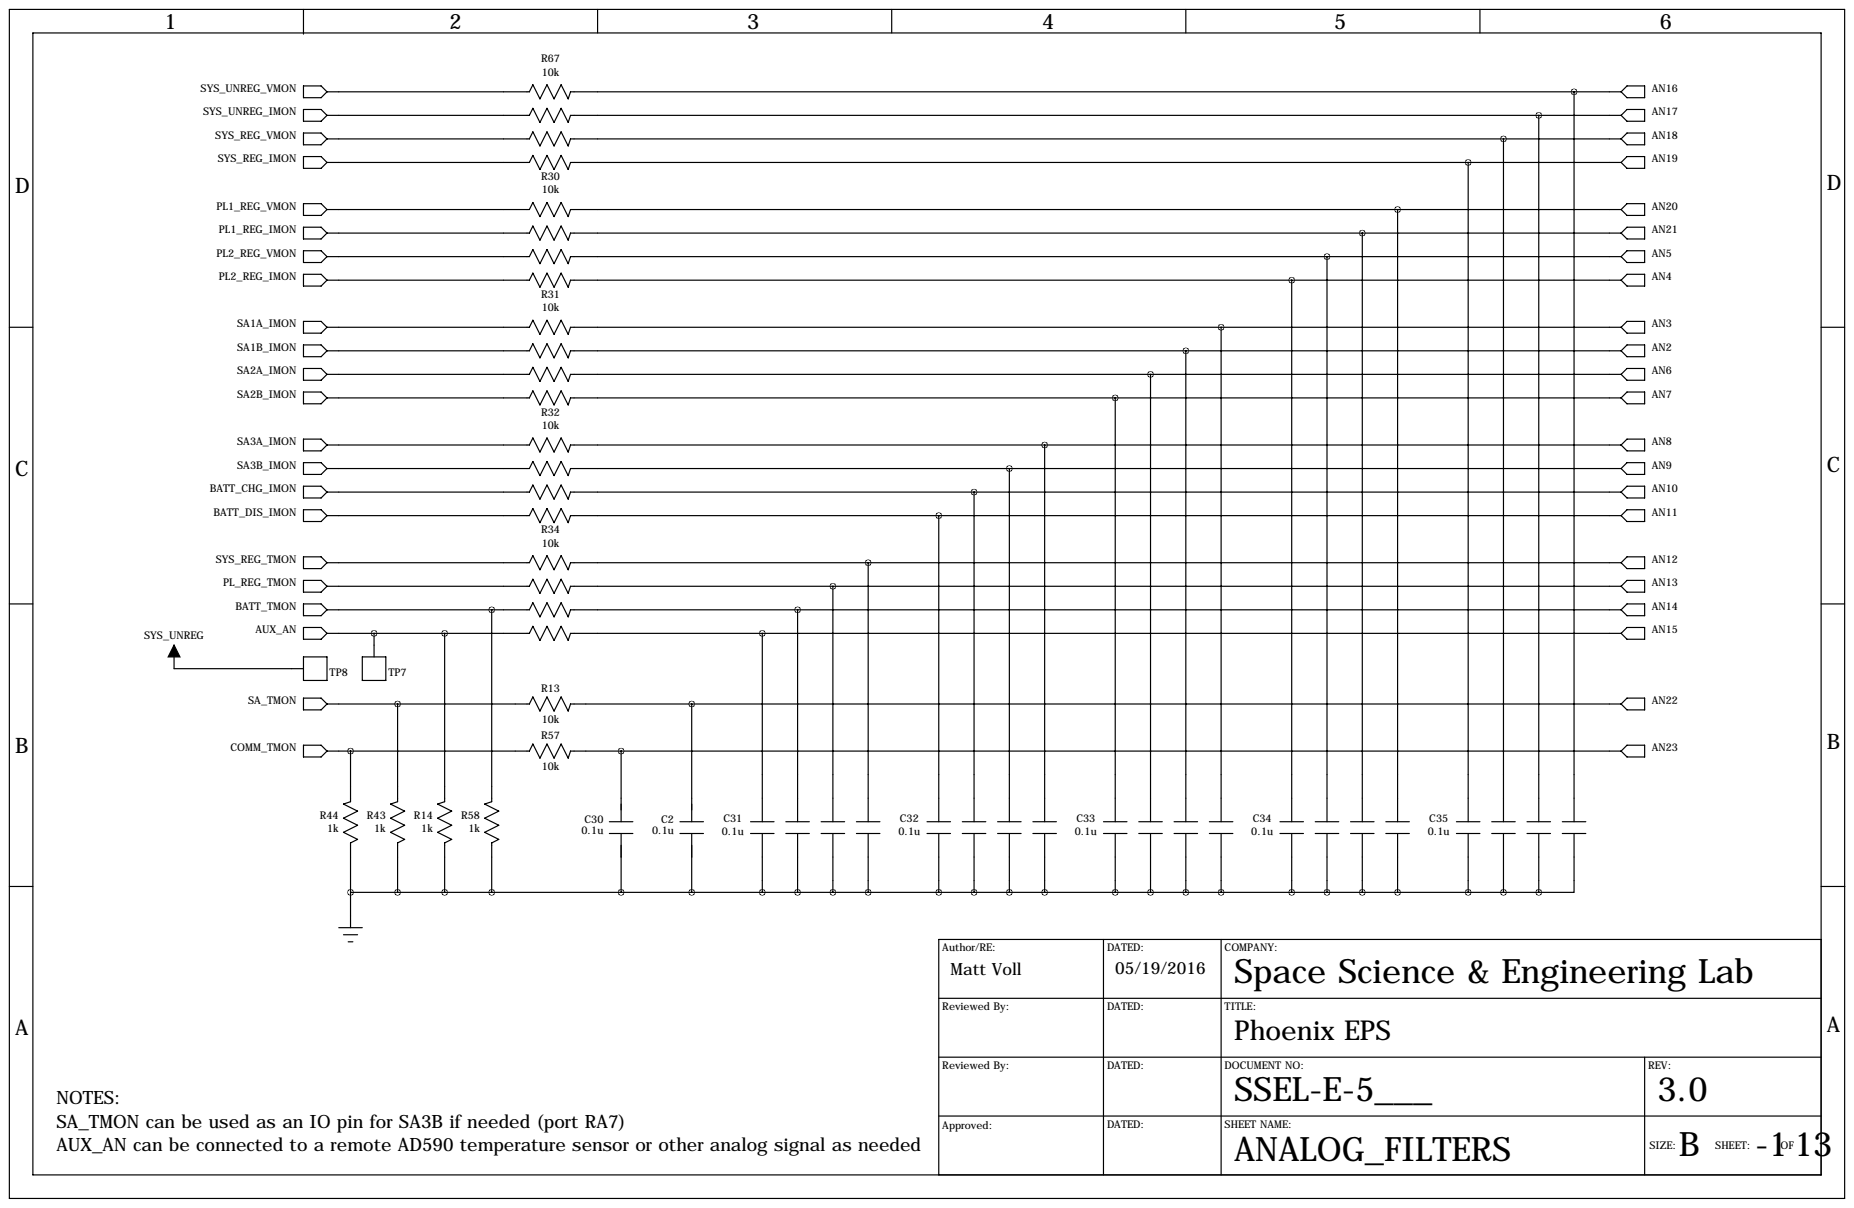
[picture p90: page 4]

Author/RE: Matt Voll | DATED: 05/19/2016 | COMPANY: Space Science & Engineering Lab

Reviewed By: | DATED: | TITLE: Phoenix EPS

Reviewed By: | DATED: | DOCUMENT NO: SSEL-E-5___ | REV: 3.0

NOTES:
SA_TMON can be used as an IO pin for SA3B if needed (port RA7)
AUX_AN can be connected to a remote AD590 temperature sensor or other analog signal as needed

ANALOG_FILTERS

D

D

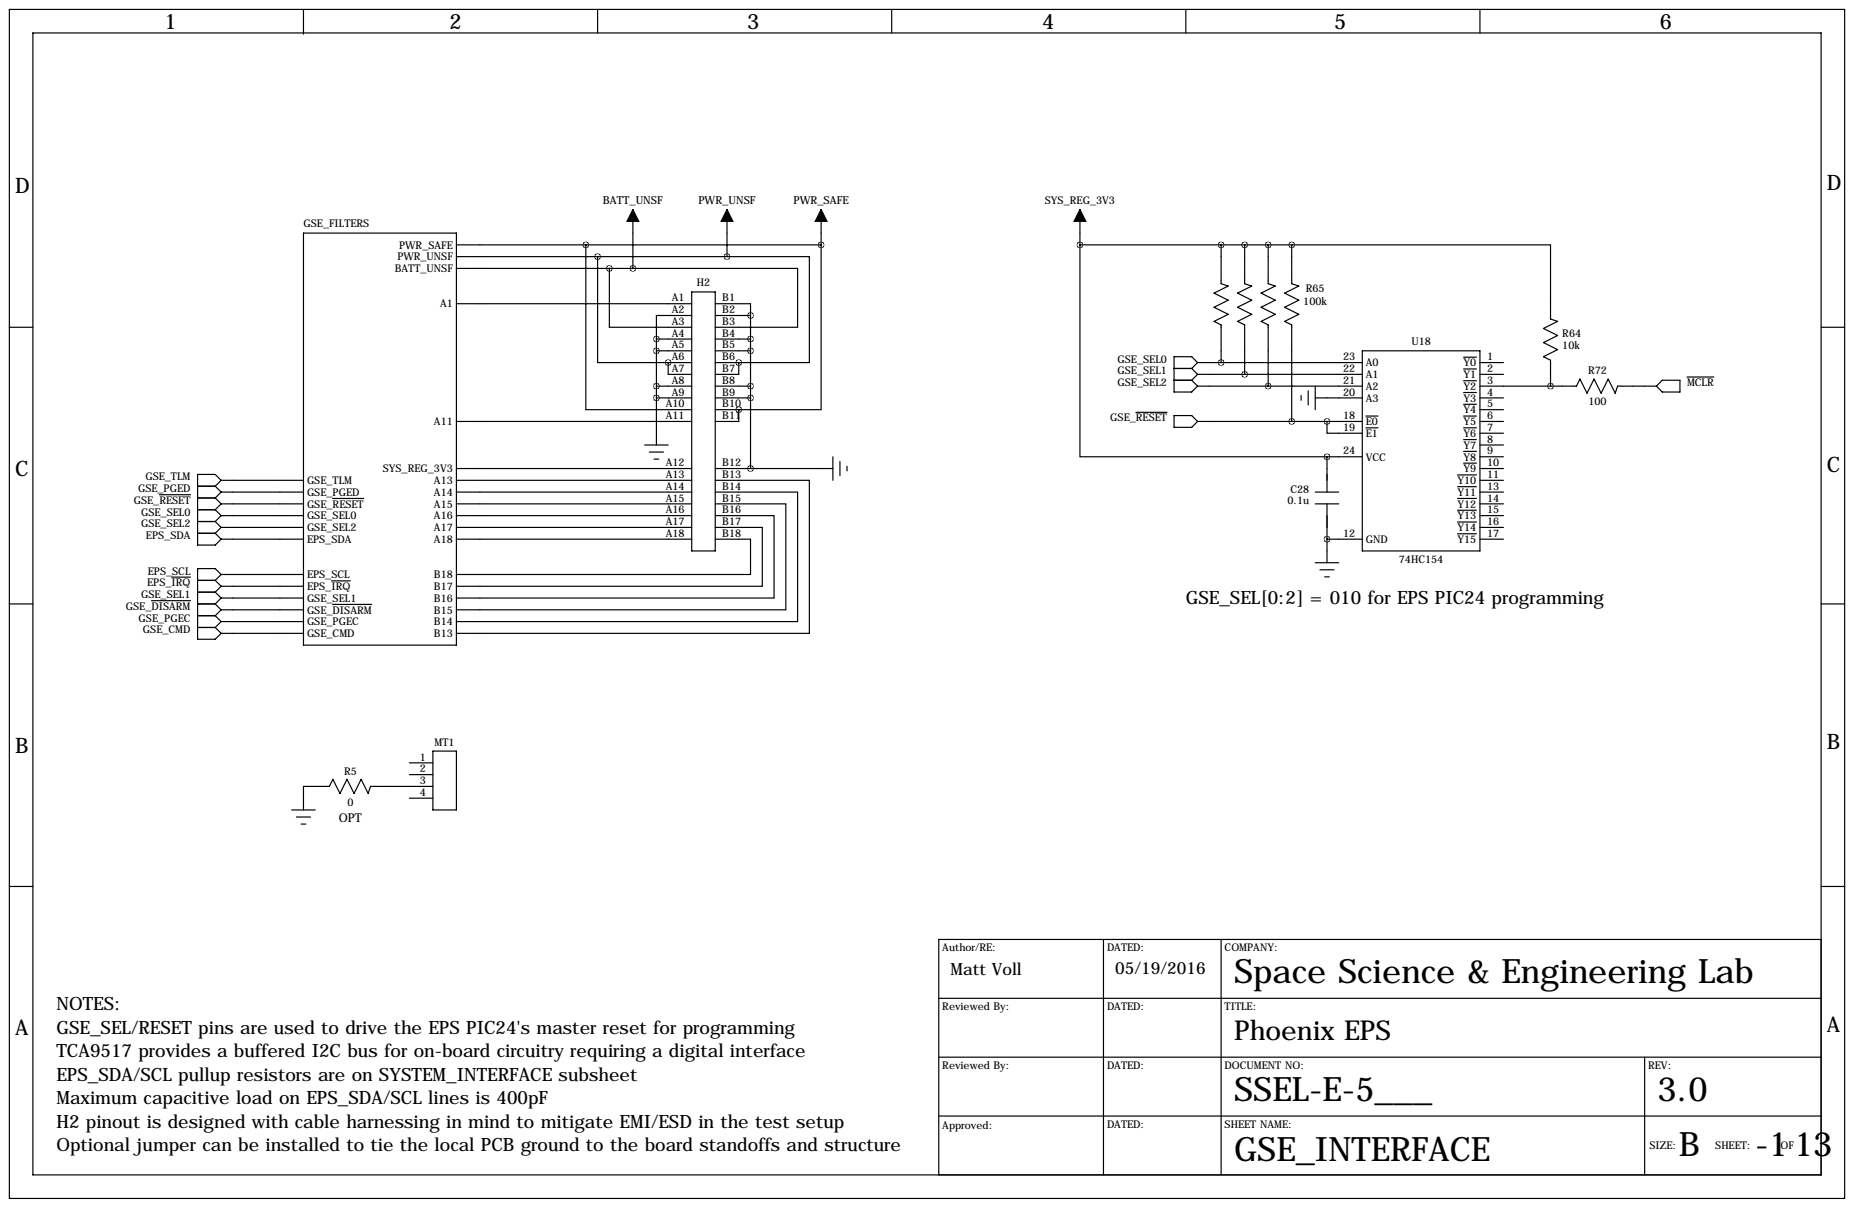
[picture p91: page 5]
OPT; GND; VCC; PWR_SAFE PWR_UNSF BATT_UNSF; SYS_REG_3V3; GSE_TLM GSE_PGED; GSE_CMD; GSE_PGEC; GSE_RESET; GSE_DISARM; GSE_SEL0 GSE_SEL2; GSE_SEL1; EPS_SDA; EPS_SCL EPS_IRQ; GSE_FILTERS; GSE_SEL0 GSE_SEL1 GSE_SEL2; GSE_TLM; GSE_PGED; GSE_SEL0; GSE_SEL2 EPS_SDA; EPS_SCL; MCLR; EPS_IRQ; BATT_UNSF; PWR_UNSF; PWR_SAFE

A2 | B2
A3 | B3

A5 | | B5
A6 | | B6
A7 | | B7

A9 | | B9
A10 | | B10
A11 | | B11

A12 | | B12
A13 | | B13
A14 | | B14
A15 | | B15
A16 | | B16
A17 | | B17
A18 | | B18

GSE_SEL[0:2] = 010 for EPS PIC24 programming

Author/RE: Matt Voll | DATED: 05/19/2016 | COMPANY: Space Science & Engineering Lab

NOTES:
GSE_SEL/RESET pins are used to drive the EPS PIC24's master reset for programming
TCA9517 provides a buffered I2C bus for on-board circuitry requiring a digital interface
EPS_SDA/SCL pullup resistors are on SYSTEM_INTERFACE subsheet
Maximum capacitive load on EPS_SDA/SCL lines is 400pF
H2 pinout is designed with cable harnessing in mind to mitigate EMI/ESD in the test setup
Optional jumper can be installed to tie the local PCB ground to the board standoffs and structure

Reviewed By: | DATED: | TITLE: Phoenix EPS

Reviewed By: | DATED: | DOCUMENT NO: SSEL-E-5___ | REV: 3.0

GSE_INTERFACE

D
D

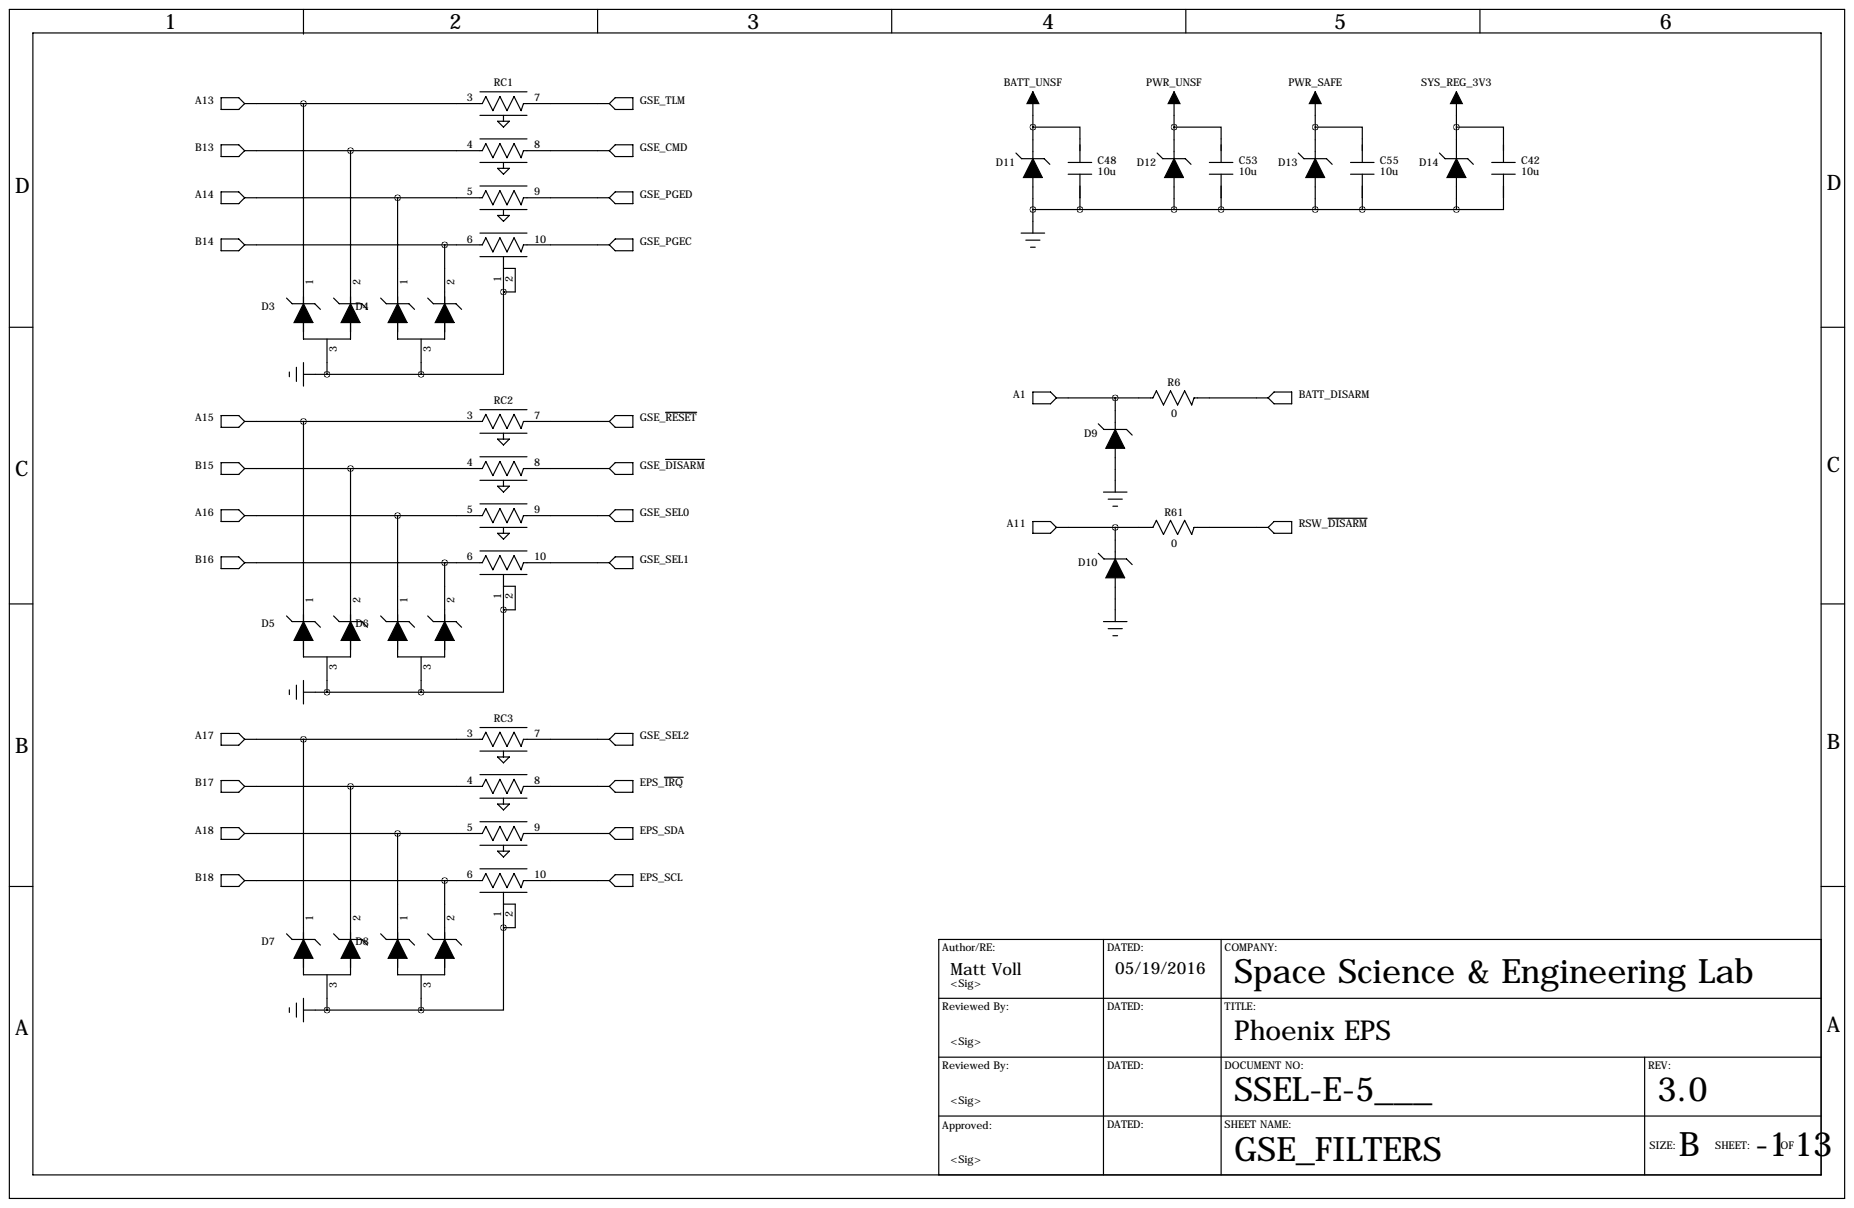
[picture p92: page 6]

Author/RE: Matt Voll <Sig> | DATED: 05/19/2016 | COMPANY: Space Science & Engineering Lab

Reviewed By: <Sig> | DATED: | TITLE: Phoenix EPS

Reviewed By: <Sig> | DATED: | DOCUMENT NO: SSEL-E-5___ | REV: 3.0

<Sig> | | GSE_FILTERS

D

D

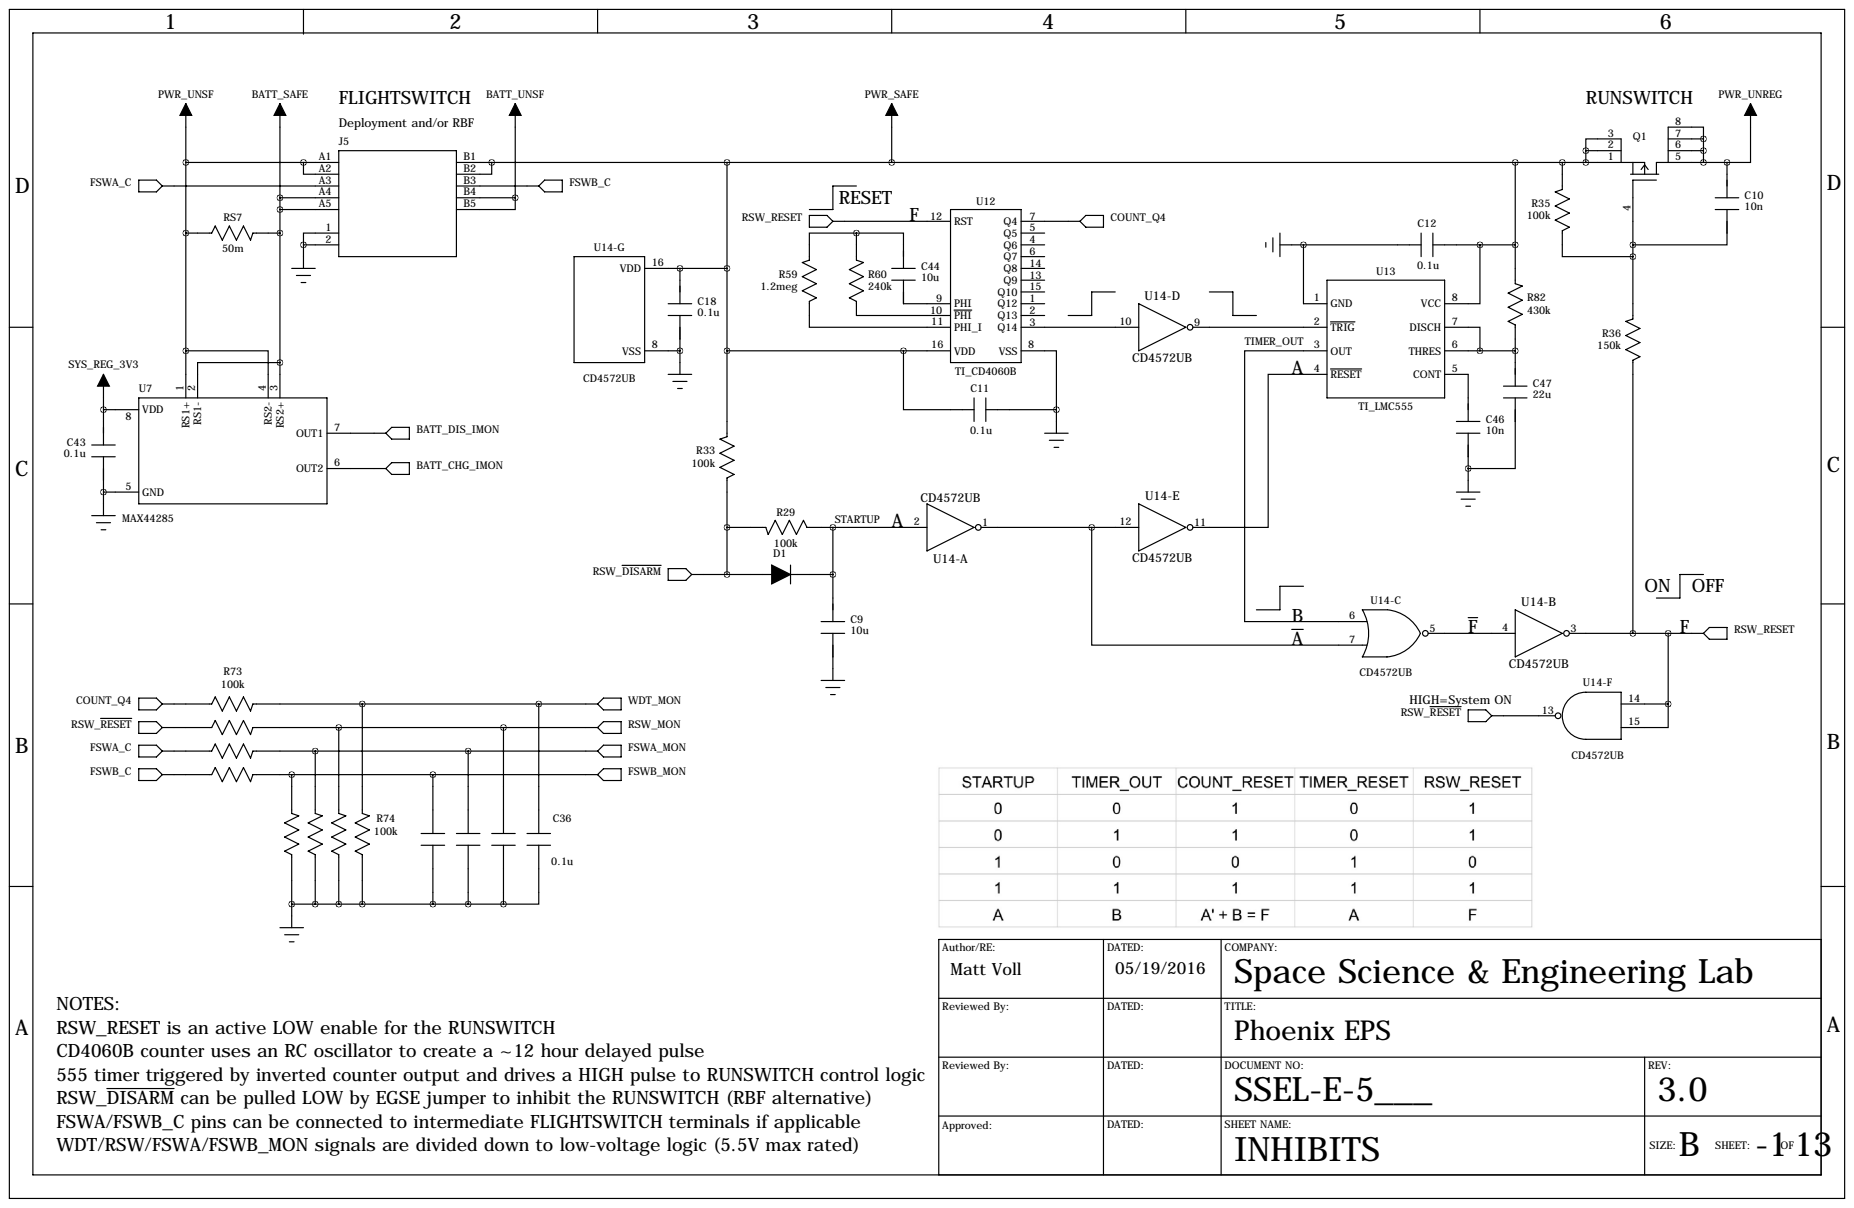
[picture p93: page 7]

Deployment and/or RBF

Author/RE: Matt Voll | DATED: 05/19/2016 | COMPANY: Space Science & Engineering Lab

NOTES:
RSW_RESET is an active LOW enable for the RUNSWITCH
CD4060B counter uses an RC oscillator to create a ~12 hour delayed pulse
555 timer triggered by inverted counter output and drives a HIGH pulse to RUNSWITCH control logic
RSW_DISARM can be pulled LOW by EGSE jumper to inhibit the RUNSWITCH (RBF alternative)
FSWA/FSWB_C pins can be connected to intermediate FLIGHTSWITCH terminals if applicable
WDT/RSW/FSWA/FSWB_MON signals are divided down to low-voltage logic (5.5V max rated)

Reviewed By: | DATED: | TITLE: Phoenix EPS

Reviewed By: | DATED: | DOCUMENT NO: SSEL-E-5___ | REV: 3.0

INHIBITS

D
D

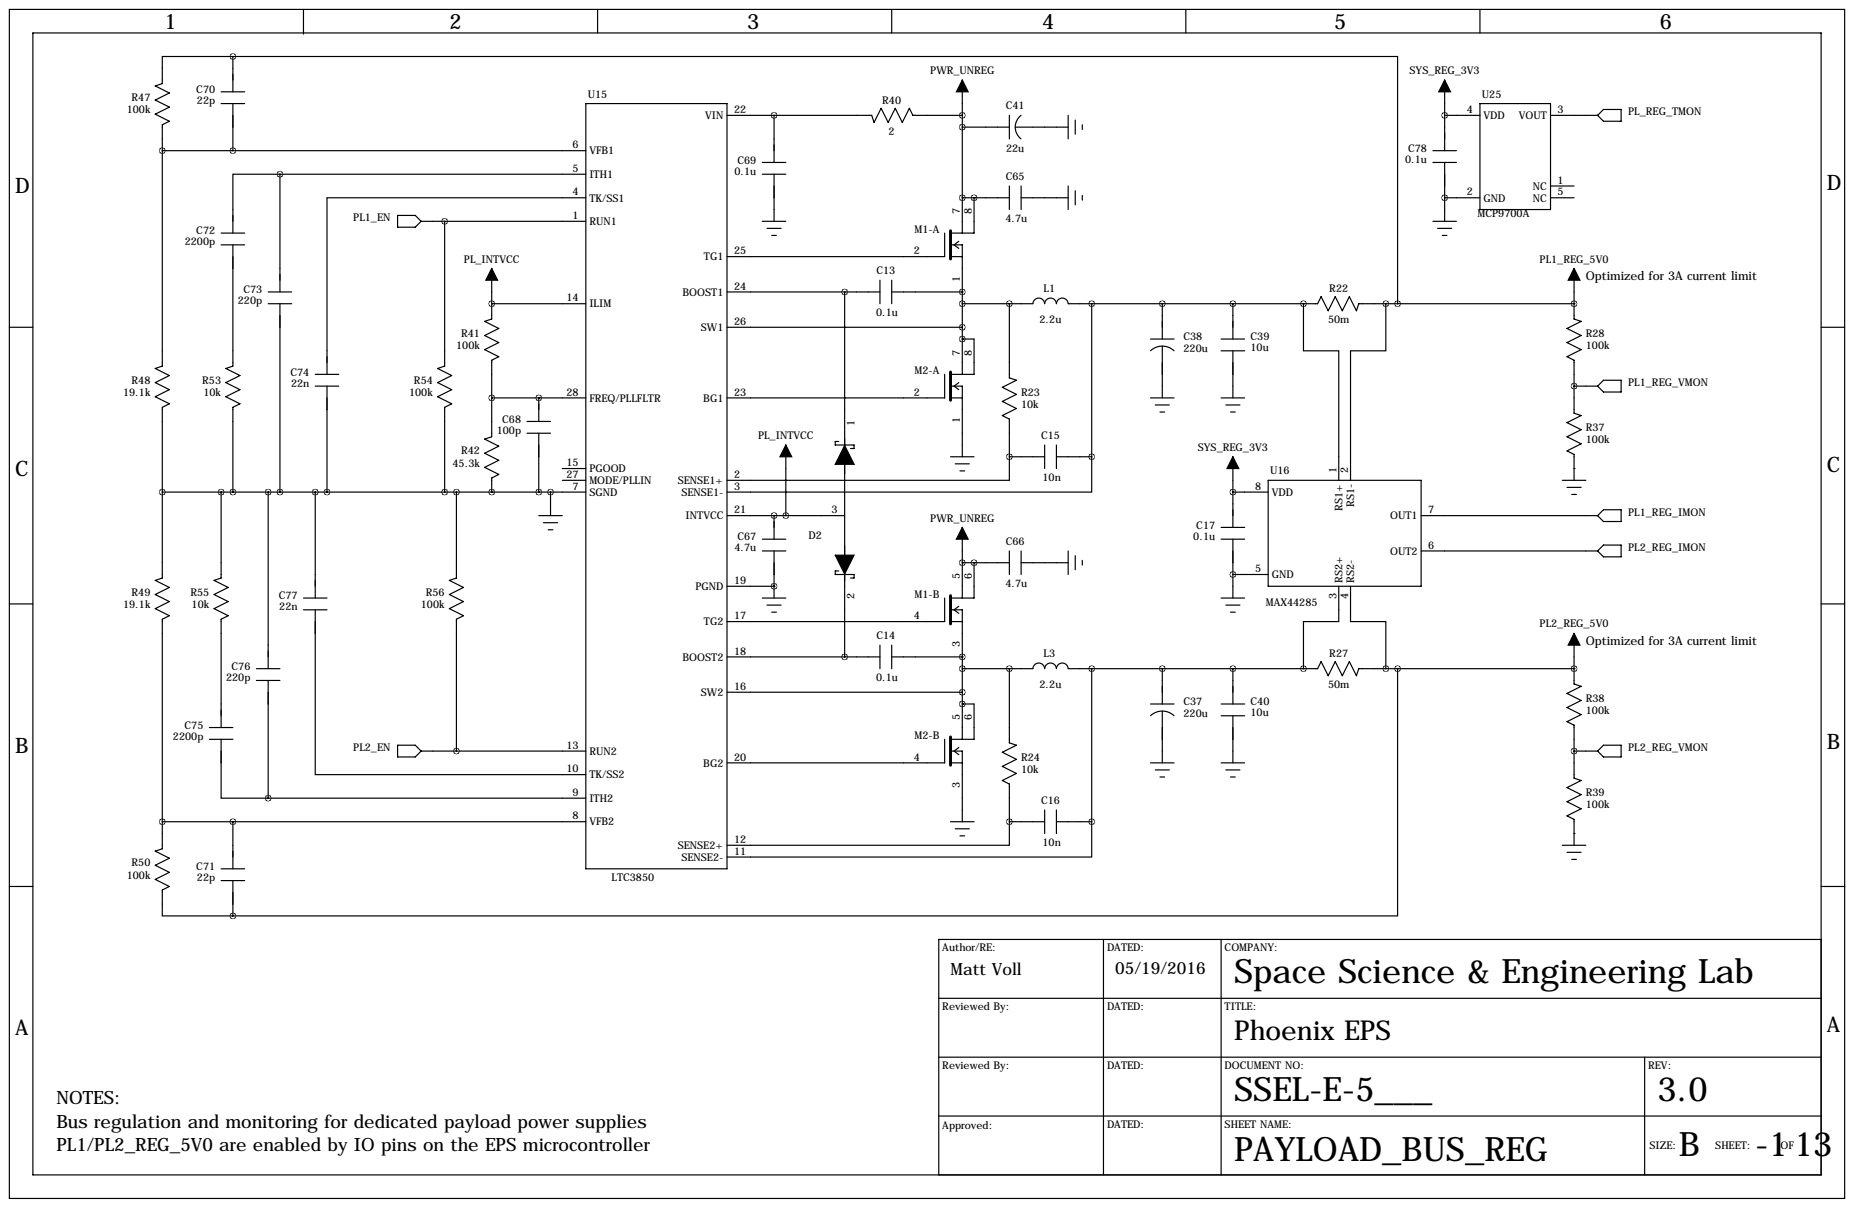
[picture p94: page 8]

Optimized for 3A current limit

Author/RE: Matt Voll | DATED: 05/19/2016 | COMPANY: Space Science & Engineering Lab

Reviewed By: | DATED: | TITLE: Phoenix EPS

Reviewed By: | DATED: | DOCUMENT NO: SSEL-E-5___ | REV: 3.0

NOTES:
Bus regulation and monitoring for dedicated payload power supplies
PL1/PL2_REG_5V0 are enabled by IO pins on the EPS microcontroller

PAYLOAD_BUS_REG

D

D

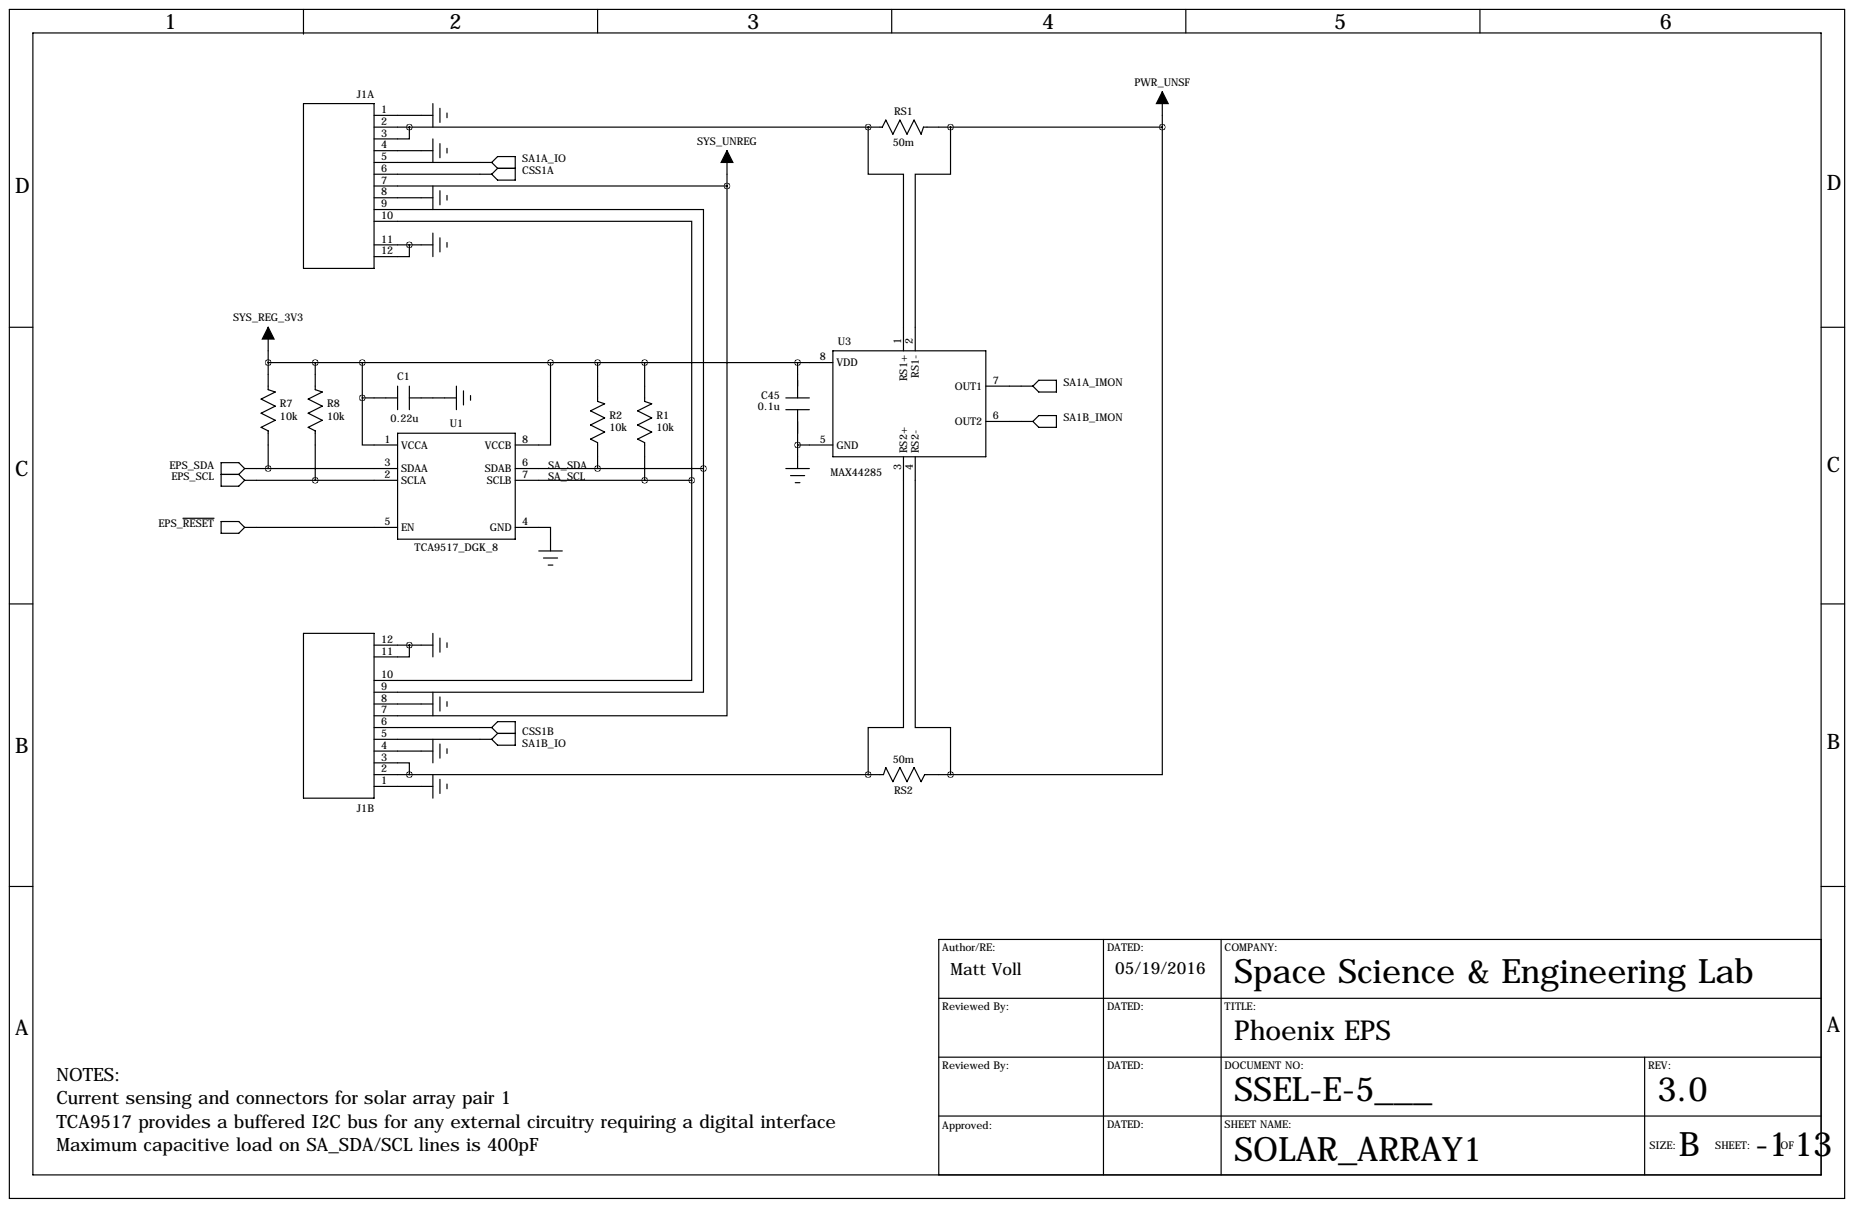
[picture p95: page 9]

Author/RE: Matt Voll | DATED: 05/19/2016 | COMPANY: Space Science & Engineering Lab

Reviewed By: | DATED: | TITLE: Phoenix EPS

NOTES:
Current sensing and connectors for solar array pair 1
TCA9517 provides a buffered I2C bus for any external circuitry requiring a digital interface
Maximum capacitive load on SA_SDA/SCL lines is 400pF

Reviewed By: | DATED: | DOCUMENT NO: SSEL-E-5___ | REV: 3.0

SOLAR_ARRAY1

D
D

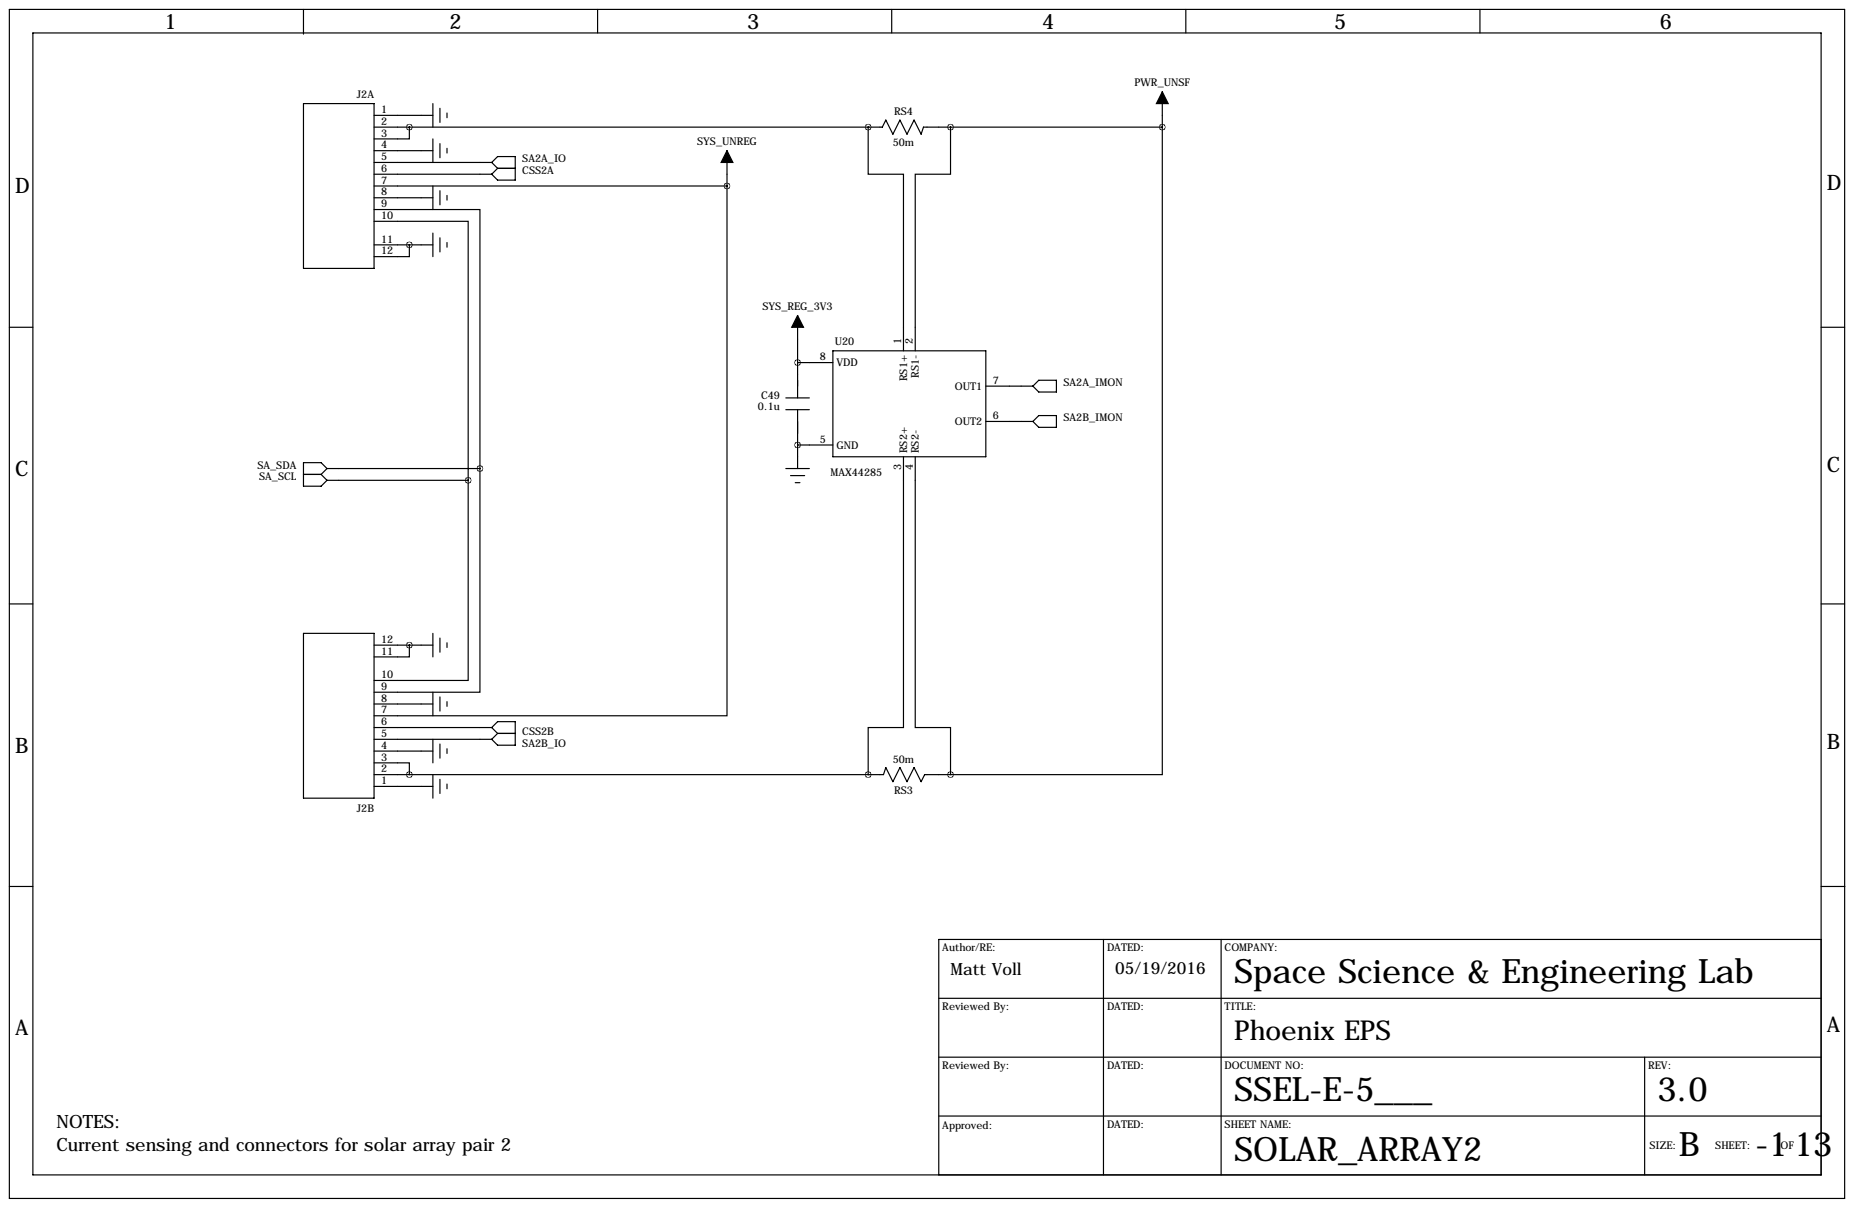
[picture p96: page 10]
GND; OUT2; OUT1; VDD; MAX44285; CSS2B; PWR_UNSF; SYS_REG_3V3; SA2A_IO CSS2A; SYS_UNREG; SA_SDA SA_SCL; SA2A_IMON; SA2B_IMON

Author/RE: Matt Voll | DATED: 05/19/2016 | COMPANY: Space Science & Engineering Lab

Reviewed By: | DATED: | TITLE: Phoenix EPS

Reviewed By: | DATED: | DOCUMENT NO: SSEL-E-5___ | REV: 3.0

NOTES:
Current sensing and connectors for solar array pair 2

SOLAR_ARRAY2

D

D

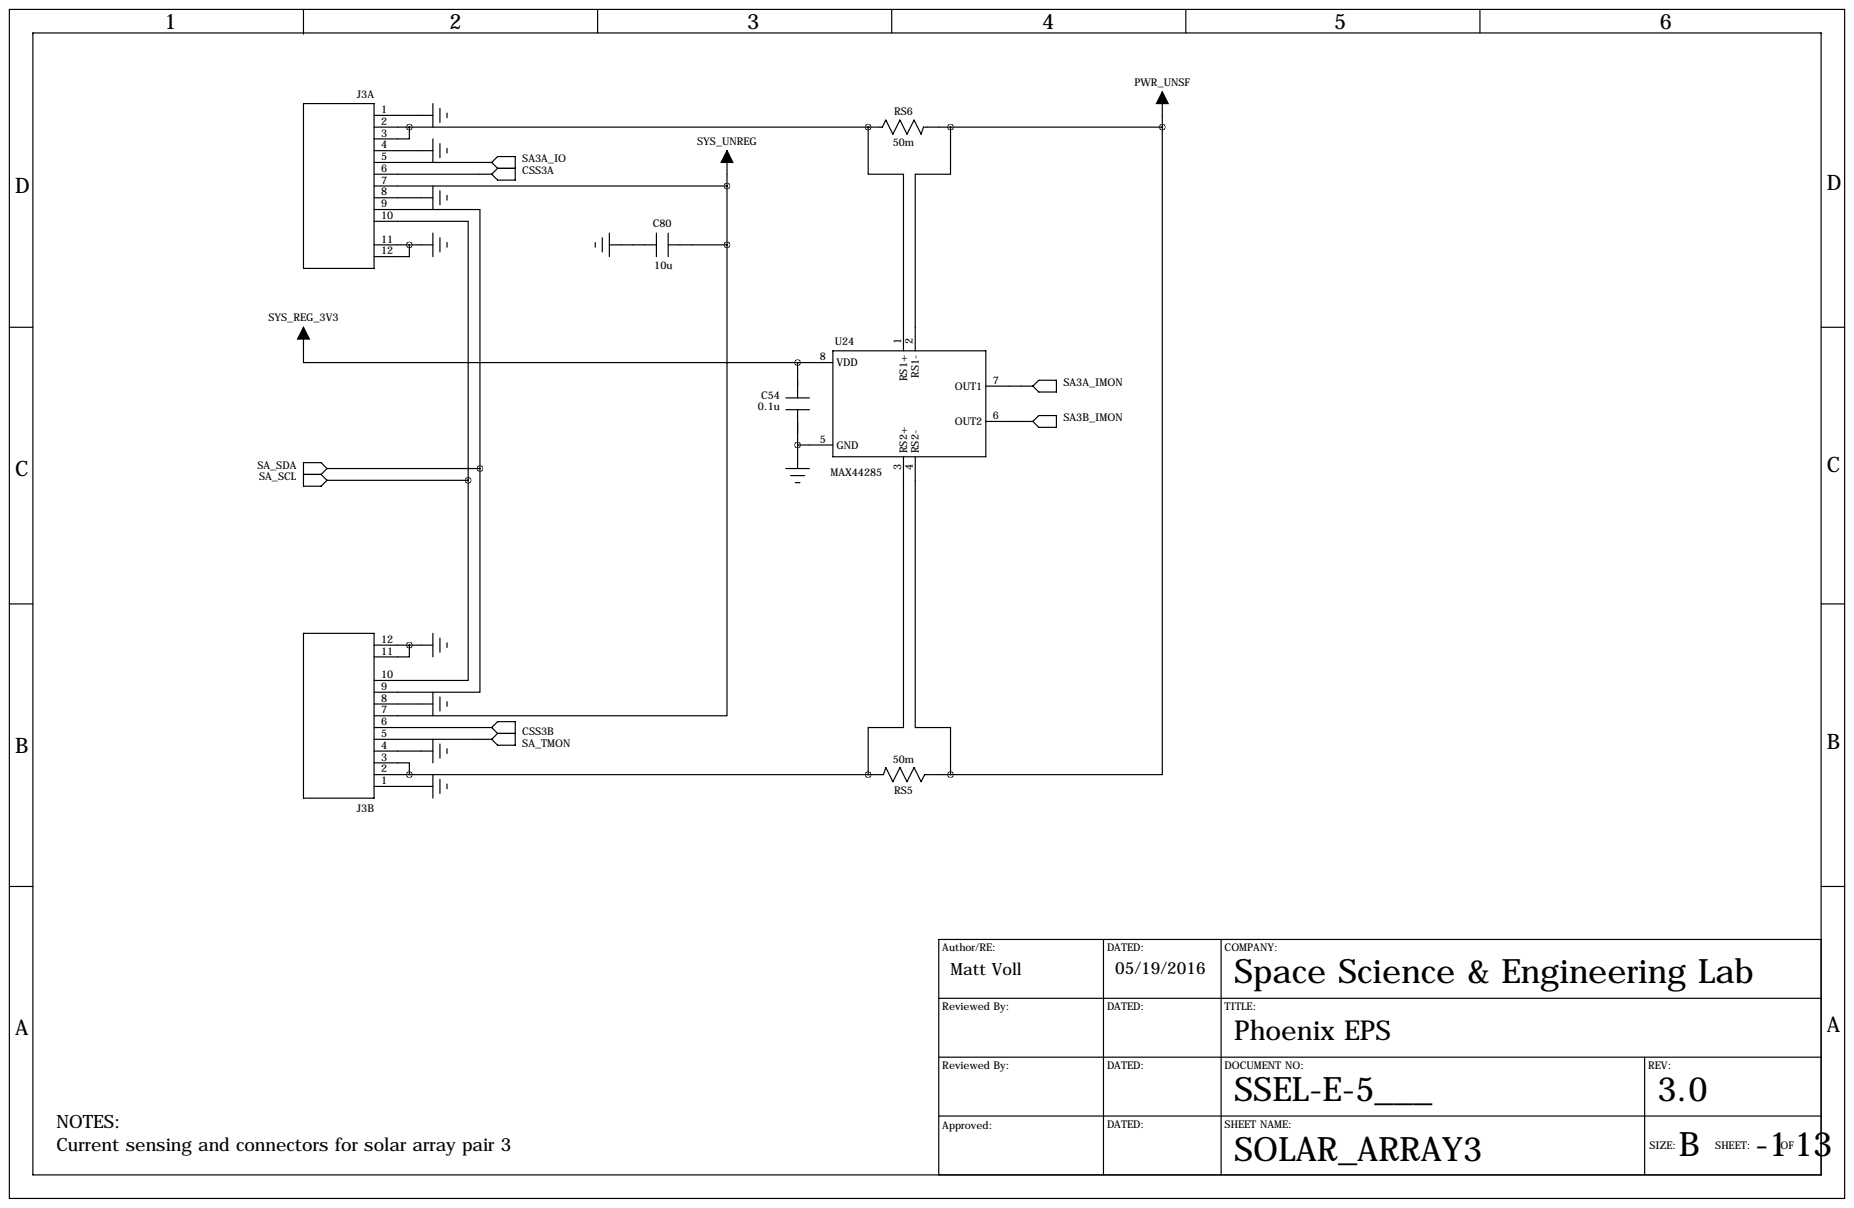
[picture p97: page 11]
GND; OUT2; OUT1; VDD; MAX44285; CSS3B; PWR_UNSF; SYS_REG_3V3; CSS3A; SYS_UNREG; SA_SDA SA_SCL; SA3A_IMON; SA3B_IMON; SA_TMON

Author/RE: Matt Voll | DATED: 05/19/2016 | COMPANY: Space Science & Engineering Lab

Reviewed By: | DATED: | TITLE: Phoenix EPS

Reviewed By: | DATED: | DOCUMENT NO: SSEL-E-5___ | REV: 3.0

NOTES:
Current sensing and connectors for solar array pair 3

SOLAR_ARRAY3

D
D

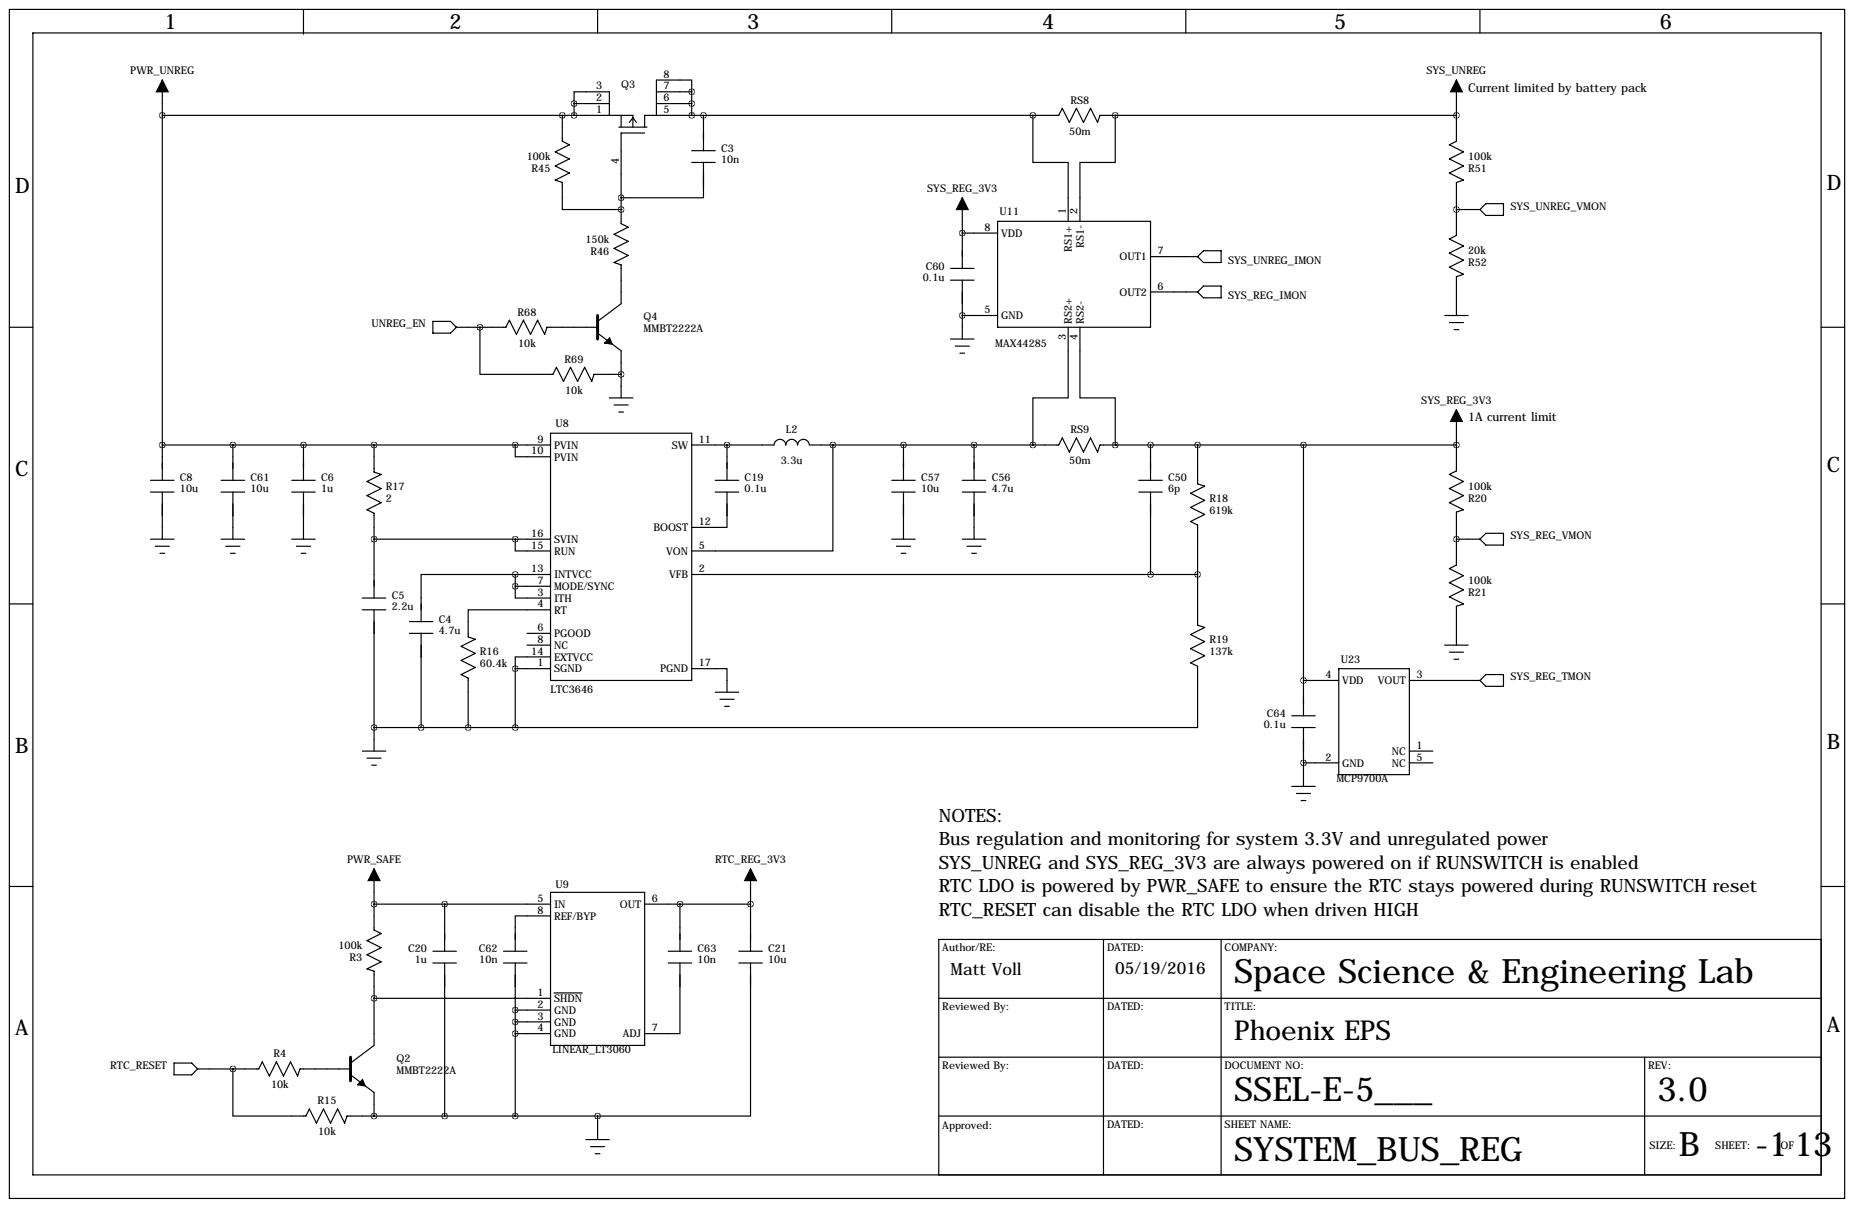
[picture p98: page 12]

Current limited by battery pack

NOTES:
Bus regulation and monitoring for system 3.3V and unregulated power
SYS_UNREG and SYS_REG_3V3 are always powered on if RUNSWITCH is enabled
RTC LDO is powered by PWR_SAFE to ensure the RTC stays powered during RUNSWITCH reset
RTC_RESET can disable the RTC LDO when driven HIGH

COMPANY:
Space Science & Engineering Lab

Reviewed By: | DATED: | DOCUMENT NO: SSEL-E-5___ | REV: 3.0

SYSTEM_BUS_REG | B -1 13

D
D

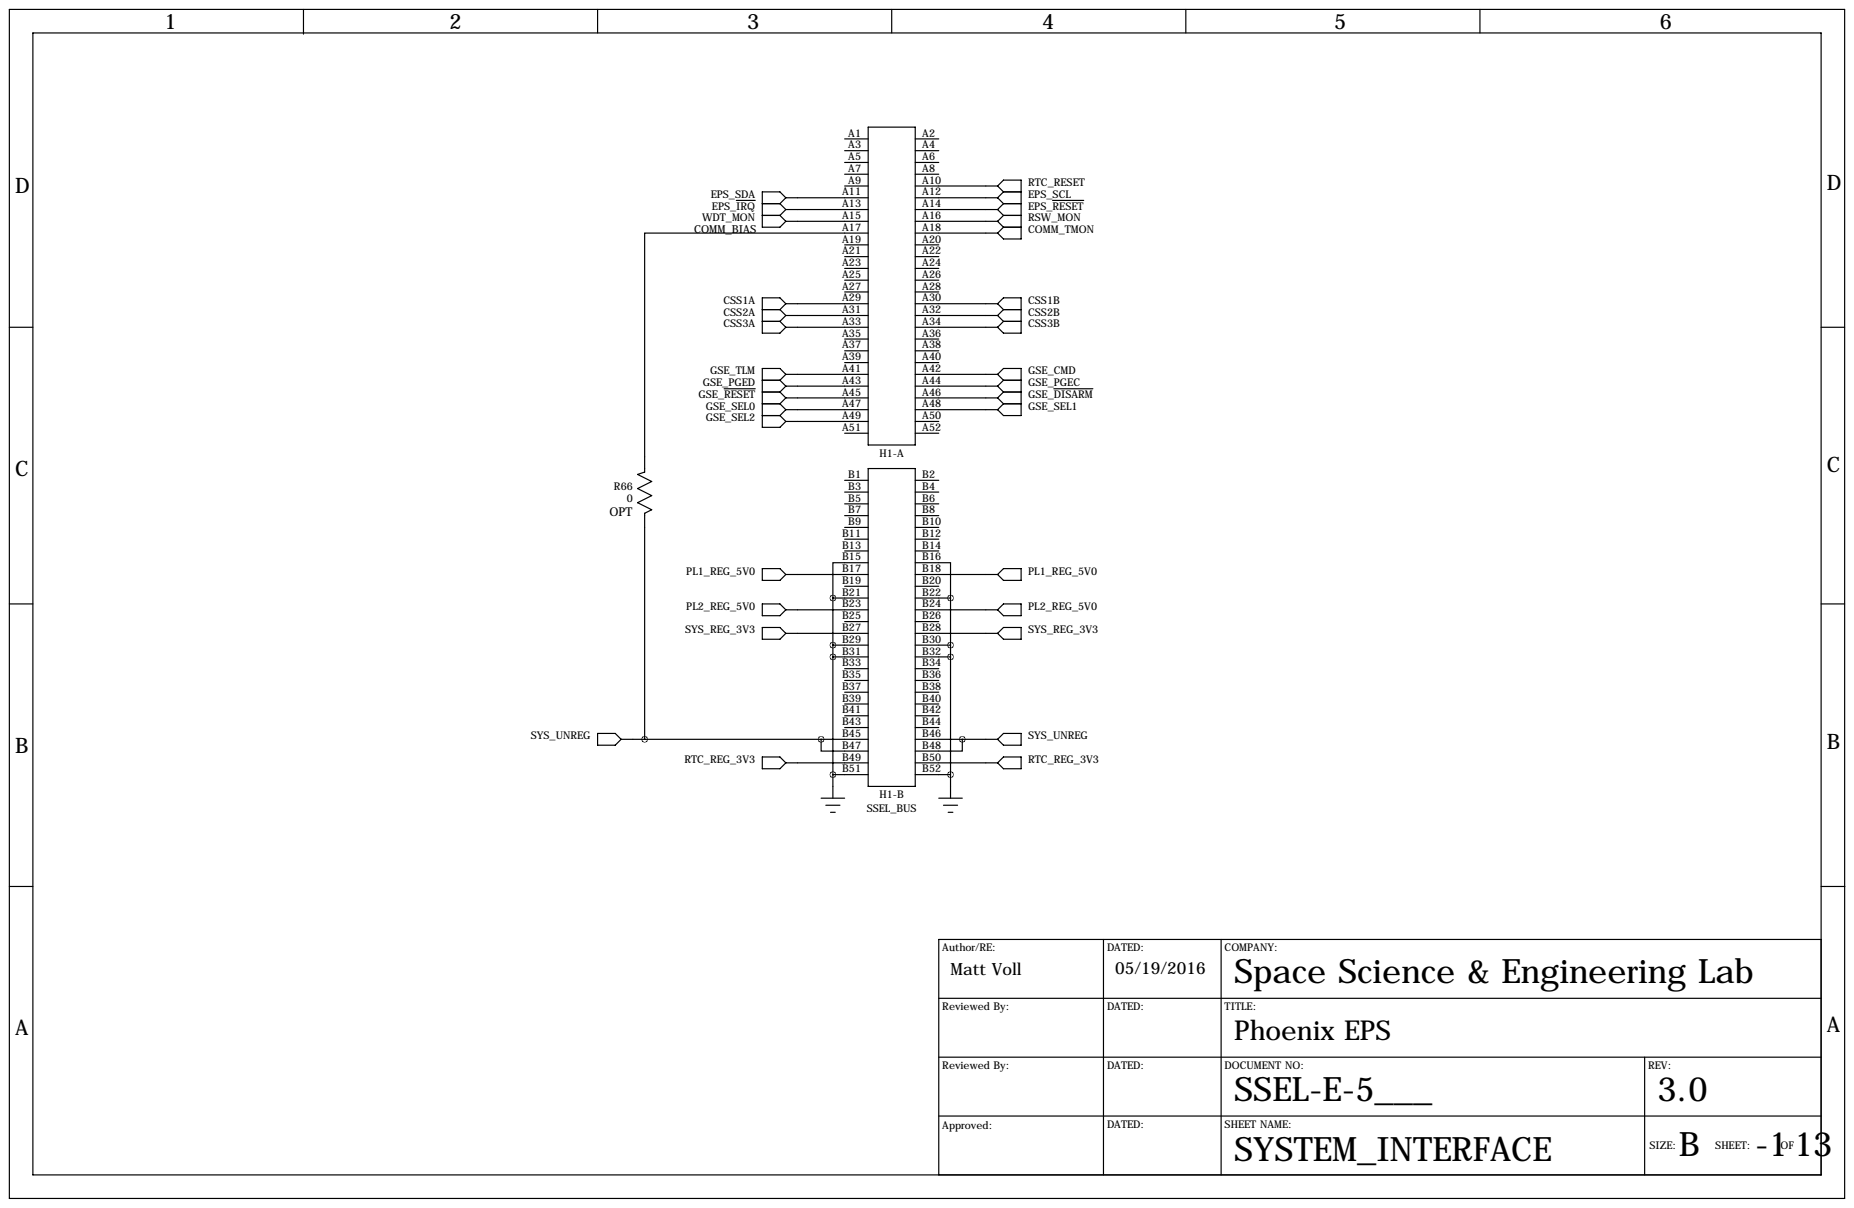
[picture p99: page 13]
OPT; H1-B SSEL_BUS; EPS_SDA; EPS_SCL; EPS_IRQ WDT_MON; EPS_RESET RSW_MON; RTC_RESET; GSE_SEL2; GSE_SEL0; GSE_SEL1; GSE_RESET; GSE_DISARM; GSE_PGED; GSE_PGEC; GSE_TLM; GSE_CMD; CSS1A; CSS1B; CSS2A; CSS2B; CSS3A; CSS3B; COMM_TMON; SYS_UNREG; RTC_REG_3V3; SYS_REG_3V3; PL2_REG_5V0; PL1_REG_5V0; COMM_BIAS

Author/RE: Matt Voll | DATED: 05/19/2016 | COMPANY: Space Science & Engineering Lab

Reviewed By: | DATED: | TITLE: Phoenix EPS

Reviewed By: | DATED: | DOCUMENT NO: SSEL-E-5___ | REV: 3.0

SYSTEM_INTERFACE
