mattyv06/thesis/figs/phoenix/manufacturing/phoenix_assembly_top.pdf

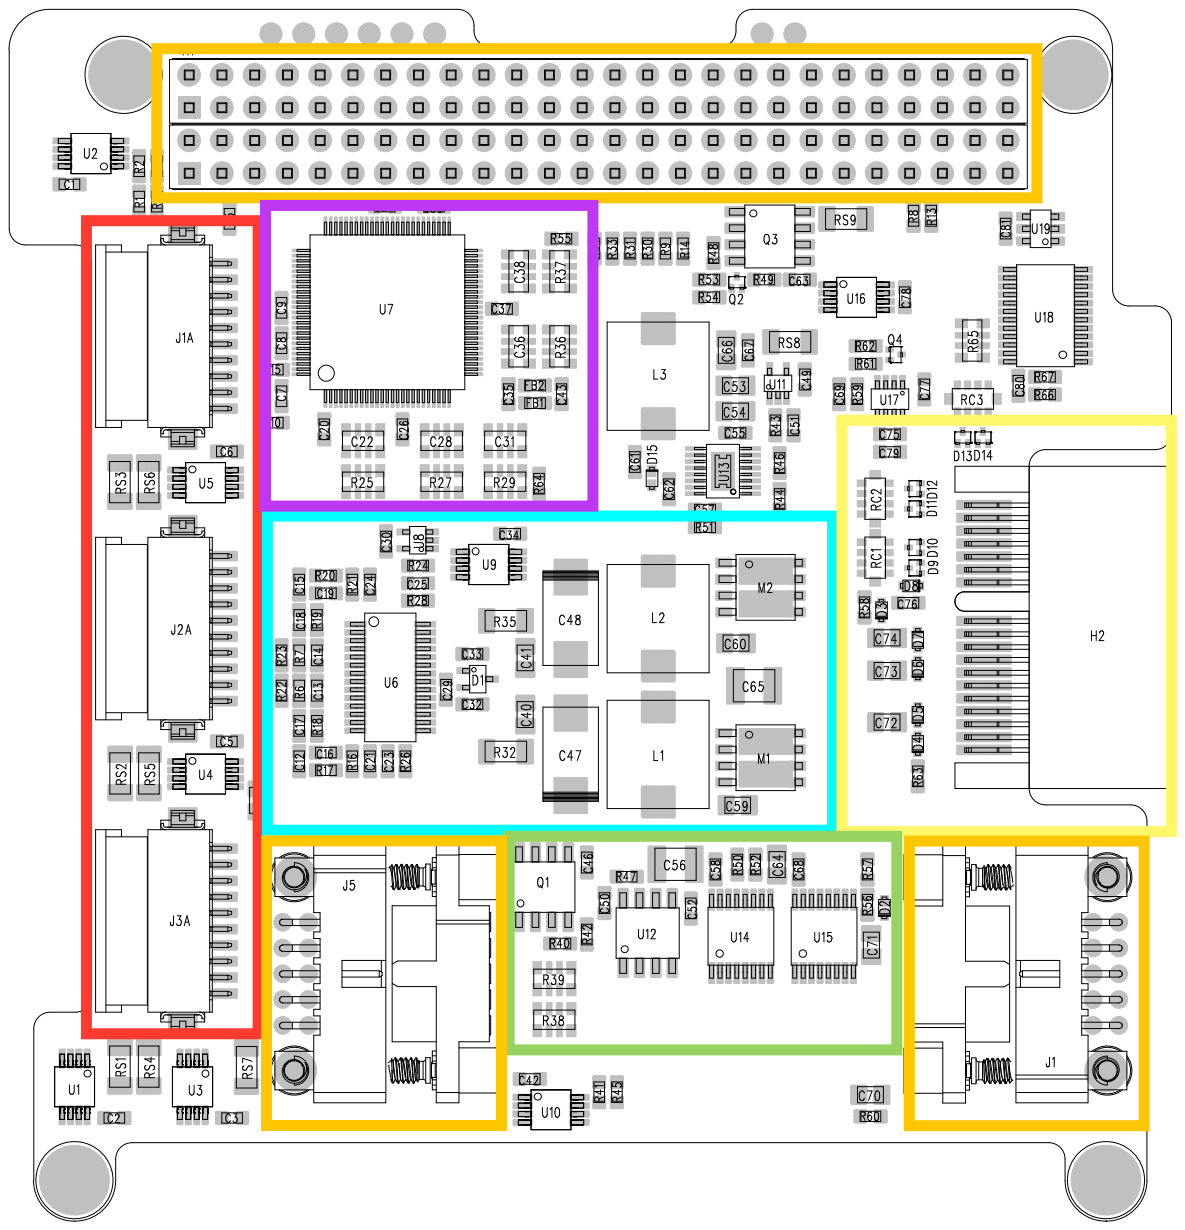
[picture p100: page 1]
