mattyv06/thesis/figs/phoenix/concept/eps_flow.pdf

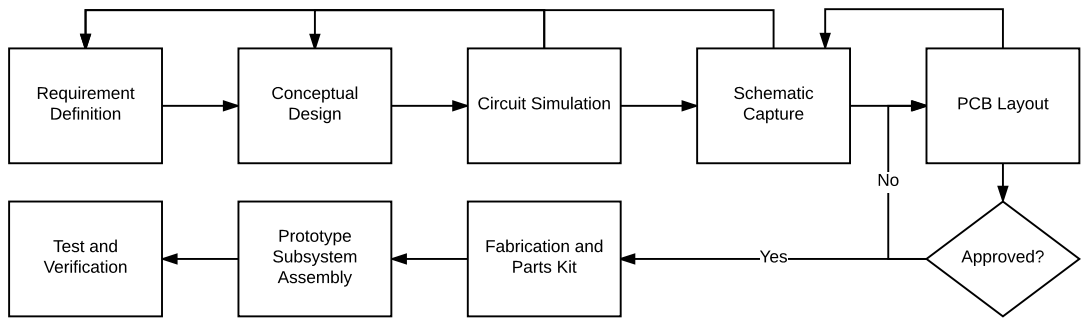
[picture p101: page 1]
uir; finitio; tic; Cir; uit; Sim; ula; tio; al Design; bly; rific; ric; Kit
