mattyv06/thesis/figs/fisce/manufacturing/fisce_layout_fbe4008d.pdf

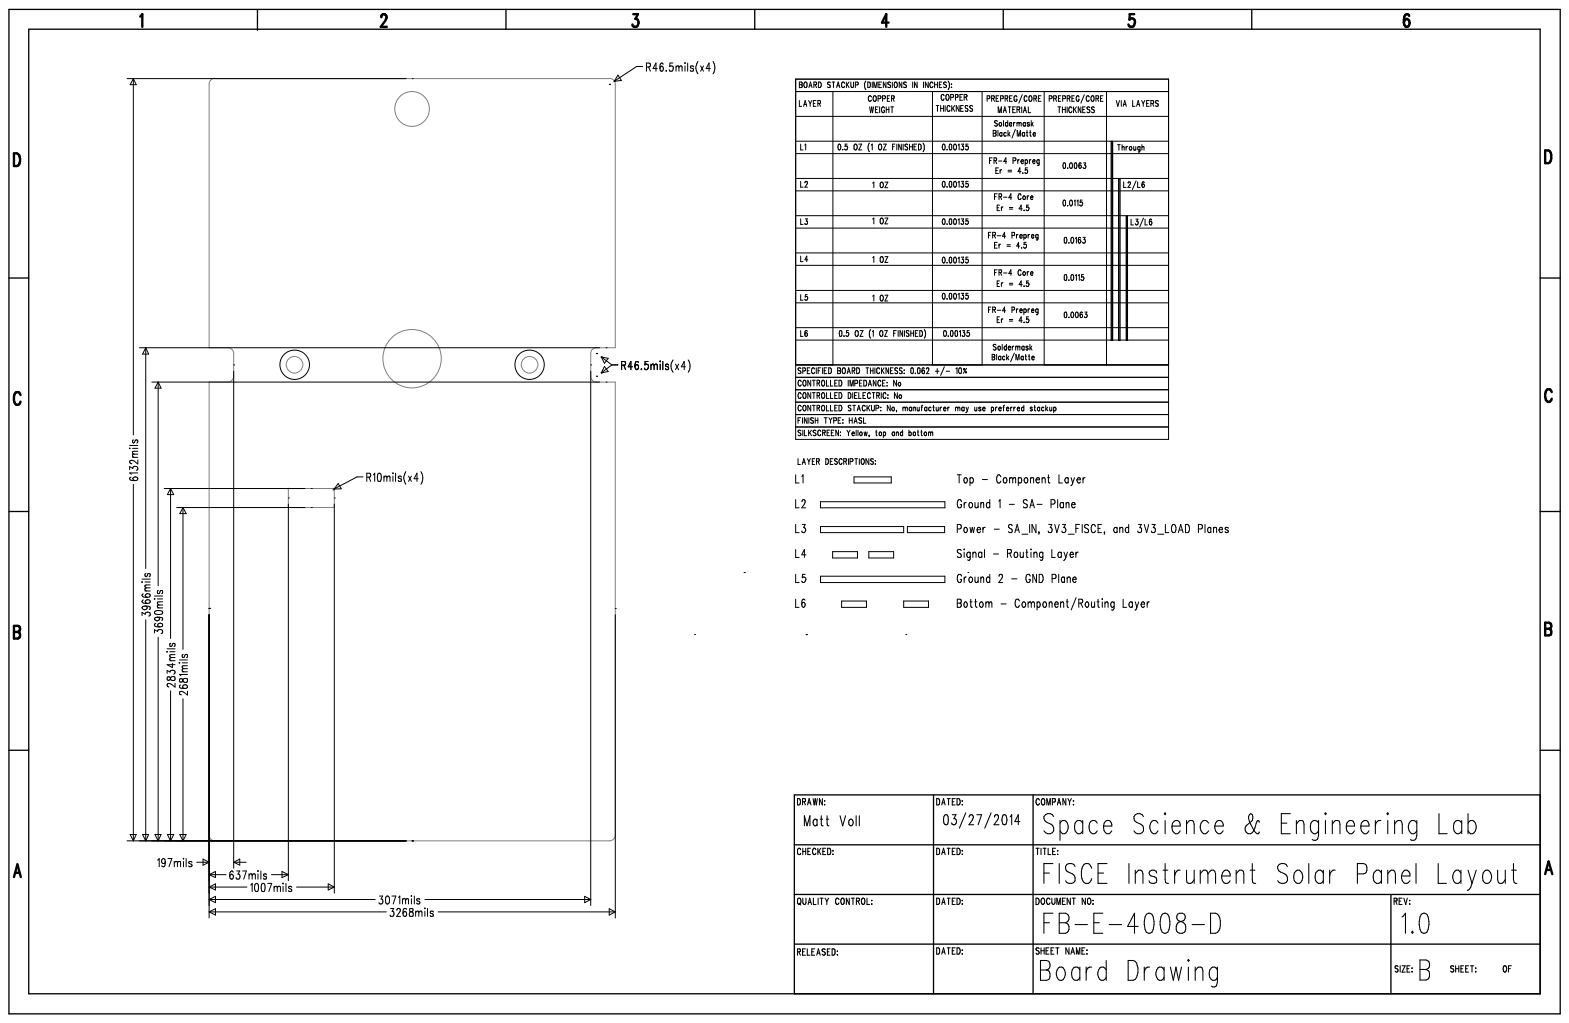
[picture p102: page 1]

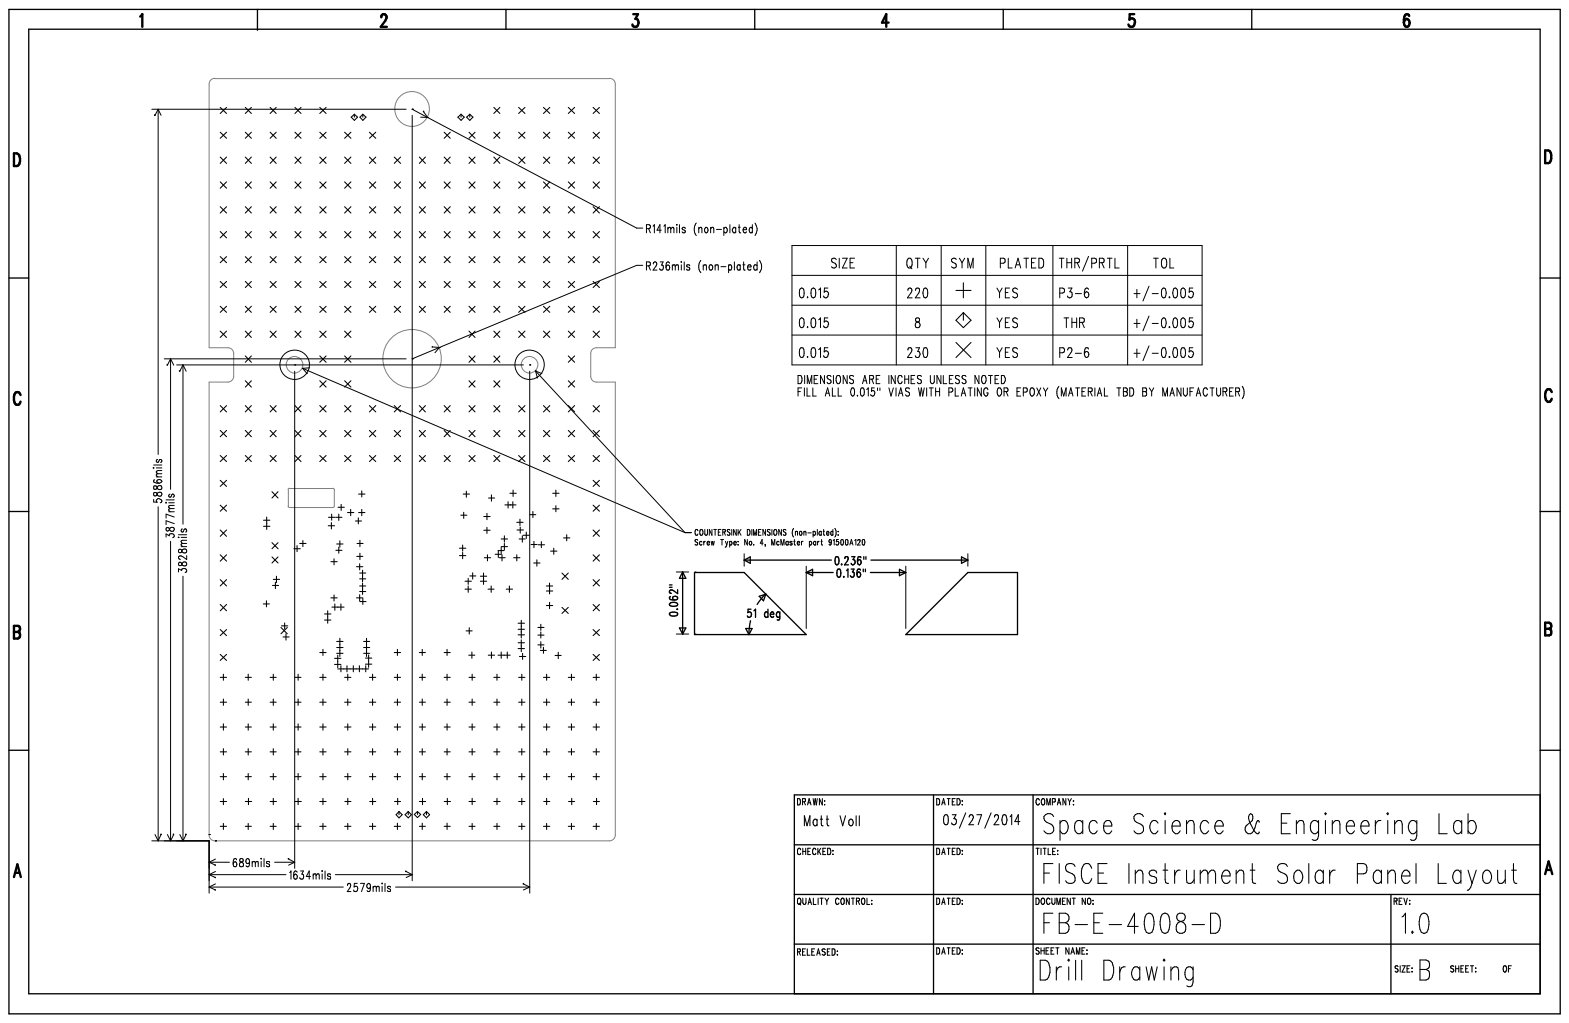
[picture p103: page 2]

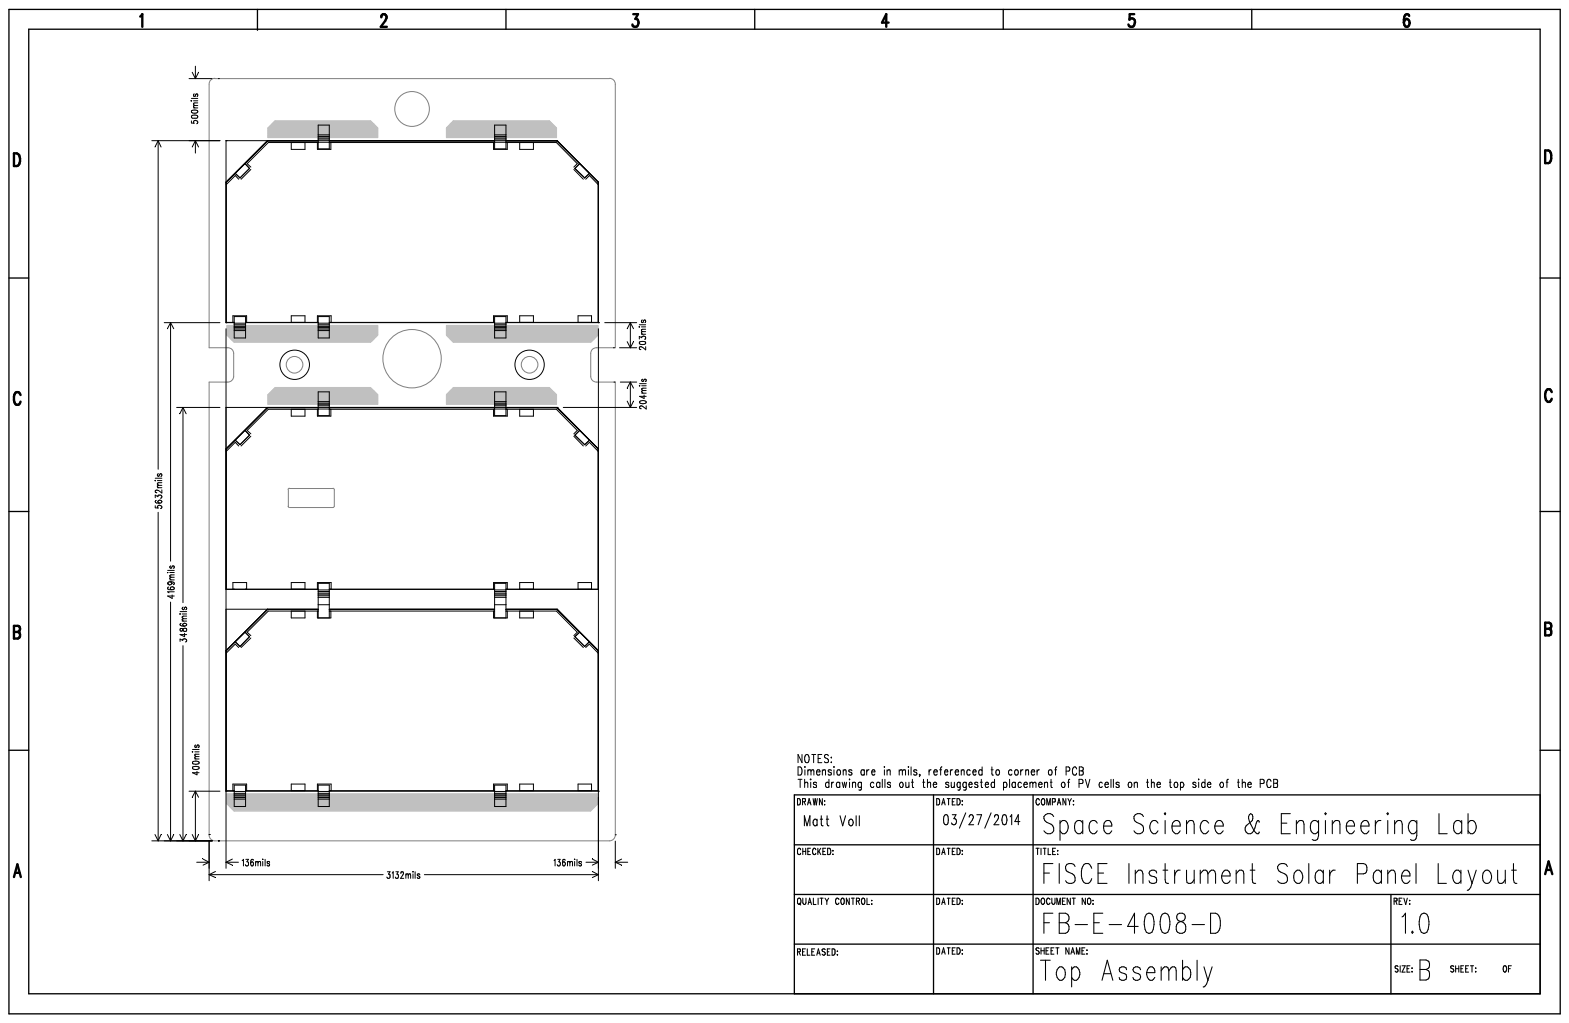
[picture p104: page 3]

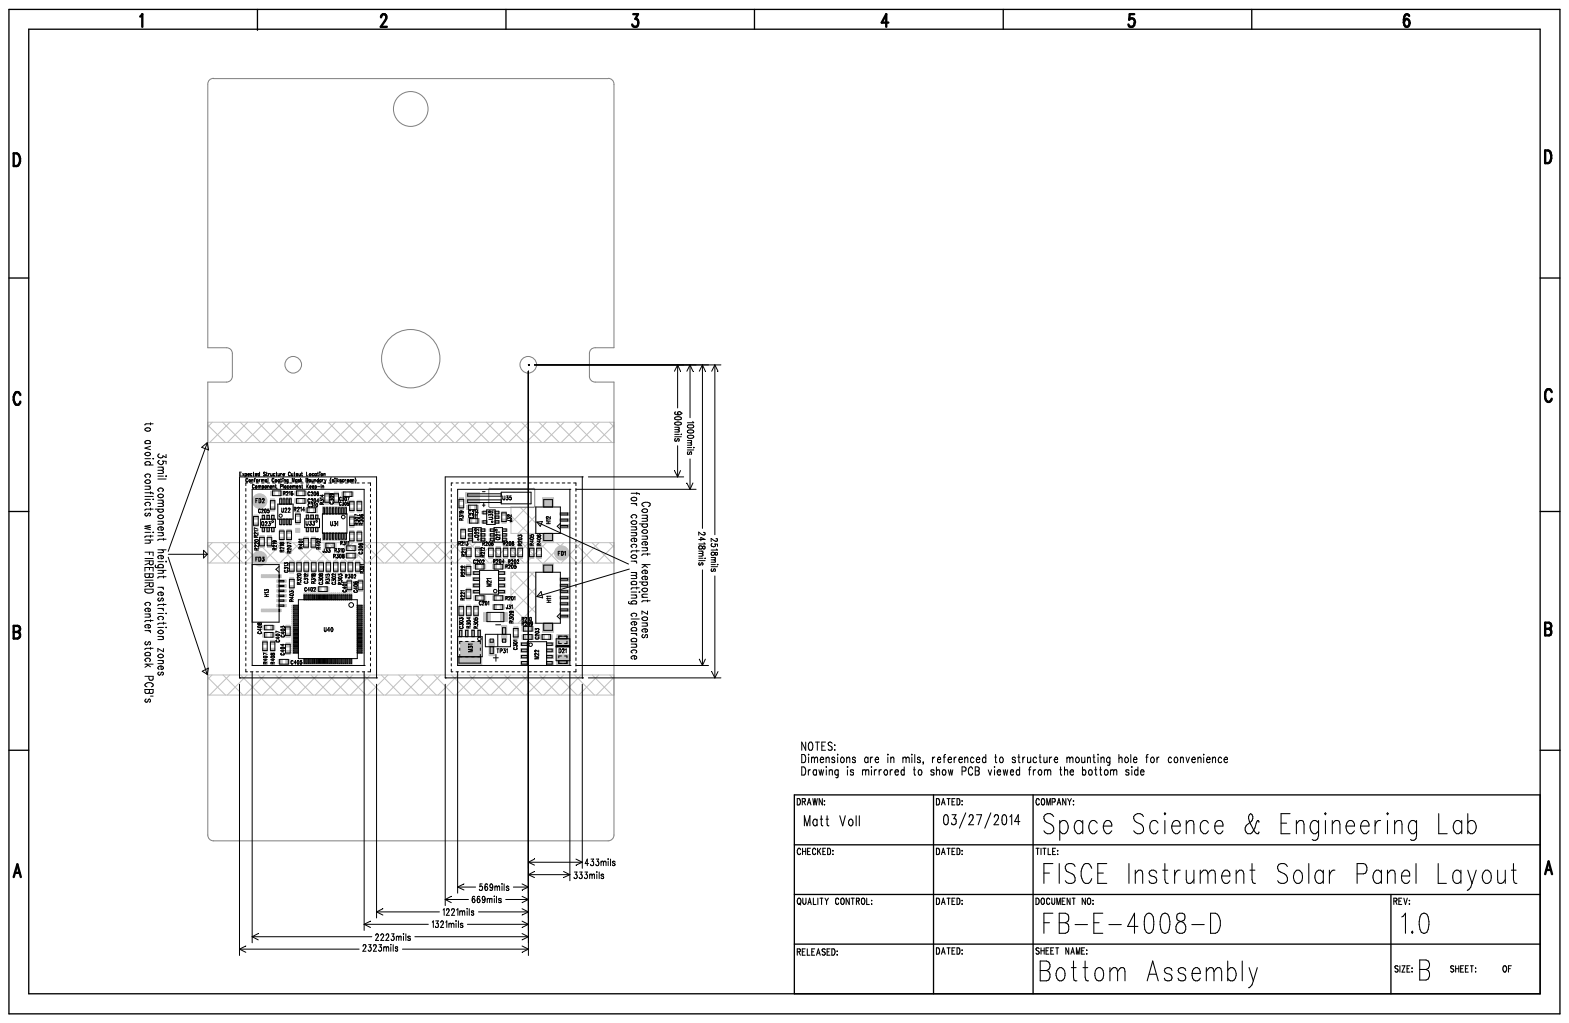
[picture p105: page 4]

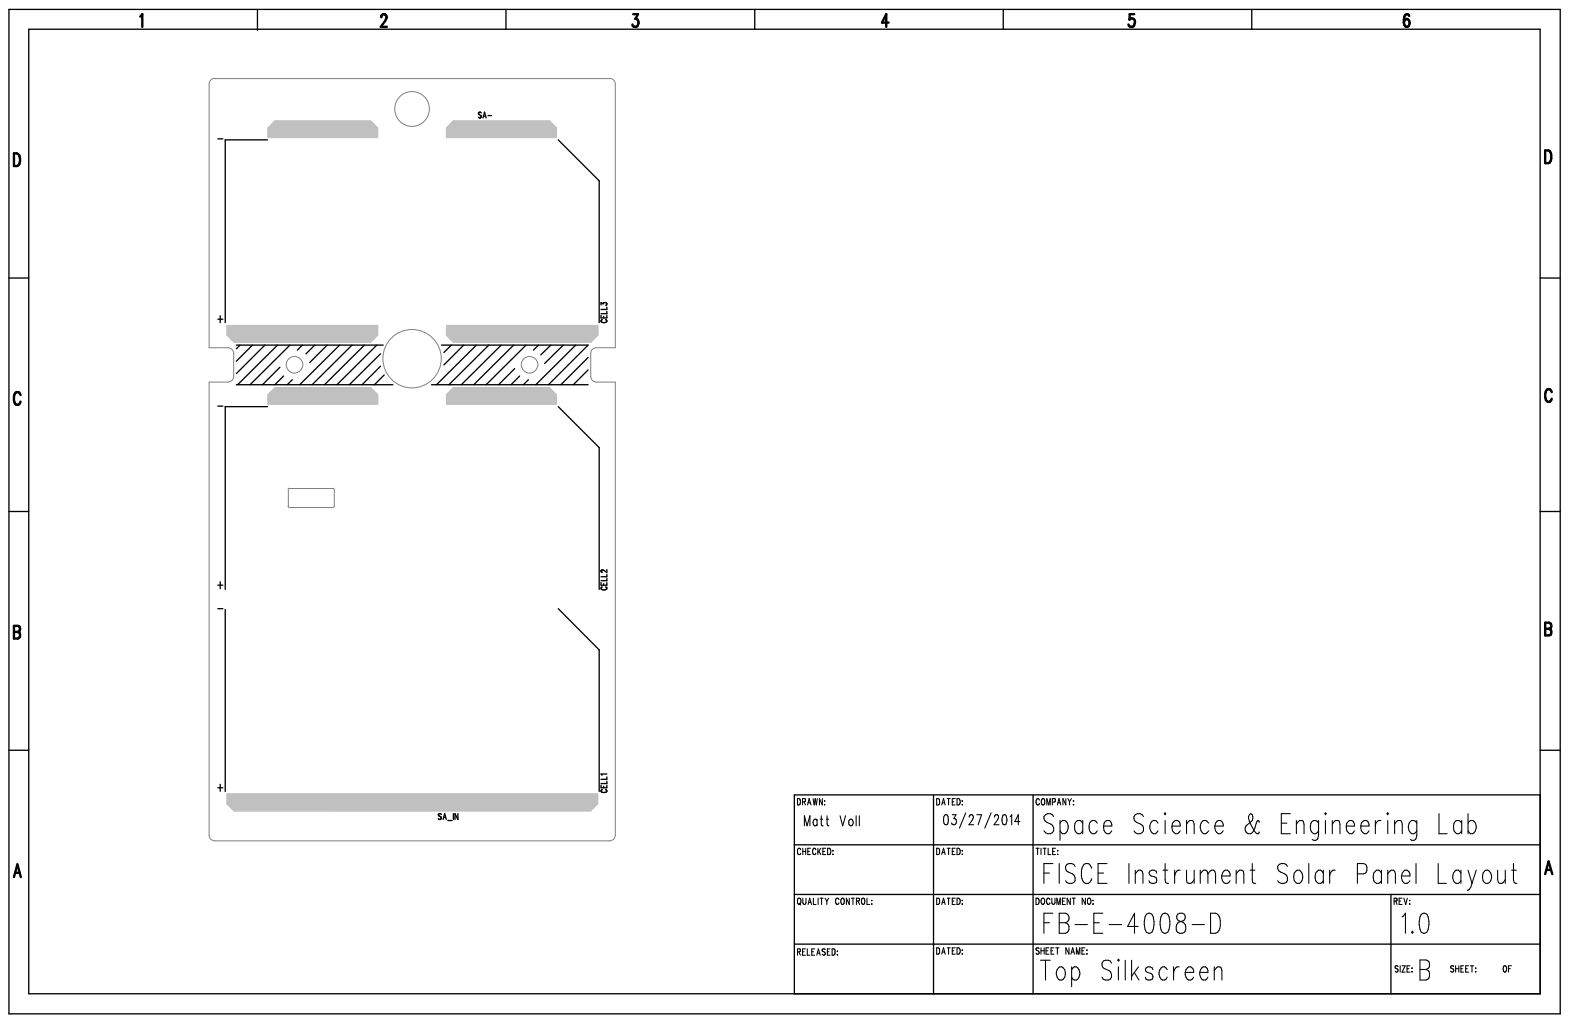
[picture p106: page 5]

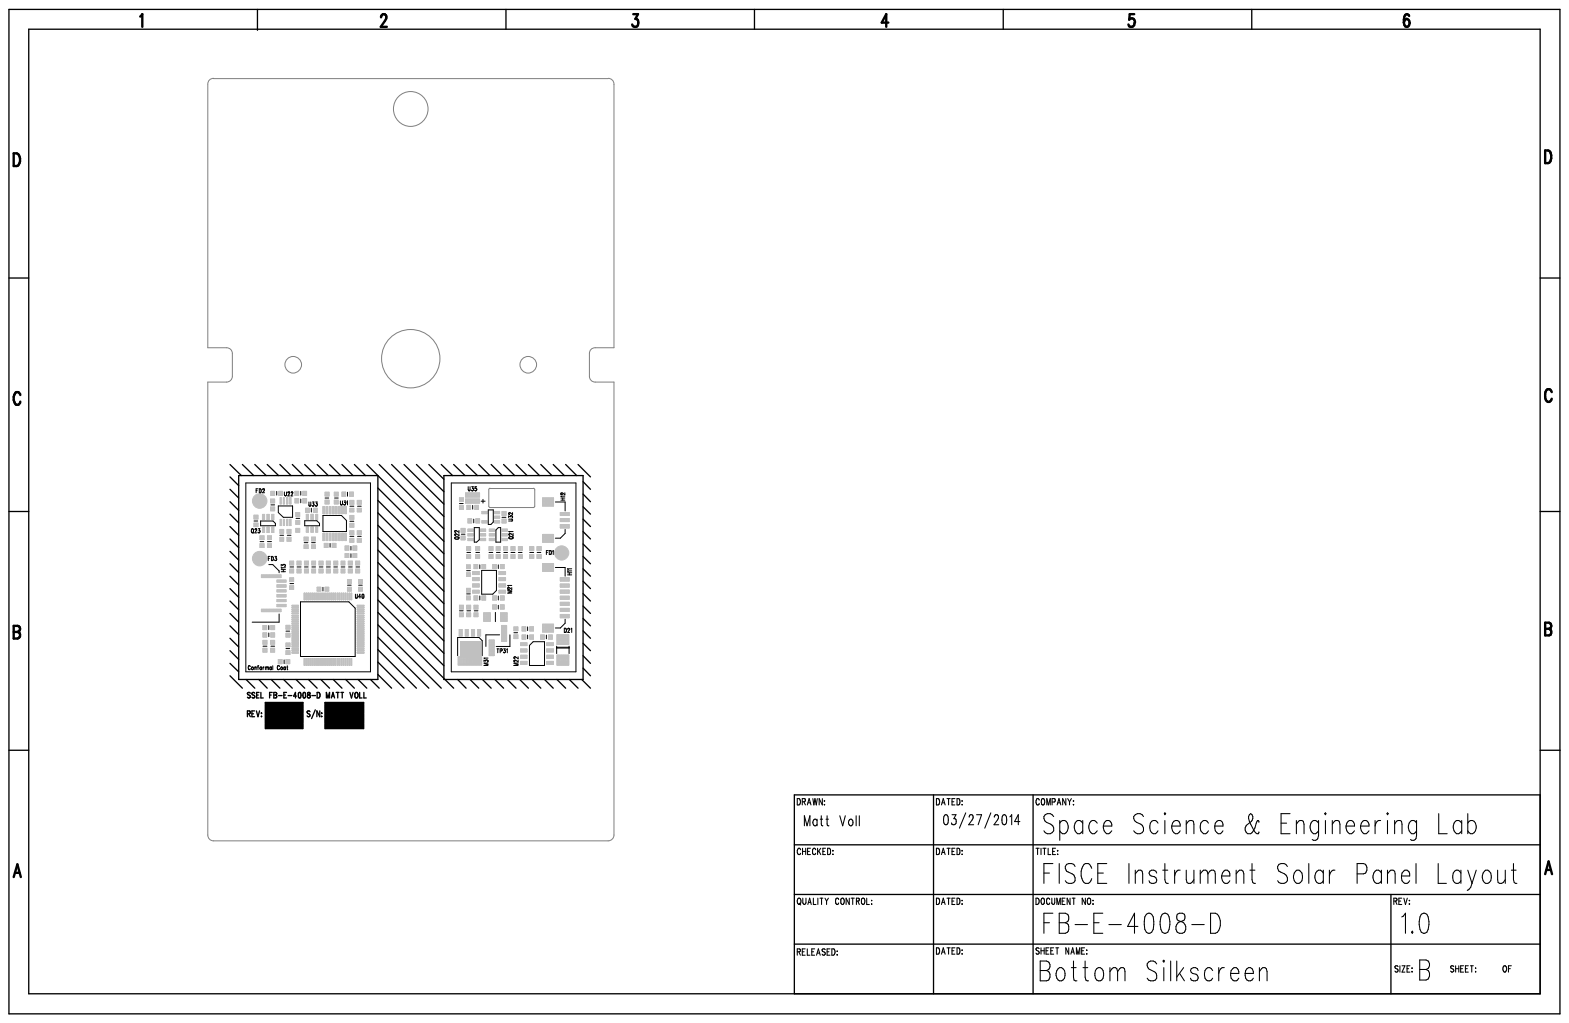
[picture p107: page 6]

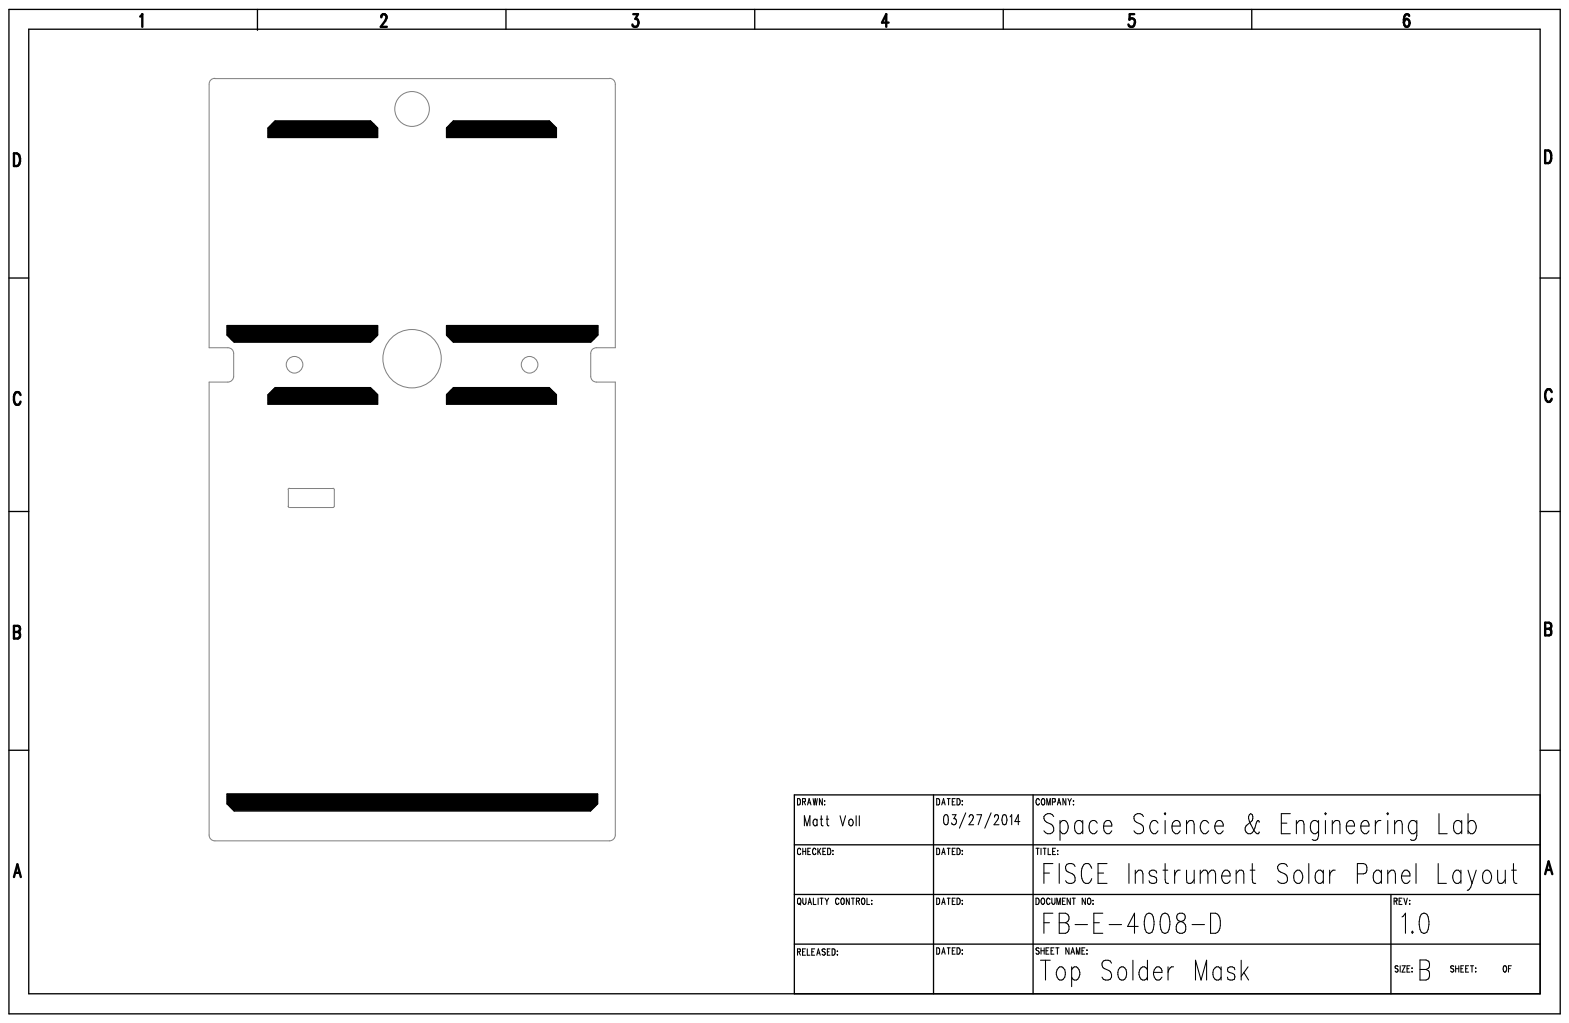
[picture p108: page 7]

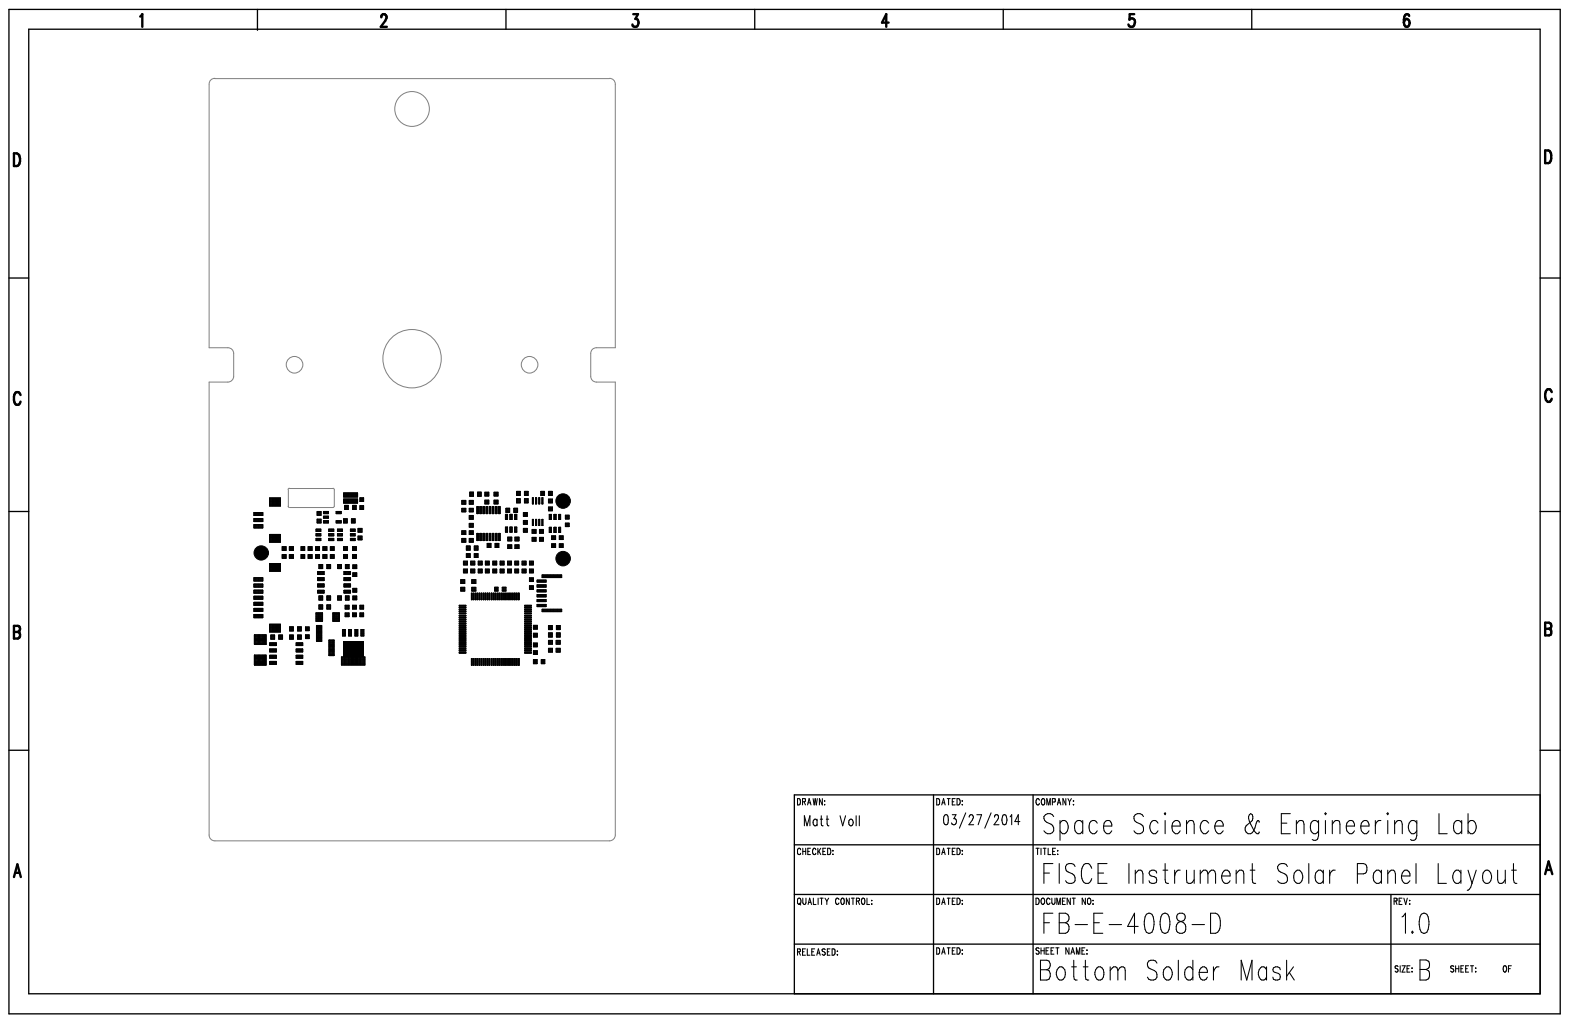
[picture p109: page 8]

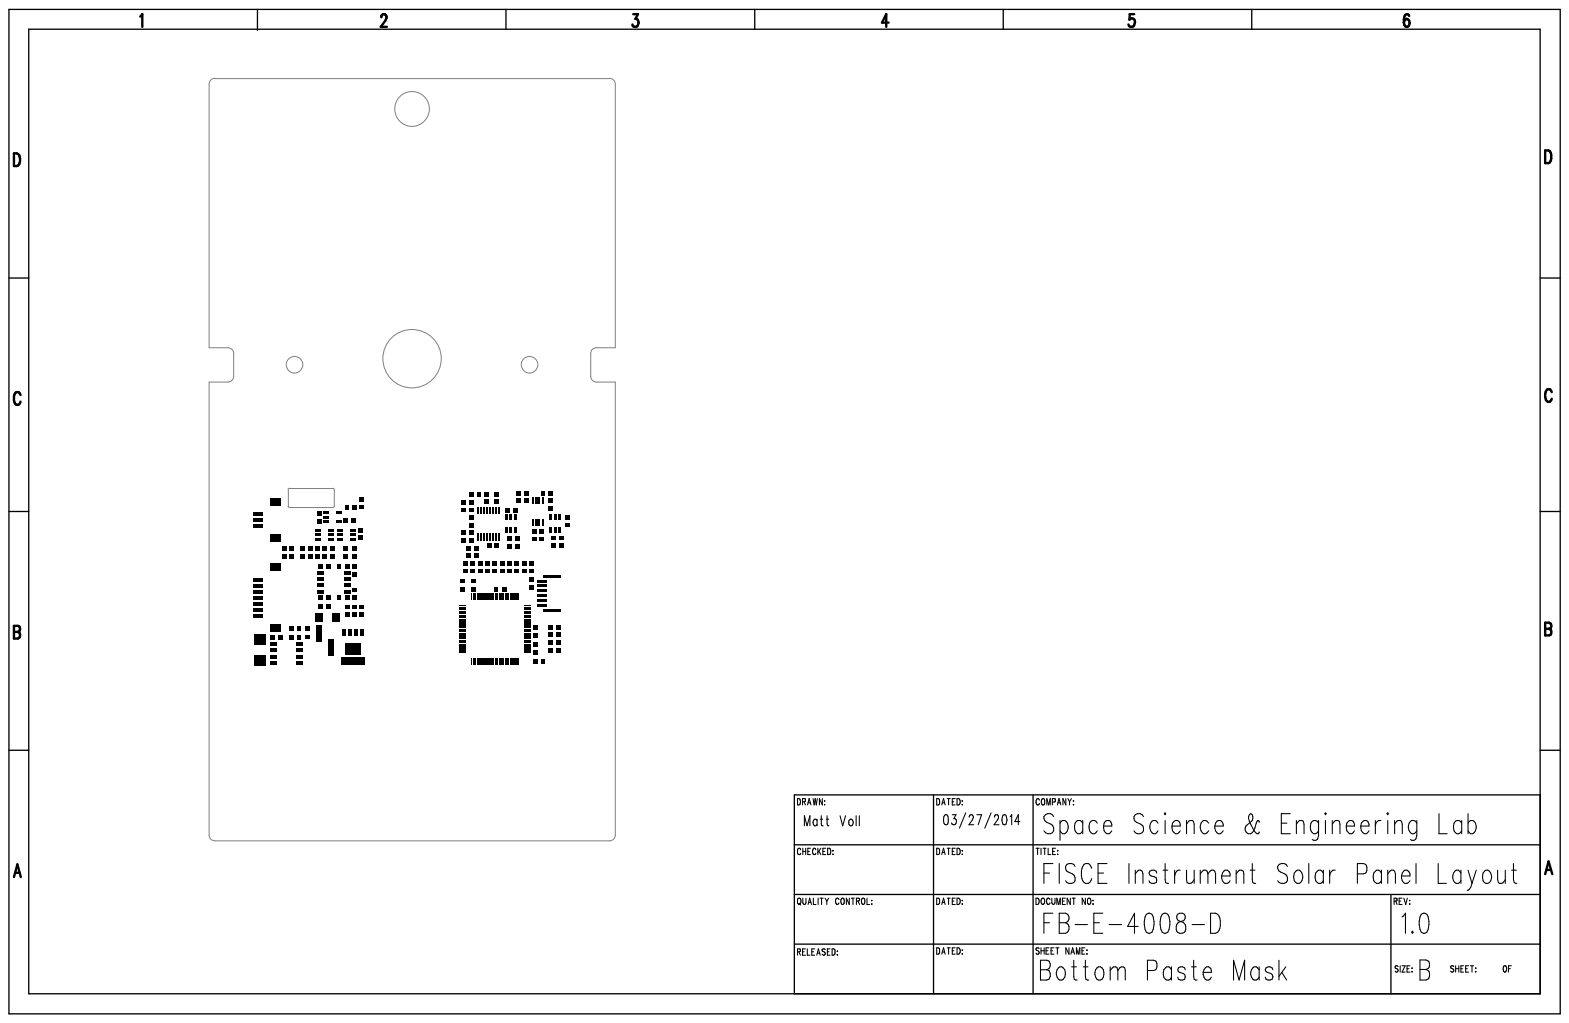
[picture p110: page 9]

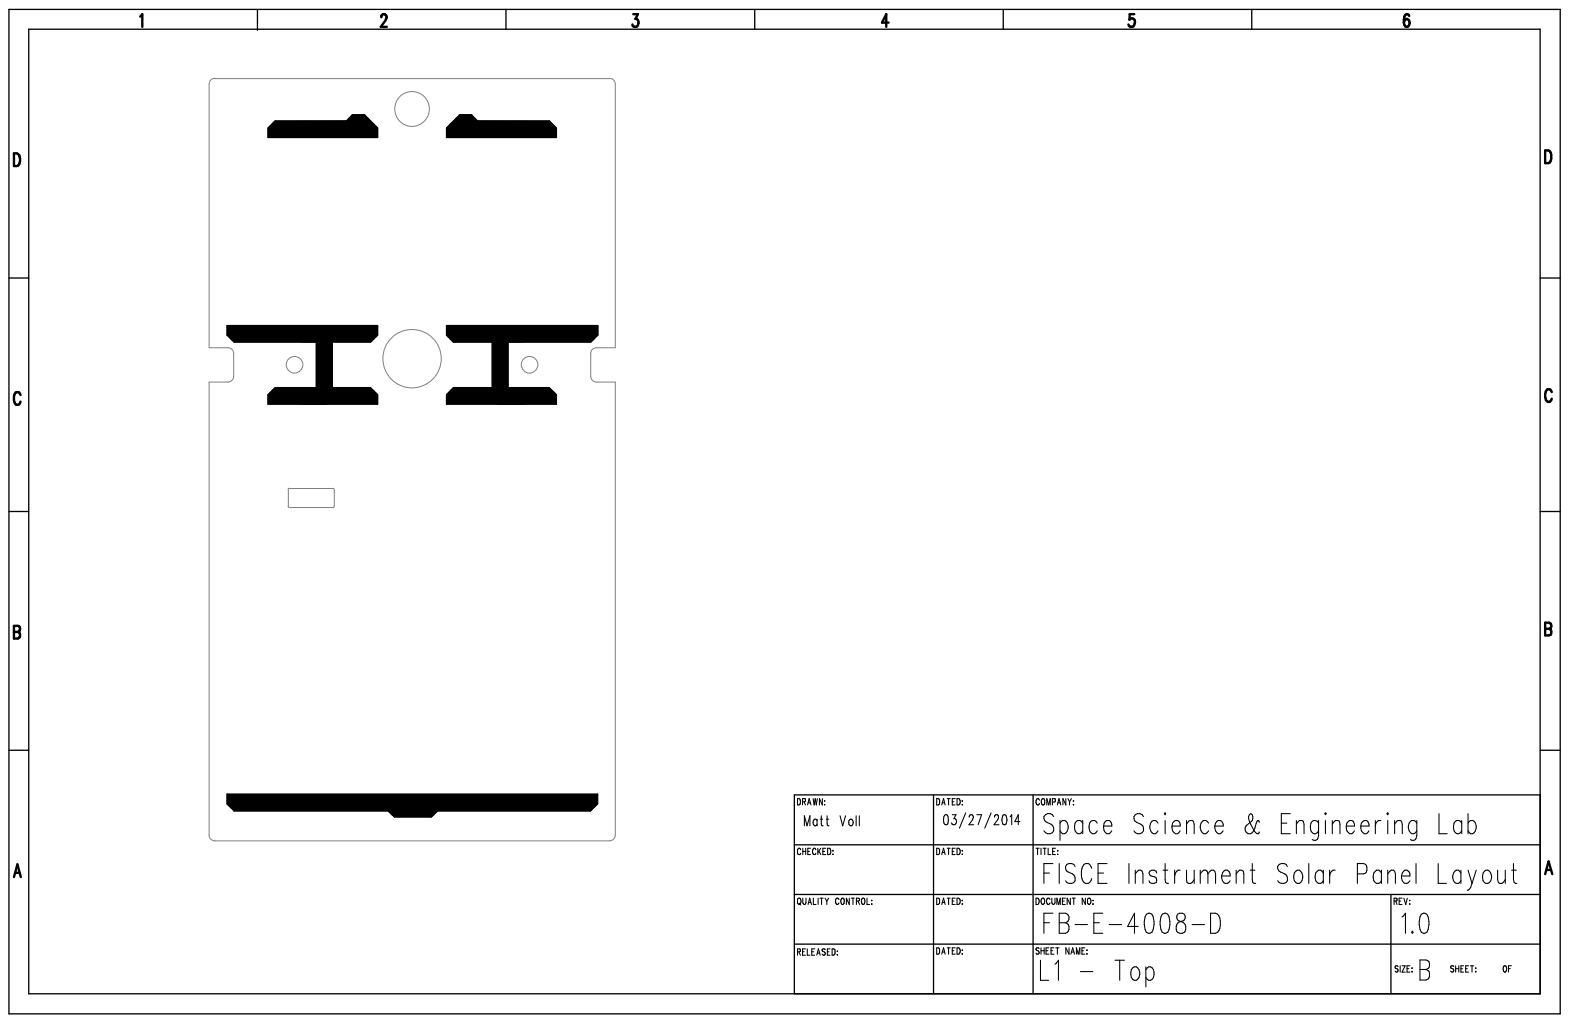
[picture p111: page 10]

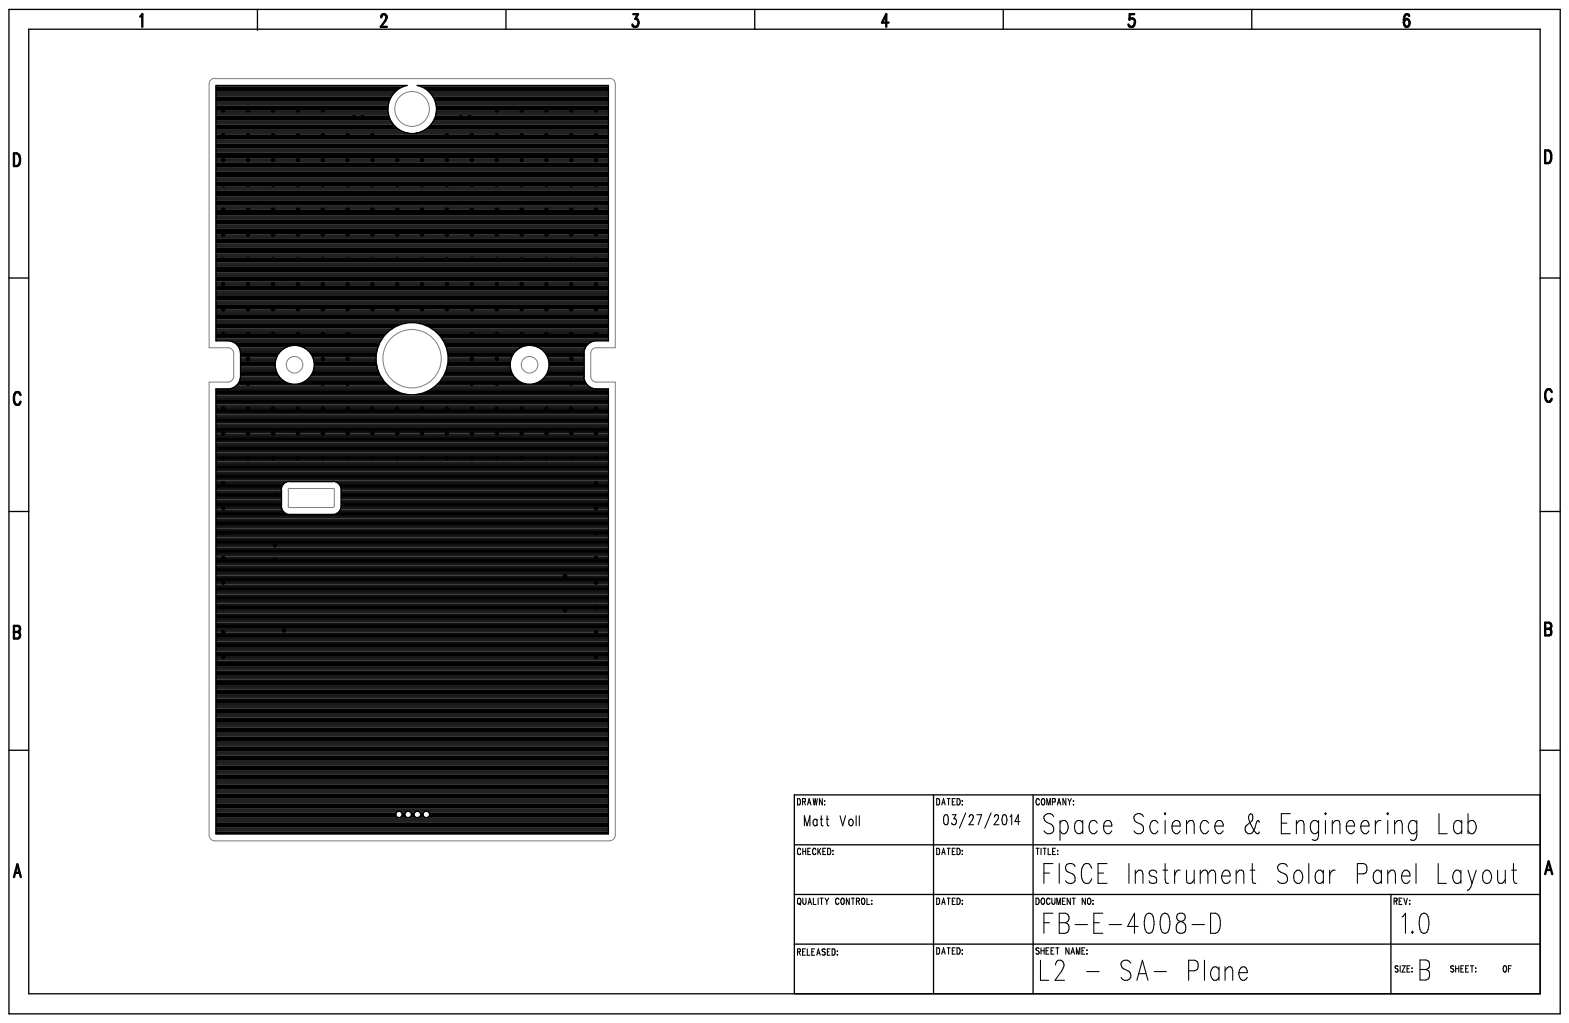
[picture p112: page 11]

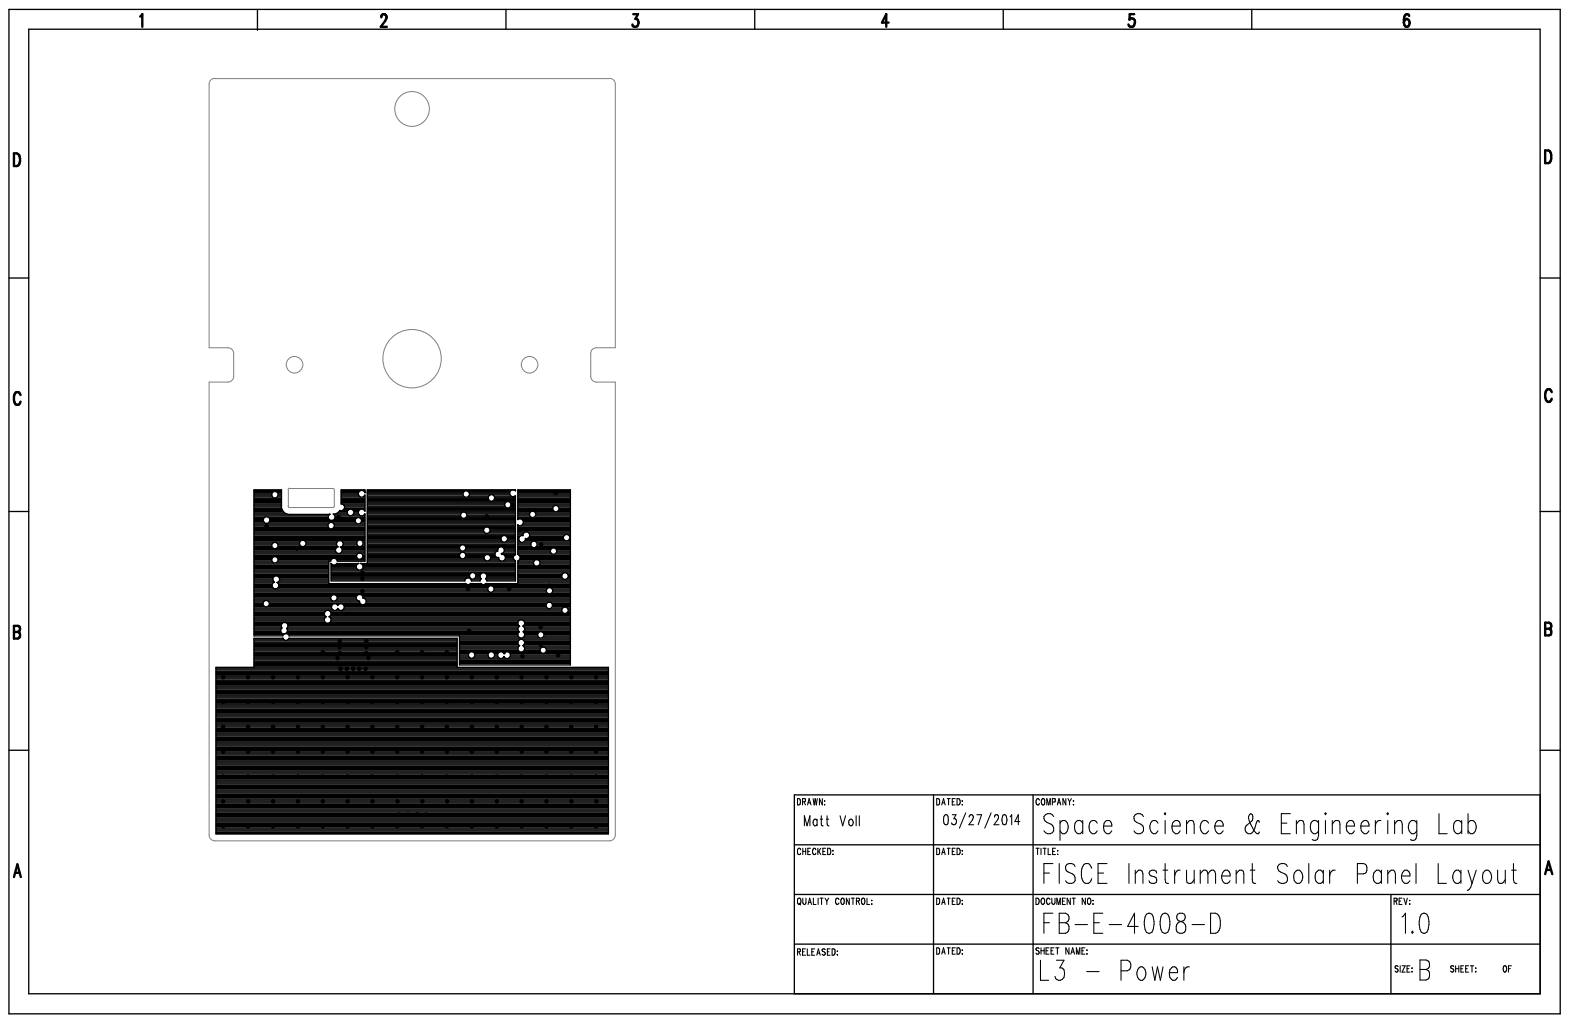
[picture p113: page 12]

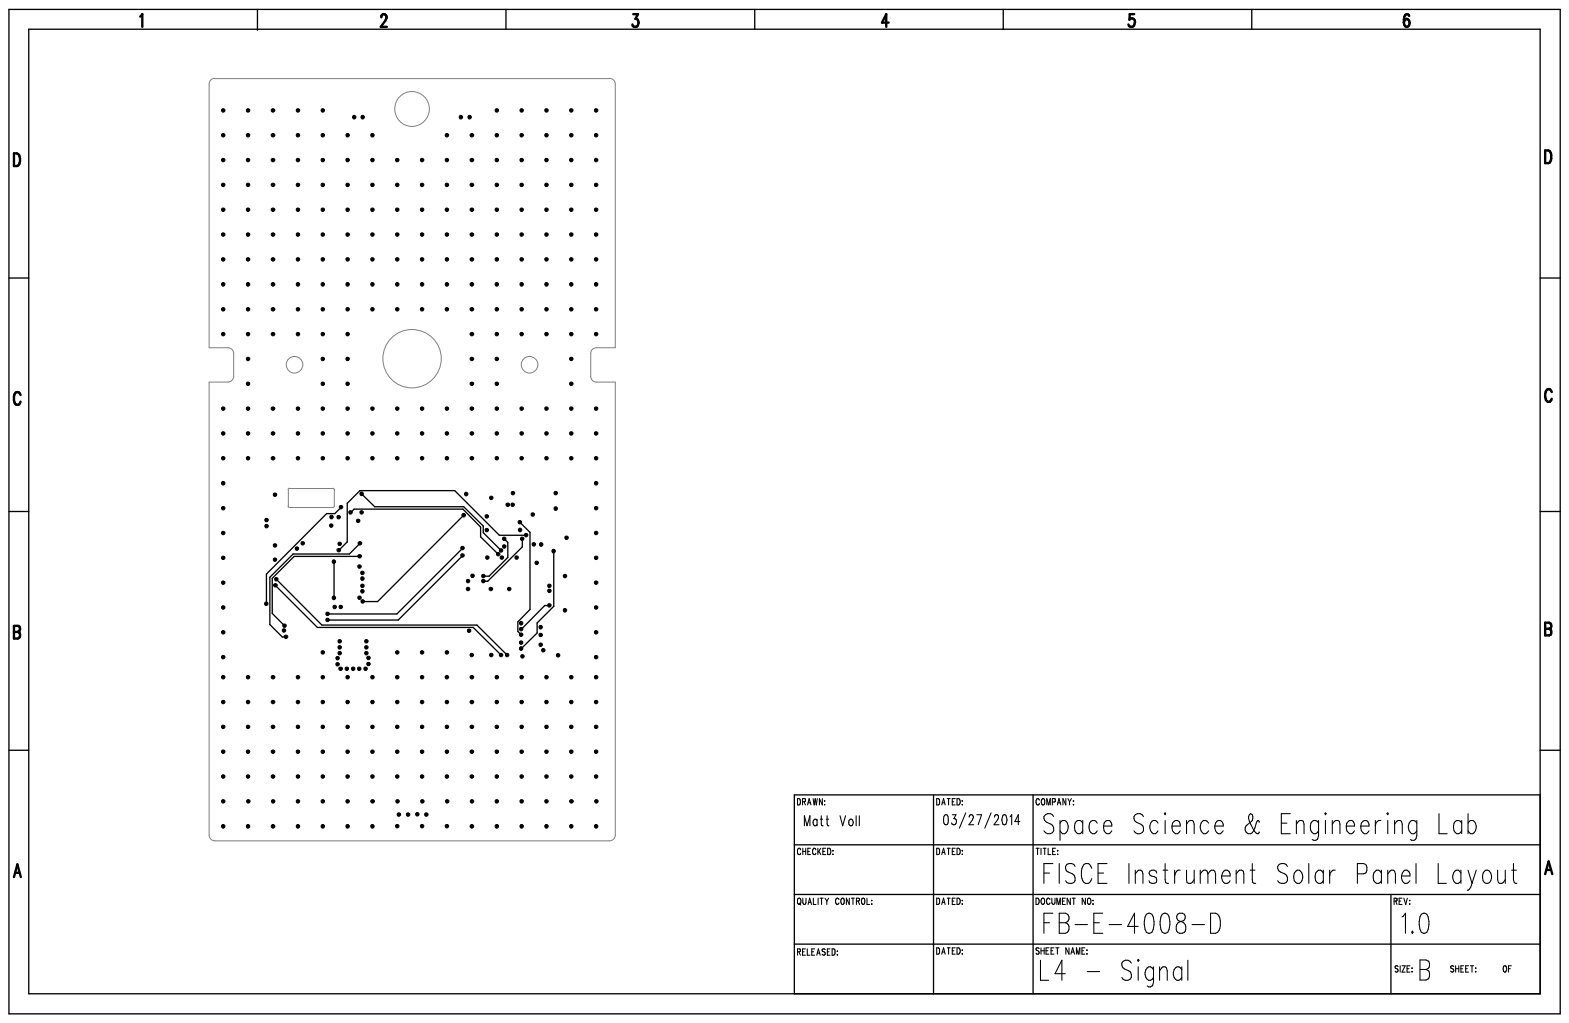
[picture p114: page 13]

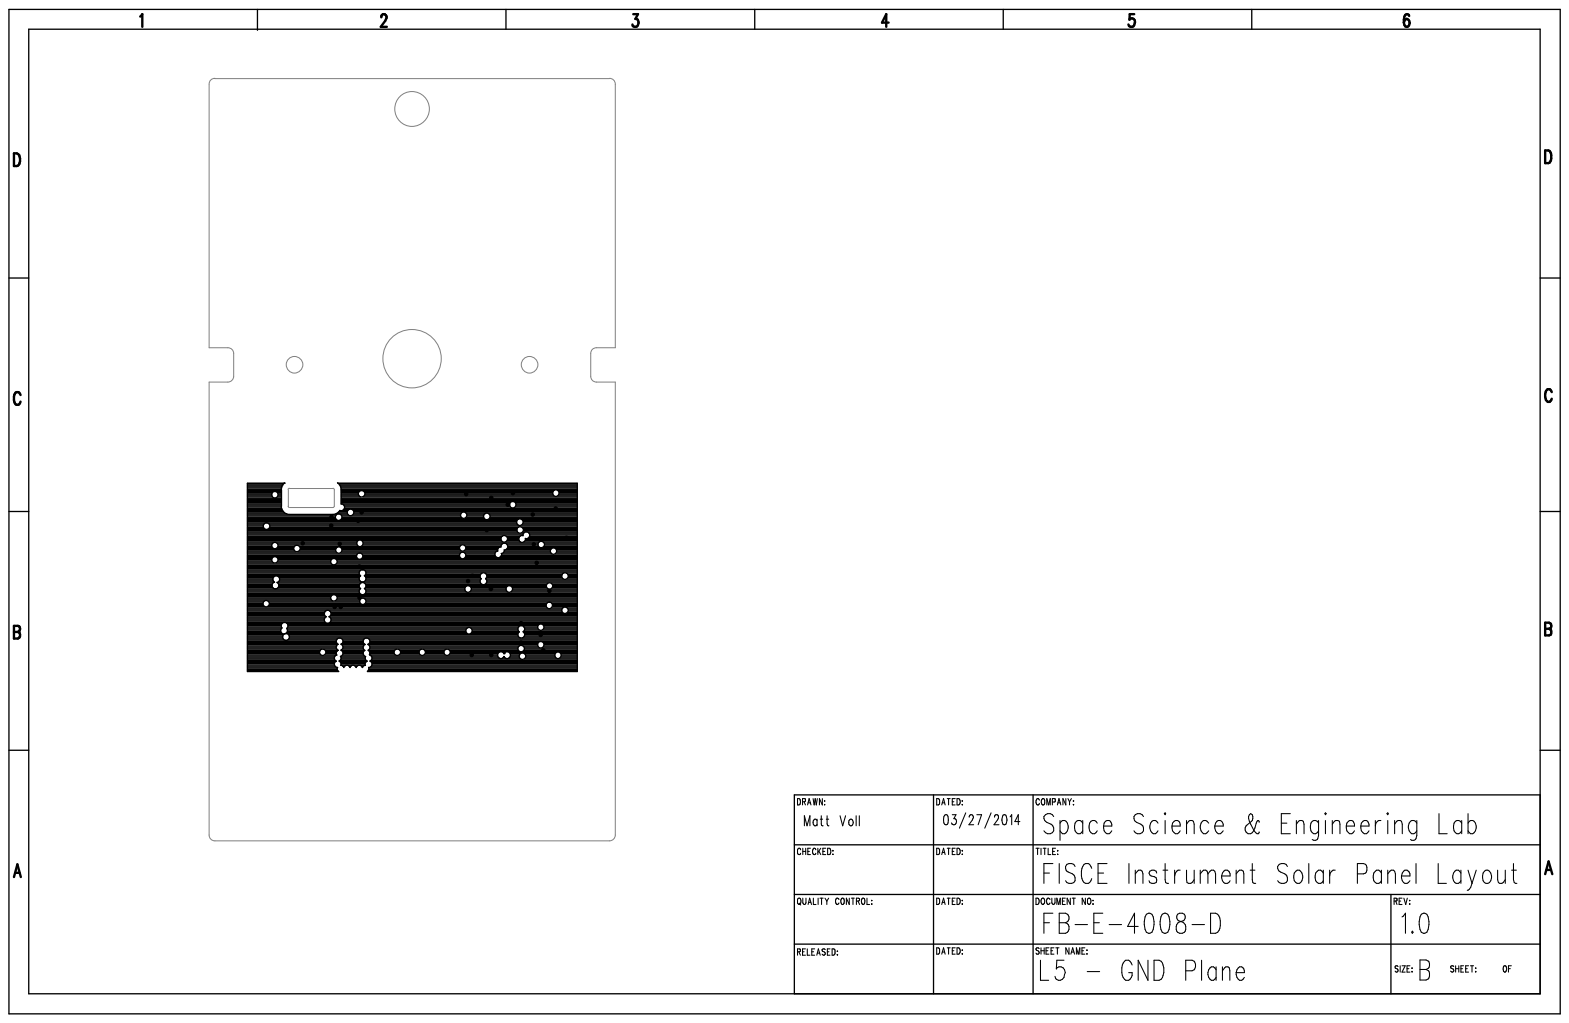
[picture p115: page 14]

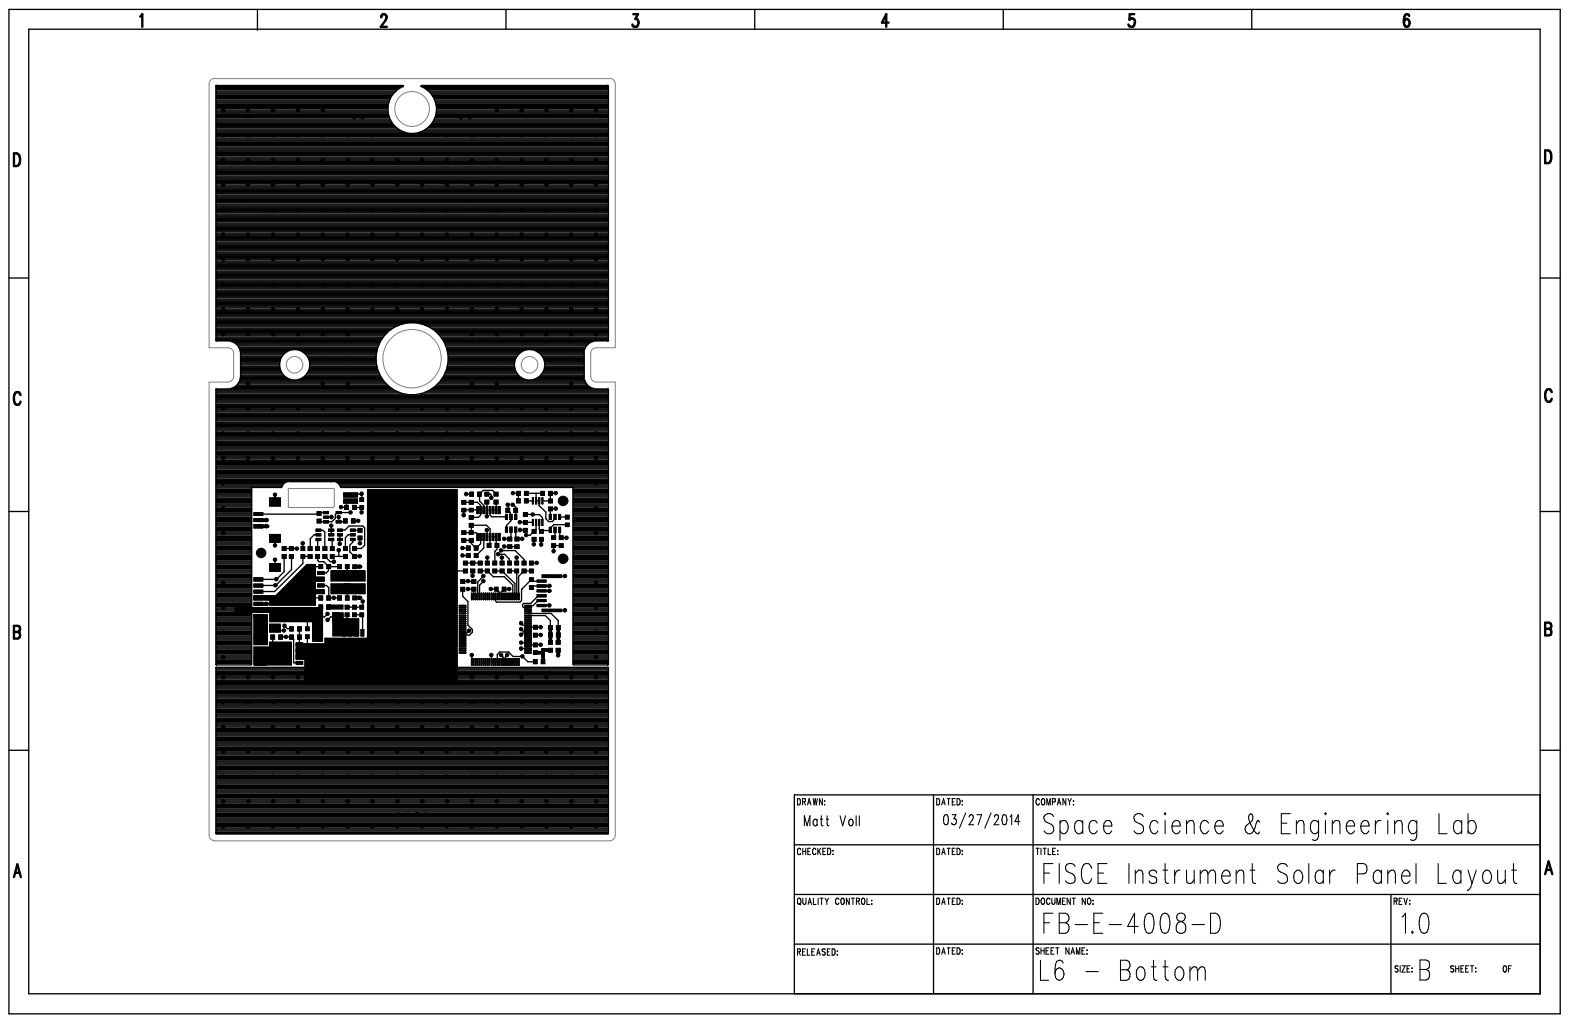
[picture p116: page 15]
