mattyv06/thesis/figs/phoenix/manufacturing/phoenix_assembly_bottom.pdf

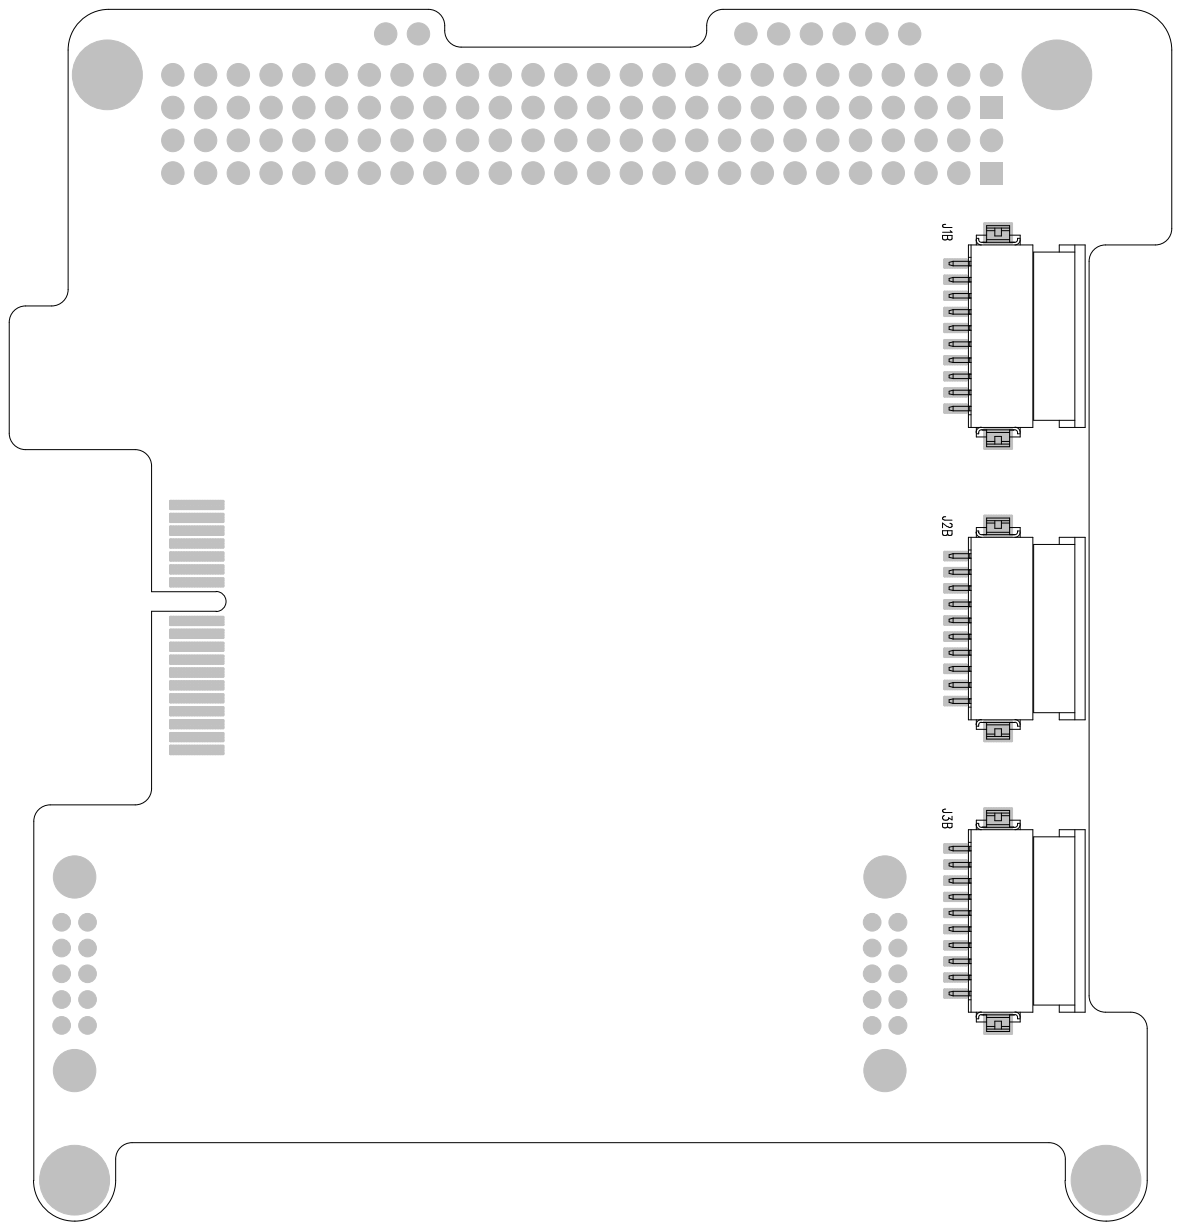
[picture p117: page 1]
