mattyv06/thesis/figs/phoenix/manufacturing/phoenix_layout.pdf

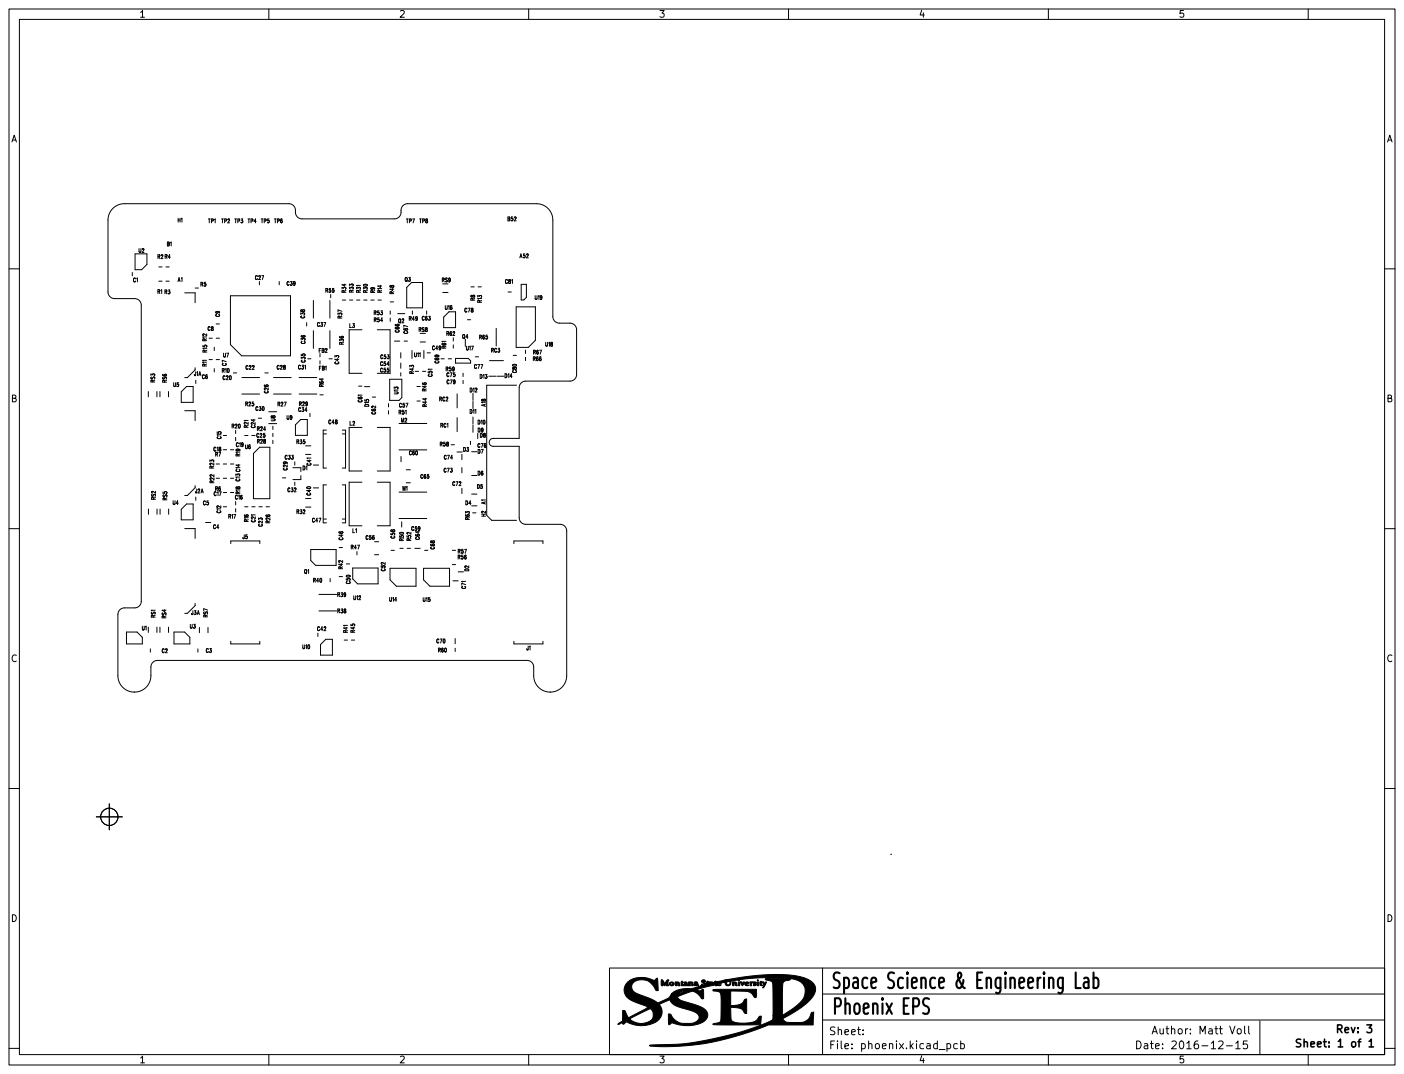
[picture p118: page 1]

Space Science & | Engineering Lab
Phoenix EPS

Rev: 3

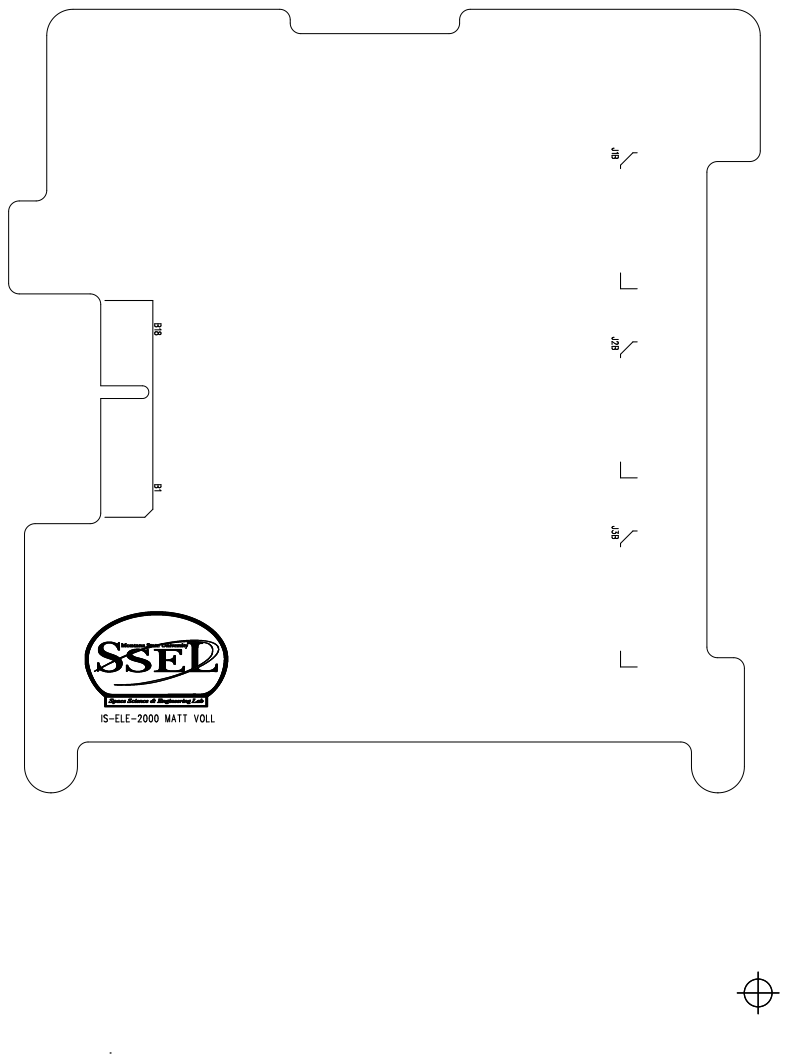
[picture p119: page 2]

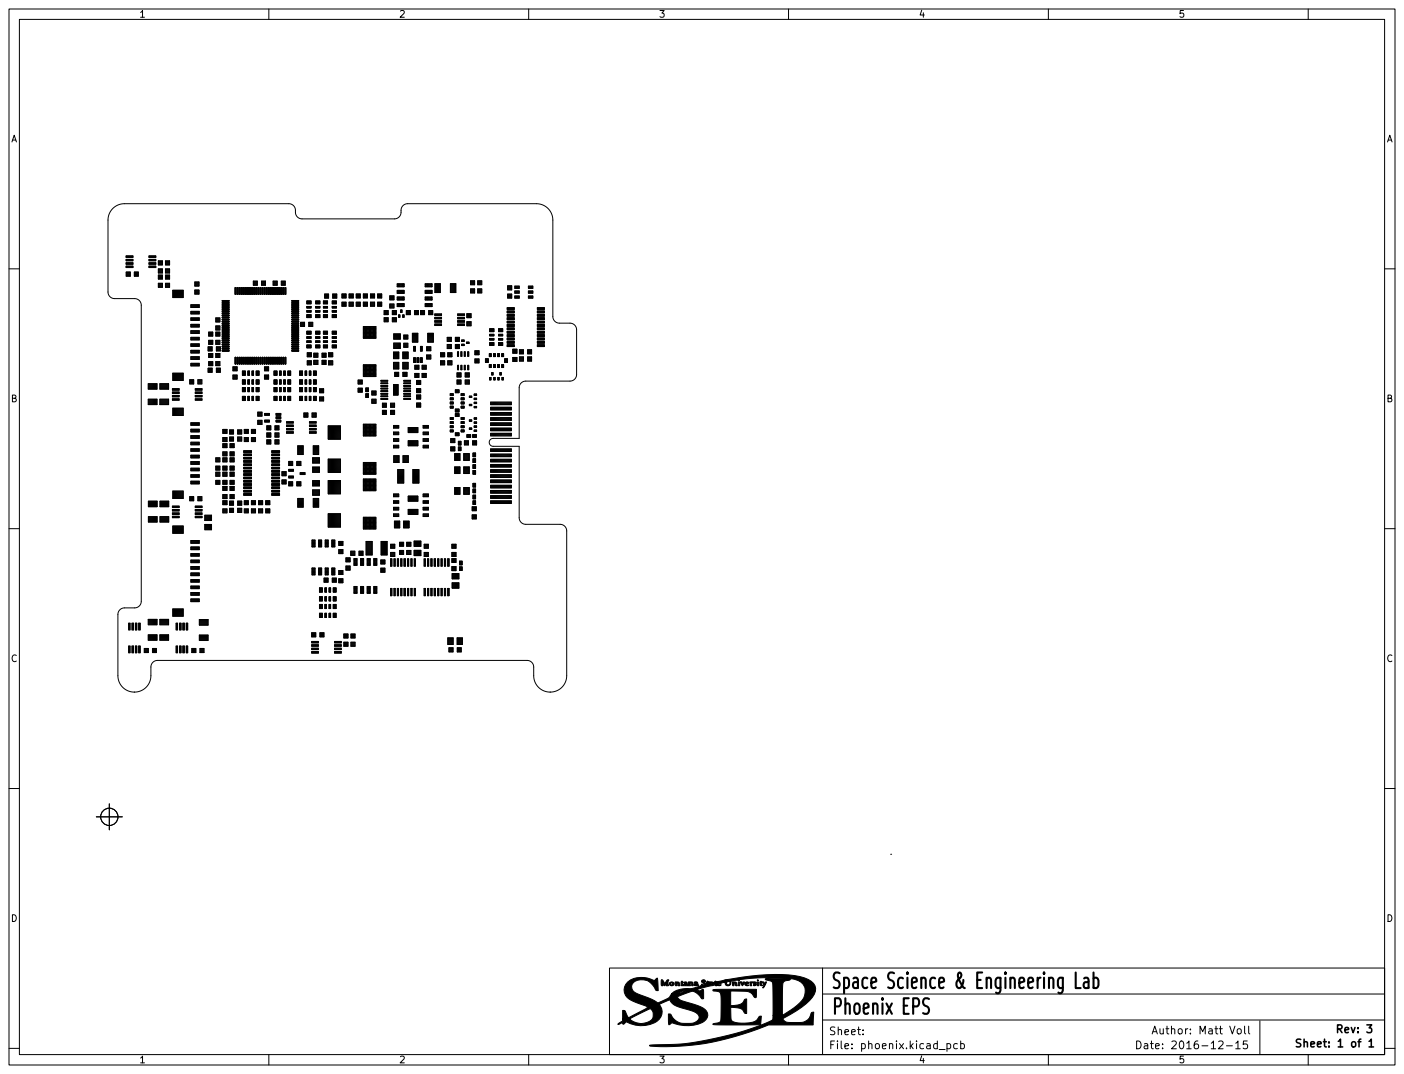
[picture p120: page 3]

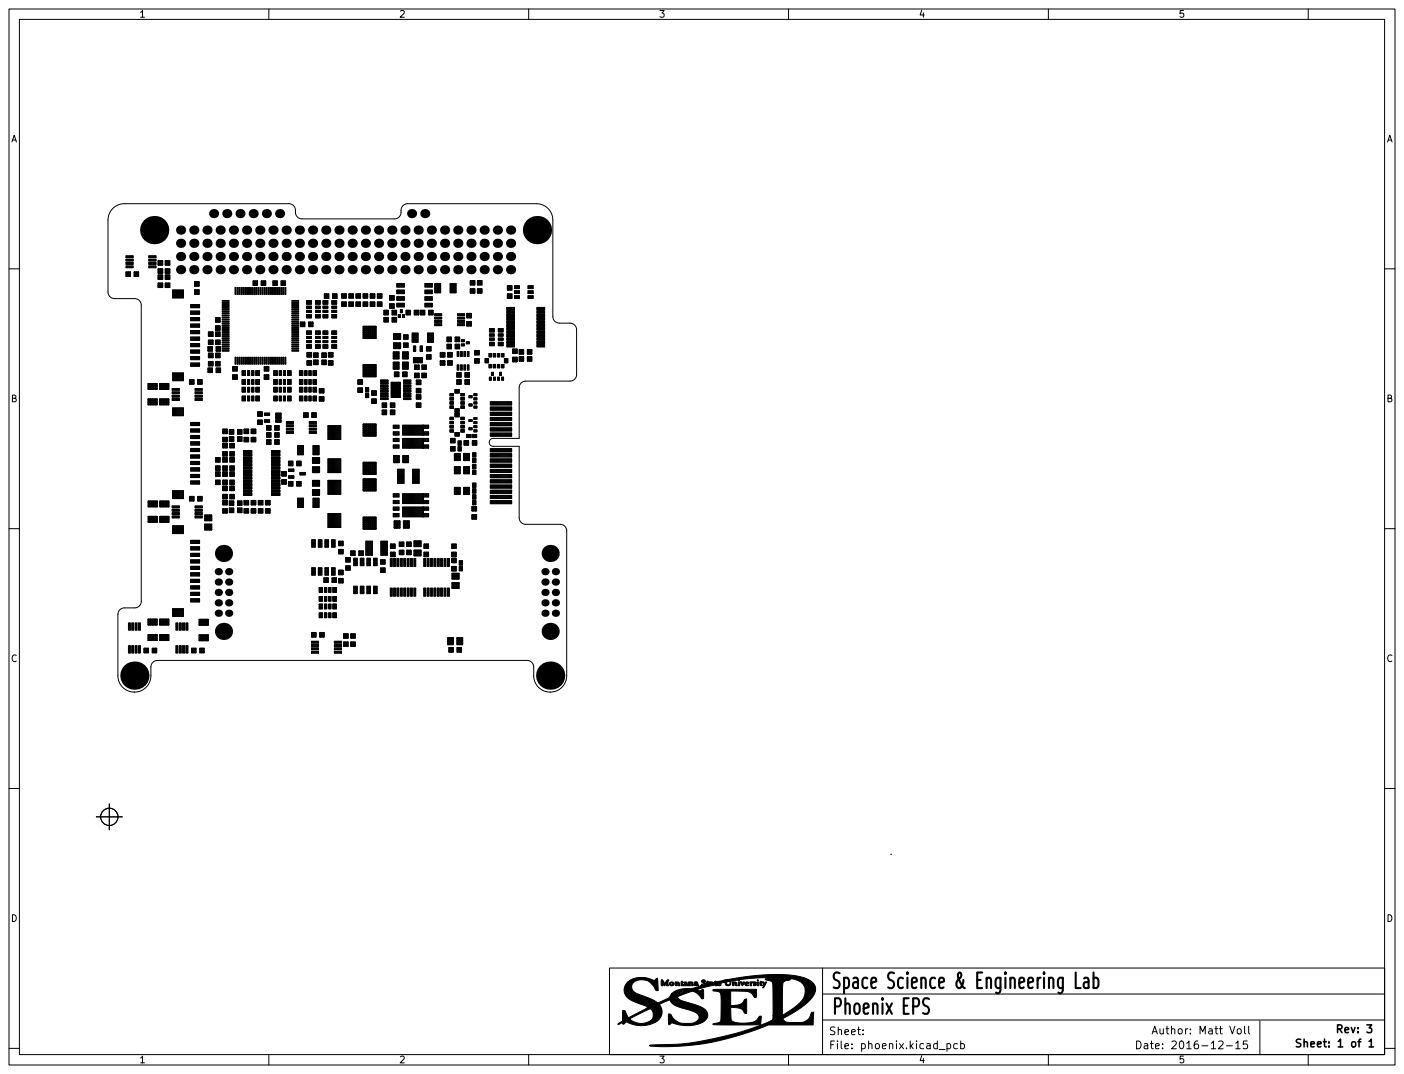
[picture p121: page 4]

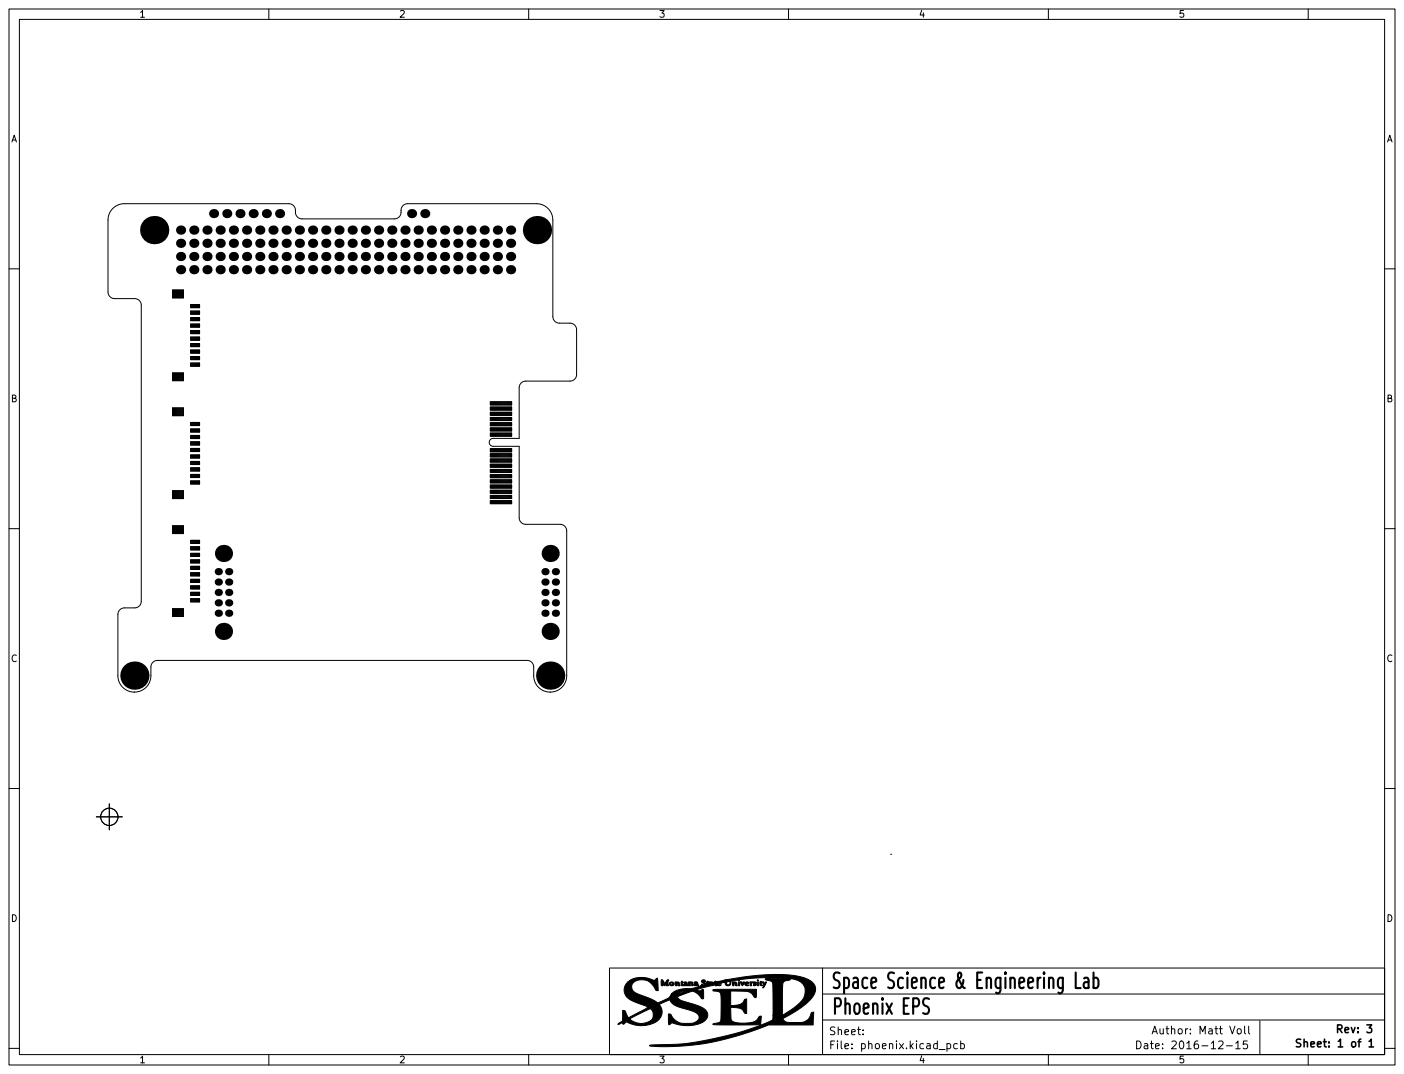
[picture p122: page 5]

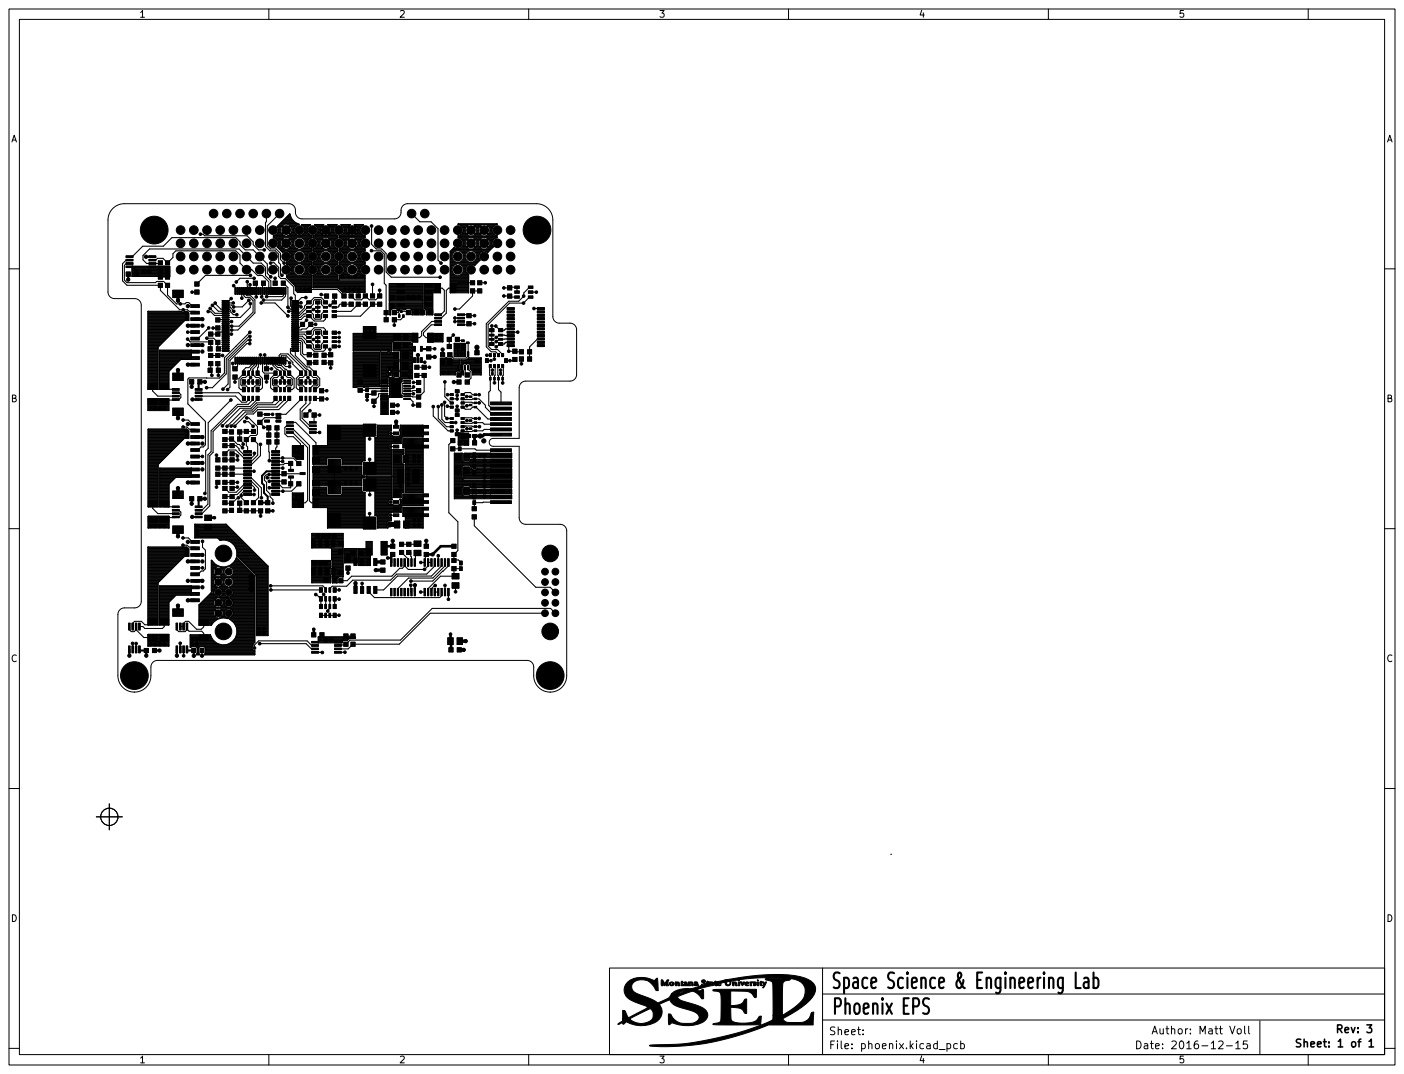
[picture p123: page 6]

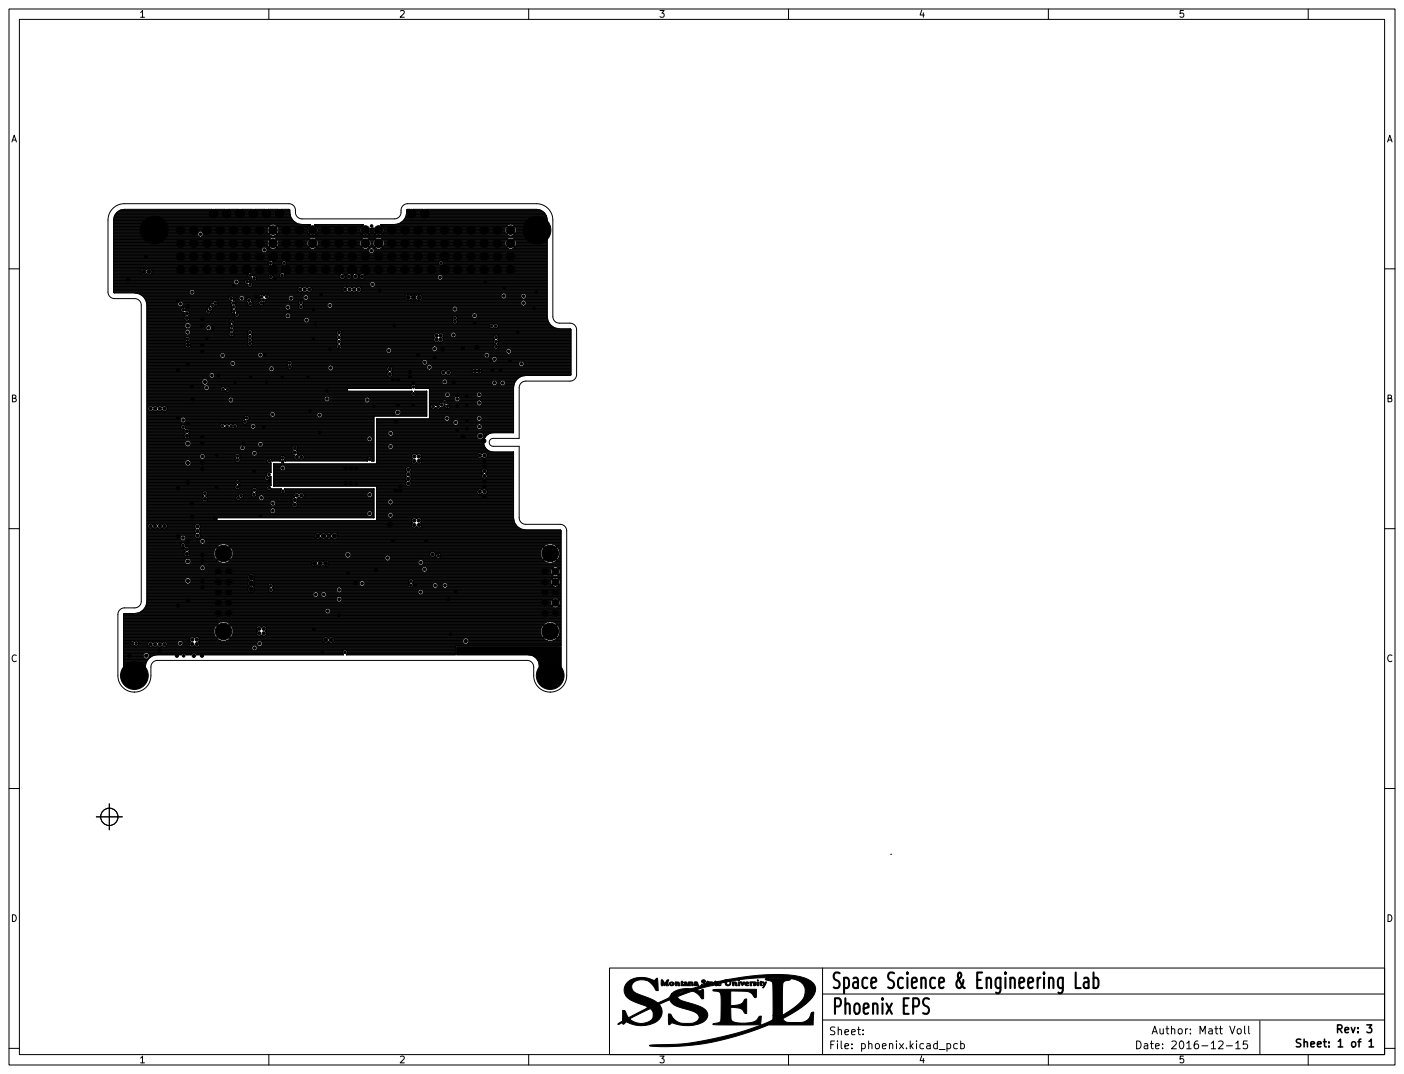
[picture p124: page 7]

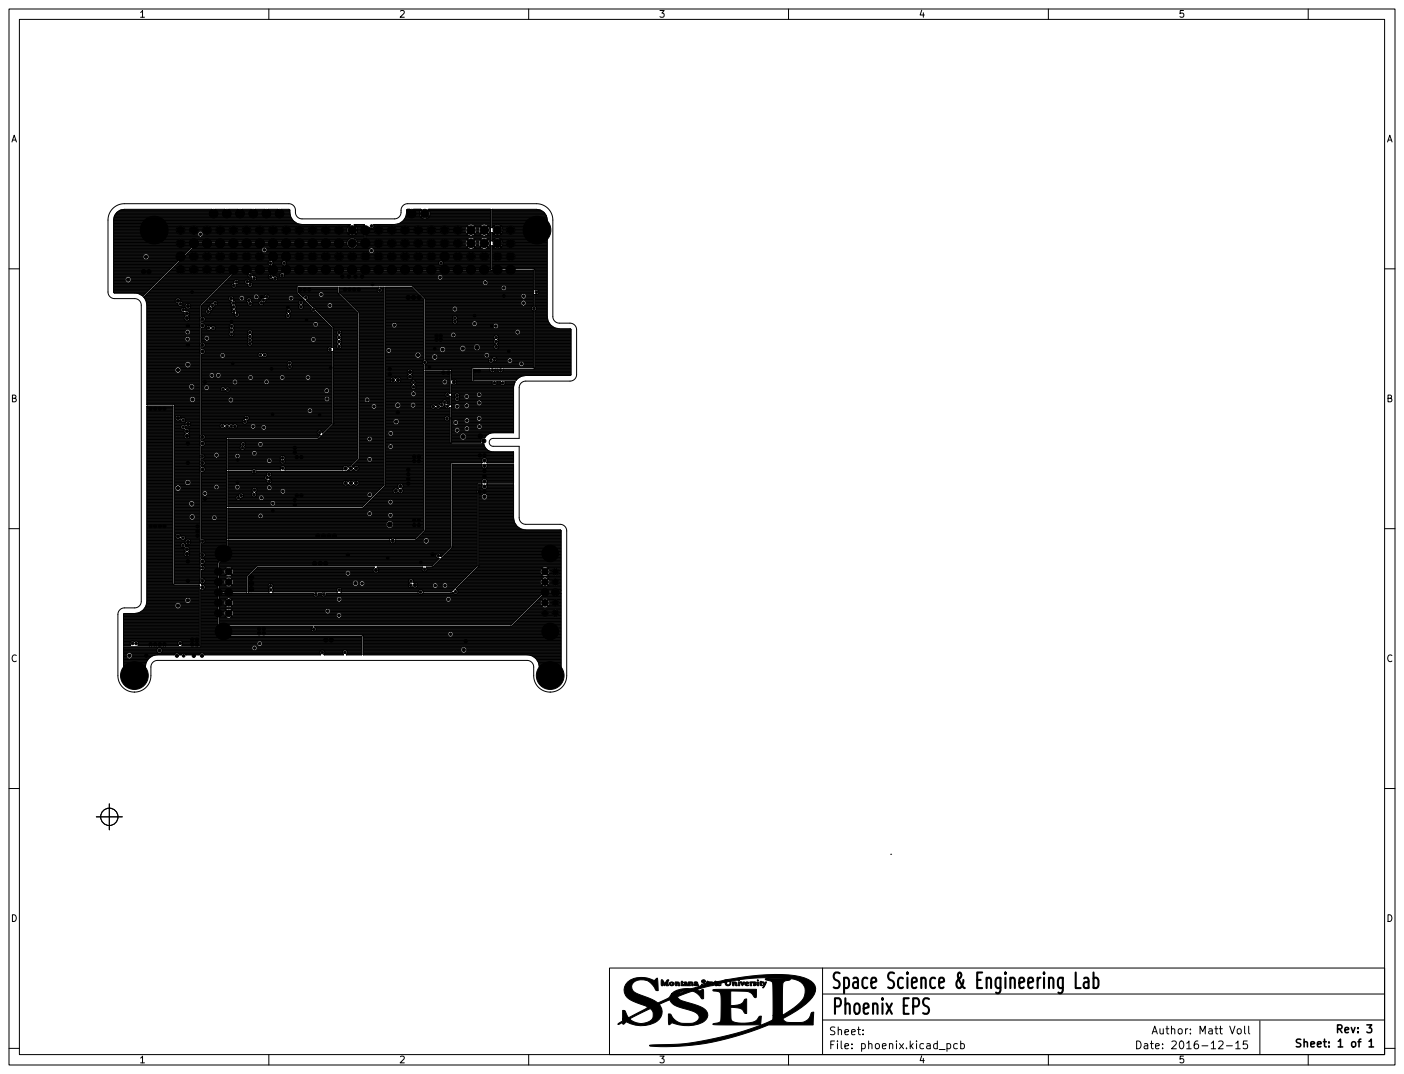
[picture p125: page 8]

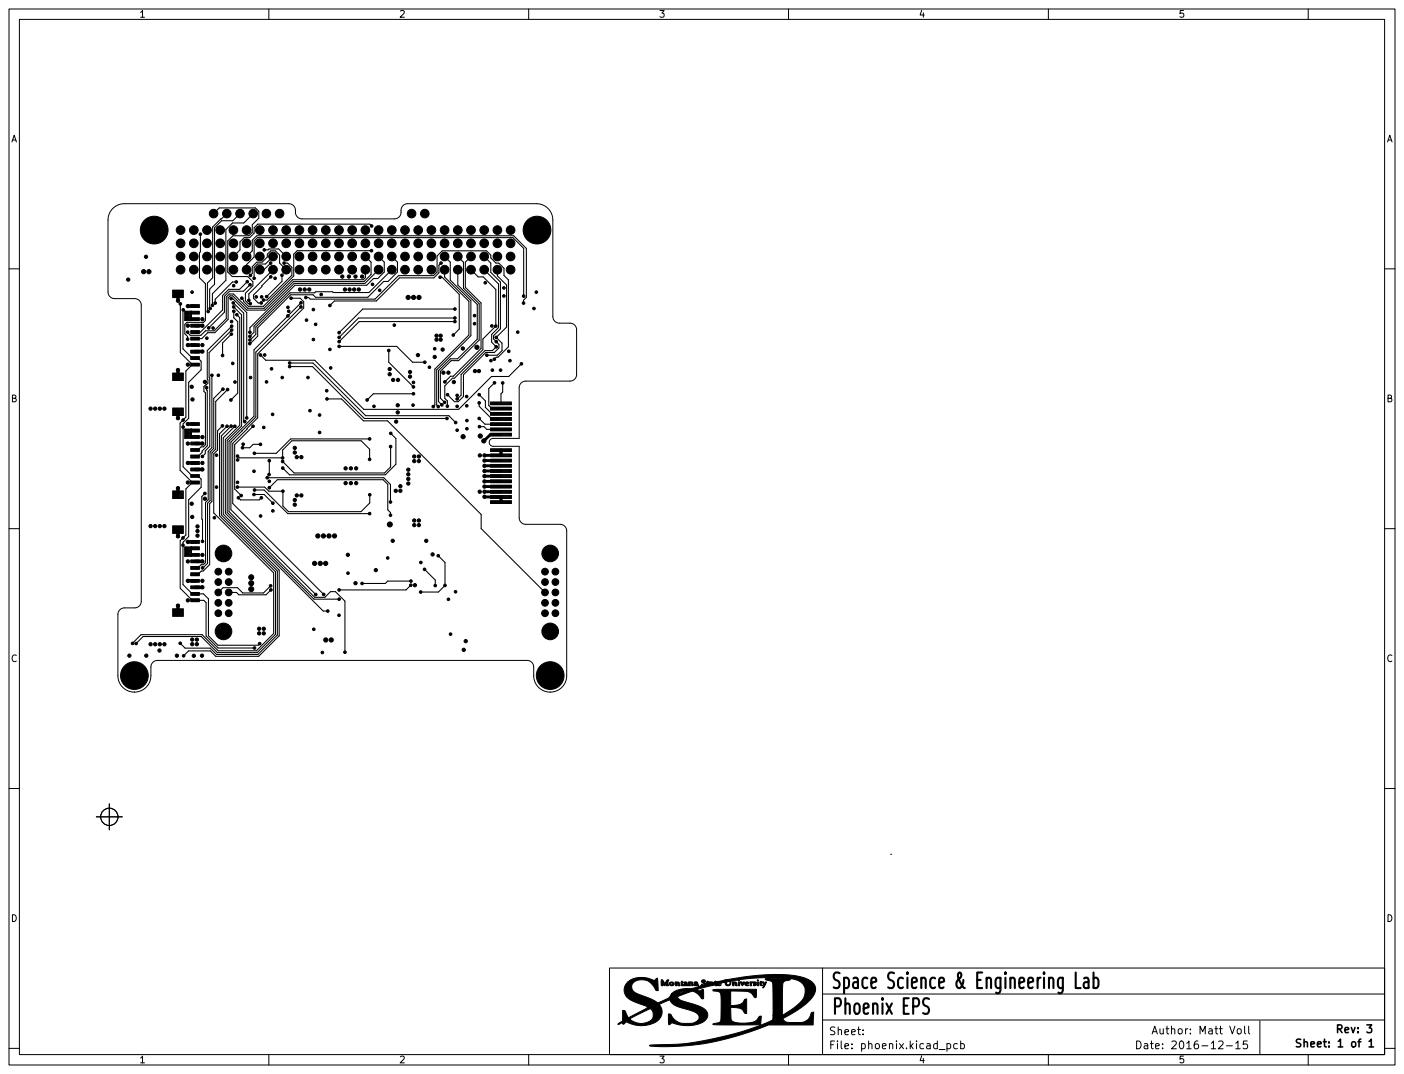
[picture p126: page 9]
