mattyv06/thesis/(list of files, drawings)

Other design files:
figs/fisce/layout/fb-e-4008-d-rev1.pcb
figs/phoenix/layout/phoenix_eps_rev3.pcb
