mattyv06/thesis/(commit log)

2017-03-30 Initial upload to github
    [drl_l2l6.drl, drl_l3l6.drl, drl_through.drl, egse_proto-BMask.gbs, egse_proto-Bottom.gbl, egse_proto-EdgeCuts.bor.gbr, egse_proto-FMask.gts, egse_proto-FSilkS.gto]
2017-08-05 getting remote back to current
    [fb-e-4007-d-rev1.sch, fb-e-4008-d-rev1.pcb, fisce_parts_order_03252014.xlsx, phoenix_assembly_part_list.xlsx, phoenix_eps_rev3.pcb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]
